smily77/CatFind/Situations_Dokumentationen/Katze hat gekotet/20261016_211953_00.jpg

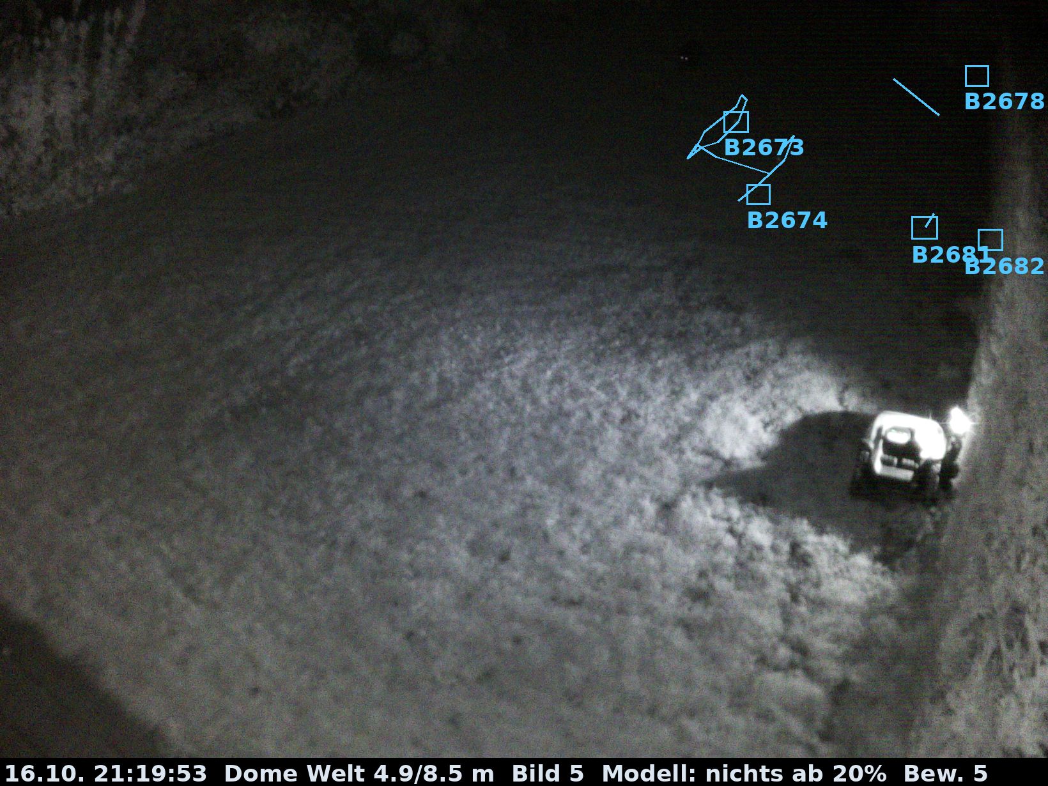
Situations_Dokumentationen/Katze hat gekotet/20261016_211953_00.jpg
