smily77/CatFind/GesamtKonzeptCatFinder.md

# GesamtKonzept CatFinder

CatFinder ist ein System aus mehreren einzelnen Geräten. Der primäre Zweck besteht darin, eine Katze auf dem Rasen zu detektieren und zu lokalisieren. Um zu verhindern, dass sie auf den Rasen kotet, kann ein Aktor einen Wasserstrahl in ihre Richtung senden.

Das System besteht aus mehreren Komponenten und wird stetig erweitert. Bisher handelt es sich dabei um Funktionseinheiten, die eine oder mehrere Funktionen übernehmen und lokal von einem ESP32 gesteuert werden. Die ESP32 werden per OTA mit Arduino programmiert.

## Arduino-Programmarchitektur

### Global

Globale Variablen, Typdefinitionen sowie Prozeduren, die von allen Programmen verwendet werden, befinden sich in `xComDef.h` und `xComProc.h`. Diese Dateien sind Teil des Controller/Managers und werden in allen Programmen eingebunden. Sie sind per Symlink in der Arduino-Library-Sektion verfügbar. So können sie im Manager bearbeitet werden und stehen gleichzeitig allen Programmen zur Verfügung.

### Support

Alle Programme definieren die Hardware und Konstanten in `hwDef.h`. Initialisierungsprozeduren, Hardwareprozeduren und Support-Prozeduren befinden sich in `hwProc.ino`. Spezialprozeduren, zum Beispiel für Erkennung oder Mapping, werden ebenfalls als separate `.ino`-Dateien eingebunden.

### Betriebsprogramme

Die Haupt- bzw. Betriebsprogramme können dadurch möglichst schlank gehalten werden. Dort werden im Wesentlichen Aktionen ausgelöst und es wird auf Ereignisse oder empfangene Nachrichten reagiert.

### Kommunikation

Alle Programme sind OTA-fähig und binden `Credentials.h` für die WiFi-Informationen ein. Die Kommunikation erfolgt über UDP, hauptsächlich per Broadcast oder Unicast sowie per Text-Multicast für Debug-Ausgaben.

In `xComDef`, in `stationDefinitions device`, sind alle Geräte definiert, die im System vorkommen können. Die IP-Adresse bzw. deren letztes Byte wird dort entweder vordefiniert oder vom Gerät eingetragen, sobald es das erste Mal sendet. Wie gesendet wird und welche Bedeutung die gesendeten Inhalte haben, wird ebenfalls in `xComDef` festgelegt. Das gilt auch für die Variablen, die alle Geräte verwenden.

## Gerätearten

Bisher gibt es folgende Gerätearten:

### Aktoren

Aktoren können einen Wasserstrahl ausrichten sowie ein- und ausschalten. Häufig verfügen sie über LED-Pixel als Indikatoren, Knöpfe usw. An ihrem Drehturm können meist Sensoren, zum Beispiel Lidar, US-Meter oder IR-Detektoren, sowie Ziellaser oder andere Indikatoren befestigt werden. Damit können Aktoren auch selbst als Sensoren arbeiten oder die Zielinformation überprüfen.

### Sensoren

Die meisten Sensoren sind Distanz- und Bewegungssensoren, zum Beispiel Lidar oder Radar. Sie können etwa eine Katze detektieren oder etwas messen und bei einer Detektion eine Broadcast-Meldung senden. Weitere Sensoren, zum Beispiel für Regen, sind ebenfalls denkbar.

### Displays

Weiter gibt es Displays, teilweise mit Bedienelementen oder On/Off-Schaltern, um zum Beispiel das System scharf zu schalten.

### Spezialgeräte

Es gibt auch einfache Geräte, zum Beispiel einen Laser-Marker oder einen Simulator. Eine spezielle Rolle nimmt der Controller/Manager ein. Eigentlich ist er nicht zwingend notwendig, da das ganze Gerätenetzwerk ohne zentrale Steuerung auskommt. Der Manager hilft bei der Programmentwicklung, insbesondere bei globalen Elementen, und könnte in Zukunft als Informationsressourcenspeicher genutzt werden. Im Moment läuft der normale Betrieb ohne ihn.

## Ausrichtung und Orientierung

Gegenwärtig werden im System kartesische und Polarkoordinaten gleichzeitig und redundant verwendet. Der Kreis im Polarsystem hat 4096 Ticks, weil auch die seriellen Servos mit 4096 arbeiten. Diese Koordinatensysteme sind immer auf die jeweilige Quelle bezogen. Damit der Aktor mit diesen Koordinaten arbeiten kann, muss der Sensor fix mit ihm verbunden sein; die Tower-Achse wird damit quasi als Ursprung verwendet.

## Aufgabe: Globales Koordinatensystem ermöglichen

Das System soll die Möglichkeit erhalten, mit einem globalen Koordinatensystem zu arbeiten und den Einsatz mehrerer Aktoren zu erlauben. Wenn Aktoren nicht mit einem globalen Koordinatensystem arbeiten, verwenden sie ein relatives lokales Koordinatensystem. Das heisst, die Koordinaten stimmen für Sensoren, die normalerweise fest mit dem jeweiligen Aktor verbunden sind und damit eine eigene Koordinatensystemgruppe bilden.

Die Skizze des Gesamtzusammenhangs sieht wie folgt aus: Sensoren und Aktoren verfügen über Prozeduren, die es ihnen erlauben, ihre Position bezüglich eines globalen Koordinatensystems festzustellen. Das ist Gegenstand einer späteren Aufgabe und wird in dieser Aufgabe nicht realisiert.

Der normale Startablauf für Aktoren und Sensoren ist dann folgender:

1. Globale Positionskoordinaten und Ausrichtung aus dem nichtflüchtigen Speicher auslesen.
2. Quickcheck, ob die Pose stimmt. Wenn nicht, wird die Pose neu bestimmt.

Für Sensoren und Aktoren gilt dann: Bei Detektionsereignissen und Messungen werden die relativen Koordinaten, polar und kartesisch, übermittelt. Falls eine gültige Positionsbestimmung vorliegt, werden zusätzlich die globalen Koordinaten übermittelt. Globale Koordinaten sind immer kartesisch.

Wenn ein Aktor ein Detektionsereignis empfängt, prüft er, ob globale Koordinaten übermittelt wurden und ob er selbst eine gültige Lokalisationsbestimmung hat. Wenn beides erfüllt ist, verwendet er die globalen Koordinaten und prozessiert sie entsprechend. Falls nicht, prüft er, ob die relativen Koordinaten aus derselben relativen Koordinatengruppe stammen, zu der auch er gehört. Wenn dies der Fall ist, verwendet er diese Koordinaten und prozessiert sie. Falls weder das eine noch das andere zutrifft, ignoriert er die Meldung.

Ein Spezialfall sind Displays und Anzeigen. Diese sind entweder auf eine relative Koordinatengruppe eingestellt und prozessieren diese, oder sie sind auf globale Koordinaten eingestellt. Wenn sie in diesem Fall eine Meldung erhalten, die nur relative Koordinaten enthält, und sie darauf reagieren müssten, prüfen sie, ob ein Mitglied der relativen Koordinatengruppe eine valide Positionsbestimmung hat. Falls ja, fragen sie diese an und rechnen die Koordinaten um.

Das ist die grobe Skizze des Gesamtzusammenhangs. In dieser Aufgabe ist es nicht Gegenstand, die spezifischen funktionalen Prozeduren zu erzeugen; das erfolgt später in eigenen Aufgaben. In dieser Aufgabe sollen die Datenstruktur und die Common-Prozeduren des Systems in Version 6_3 erweitert werden, um dies zu ermöglichen.

### Konkret

1. Jedes Gerät des Systems soll über Variablen für die globalen Koordinaten und seine Ausrichtung sowie über ein Flag `validWorldPose` verfügen. Nach dem Booten ist `validWorldPose = false`. Auch wenn vermutlich nur Sensoren und Aktoren diese Information verwenden, sollen alle Geräte sie haben, damit mit globalen Prozeduren gearbeitet werden kann.

2. Die Datenstruktur `stationDefinitions device` in `xComDef`, die im Wesentlichen das Geräteverzeichnis darstellt, soll um einen Eintrag für die relative Koordinatengruppe erweitert werden. Zurzeit gibt es eine Gruppe für den Aktor PA2, zu dem der Aktor, der CompactDome und LD06 gehören, und eine Gruppe für `Actor1_1` mit dem MiniDome. Alle übrigen Geräte gehören zurzeit keiner relativen Koordinatengruppe an.

3. Die Struktur bzw. Payload soll so erweitert werden, dass neben den relativen Koordinaten auch die World-Koordinaten übermittelt werden. Wenn der Sensor keine valide Pose hat, werden sie als 0,0 übermittelt.

4. Die Kommunikationsstruktur soll zur Abfrage erweitert werden, ob `validWorldPose` vorliegt, sowie zur Abfrage der lokalen Koordinaten, falls `validWorldPose` vorliegt.

5. Die globalen Prozeduren in `xComProc` sollen um die Umrechnung von lokalen Koordinaten in Weltkoordinaten und umgekehrt erweitert werden.

6. Die globalen Prozeduren in `xComProc` sollen um Prozeduren zum Speichern und Lesen der Ist-Pose im nichtflüchtigen Speicher erweitert werden.

### Umsetzung, konkretisiert — Stand 6_3

Diese Aufgabe wurde in den gemeinsamen Dateien `xComDef6_3.h` und `xComProc6_3.h` umgesetzt. Die folgenden Festlegungen gelten als Teil der Aufgabe bzw. Dokumentation:

- **Einheiten:** Weltkoordinaten sind immer kartesisch in **mm** (`int32`, konsistent mit `posPayload.x/y`). Die Ausrichtung (`heading`) wird in **PA-Einheiten 0..4096** angegeben, konsistent mit `angle`. `0` bedeutet: Die lokalen Achsen sind welt-ausgerichtet.
- **Zu 1) Pose-Variablen pro Gerät:** `struct worldPose { int32 worldX; int32 worldY; float heading; bool validWorldPose; }` mit globaler Instanz `worldPose myPose` in `xComDef6_3.h`. Damit besitzt jedes Programm die Variablen. `validWorldPose` ist nach dem Booten immer `false`.
- **Zu 2) Relative Koordinatengruppe:** `stationDefinitions` erhält das Feld `byte group`. Defines: `groupNone(0)`, `groupPA2(1)` = {PA2i, CompactDome, LD06}, `groupPA1_1(2)` = {PA1_1, MiniDome}. Alle übrigen Geräte = `groupNone`.
- **Zu 3) Payload-Erweiterung:** `posPayload` erhält `int32 worldX`, `int32 worldY` und ein explizites Flag `uint8 worldValid` (1 = Weltkoordinaten gültig; 0,0 wäre sonst nicht vom Ursprung unterscheidbar). Die Grösse steigt von 25 auf 34 Bytes. Dadurch müssen alle 6_3-Geräte gemeinsam neu geflasht werden.
- **Zu 4) Kommunikationsstruktur:** neue msgCodes `poseRequest(6)` (ohne Payload — „melde deine Welt-Pose“) und `poseReport(7)` mit `worldPosePayload { uint8 validWorldPose; int32 worldX; int32 worldY; float heading; }`. Damit lässt sich abfragen, ob ein Gerät eine `validWorldPose` hat. Der Anfrager kann mit `worldToLocal()` selbst in lokale Koordinaten umrechnen.
- **Zu 5) Transformation:** `localToWorld()` / `worldToLocal()` in `xComProc6_3.h` (2D-Translation + Rotation um `heading`).
- **Zu 6) Persistenz:** `savePose()` / `loadPose()` über NVS (Preferences-Namespace `"pose"`). `loadPose()` lädt nur Koordinaten und Ausrichtung; `validWorldPose` bleibt nach dem Booten `false` (Quickcheck bestätigt später).

Bewusst **nicht** Teil dieser Aufgabe, sondern eigene Folgeaufgaben: tatsächliche Positionsbestimmung bzw. Quickcheck, das Füllen von `worldX/worldY` durch weltfähige Sensoren, die Empfangs-/Feuerlogik der Aktoren und die Display-Sonderfall-Logik.

## Aufgabe: No-Shot-Karte über den Manager verteilen

Das System braucht eine **Schusszonen-Karte**, im Sprachgebrauch weiter **No-Shot-Karte** genannt. Die Karte beschreibt als geschlossene Weltfläche den **erlaubten Bereich**, also den Rasen. Dieser ist bewusst etwas **enger** gefasst als der reale Rasen, weil teilweise Bewuchs über den Rand ragt. Es gilt: **Innerhalb** der Karte ist Feuern erlaubt, **ausserhalb** ist No-Shot.

Die Karte wird zentral auf dem **Controller/Manager** gehalten und von dort an die Sensoren bzw. weltfähigen Geräte verteilt, damit diese die In/Out-Entscheidung autonom und feuerschnell treffen können. Bereits getroffene Architekturentscheidungen:

- **Format:** Polygon als **CSV in Welt-mm** (ganzzahlig, konsistent mit `worldX/worldY`), Kommentar-Header mit Versions-/CRC-Kennung; mehrere Teilflächen oder Löcher werden durch Leerzeilen getrennt. Begründung sowie Laufzeit-/Point-in-Polygon-Überlegungen siehe Projektnotiz `no-shot-map-format`.
- **Ablage:** auf Manager und Sensor jeweils im **LittleFS** (nicht SPIFFS). Auf den Manager kommt die Karte per OTA-Filesystem-Upload; der Sensor lädt sie vom Manager.
- **Abgrenzung:** Die VPS-Lokalisierungskarte (`Map/*.csv`) ist eine andere Karte und kein Teil dieser Aufgabe. Der VPS zieht sie direkt aus dem Repo.

### Konkret

1. **Manager:** No-Shot-CSV im LittleFS ablegen und pflegen (Upload per OTA-Filesystem-Image). Versions-/CRC-Kennung aus dem Header bereitstellen.

2. **xComDef erweitern:** neue msgCodes und Payload-Structs für die Kartenabfrage und -übertragung, zum Beispiel `mapRequest` mit Kartentyp, `mapInfo` mit Typ/Version/CRC/Gesamtlänge/Chunk-Anzahl sowie `mapChunk` mit Chunk-Index und Daten. Ein Kartentyp-Enum ist vorzusehen, zunächst `mapNoShot`, damit später weitere Kartentypen möglich sind.

3. **xComProc erweitern:** gemeinsame Prozeduren für die Senderseite, also Karte aus LittleFS lesen und gechunkt versenden, sowie für die Empfängerseite, also Karte anfordern, Chunks sammeln, CRC/Version prüfen und in das eigene LittleFS schreiben. So kann jedes weltfähige Gerät die Karte generisch vom Manager beziehen.

4. **Sensor-Seite (Abfrage):** Beim Booten oder bei abweichender Version fordert der Sensor die No-Shot-Karte vom Manager an und cached sie lokal im LittleFS. Die Version wird per Quickcheck gegen den Manager geprüft.

5. **Transport (entschieden):** über das bestehende **UDP-xCom-Protokoll**, gechunkt und stilkonsistent über die neuen msgCodes in Punkt 2/3. Es wird kein separater HTTP-Server verwendet.

6. **Nicht Teil dieser Aufgabe** (Folgeaufgaben): der eigentliche Point-in-Polygon-Test (In/Out) und die daraus folgende Feuer-/Melde-Konsequenz im Sensor/Aktor (siehe Projektnotiz `no-shot-map-format`).

## Aufgabe: Sensor mit absoluten Koordinaten hinzufügen

Ein Lidar-Sensor soll als neuer Sensor mit Weltkoordinaten zum Projekt CatFinder hinzugefügt werden. Sensor und Teile des Konzepts sind aus `C:\Users\stefan\Documents\Arduino\Lidar_C1_Prog` und `C:\Users\stefan\Documents\Arduino\Lidar_C1_Prog\Position_estimate` bekannt. Der Ablauf, also wer den Prozess startet und wo er läuft, ist jedoch unterschiedlich.

### Grobkonzept

Der Sensor soll seine eigene Position mithilfe geeigneter Programme ermitteln, die in Python auf einem VPS-Server laufen. Das Verfahren entspricht demjenigen bei `PositionEstimate`. Die IP des VPS wird durch Einbindung von `Credentials.h` in der Form `IPAddress ipVPS(xxx.xxx.xxx.xxx);` bereitgestellt.

Alles, was auf dem VPS-Server läuft, soll in Docker laufen, damit der Container im Repository gespeichert und auf andere Maschinen portiert werden kann. Die Datei `RasenKarte.csv` im Verzeichnis `Map` muss bzw. kann vom VPS aus dem CatFinder-Repository (`https://github.com/smily77/CatFind`) geladen werden. Das soll sicherstellen, dass bei Änderungen nichts am VPS gemacht werden muss.

Der Ablauf ist folgender:

1. Beim Booten des Sensors Positions- und Ausrichtungsdaten aus dem NVS lesen.
2. Mit dem VPS prüfen, ob die Daten plausibel sind.
3. Wenn nicht, mit dem VPS die wahrscheinlichste Position und Ausrichtung auf dem Rasen bestimmen.
4. `validWorldPose` setzen.
5. Wenn `validWorldPose` gesetzt ist, die No-Shot-Karte aus dem Speicher lesen und validieren.
6. Wenn keine aktuelle No-Shot-Karte vorhanden ist, eine neue Karte vom Manager lesen.
7. Wenn der Manager nicht verfügbar ist, die alte No-Shot-Karte verwenden.
8. Wenn die Position klar ist, mit der Überwachung beginnen.
9. Bei jedem Treffer mit der No-Shot-Karte prüfen, ob der Treffer im schiessbaren Bereich liegt. Wenn ja, `catObserved` broadcasten.

Weiteres:

- Die Status-Pixel, 2 Stück bei `Lidar_C1`, sollen Auskunft über den Initialisierungsstatus geben und leuchten, wenn eine Detektion im schiessbaren Bereich erfolgt ist, ähnlich wie bisher.
- OTA und alle anderen CatFinder-Konzepte gelten natürlich ebenfalls.
- Nach Abschluss der Initialisierung wird ein sehr knapper Text-Multicast über den Status gesendet.

### Festlegungen, Umsetzung

- **Gerät:** neuer Sketch `C1Lidar6_3_0` (Ordner `CF_LidarC1/`), RPLidar C1 (Serial1, 460800), 2× WS2812. Device-DB-Eintrag `LidarC1` (ID 17), Typ `Lidar`, **DHCP** (keine feste IP nötig; IP wird per HB gelernt), `group = groupNone` (weltfähig, keine relative Gruppe). Flash per **OTA**.
- **Sensor↔VPS:** **HTTP-POST** vom Sensor an den VPS (`ipVPS` aus `Credentials.h` als `IPAddress ipVPS(xxx,xxx,xxx,xxx);`), Body = 360-Bin-Scan (mm), Antwort = Pose-JSON (`x_mm,y_mm,heading_deg,mirror,confidence,inlier_ratio`). Ausgehend → kein NAT-Port. **Offener Endpoint, kein Token.**
- **VPS:** Docker-Container `VPS/localizer/` im Repo (HTTP-Dienst, portiert aus `lidar_localize.py`), lädt `Map/RasenKarte.csv` aus dem GitHub-Repo (raw) beim Start bzw. periodisch. Kartenänderungen erfordern keinen VPS-Eingriff.
- **Scan-Quelle für die Lokalisierung:** der nach 20 s gelernte 360-Bin-Hintergrund (ortsunabhängig; **keine Wand/Nische mehr nötig**). Wand- und Landmark-Modell der alten Firmware entfallen; der Perimeter-/Hintergrund-Detektor bleibt und arbeitet rundum.
- **Plausibilitätsprüfung:** Die NVS-Pose wird gegen die globale VPS-Pose verglichen. Wenn sie übereinstimmen (Toleranz) und die Konfidenz hoch ist, wird `validWorldPose=true` gesetzt und die NVS-Pose behalten. Andernfalls wird die VPS-Pose übernommen und im NVS gespeichert.
- **No-Shot/Point-in-Polygon:** generischer Loader + In/Out-Test (innerhalb = schiessbar) als gemeinsame Prozedur in `xComProc6_3.h`; Karte aus LittleFS, sonst per `requestMap` vom Manager (Bausteine bereits vorhanden), sonst alte Karte.
- **catObserved:** bei Treffer im schiessbaren Bereich Broadcast mit relativen Koordinaten (x/y, radius/angle) **und** Weltkoordinaten (`worldX/worldY`, `worldValid=1`).
- **Status:** Pixel zeigen Init-Phasen (WiFi/Kalibrierung/Lokalisierung/Karte) und leuchten bei Detektion im schiessbaren Bereich; nach Init ein knapper Text-Multicast (`sendUdpTextln`, Port 8300).

## Aufgabe: Treffervisualisierung

### Grobkonzept

Der VPS stellt einen Webserver bereit, auf dem die `catObserved`-Events angezeigt werden können. Die Informationen dafür sendet der Master an den VPS. Zu beachten ist: Lokal läuft das CatFinder-Netzwerk auch dann weiter, wenn der Master nicht zur Verfügung steht. Ausnahme ist das Laden der No-Shot-Karte.

Anzeige des VPS-Webservers:

1. Ein Fenster zeigt die letzten Systemereignisse scrollend an. Es geht dabei nicht um Funktionen wie `catObserved`, sondern um Statusinformationen, zum Beispiel aus der Initialisierung, die als Debug-Text gebroadcastet werden. Dieses kleine Fenster ist immer auf dem Bildschirm sichtbar.
2. Eine kleine Anzeige zeigt, welche Geräte in den letzten 1–3 Minuten einen HB gesendet haben. Diese Anzeige bleibt ebenfalls immer auf dem Bildschirm sichtbar.
3. Die folgenden Anzeigen können umgeschaltet werden:
   - **3a. Ereignisliste:** Eine scrollbare Liste mit allen `catObserved`-Events, zusammengefasst auf maximal einen Eintrag pro Minute. Der Eintrag enthält die Zeit und die Sensoren, die das Ereignis gemeldet haben. Die ID-Nummer des Sensors genügt.
   - **3b. Weltkarte:** Karte mit World-Koordinaten (`RasenKarte`), auf der alle `catObserved` eingetragen werden. Jeder Sensor erhält eine andere Farbe. Radarsensoren können bis zu 3 Ziele verfolgen; diese sollten ebenfalls eigene Farben erhalten. Die Karte hat einen Reset-Button. Alle `catObserved` werden kumuliert, bis der Reset-Button gedrückt wird.
   - **3c. Relative Karte Gruppe 1:** Karte wie 3b, aber in relativen Koordinaten der Koordinatengruppe 1.
   - **3d. Relative Karte Gruppe 2:** Karte wie 3b, aber in relativen Koordinaten der Koordinatengruppe 2.
   - **3e. Relative Karte Gruppe 3:** Karte wie 3b, aber in relativen Koordinaten der Koordinatengruppe 3. Diese Gruppe gibt es noch nicht, wird es aber noch geben.

Der Bildschirm zeigt die Debug-Meldungen und die HB-Liste immer an. Die Ereignisliste bzw. die Karten aus 3a–3e können durchgeschaltet werden.

### Festlegungen, Umsetzung

- **Master als Gateway:** Der Manager lauscht ohnehin auf Multicast (catObserved, HB) und Text-Multicast (Debug, Port 8300). Er puffert diese Daten und schickt sie **gebündelt per HTTP-POST** an den VPS (`ipVPS:80/ingest`, ca. alle 1,5 s; Burst-Schutz mit Begrenzung pro Push). Fällt der Master aus, läuft das lokale Netz weiter; nur die Visualisierung pausiert. Pro Event überträgt der Master `sender, sensor, worldX/Y/valid, x/y` **und** `group` (= `device[sender].group`). Damit kann der VPS Weltkarten (3b) und relative Karten (3c–3e) zeichnen. Den Zeitstempel setzt der VPS beim Empfang; der Master braucht keine NTP-Zeit.
- **VPS-Webserver:** zweiter Docker-Container `VPS/dashboard/` auf **Port 80** (extern erreichbar als `http://<VPS-IP>/`). Single-Page-UI mit Debug-Fenster und HB-Liste immer sichtbar; umschaltbar zwischen Liste 3a, Weltkarte 3b und Gruppenkarten 3c–3e; Reset-Button. Der State liegt im RAM. Events kumulieren bis zum Reset und gehen bei Container-Neustart verloren. Die Weltkarte nutzt `Map/RasenKarte.csv` aus dem GitHub-Repo.
- **Farben:** je `(sender, sensor)`-Kombination eine eigene Farbe. Radar bis zu 3 Ziele → 3 Farben.
- **Liste 3a:** `catObserved` werden pro Minute zu einem Eintrag zusammengefasst (Zeit + beteiligte Sensor-IDs).
- **Master-Flash:** über COM6 (USB).

## Aufgabe: Welt-Pose eines Sensors per Co-Observation kalibrieren (Radar)

### Grobkonzept

Sensoren mit 360°- oder beweglichem Lidar können ihre Welt-Pose selbst bestimmen (VPS-Lokalisierung), Radar-Sensoren nicht. Ein Radar oder allgemein ein nicht selbst lokalisierender Sensor soll seine Welt-Pose dadurch erhalten, dass er **gleichzeitig mit einem welt-posierten Lidar dieselbe laufende Person beobachtet**. Aus den beiden Beobachtungsbahnen wird die starre Transformation vom Radar-Frame in die Welt geschätzt: Translation + Heading + Drehsinn = eine `worldPose`. Das ist klassische Extrinsik-Kalibrierung über ein gemeinsames bewegtes Ziel (Trajektorien-Registrierung).

### Prinzip

Ein Lidar mit gültiger Welt-Pose liefert die Bahn in Weltkoordinaten `p_welt`, das Radar dieselbe Bahn im Eigenframe `p_radar`. Gesucht ist:

```text
p_welt = R(heading)·(mirror·p_radar) + (tx,ty)
```

Mit genügend korrespondierenden Punktepaaren ist dies per Least-Squares-Registrierung (Umeyama/Kabsch) + RANSAC lösbar.

### Ablauf, knopfgesteuert im Radar-Sketch

1. Voraussetzung: Ein Lidar mit gültiger Welt-Pose broadcastet `catObserved` mit `worldValid=1`; das Radar läuft.
2. Knopfdruck am Radar → Kalibriermodus für ca. 30–60 s; der Status-Pixel zeigt dies an.
3. Das Radar sammelt parallel:
   - eigene Detektionen (Relativ-`x/y`, in Reihenfolge),
   - die `catObserved` des Lidars vom Bus (Welt-`x/y`).
4. Eine Person läuft eine **kurvige** Bahn im gemeinsamen Sichtfeld.
5. Das Radar sendet beide Punktzüge an den VPS (neuer Endpunkt, z.B. `/calibrate`).
6. Der VPS führt Trajektorien-Registrierung (ICP-artig) + RANSAC + Umeyama durch und liefert `tx, ty, heading, mirror, confidence`.
7. Das Radar übernimmt die Pose mit Quality-Gate, wie beim Lidar: `savePose`, `validWorldPose=true`, kurzer Status-Multicast. Danach füllt das Radar bei eigenen Detektionen auch `worldX/worldY` (`worldValid=1`).

### Festlegungen / wichtige Punkte

- **Korrespondenz über die Bahnform, nicht über die Zeit:** Der Header-`timeStamp` ist `time_t` in **Sekunden** und damit bei Gehtempo zu grob für eine zeitliche Zuordnung. Daher wird Trajektorien-Matching verwendet, also das Ausrichten geordneter Punktzüge als Kurven. Eine mögliche spätere Verbesserung wäre ein Millisekunden-Feld. Das ist vermeidbar, wenn Trajektorien-Matching genügt; es braucht dann keinen Eingriff ins Wire-Format.
- **Eindeutigkeit kommt vom Laufweg:** Eine gerade Linie ist mehrdeutig, insbesondere bezüglich Translation entlang der Linie. Eine 2-D-strukturierte Bahn, zum Beispiel Kurve/L/Acht, ist nötig. Beinbreite und Messrauschen helfen dabei **nicht**; sie mitteln sich nur weg.
- **Wiederverwendung:** `posPayload` trägt bereits beides: Radar = Relativ-`x/y`, Lidar = Welt-`x/y` mit `worldValid`. Es braucht keine neue Datenstruktur. `worldPose`/`savePose`/`loadPose` (mirror-fähig), Quality-Gate, VPS-Muster, OTA, Status-Text und Knopf/`commandMsg` sind vorhanden.
- **Voraussetzungen/Grenzen:** überlappendes Sichtfeld, **eine** Person, gute Lidar-Pose (Garbage-in → Garbage-out) und genügend Punkte. Der VPS liefert eine Konfidenz; das Gate verhindert eine schlechte Pose.
- **Generalisierung:** nicht radar-spezifisch. Jeder nicht selbst lokalisierende Sensor kann über jeden welt-posierten Sensor kalibriert werden. Die Sammel-/Sende-/Übernahme-Logik gehört daher als gemeinsame Prozedur in `xComProc`, zum Beispiel `coObserveCalibrate(...)`. Der VPS-Endpunkt wird einmal umgesetzt und kann von Radar sowie von künftigen Aktoren mit Turm-Sensor usw. genutzt werden.
- **Offene Detailfragen vor Umsetzung:** VPS-Endpunkt-/Datenformat; Mindest-Bahnlänge/Konfidenzschwelle; Ziel-Assoziation, wenn das Radar bis zu 3 Targets liefert (RANSAC wählt die zur Lidar-Bahn passende Spur); ob die Lösung rein 2-D bleibt (`mirror` als ±1 wie beim Lidar).

### Umsetzung, konkretisiert — Stand 6_3

Umgesetzt in den gemeinsamen Dateien (`xComDef6_3.h`/`xComProc6_3.h`), im VPS-Localizer
(`VPS/localizer/`) und im Radar-Sketch (`Radar_HKL/Radar6_3_0`). Die Sammel-/Sende-/
Übernahme-Logik ist **generisch** (nicht radar-spezifisch) und steht jedem nicht selbst-
lokalisierenden Sensor zur Verfügung.

- **Auslösung — Knopf UND Auto UND Health-Check (entschieden):**
  - *Knopf/`commandMsg`:* neuer `cmdCalibrate(18)` (`info` = Fensterdauer in ms, 0 = Default
    45 s). Damit kann ein Button-/Display-Gerät das Fenster starten.
  - *Auto:* Hat das Gerät **keine** valide Pose und liegt anhaltend (≥ `AUTO_ARM_MS`)
    Co-Observation an — eigenes Target **und** welt-valide `catObserved` gleichzeitig —,
    startet das Fenster selbsttätig. Das Quality-Gate verhindert eine schlechte Pose.
  - *Health-Check/Re-Validierung:* Bei vorhandener Pose wird jede co-beobachtete Lidar-
    Welt-Detektion gegen die eigene (per `localToWorld` transformierte) Detektion geprüft
    (`coObserveCheck`). Anhaltendes Welt-Residuum > Gate ⇒ `validWorldPose=false` (danach
    greift der Auto-Trigger erneut).
- **Gegen alle Welt-Quellen — je Sender getrennt (entschieden):** Das Radar taggt die
  gesammelten Welt-Punkte mit der **Sender-ID** und sammelt pro Quelle einen eigenen
  Punktzug (`coCalState`, bis zu `CO_MAX_WORLD_SRC` Quellen, je `CO_MAX_WORLD_PTS`). Der VPS
  probiert **jede (Eigen-Spur × Welt-Quelle)-Kombination** durch und liefert die beste; so
  wird „gegen alle welt-validen Sensoren" erfüllt, ohne die „eine kohärente Bahn"-Bedingung
  je Kandidat zu verletzen. Die gewinnende Quelle steht als `source` in der Antwort.
- **Kein neues Wire-Format:** `posPayload` trägt Relativ- **und** Welt-Koordinaten samt
  `worldValid` bereits; die Trajektorien gehen per HTTP an den VPS, nicht über xCom.
- **VPS-Endpunkt `/calibrate` (einmal, von allen nutzbar):** Body
  `{radar_tracks:[[[x,y]…]…], world_tracks:[{id,pts:[[x,y]…]}…]}` (Eigen mm relativ,
  Welt mm). Registrierung = **ICP mit reihenfolge-erhaltender DTW-Korrespondenz** +
  Umeyama/Kabsch über `mirror=±1`; Antwort `tx_mm,ty_mm,heading_deg,mirror,confidence,
  inlier_ratio,source`. Die Reihenfolge-Korrespondenz (statt Nearest-Neighbour) löst die
  Drehsinn-Mehrdeutigkeit; eine **gerade Linie** bleibt mehrdeutig und wird per
  Linearitäts-Check nie `HOCH`.
- **Übernahme mit Quality-Gate:** `coCalibFinish` übernimmt die Pose nur bei `confidence==HOCH`
  **und** `inlier_ratio ≥ CALIB_MIN_INLIER`, dann `savePose` + `validWorldPose=true` + kurzer
  Status-Multicast. Danach füllt das Gerät bei eigenen Detektionen `worldX/worldY`
  (`worldValid=1`) via `fillWorld`/`localToWorld`.
- **Boot vertraut der NVS-Pose (Radar-Ausnahme zur „false nach Boot"-Regel):** Da das Radar
  sich nicht selbst lokalisieren kann, aber im Normalfall nicht bewegt wird, setzt es beim Boot
  bei vorhandener gespeicherter Pose direkt `validWorldPose=true` (statt jedes Mal neu zu
  kalibrieren). Der Health-Check ist sein „Quickcheck": ein mitbeobachtender welt-posierter
  Sensor verwirft eine inzwischen falsche Pose; danach greift der Auto-Trigger. Erkannt wird
  Drift im Bereich zwischen Gate (~0,6 m) und Assoziationsgrenze (~1,5 m) — größere Abweichungen
  gelten als „anderes Ziel" und brauchen eine manuelle Neukalibrierung per Knopf.
- **Gemeinsame Prozeduren in `xComProc6_3.h`:** `coCalState`, `coCalibBegin/FeedLocal/
  FeedWorld/Elapsed/Finish`, `vpsCalibrate` (unter `USE_VPS_CALIBRATE`), `fillWorld`,
  `coHealth`/`coObserveCheck`.
- **Radar-Sketch:** verarbeitet jetzt empfangene Nachrichten (vorher nur Senden) — `catObserved`
  vom Bus (Sammeln/Health-Check) und `commandMsg`. Build/Flash: **`esp32:esp32:pico32`** (M5Stack
  Pico), per OTA.
- **Knopf als eigenes Gerät:** Da das Radar selbst keinen Knopf hat, übernimmt ein kleines
  Touch-Remote die Bedienung per `commandMsg` (Unicast): `Displays/radarCalibrationButton/` auf
  CYD35 (basiert auf `Udisp6_3_0`), mit **zwei Touch-Buttons** — „KALIBRIEREN" (`cmdCalibrate`)
  und „POSE LÖSCHEN" (`cmdClearPose`, verwirft die gespeicherte Pose → erzwingt Neukalibrierung,
  nötig wenn das Radar bewegt wurde). Es zeigt die Status-Multicasts des Radars an. Siehe
  Dokumentation_6_3.md Kap. 5.11.

Bewusst **nicht** umgesetzt / als Grenzen dokumentiert: Die DTW-Registrierung erzwingt Matching
der Bahn-Endpunkte — stark versetzte Start-/Endzeitpunkte der beiden Sensoren verschlechtern den
Fit an den Rändern; eine gemeinsam und vollständig beobachtete, kurvige Bahn bleibt nötig. Die
Health-Check-Assoziation ist best-effort (Distanz-Gate gegen „anderes Ziel").

## Aufgabe: Einstellung und Steuerung der CatFinder Elemente

### Grobkonzept
Alle Sensoren, Aktoren und zum Teil weitere Elemente führen aut. Aufgaben aus, senden einen HB oder führen Funktionen aus. Viele davon haben LED Pixel oder Anzeigen um ein visuelles Feedback zu geben. Diese Anzeigen sollen eigestellt werden können, so wie ebenso gewisse automatische Aufgaben (z.B. automatische Kalibration eines Radarsensors) und Funktion sollen ausgelöst werden können wie z.B. die Kalibration eines Radarsensors. Die Einstellungen sollen entweder im nicht flüchtigen Speicher (NVS) abgelegt werden oder einen Default-Wert für den start haben. Die Variablen für die Einstellungen werden in der entsprechenden hwDef.h des Elements (Sensor, Aktor,...) festgelegt. 
Die Bedienung der Einstellungen und Auslösung von Aktionen soll über den Touchscreen eines Displays oder den Webserver des VPS erfolgen. 

### Details - Geräteanzeige

#### Standardanzeige
Im Standardfall haben Elemente 4 Anzeige Ereignisse, die sie mit den LED-Pixel anzeigen (kann variieren je nach Elementtyp):
Anzeige-Ereignisse (Tabelle bezieht sich nur auf die Anzeige)
1. Initialisierung, stand des Boot und Initialisierung Vorganges: Immer eingeschalten
2. HB: Ein/-Ausschaltbar - Zustand im NVS gespeichert
3. CatObserved Ereignis: Ein/-Ausschaltbar - Zustand im NVS gespeichert  
4. Kalibrierung, OTA, usw. :  Immer eingeschalten

Spezialfall Manger:
1. HB Empfangen: Ein/-Ausschaltbar - Zustand im NVS gespeichert
2. CatObserved Empfangen: Ein/-Ausschaltbar - Zustand im NVS gespeichert

#### automatische Aufgaben
1. Automatische Übernahme/Kopieren der WorldPose, wenn ein anders Gerät im selben relativen Koordinatensystem eine gültige WorldPose hat:  Ein/-Ausschaltbar - Zustand im NVS gespeichert

Spezialfall Radar:
1. Automatische Kalibrierung: Ein/-Ausschaltbar - Zustand im NVS gespeichert

SpezialFall Lidar
1. Motor des Lidars ein und ausschalten: ein/ausschaltbar - default (also immer beim Booten) eingeschaltet

#### Auslösbare Funktionalitäten
1. WorldPose von einem anderen Gerät mit gültiger WorldPose im selben relativen Koordinatensystem kopieren

Spezialfall Radar:
1. Kalibrierung durchführen: Kann ausgelöst werden

### Details Steuerung und Anzeige

#### Displays 
Die Funktionen sollen über den Touchscreen der Displays bedient werden können. Auf einer Seite soll das Gerät (Aktive geräte) ausgewählt werden können und dann sollen die anwählbare Dinge dargestellt und bedient werden können. Das ganze muss autoskaliert werden, da nicht alle Displays die selbe Auflösung haben. Kopiere den Display Prototypen vollständig in ein Verzeichnis Bedienung_Einstellungen in dieser Kopie kannst du die nicht benötigten Funktionen des Hauptprogrammes löschen und durch die hierfür notwendigen ersetzen. Wichtig basierend auf dem vollständigen Prototyp - keine abgespeckte version und dass man wie gewohnt vor dem kompilieren das Display über #define auswählen kann

#### VPS - Webpage 
Der Webserver des VPS soll eine zusätzliche Seite (auswählbar wie die unterschiedlichen Karten) erhalten, auf der man alle einstellbaren Funktionen und Aktionen der aktiven Geräte einstellen resp. auslösen kann

### Umsetzung, konkretisiert — Stand 6_3

Umgesetzt in den gemeinsamen Dateien (`xComDef6_3.h`/`xComProc6_3.h`), in den Geräten
Radar/Lidar/Manager, im neuen Touch-Bediendisplay `Displays/Bedienung_Einstellungen/`
und im VPS-Dashboard (`VPS/dashboard/`).

- **Generisches Einstellungs-/Aktions-Modell (entschieden):** Jedes Gerät führt eine
  Bitmaske `mySettings` (`deviceSettings` in `xComDef`): `supported` (welche Settings es
  hat), `values` (aktueller on/off-Zustand) und `actions` (auslösbare Aktionen). WELCHE Bits
  ein Gerät führt, legt seine `hwDef.h` über die Masken `STG_SUPPORTED`/`STG_DEFAULT`/
  `STG_PERSIST`/`STG_ACTIONS` fest — so bleiben die Variablen der Einstellungen wie gefordert
  in der `hwDef.h` des jeweiligen Elements. Setting-Indizes: `stgHbLed`, `stgCatLed`,
  `stgAutoCopyPose`, `stgAutoCalib`, `stgLidarMotor`; Aktionen: `actCopyPose`, `actCalibrate`, `actClearPose`.
- **Persistenz vs. Default:** `initSettings()` (in `xComProc`) lädt die persistierten Bits
  aus dem NVS-Namespace `"devcfg"` und überlagert damit `STG_DEFAULT`; nicht persistierte
  Bits (Lidar-Motor) starten immer auf ihrem Default (an). `saveSettings()` schreibt nur die
  `STG_PERSIST`-Bits.
- **Protokoll:** neue msgCodes `settingsRequest(11)` (ohne Payload — „melde deine
  Einstellungen") und `settingsReport(12)` mit `settingsPayload{supported,values,actions}`.
  Neue cmd-Codes `cmdSetSetting(20)` (`info=(idx<<1)|value`) und `cmdCopyPose(21)`. Die
  Kalibrier-Auslösung nutzt das vorhandene `cmdCalibrate(18)`. Gemeinsame Prozeduren in
  `xComProc`: `handleCommonMsg()` (beantwortet `settingsRequest`/`poseRequest`, führt
  `cmdSetSetting` aus + sendet `settingsReport`), `sendSettingsReport()`, `sendPoseReport()`,
  `copyPoseFromGroup()`.
- **Anzeige-Settings betreffen nur die LED/Anzeige, nicht die Funktion:** HB-/catObserved-
  Anzeige werden per `settingOn(...)` vor dem Setzen der Pixel geprüft (Radar/Lidar/Manager);
  Broadcasts/Detektion laufen unverändert weiter. Beim Manager sind es die EMPFANGS-Anzeigen.
- **Automatik/Aktionen:** Radar prüft `stgAutoCalib` vor dem Auto-Trigger und `stgAutoCopyPose`
  für periodische Gruppen-Pose-Übernahme; Aktion „Kalibrieren" = `cmdCalibrate`, „Pose
  kopieren" = `cmdCopyPose` → `copyPoseFromGroup()`. Lidar: `stgLidarMotor` schaltet den Scan
  (`lidar.stop()`/`startScan()`). „Pose kopieren" (`actCopyPose`) nutzt, dass Geräte derselben
  relativen Koordinatengruppe dieselbe Welt-Pose teilen (poseRequest/poseReport).
- **Display (Touch):** `Displays/Bedienung_Einstellungen/` ist eine **vollständige Kopie des
  Display-Prototyps** (`Udisp6_3_0`) — gleiche Display-Auswahl per `#define`
  (CYD28/CYD35/Sunton7/Sunton5/M5Core2/M5Tab5/Wave7), gleiche LovyanGFX-Profile
  (`dispDevLoGFX.h`) und Bildschirm-Definitionen (`dispDef.h`). Das Karten-/Menü-Betriebs-
  programm wurde entfernt und durch eine **autoskalierte Touch-Bedienung** ersetzt: Seite 1
  Geräteauswahl (Geräte, die `settingsReport` gemeldet haben), Seite 2 die Einstellungen als
  AN/AUS-Schalter und die Aktionen als Buttons. Bedienung per `gfx.getTouch()`, Ziel-IPs aus
  den HBs gelernt. Default-Build **CYD35** (per USB), OTA aktiv.
- **VPS-Webinterface + Rückkanal (entschieden):** Das Dashboard erhält einen Tab
  **„Steuerung"** (umschaltbar wie die Karten), der je aktivem Gerät die Settings-Schalter und
  Aktions-Buttons zeigt. Da der VPS die 192.168.0.x-Geräte **nicht direkt** erreicht, wirkt der
  **Manager als Gateway in beide Richtungen**: er reicht die `settingsReport` per `/ingest`
  an den VPS weiter und **pollt** `GET /commands` (CSV „target,cmd,info"), um vom Webinterface
  angeforderte Kommandos auf den lokalen Bus zu geben (`POST /command`). `target 255` =
  Broadcast `settingsRequest` (alle Geräte melden sich).

## Aufgabe: Katze oder Störung — Ereignis-Validierung

### Grobkonzept
Radar und Lidar-C1 laufen und liefern `catObserved` — aber auch Störungen:
einzelne Zufallsereignisse, Sonneneinstrahlung ins Lidar (haufenweise
Fehlmeldungen auf einmal), Insekten nahe am Sensor, Vegetation im Wind. Bevor
die Feuerlogik (PA) auf Beobachtungen schiesst, braucht es eine Validierung:
**Ist das eine Katze oder eine Störung?**

Randbedingungen:
- Lange warten und viele Treffer zählen geht nicht — eine Katze kann schnell
  sein und ist sonst über den Rasen, bevor das System reagiert.
- Beide Sensoren zwingend verlangen (UND) geht nicht — das Lidar sieht die
  Katze je nach Fellfarbe/Reflektivität nicht.
- Ground Truth ist unsicher — die Wildkamera zeichnet nicht jede Katze auf.

### Prinzip: Spuren bewerten statt Treffer zählen
Eine echte Katze liefert bei ~10 Hz Sensorrate schon in 0,3–0,5 s mehrere
Beobachtungen, die **physikalisch zusammenhängen**: plausible Geschwindigkeit,
plausible Beschleunigung, Netto-Verschiebung über den Rasen. Störungen können
einzelne Ereignisse vortäuschen, aber fast nie eine kohärente Bahn:

| Störung | Signatur | scheitert an |
|---|---|---|
| Einzel-Zufallsereignis | 1 Beobachtung, dann nichts | keine Fortsetzung im Gate |
| Sonne ins Lidar | Burst: viele Bins gleichzeitig, Positionen springen | keine kohärente Bahn |
| Insekten | nur nah am Sensor, 1–2 Bins, erratisch | Nahbereichs-Gate, Winkelausdehnung |
| Vegetation im Wind (Radar) | oszilliert am festen Ort | Netto-Verschiebung ≈ 0 |
| Regen | beide Sensoren rauschen überall gleichzeitig | Sturm-Modus |

### Drei Ebenen

**Ebene 1 — Selbstdiagnose im Sensor („Sturm-Modus"):** Der Sensor erkennt
selbst, wenn er gerade unglaubwürdig ist. Lidar: zu viele markierte Punkte pro
Umdrehung (Gegenstück zu `MIN_DETECT_POINTS`) oder zu weite Winkelstreuung →
ganze Umdrehung verwerfen; mehrere Sturm-Umdrehungen in Folge → Sensor meldet
sich ab (sendet nichts mehr, bis es einige Sekunden ruhig war; optional
Text-Multicast „Lidar degraded"). Radar analog über die Ereignisrate
(Dauerfeuer am selben Fleck = Clutter). Die Fehlmeldungs-**Haufen** der Sonne
sind so gerade das Erkennungsmerkmal.

**Ebene 2 — Track-Bestätigung beim Konsumenten (Feuerlogik im PA):**
Beobachtungen in Welt-Koordinaten werden per Nearest-Neighbor mit Gate
(max. Katzengeschwindigkeit × Δt) zu Tracks assoziiert. Ein Track ist
bestätigt, wenn: ≥ 4 Beobachtungen innerhalb ≤ 1 s, Netto-Verschiebung
≥ 0,4 m, Geschwindigkeit durchgehend 0,1–4 m/s, liefernder Sensor nicht im
Sturm-Modus. Bestätigung nach ~0,5 s; der PA verfolgt danach die aktuelle
Track-Position (nicht die erste Beobachtung) — 0,75 m Katzenweg bei 1,5 m/s
sind verkraftbar.

**Ebene 3 — Fusion als Beschleuniger, nicht als Pflicht:** Kein UND, sondern
gestuft: (a) beide Sensoren sehen dasselbe Objekt (< 0,5 m, < 0,5 s) →
**sofort bestätigt** (~0,2 s); (b) ein Sensor allein → Track-Bestätigung nach
Ebene 2 (~0,5 s); (c) beide Sensoren rauschen gleichzeitig überall → Umwelt
(Regen/Sturm) → systemweiter Feuer-Stopp.

### Ground Truth ohne verlässliche Wildkamera
1. **Langzeitaufnahmen mit dem Simulator** (2. Ausbau, Kap. 5.7 der Doku):
   Nächte ohne Katze = reine Störungs-Bibliothek, Sonnenstunden = Sonnen-
   Signatur. Damit die Schwellwerte (Gate, Burst-Limit, Verschiebung) offline
   tunen und per Replay gegen die Feuerlogik testen.
2. **Kontrollierte Positiv-Daten:** die Kalibrier-Läufe (Person läuft kurvige
   Bahn) sind aufgezeichnete echte Tier-Bahnen; Testläufe mit bekannter
   Katze/Hund liefern weitere.
3. Optional später: **ESP32-CAM als Eigen-Trigger** — schiesst bei bestätigtem
   Track ein Foto der Track-Position; das System verifiziert seine eigenen
   Entscheidungen, statt auf den Zufalls-Trigger der Wildkamera zu hoffen.

### Festlegungen / Reihenfolge der Umsetzung
1. **Sturm-Modus im Lidar** (kleinster Eingriff, grösster Effekt gegen die
   Sonne — Erweiterung der Umdrehungs-Auswertung im C1-Sketch).
2. **Langzeit-Datensammlung** mit dem Simulator (Szenen 1–9, läuft nachts mit).
3. **Track-Bestätigung** als generischer Baustein in `xComProc` (nutzen beide
   PAs); Schwellwerte aus den gesammelten Daten.
4. Optional: Fusion-Schnellpfad (Ebene 3a) + ESP32-CAM.

(Stand 2026-07-02: Strategie festgelegt. Die Umsetzung beginnt — anders als
oben zunächst geplant — mit der **VPS-Modellierung der Katzenerkennung**
(nächste Aufgabe unten): erst das Erkennungsmodell auf dem VPS an echten
Langzeitdaten entwickeln, dann die abgeleiteten Regeln lokal umsetzen.
Sturm-Modus im C1 und Track-Bestätigung in `xComProc` bleiben gültige
Bausteine und folgen danach.)

## Aufgabe: VPS-Modellierung der Katzenerkennung (CatDetected)

### Grobkonzept

Ziel ist die **qualifizierte Aussage `CatDetected`**: das System hat aus den
rohen `catObserved`-Beobachtungen geschlossen, dass es sich tatsächlich um eine
Katze handelt. Die Aktoren sollen künftig auf `CatDetected` reagieren statt auf
rohe `catObserved` (sie prüfen weiterhin selbst No-Shot, Limits, Sicherheit).
Die Live-Entscheidung muss am Ende **lokal im CatFind-Netz** laufen — geplant
auf einem **spezialisierten ESP32** (ein Raspberry Pi nur, wenn es wirklich,
wirklich nicht anders geht — also fast sicher nicht). Der VPS ist **nicht** Teil
der Live-Kette; er ist das **Modellierungs- und Analysewerkzeug**, mit dem das
Erkennungsmodell an echten Daten entwickelt wird, bevor es auf den ESP32 kommt.
(Das Dokument `CatDetectionModelingStrategy.md` war hierfür die Inspiration;
verbindlich sind die Festlegungen in dieser Aufgabe.)

**Erkenntnisse aus den Outdoor-Tests (2026-07, Kalibrierung erfolgreich):**

- Das **Radar** ist der **primäre Katzendetektor**: eine Katze wird mit recht
  hoher Wahrscheinlichkeit erkannt; Störungen kommen vor, sind aber beherrschbar.
- Der **LidarC1** produziert je nach Wetter/Tageszeit extrem viele
  Fehlereignisse und sieht die Katze meist gar nicht — **super zum
  Lokalisieren, wenig nützlich zum Detektieren**. Er darf die Erkennung
  unterstützen, seine Bestätigung darf aber nie Pflicht sein.
- Die **Detektionsgrenzen** helfen bei der Wahrscheinlichkeits-Bewertung:
  beim Radar ist der **Öffnungswinkel eher hart** (Achtung: Bewuchs kann Teile
  verdecken), die **Maximalreichweite dagegen weich** (objektgrössenabhängig).

**Arbeitsweise:** Der VPS zeichnet die `catObserved` über sehr lange Zeit
persistent auf. Auf einer neuen, zoombaren Analyse-Karte geht man in der Zeit
vorwärts/rückwärts, streckt und staucht das Zeitfenster, blendet einzelne
Sensoren ein/aus, beurteilt die Signale und markiert (labelt) sie. Der VPS
markiert die `CatDetected`-Ereignisse nach seinem Modell; wo das Modell
danebenliegt, werden Parameter angepasst oder das Modell ergänzt — so lange,
bis die Trefferwahrscheinlichkeit im Gesamten gut ist. Erst dann wird das
Modell auf dem ESP32 implementiert.

### Konkret / Festlegungen

1. **Erweiterung, kein Umbau:** Alles, was auf dem VPS läuft (Live-Dashboard,
   Karten, Steuerung, Localizer), läuft unverändert weiter. Die Analyse kommt
   als **zusätzlicher Tab** ins bestehende Dashboard (`VPS/dashboard/`).
2. **Persistenz:** Alle eingehenden `catObserved` werden — bei eingeschalteter
   Aufnahme — in eine **SQLite-Datenbank in einem Docker-Volume**
   (`/opt/catfinder/data/`) geschrieben. Die Daten überleben damit
   Container-Neubauten (Modelländerungen!) und liegen **nicht** in GitHub.
   Die Aufnahme hat **Pause/Append**: ein REC-Schalter im UI pausiert die
   Aufzeichnung bzw. setzt sie fort (an dieselbe Datenbank anhängend); der
   Zustand ist persistent. Labels und Modell-Parameter liegen im selben Volume.
3. **Millisekunden-Zeitstempel (Manager-Erweiterung):** Der Manager bündelt
   Events ~1,5 s — ohne Gegenmassnahme bekämen alle Events eines Pushes
   dieselbe Zeit, und Geschwindigkeits-/Bahn-Features wären unmöglich. Der
   Manager schickt deshalb pro Event zusätzlich seine **Empfangszeit
   (`millis()`)**, den **targetSpeed** des Radars sowie pro Push `now_ms` und
   einen **Drop-Zähler** (wie viele Events der Burst-Schutz verworfen hat —
   bei Lidar-Sonnen-Bursts ist gerade die Menge das Erkennungsmerkmal). Der
   VPS rechnet daraus ms-genaue Serverzeiten. Abwärtskompatibel: Events ohne
   `ms` bekommen die Push-Zeit.
4. **Analyse-Tab:** Die Zeitleiste zeigt **genau das gewählte Zeitfenster**
   (Ereignisdichte je Sender, Zeit-Gitter, Aufnahme-Band, Labels, rote
   CatDetected-Punkte): Ziehen = verschieben, Mausrad = strecken/stauchen,
   „Alles" passt die ganze Aufnahme ein. (Der frühere Übersichts-Balken über
   die gesamte Aufnahme mit blauem Fenster-Rahmen wurde nach mehreren Tagen
   Aufnahme unübersichtlich und ist ersetzt.) Darunter eine **Welt-Karte mit
   Pan/Zoom** (RasenKarte als Hintergrund), auf der die Events des Fensters
   erscheinen (Farbe je Sensor/Ziel). Einzelne Sensoren sind
   ein-/ausblendbar; die Erfassungssektoren sind einblendbar („Erfassung");
   „Geräte ⟳" liest die xComDef sofort neu und fragt frische Posen an. **Labeln:** ein
   Zeitbereich (optional auf einen Sensor beschränkt) bekommt ein Label
   (Katze, Einzelereignis, Insekt, Vegetation, Sonne/Lidar, Regen/Sturm,
   Vogel, unbekannt); Labels sind persistent und in der Zeitleiste sichtbar.
5. **Modell auf dem VPS (v2 — Score statt starrer Regeln):** bildet aus den
   Events **Tracks** (Nearest-Neighbor mit Geschwindigkeits-Gate, in
   Welt-Koordinaten; **Track-Stitching** überbrückt kurze Aussetzer, z.B.
   wenn eine sitzende Katze aus dem Radar fällt) und bewertet jeden Track
   mit einem **Score 0–100** („Katzen-Wahrscheinlichkeit", mit
   Aufschlüsselung im UI):
   - **Pflicht** ist eine **kohärente Bewegungsphase** irgendwo im Track
     (sonst wäre oszillierende Vegetation eine „sitzende Katze"); dabei
     zählen **Sensor-Gewichte je Gerätetyp** — die Typen (HLK, Lidar, …)
     liest der VPS **dynamisch aus `xComDef6_3.h`** (GitHub raw, wie die
     RasenKarte): neue Sensoren brauchen keinen VPS-Eingriff, und die
     Gerätedatenbank bleibt die Quelle der Wahrheit. HLK-Radar wiegt hoch,
     Lidar niedrig — Lidar allein bestätigt nie.
   - **Erfassungsgrenzen aus der Gerätedatenbank (geometrisch):** jedes
     Sensor-Gerät trägt in `xComDef6_3.h` seinen **nominellen
     Erfassungsbereich** (`covLeftDeg`/`covRightDeg`/`covRangeMm`; HLK-Radar
     −60°…+60°, 7 m; 360°-Lidar −180°…+180°, 12 m). Der VPS legt diese
     Sektoren über die **Welt-Posen der Sensoren** (die Geräte melden
     `poseReport`, der Manager reicht sie per Gateway-Push an den VPS
     weiter) in die Karte — nach dem **Versetzen eines Sensors stimmt der
     Bereich sofort wieder**, nichts muss empirisch neu „eingelaufen"
     werden. Der Bereich ist bewusst nominell (Winkel eher hart, Reichweite
     weich/objektgrössenabhängig) und pro Gerät in der xComDef anpassbar,
     z.B. wenn ein Radarsektor über die Rasenkarte hinausragt. Eine Katze
     läuft in den Erfassungsbereich **hinein und hinaus**: Track-Geburt/-Tod
     nahe dem Rand der **Gesamt-Abdeckung** (Vereinigung aller Sektoren —
     Übergaben zwischen überlappenden Sensoren zählen so nicht als
     Austritt) gibt **Bonus**; Auftauchen/Verschwinden mitten im Feld nur
     einen **weichen Malus** („kann sein, muss nicht"). Das trennt
     insbesondere **Vogel** (erscheint/verschwindet mitten im Feld) von
     **Katze**. Fallback, solange keine Posen bekannt sind: empirische
     Abdeckung aus den Langzeitdaten (Belegungsraster).
   - **Eine Katze darf stehenbleiben (koten!):** „sitzt am Ende stabil"
     gibt Bonus + Flag **STATIONAER**; ein am Fensterende noch offener
     Track bekommt keinen Austritts-Malus (Flag OFFEN).
   - **Sturm-Erkennung** je Sensor über Rate **und räumliche Streuung**
     (hohe Rate allein ist auch eine normal getrackte Katze; ein Burst ist
     gleichzeitig überall). **Fusion** (mehrere Sender sehen dasselbe)
     gibt Bonus; weitere Boni/Maluse: Feld-Durchquerung, langer Track,
     sehr kurzer Track, unphysikalische Sprünge.
   Tracks ab `confirm_score` (mit Bewegungsphase) werden auf Karte und
   Zeitleiste als **`CatDetected`** markiert, mit Score und Begründung.
   Alle Schwellwerte stehen in einer **Parameter-JSON im Volume** und sind
   ohne Container-Neubau im UI änderbar; Modell-**Code**-Änderungen sind ein
   Container-Rebuild — die Daten bleiben davon unberührt.
6. **Mehr-Sensor-fähig:** alles arbeitet je `(sender, sensor)` — es kommen
   sicher 1–2 weitere Radarsensoren dazu, evtl. mehr. Das Modell trackt in
   Welt-Koordinaten (`worldValid=1`); Events ohne Welt-Koordinaten werden auf
   der Analyse-Karte nicht dargestellt (die Sensoren sind inzwischen
   welt-posiert).
7. **Manuelle Track-Bewertung + Übereinstimmung:** Im Tracks-Panel lässt sich
   jeder Track von Hand kategorisieren: **„Katze", „Person", „Vogel",
   „Mäher"** oder **„Störung"** (persistent, stabiler Track-Schlüssel =
   Geburtszeit+Geburtsort; nochmal klicken = entfernen). Die Modellbewertung
   bleibt unberührt; **keine Markierung = einverstanden**; für die
   **Übereinstimmung Modell↔Mensch** oben zählt alles außer „Katze" als
   „keine Katze" (x/y, „Modell-Katze abgelehnt" bzw. „Katze übersehen") —
   die Messlatte fürs Iterieren; die Kategorien sind zugleich gelabelte
   Ground-Truth. Die Modell-Flags (sitzt/offen/Eintritt/Austritt/2+
   Sensoren) stehen als **Chips direkt in jeder Track-Zeile**.
   **RoboMäher:** Zeitbereiche mit dem Label **„Mäher"** werden von der
   Analyse ausgeschlossen (Events bleiben aufgezeichnet und sichtbar — die
   Mäher-Läufe leuchten die Erfassungsbereiche schön aus, sollen aber keine
   CatDetected erzeugen). Zusätzlich verwirft das Modell Tracks mit
   **Weglänge > `max_path_mm`** (Default 40 m) automatisch als
   „Mäher/Person?" — ein Mäher/eine Person läuft in einem Track hunderte
   Meter zusammenhängend, eine Katze nicht; damit sind auch unmarkierte
   Mäher-Läufe entschärft.
8. **CatDetected-Auslösezeitpunkt:** Vom Modell bestätigte Tracks tragen auf
   Karte und Zeitleiste einen **roten Punkt** an dem Ort/Zeitpunkt, an dem
   das (künftig auf dem ESP32 laufende) Modell `catDetected` auslösen würde —
   also **bevor** die Katze den Erfassungsbereich verlässt. Die
   Wire-Datenstruktur ist in `xComDef6_3.h` definiert (`catDetected` = msgCode
   13, `catDetectedPayload`: Welt-Position, Score, Flags, Track-Dauer,
   Netto-Verschiebung).
9. **Inzwischen umgesetzt (2026-07-04):** am Radar das **RasenKarten-Gating**
   (neuer Kartentyp `mapRasen` = Rasen-Umriss in Welt-mm aus `Map/RasenKarte.csv`;
   der Manager verteilt ihn wie die No-Shot-Karte gechunkt per UDP, generisches
   `acquireMap` in xComProc; das Radar meldet mit gültiger Welt-Pose nur noch
   Ziele innerhalb des Rasens, fail-open ohne Karte/Pose — die No-Shot-Karte
   lädt es bewusst NICHT, es schießt nicht) und die **Kopplung des
   Pose-Drift-Health-Checks an das Auto-Kalibrierungs-Setting** (Pose wird nur
   noch automatisch verworfen, wenn `stgAutoCalib` an ist und das Radar sich
   selbst neu kalibrieren kann); der **radarCalibrationButton** hat eine
   **Zielauswahl** über alle HLK-Radare der Gerätetabelle.
10. **Nicht Teil dieser Aufgabe** (Folgeaufgaben, notiert): der
   ESP32-DetectionActor, der `catDetected` tatsächlich sendet (erst wenn das
   Modell steht); Sensor-/Aktorprofile in `xComDef6_3.h` (2. Priorität —
   Aktor-Reichweiten); am Radar: Mute je Sensor (VPS + Display, wegen
   mehrerer Radars).

## Aufgabe: KI-Vision-Katzenlokalisierung auf Raspberry Pi (KIVisionCatLocator)

### Grobkonzept
Ein kamerabasiertes Gerät auf einem **Raspberry Pi 4** überwacht den Rasen
dauerhaft, erkennt eindringende Katzen per KI (**Coral Edge TPU**, lokal, ohne
Cloud), bestimmt ihre **Position im Rasen-Weltkoordinatensystem** und meldet sie
dem bestehenden CatFinder-ESP32-Netzwerk. Das Gerät (`KIVisionCatLocator`) ist
**vollwertiges Mitglied des Busses** und verhält sich wie die anderen Sensoren,
obwohl es auf einem Pi statt einem ESP32 läuft. Es wird vollständig von Claude
Code per SSH programmiert und ist wie die übrigen Geräte im Heim-WLAN
(192.168.0.x) angebunden.

Motivation: Eine gute KI-Kamera ist voraussichtlich der **stärkste
Katzendetektor** im System (Erfahrung bisher: Radar gut, Lidar schwach) und
liefert zusätzlich welt-lokalisierte Treffer als Ground-Truth, mit denen sich
das kausale CatIdent-Modell verbessern lässt.

### Hardware
- **Raspberry Pi 4, 1 GB** — Kamera, Bildverarbeitung, KI-Ansteuerung, Webserver, Bus-Kommunikation.
- **OV5647-Kamera (5 MP)** am CSI-Anschluss, einstellbarer Fokus/Objektiv.
- **Schaltbarer IR-CUT-Filter** — Farbbild am Tag, IR-empfindlich in der Nacht.
- **850-nm-IR-Scheinwerfer** — nächtliche Ausleuchtung für kurze Belichtung/scharfe Bilder.
- **Coral USB Accelerator** — Edge-TPU-Inferenz über USB 3.0.
- **WLAN** — Heimnetz, Weboberfläche, Bus-Teilnahme.

### Prinzip / Bild-Pipeline
Ein einziges Programm öffnet die Kamera und stellt jedes Bild gleichzeitig der
KI, dem Webserver und der Ereignisspeicherung zur Verfügung.
- Kamera läuft dauerhaft (z.B. 1280×960, 10–15 fps).
- Der relevante Rasenbereich wird in **mehrere überlappende Ausschnitte** geteilt;
  jeder wird auf die Modell-Eingabegröße (z.B. 320×320) skaliert und vom Coral
  geprüft. Treffer-Koordinaten werden auf das volle Kamerabild zurückgerechnet.
  Grund: eine entfernte Katze bleibt im Ausschnitt größer/erkennbarer, als wenn
  das ganze breite Bild auf 320×320 verkleinert wird. (Optional später:
  Bewegungs-Gating — Inferenz nur auf Ausschnitten mit Bewegung, spart CPU/Wärme.)
- **Treffer-Bestätigung** (gegen Fehlalarme durch Schatten/Pflanzen/Insekten/
  Rauschen): eine Katze gilt z.B. erst als bestätigt, wenn ≥3 passende
  Erkennungen innerhalb ~1 s auftreten, die Sicherheit über einem Mindestwert
  liegt und die Treffer räumlich zusammenpassen.

### Weltlokalisierung (Boden-Homographie)
Eine einzelne Kamera misst nur eine **Richtung**, keine Distanz. Die Weltposition
entsteht über eine **planare Boden-Homographie** `H` (3×3), die Bildpixel auf
Rasen-Weltkoordinaten (mm) abbildet:
- Für eine erkannte Katze wird der **Fußpunkt** der Bounding-Box (Kontakt
  Katze↔Boden, i.d.R. Unterkante-Mitte) über `H` in `worldX/worldY` gerechnet.
- Voraussetzungen: Rasen ~eben (planar), Kamera fix montiert, **Linsen­verzeichnung
  vorher korrigiert** (Weitwinkel-OV5647 verzeichnet spürbar), Füße sichtbar.
- **Grenze:** Genauigkeit nah gut, fern schlecht (Perspektive staucht Distanz).
  Bei langem, längs betrachtetem Rasen hat das ferne Ende wenig Auflösung →
  Kamera möglichst hoch und steil nach unten montieren. Fernbereich-Lokalisierung
  ggf. bewusst grob.
- Die Homographie **ist** die „Pose" der Kamera (entspricht `poseReport`/Welt-Pose
  der anderen Geräte). Kalibrierung **assistiert** über die Weboberfläche: der
  Nutzer klickt bekannte Rasenpunkte (z.B. die Ecken der `RasenKarte`) im
  Kamerabild an, daraus wird `H` berechnet. Das nutzt vorhandene RasenKarten-Daten
  wieder; eine vollautomatische Ableitung ist nicht Teil dieser Aufgabe.

### Integration ins ESP32-Netz
- **Vollwertiges Busgerät:** Python-Portierung des xCom-Protokolls (`struct`-
  gepackte Payloads, little-endian, Header-Version `0x63`, Multicast
  239.0.0.57:8266, Unicast :23456, Text-Multicast :8300). Der Pi sendet **HB**,
  **`poseReport`**, **`settingsReport`** und antwortet auf `settingsRequest`,
  `cmdSetSetting`, `cmdReboot`; er erscheint damit automatisch im VPS-Steuertab
  (inkl. Aktiv/Ruhemodus `stgActive`, Reset).
- **Neues Gerät:** ID **20**, neuer Typ (z.B. `VisionLocator`), feste IP (z.B.
  `.186`), Eintrag in `device[]`, `deviceCount` 20 → **21**. Die Gerätetabelle
  parst der VPS bereits aus `xComDef6_3.h` (`parse_xcomdef`).
- **Festlegung (Variante A): der Pi sendet `catObserved` mit `worldValid=1`,
  NICHT `catDetected`.** CatIdent bleibt der einzige Bestätiger (`catDetected`),
  damit nicht mehrere Quellen Aktoren auslösen; der Pi ist ein hochwertiger,
  welt-lokalisierender Sensor, dessen Beobachtungen das kausale Modell fusioniert.
- **Bilder** werden per HTTP an den VPS geladen (wie die CatCam) und erscheinen im
  Bilder-Tab. **Rollen-Abgrenzung zur CatCam:** CatCam = Nahaufnahme/Identifikation,
  Pi = Weitwinkel-Erkennung + Lokalisierung.

### Software-Stack (Festlegungen)
- **OS: Raspberry Pi OS Bookworm 64-bit Lite (Debian 12, Python 3.11), ohne Desktop**
  (umgesetzt am 2026-08-18; ersetzt die frühere Bullseye-Festlegung). Grund der
  Änderung: seit der Trixie-Umstellung bietet der Raspberry Pi Imager Bullseye
  nicht mehr an („Legacy" = Bookworm), und die befürchtete Coral-Falle lässt sich
  auf Bookworm sauber umgehen — siehe Inferenz-Punkt. Bullseye bliebe nur über ein
  Archiv-Image ohne regulären Support erreichbar.
- **Kamera:** `picamera2`/libcamera (OV5647).
- **Inferenz:** `libedgetpu` + `tflite-runtime` (+ optional `pycoral`), **alle drei
  gegen dieselbe TF-Version gebaut** — verifizierte Kombination auf Python 3.11:
  `libedgetpu1-std 16.0tf2.17.1` + `tflite_runtime 2.17.1` + `pycoral 2.0.3`
  (Community-Builds von `github.com/feranick`, weil Googles Wheels bei Python 3.9
  enden) und **`numpy<2`** im venv (tflite_runtime ist gegen numpy 1.x gebaut).
  Googles eigenes `libedgetpu1-std 16.0` (gegen TF 2.5) **segfaultet** mit
  `tflite-runtime 2.14` — das ist die eigentliche Falle, nicht die Python-Version.
  Gemessen auf dem Pi 4: 13,5 ms/Inferenz (SSD MobileNet v2 COCO, 300x300).
  Startmodell
  **COCO-vortrainiert (Klasse „cat"), Edge-TPU-kompiliert (int8)**. Nachtbetrieb
  (IR-Graubild) erkennt COCO anfangs schlecht → **IR-Nachttraining später**
  (anspruchsvoll, iterativ; siehe Phase 7).
- **Web:** kleiner Flask/FastAPI-Server + MJPEG-Stream, Kontrollstream nur aktiv,
  solange die Seite offen ist (spart CPU/RAM/WLAN im Normalbetrieb).
- **Autostart:** `systemd`-Dienst.
- **Protokoll-Sync:** die Python-xCom-Structs werden aus `xComDef6_3.h`
  abgeleitet/generiert, damit C-Header und Python nicht auseinanderdriften
  (zwei Quellen der Wahrheit vermeiden).

### Tag- und Nachtbetrieb
| Modus | IR-Filter | IR-Scheinwerfer |
|---|---|---|
| Tag | ein | aus |
| Nacht | aus | ein |

Umschaltung über Sonnenauf-/-untergang oder gemessene Bildhelligkeit; für gute
Nachtbilder ist gleichmäßige IR-Ausleuchtung wichtiger als maximale Mittenhelligkeit.

### Grenzen / Risiken (bewusst benannt)
- **Coral/Python-Version** — mit Bullseye entschärft.
- **Nacht-IR-Erkennung** — COCO auf Tag-RGB trainiert; Nachtraining nötig.
- **Monokulare Fernbereich-Genauigkeit** — Boden-Ebenen-Annahme; kauernde/erhöhte
  Katze bricht die Fußpunkt-Annahme.
- **Outdoor (Hardware, macht der Nutzer):** stabile 5V/3A+-Versorgung, Kühlung
  (Dauer-Inferenz erwärmt den Pi), wetterfestes Gehäuse, WLAN-Reichweite am
  Montageort. IR-CUT/IR-Scheinwerfer-Verkabelung (GPIO; der IR-CUT-Filter braucht
  meist einen kurzen Umschalt-Impuls, kein Dauersignal) klärt der Nutzer im Detail.

### Phasen (Reihenfolge der Umsetzung)
1. **Pi-Setup (assistiert).** Der Nutzer beschreibt eine leere SD-Karte mit dem
   Raspberry Pi Imager (Windows); Claude gibt die exakten „Advanced options"
   (Hostname, WLAN, SSH-Key, User). Danach übernimmt Claude per SSH: OS, Kamera
   und Coral einrichten, Grundcheck der Steuerbarkeit. (SD-Beschreiben und
   Kamera-/IR-Verkabelung sind die manuellen Teile.)
   **ERLEDIGT 2026-08-18:** Pi 4 (2 GB) mit Bookworm 64-bit Lite, Hostname
   `kivision`, User `pi` (SSH-Key, sudo ohne Passwort), feste IP
   **192.168.0.186/24** (NetworkManager-Profil `preconfigured`, WLAN-Powersave
   aus), Zeitzone Europe/Zurich. Kamera OV5647 erkannt (bis 2592x1944),
   `python3-picamera2` aus apt. Python-Umgebung: `~/kivision/venv`
   (`--system-site-packages`, damit picamera2 sichtbar ist), Coral-Stack wie oben,
   Testskripte `~/kivision/test/{coral_test.py,cam_test.py}`, Testmodell in
   `~/kivision/models/`. Verifiziert: Katze auf Coral-Testbild mit 0.96 erkannt,
   13,5 ms/Inferenz; Kamera liefert 1280x960-Bilder.
2. **Kamera-Test + Webserver.** Livebild + Kamerasteuerung im Browser. Der Nutzer
   sucht den optimalen Montageort (ganzer Rasen im Blick — vermutlich Kamera 90°
   gedreht, da der Rasen länger als breit ist) und testet Objektive sowie
   Tag-/Nachtfähigkeit.
   **ERLEDIGT 2026-08-27:** Weboberfläche unter **http://192.168.0.186:8080/**
   (Quellcode `KIVisionCatLocator/`, auf dem Pi `~/kivision/web/`, systemd-Dienst
   `kivision-web` mit Autostart). MJPEG-Livebild, Anzeige-Drehung 0/90/180/270°,
   Spiegeln, Raster, Auflösung 640×480…2592×1944, Bildrate, JPEG-Qualität,
   Belichtung/Gain/Weißabgleich/Bildregler, Schnappschuss (Stream oder volle
   5 MP) mit Galerie, und ein **zuschaltbarer Coral-Test** mit den Kachel-
   Ausschnitten des Konzepts (1…3×2, 15 % Überlappung) — damit lässt sich am
   Montageort direkt prüfen, ob die KI von dort erkennt. Kopfzeile zeigt Lux,
   Belichtungszeit, Gain, **FocusFoM** (Scharfstellhilfe) und CPU-Temperatur.
   Gemessen: 10 fps bei 1280×960, Erkennung 110 ms (ganzes Bild) bzw. 143 ms
   (2 Kacheln), CPU 40 °C ohne Throttling. Erste Beobachtungen: deutlicher
   **Magenta-Stich** (IR-Sperrfilter steht nicht im Strahlengang) und starke
   **Tonnenverzeichnung** — beide sind Sache der endgültigen Kamera und werden
   mit ihr in Phase 4 behandelt (die Testkamera hat keinen IR-Filter, die
   vorgesehenen haben einen).
   **Engpass ist das WLAN, nicht der Pi:** 2,4 GHz, −60 dBm, real nur 2–3 Mbit/s
   nutzbar, während 1280×960/85/10 fps 14,9 Mbit/s erzeugt. Das Livebild lief
   dadurch rund 2 s nach (TCP-Sendepuffer voll). Behoben durch begrenzten
   Sendepuffer (96 kB), Bildnummern-basiertes Überspringen und Encoder nur bei
   Zuschauern: 0,8 → 4,4 Bilder/s, Rückstand 2 s wachsend → 0,5 s stabil, im
   Sparmodus (640×480) 0,0 s. Details in `KIVisionCatLocator/README.md`.
   **Fürs Netz-Konzept ab Phase 5 wichtig:** eine dauerhafte Bildübertragung
   zum VPS muss zu diesen 2–3 Mbit/s passen — Einzelbilder bei Ereignis, kein
   Dauerstream.
3. **Netz-Integration.** Claude macht den Pi zum Busgerät `KIVisionCatLocator`
   (Python-xCom, HB, `settingsReport`, Steuerbarkeit im VPS).
   **ERLEDIGT 2026-09-29:** Gerät **#20 `KIVision`**, Typ **`VisionLocator` (11)**, feste
   IP .186, `deviceCount` 20 → **21** (Manager + CatIdent per OTA neu geflasht; das
   Touch-Display `Bedienung_Einstellungen` war offline und kennt #20 erst nach dem
   nächsten Flashen). Das Busmodul läuft **im selben Prozess** wie der Kamera-Webserver
   (`kivision_bus.py`), das Protokoll (`xcom.py`) wird **zur Laufzeit direkt aus
   `xComDef6_3.h` geparst** — `#define`s und alle `packed`-Structs, keine zweite Kopie;
   die Datei wird mit ausgerollt. Der Pi sendet HB (10 s), `settingsReport`
   (`stgCamAi` = KI-Erkennung, persistiert als `detect.enabled`; `stgActive` =
   Ruhemodus, nicht persistiert), `poseReport` (bis Phase 4 `validWorldPose=0`) und
   Debug-Text; er befolgt `cmdSetSetting` und `cmdReboot` (= Programm-Neustart über
   systemd, nicht Pi-Reboot, ~10 s). Erfassungsbereich in der Tabelle vorläufig
   nominell (−50/+50°, 15 m), bis die Homographie steht. Verifiziert über den VPS:
   HB-Liste, Steuerungs-Tab, Ruhemodus hin/zurück (KI stoppt/startet), Neustart.
4. **Pose / Homographie (assistiert).** Die Kamera lernt Standort und Ausrichtung
   als Boden-Homographie über RasenKarten-Referenzpunkte (Web-UI-Klicks; VPS falls
   nötig).
   **ERLEDIGT 2026-10-17 (einfacher als geplant, ohne Klicks):** Homographie
   automatisch per RANSAC aus den gesammelten Radar↔Kamera-Paaren
   (`pairs.jsonl`), Median-Fehler ~200 mm; Rasenrand/Schussverbot/1-m-Gitter
   werden zur Sichtprüfung ins Livebild eingeblendet, bewegte Spuren zeigen ihre
   Rasenposition. Offen: Linsenverzeichnung, gültiger `poseReport`. Details
   `KIVisionCatLocator/README.md` („Phase 4").
5. **Kamera als Beweismittel und Zusatzsensor** (neu ausgerichtet 2026-10-18).
   **Zwischenstand:** Die KIVision reagiert auf Radar-Meldungen vom Bus und auf
   eigene Bewegungserkennung. Echte KI-Katzenerkennungen sind selten: Die Katze
   ist fern und klein, die Coral-Modelle sind nicht auf diese Sicht trainiert,
   und das IR-Licht reicht nachts nur bis etwa Dome-C1 (ein zusätzlicher
   Scheinwerfer für den Bereich dahinter ist bestellt). Nachts sieht man aber oft
   die Augen leuchten. Als **Katzendetektor** hilft die Kamera deshalb wenig, als
   **Beweismittel** dagegen enorm: Auf den Bildern lässt sich jeder Track sicher
   klassifizieren. Damit kann sie das CatIdent-Modell deutlich verbessern
   (Phase 7). Ziel ist, mehr davon zu profitieren:
   - **A. Kamerabilder am Track (zuerst).** Zu jedem VPS-Track legt der Pi 1–4
     kleine Einzelbilder (Ausschnitt + Übersicht) dauerhaft auf dem VPS ab,
     zugeordnet über Zeit und Weltposition. Sie erscheinen beim Track rechts im
     Analyse-Tab. Klassifiziert wird wie bisher mit den **Track-Kästchen**
     (Katze, Person, Vogel, Mäher, Insekt, Sturm, Störung, sicher keine Katze;
     Tabelle `track_marks`), keine freien Labels. Bilder nur für Tracks, nicht
     für jedes Ereignis (WLAN 2–3 Mbit/s). Heute fallen die Pi-Galerien nach
     ~150 Bildern (etwa ein Tag) heraus und tragen keine Track-Nummer; das
     Nachschauen per Uhrzeit entfällt damit. Stand 2026-10-18: 261 bewertete
     Tracks (77 Katze, 72 sicher keine, 69 Mäher, 22 Störung, 18 Person,
     3 Vogel) — mit Bildern wächst diese Ground-Truth schneller und sicherer.
   - **B. Kamera-Bewegung als Ortung.** Bewegungsspuren haben über das
     Kamera-Modell Rasenkoordinaten (~10–30 cm). Der Pi sendet sie als
     `catObserved` mit `worldValid=1` wie ein weiteres Radar; CatIdent bekommt
     eine unabhängige, genaue Position und verwirft Radar-Geister leichter. Keine
     Klassifikation nötig. Dazu gültiger `poseReport`. (Deckt Phase 6 weitgehend
     ab.)
     **Umgesetzt 2026-10-18:** als eigener Nachrichtentyp **`visionObserved` (16)**,
     nicht `catObserved` — die PowerActors feuern auf jedes `catObserved` ohne
     Absender-Prüfung. Manager reicht es an den VPS weiter; CatIdent und
     VPS-Modell nehmen es nur mit Modell-Parameter **`cam_feed=1`** (Standard 0:
     erst aufzeichnen, an bewerteten Tracks prüfen, dann zuschalten). Je Spur
     max. 1/s, stehend alle 3 s, Teilspuren < 0,7 m zusammengefasst, nur auf dem
     Rasen. `poseReport` bleibt bis zum Zuschalten ungültig (sonst ändert der
     Kamera-Sektor die Randlogik).
   - **C. Leuchtende Augen nachts.** Zwei kleine helle Punkte im Augenabstand,
     die sich gemeinsam bewegen: billiger, sehr spezifischer Tier-Detektor, auch
     ausserhalb des IR-Lichts; Abstand und Höhe trennen grob Katze und Fuchs.
     **Erste Fassung 2026-10-18** (`kivision_eyes.py`): nur nachts (Lux < 50 oder
     Gain am Anschlag), auf dem vollen 2592er-Bild im Rasen samt 40-px-Rand,
     2×/s. Top-Hat (Rechteckkern 15 px) + Kontrastverhältnis ≥ 2,5 (auf hellem
     Grund nur fast gesättigte Punkte), Mäher-Scheinwerfer samt 60 px Umgebung
     ausgeblendet, ortsfeste Lichter über eine vergessende Wärmekarte
     (5 min). Ein Auge zählt ab 3 Treffern in Folge; Partnerpunkt = „Paar“.
     Ausgabe: Galerie „Leuchtende Augen“ (+ Rohbilder `eyes/raw` zum
     Nachjustieren), `visionObserved` mit `sensor=1` (Augenhöhe 25 cm für die
     Rasenposition), Bild an den VPS (`kiveye`).
     **Ergebnis erste Nacht:** 0 von 5 Katzen erkannt, 1 Fehltreffer (Mäher-LED).
     Ursache: das Nachtbild (Regen, IR-Licht am Dome-C1) hatte fast immer über
     40 Einzelpunkte → 98 % der Bilder als „verrauscht“ verworfen, 2,2 s je Bild.
     **Paarsuche 2026-10-19:** In den Radar-Ausschnitten der Tracks
     81603/81605/81607/81624/81628 sind die Augen am hinteren Rasenende je
     ~5–7 px groß, Mitte zu Mitte ~8–10 px, fast waagrecht. Neu: Gauß 5 px gegen
     Pixelrauschen, Top-Hat 21 px, Flecken = örtliche Helligkeitsspitzen (zwei
     nahe Augen verschmelzen an einer Schwelle zu einer Fläche), Größe auf halber
     Höhe gemessen. **Auge = zwei Flecken waagrecht nebeneinander** (Abstand
     6–60 px, |dy| ≤ 0,3·dx+2, Abstand 1–7 Fleckbreiten, ähnlich groß und hell,
     dunklere Lücke dazwischen). Spur entsteht nur aus einem Paar, ein einzelnes
     Auge (Kopf gedreht) hält eine bestehende Spur am Leben; bestätigt ab
     2 Paar-Treffern. Offline-Test: alle Nacht-Ausschnitte mit Augen gefunden
     (10 Bilder, alle 5 Tracks), 0 Fehlpaare in Nachtbildern ohne Katze; ~0,3 s
     je Vollbild auf dem Pi.
   - **D. Eigener Klassifikator (später).** Aus den über A bewerteten Tracks
     Ausschnitte sammeln und einen Garten-eigenen Coral-Klassifikator
     nachtrainieren (Katze/Fuchs/Mäher/Igel/nichts). Lohnt erst ab einigen
     hundert Beispielen.
   **GESTRICHEN 2026-10-18: Tag/Nacht-Automatik** — IR-Sperrfilter und IR-Licht
   schaltet die Kamera selbst, der Pi muss nichts steuern.
6. **Lokalisierung.** Erkannte Katze → Rasen-Weltkoordinaten (Homographie aus
   Phase 4) → in `catObserved` (`worldX/worldY`, `worldValid=1`) mitübertragen.
7. **CatIdent-Modelloptimierung.** Die welt-lokalisierten Kamera-Treffer dienen
   zusammen mit den Daten der anderen Sensoren als Labels/Ground-Truth, um das
   kausale CatIdent-Modell zu tunen — und als Grundlage fürs IR-Nachttraining.

**Stand 2026-10-26:** Phase 5 ist erreicht. Teile von Phase 6 und 7 sind dabei
bereits entstanden: Die Kamera-Ortung läuft als `visionObserved` (5B, wartet auf
`cam_feed=1`), und die Bilder am Track (5A) liefern die Ground-Truth für die
Track-Bewertung und den Abgleich mit CatIdent. Die Arbeit an der Kamera geht
weiter, parallel dazu wird der PowerActor2-Aufbau ins Gesamtsystem integriert
(siehe nächste Aufgabe).

### Nicht Teil dieser Aufgabe / Abgrenzung
- Wetterfestes Gehäuse, Strom, Montage (Nutzer).
- IR-CUT-/IR-Scheinwerfer: schaltet die Kamera selbst (2026-10-18).
- Vollautomatische Pose-Ableitung ohne Nutzerklicks; IR-Nachttraining (eigene
  spätere Iteration); Nutzung als eigenständiger `catDetected`-Bestätiger
  (bleibt bei CatIdent).

## Aufgabe: Integration von PowerActor2, LD06 und Compact Dome (mobiler Aufbau)

### Grobkonzept
PowerActor2, LD06 und Compact Dome waren ursprünglich ein **eigenständiges
System**: LD06 und Compact Dome erkannten das Ziel, der LP40B-Lidar am Turm des
PowerActor2 sollte es vor dem Schuss verifizieren. Dieser Aufbau wird jetzt
vollständig in das **kartengestützte Gesamtsystem** (Rasenkarte, Welt-
Koordinatensystem, Sensorfusion über CatIdent) eingebunden. Die Komponenten
erhalten dabei teilweise neue Aufgaben.

### Mechanischer Aufbau
PowerActor2, LD06 und Compact Dome sind fest auf einem **gemeinsamen Träger**
montiert. Alle drei liegen auf einer Linie, die der **0°-Ausrichtung des Servos
und des Radars** entspricht. Der LD06 ist um 90° gedreht montiert, liegt aber
ebenfalls auf dieser Linie.

Abstände zur Drehachse des PowerActor2 — alle liegen **in 0°-Richtung vor der
Drehachse** (Versatz `+d` entlang der 0°-Linie):

| Komponente | Abstand zur Drehachse |
|---|---|
| LP40B | 1,5 cm |
| LD06 | 13,5 cm |
| Compact Dome | 18,5 cm |

Da alle Komponenten fest miteinander verbunden sind, bleiben ihre relativen
Positionen und Ausrichtungen konstant. Mechanische Toleranzen können jedoch zu
geringfügigen **Winkelabweichungen zwischen den Sensorachsen** führen.

### Erkenntnisse aus den bisherigen Tests (Standalone-Konzept)
1. **Mechanische Abweichungen:** Die Achsen von LD06 und Compact Dome weichen
   wegen mechanischer Toleranzen geringfügig voneinander ab.
2. **Störungen durch Bewuchs:** Pflanzen und Bewuchs an den Rasenrändern
   verursachen zahlreiche Fehldetektionen.
3. **Empfindlichkeit gegenüber Sonnenlicht:** Der LD06 reagiert empfindlich auf
   direkt einfallendes Sonnenlicht, abhängig von Tageszeit und Sonnenstand.
4. **Zielverifikation nicht nachgewiesen:** Die Verifikation mit dem LP40B
   konnte bisher nicht nachgewiesen werden, weil keine geeignete Testsituation
   zustande kam.

### Was das Gesamtkonzept verbessert
- **Weniger Fehldetektionen:** Störungen durch Bewuchs am Rasenrand werden über
  die Rasenkarte erkannt und ausgefiltert (vgl. RasenKarten-Gating der Radare).
- **Sensorfusion:** Mehrere Sensoren tragen unabhängig zur Zielerkennung bei,
  ihre Informationen werden kombiniert.
- **Bessere Zielqualifikation:** Ziele werden anhand zusätzlicher Informationen
  (Spurbewertung, Kamera) besser von Störungen unterschieden.
- **Gemeinsames Koordinatensystem:** Positionen und Ausrichtungen aller Sensoren
  beziehen sich auf das Welt-Koordinatensystem der Rasenkarte.

### Neue Rollen der Komponenten
**Compact Dome — zusätzliches Radar zur Zielerkennung.** Der Compact Dome wird
als weiteres Radar eingebunden und liefert Zielinformationen wie die übrigen
Radare. Seine Detektionen werden ins Welt-Koordinatensystem übertragen und mit
den anderen Sensoren kombiniert.

**LD06 — Positions- und Orientierungsbestimmung.** Die Tests mit dem LiDAR C1
haben gezeigt, dass Lidare Katzen nicht oder nur eingeschränkt zuverlässig
erkennen. Der LD06 wird deshalb, analog zum LiDAR C1, **primär zur Bestimmung
seiner eigenen Position und Ausrichtung** relativ zur Rasenkarte eingesetzt:
Bekannte Strukturen und Konturen werden mit der gespeicherten Karte
abgeglichen. Die bekannte Methode, auf dem Rasen umherzulaufen
(Co-Observation-Kalibrierung), bleibt verfügbar, soll im Normalfall aber nicht
nötig sein.

**PowerActor2 — mobiler Aktor.** Im Gegensatz zu den fest installierten
Komponenten ist der PowerActor2 **mobil**: Er kann zeitweise entfernt und
später an einer anderen Stelle wieder aufgestellt werden. Deshalb muss das
System seine Position und Orientierung nach dem Aufstellen **selbstständig**
bestimmen können.

### Gemeinsame Pose des Trägers
Weil die drei Komponenten fest auf demselben Träger sitzen, genügt **eine
gemeinsame Referenzpose**:
- **X-Position** relativ zur Rasenkarte,
- **Y-Position** relativ zur Rasenkarte,
- **Orientierung** des Trägers relativ zum Koordinatensystem der Karte.

Referenzpunkt ist die **Drehachse des PowerActor2**, Referenzrichtung die
0°-Linie von Servo und Radar. Die Posen von LD06 und Compact Dome werden aus
dieser Trägerpose über ihre bekannten **mechanischen Versätze** (Tabelle oben)
und ihre **Winkelabweichungen** berechnet. Damit reicht es, die Pose des
Trägers zu bestimmen, um alle drei Komponenten korrekt im Gesamtsystem zu
lokalisieren.

### Unterstützung durch den LP40B
Die Pose wird **primär mit dem LD06 und der Rasenkarte** bestimmt. Der
LP40B-Lidar des PowerActor2 kann zusätzlich beitragen, z.B. um die vom LD06
ermittelte Pose zu überprüfen oder zu verfeinern. Ziel ist eine zuverlässige
und reproduzierbare Pose des ganzen mobilen Aufbaus, auch nach dem Umstellen.

### Bezug zum bestehenden System (Stand 2026-10-26)
- **Gerätetabelle `xComDef6_3.h`:** Die drei Geräte bilden bereits die Gruppe
  `groupPA2` — Compact Dome #3 (HLK-Radar), PowerActor2 #4 (.181, Eintrag heißt
  noch „PowerActor1“; Umbenennung erst beim Bus-Deploy), LD06 #7 (Lidar).
- **Compact Dome** läuft mit der gemeinsamen Radar-Firmware `Radar6_3_0`
  (Build-Variante CompactDome, GPIO19, sender 3); RasenKarten-Gating und
  Welt-Pose gibt es dort bereits.
- **PowerActor2-Neuaufbau** läuft schrittweise in
  `PowerActor2/Development/AfterSerialRebuild/` (Step1–5: Servo, Relais,
  LP40B, Laser, IR-Positionskamera SEN0158); danach Einbau in `PA2i6_3_0`.
  Die Relais schalten u.a. die **Speisung von LD06 (GPIO26) und Compact Dome
  (GPIO23)**. Der LP40B misst im Betrieb einzeln (Laser nicht dauernd an).
  Die IR-Positionskamera SEN0158 soll ggf. ebenfalls bei der Pose-Findung
  helfen.
- **Auslösen:** Die PowerActors reagieren heute auf jedes `catObserved` ohne
  Absender-Prüfung. Im Gesamtsystem bestätigt **CatIdent** die Katze
  (`catDetected`); die Feuersperre `fireInhibit` (17) ist im PowerActor2 noch
  einzubauen.

### Winkel-Kalibrierung des Trägers (Stand 2026-10-26)
Gemessen mit dem Kalibrier-Tool (`PowerActor2/Development/AfterSerialRebuild/Step6_CalibTool`):
Eine Person stellt sich an verschiedene Stellen, der Servo schwenkt den LP40B über sie
(Referenzrichtung), LD06 und Compact Dome messen gleichzeitig. Gültige Werte stehen in
`Step6_CalibTool/calibration.json`.

| Sensor | Drehung Sensor → PA | gespiegelt | Versatz | Herkunft |
|---|---|---|---|---|
| LD06 | 177,5° | nein | 135 mm  | Indoor-Messung, 4 Punkte, Streuung 0,2° (vorläufig) |
| Compact Dome | 0° (Annahme) | nein | 185 mm  | Indoor-Messung −4° ± 5° zu unsicher → Platzhalter |

Die Messung wird **outdoor wiederholt**. Danach ist sie nochmals fällig, wenn der Laser
auf der Drehachse neu justiert ist.

### Nicht Teil dieses Abschnitts
Die konkrete Integration der einzelnen Komponenten (Reihenfolge, Protokoll,
Pose-Algorithmus des LD06, Kalibrierung der Winkelabweichungen) wird in
Folgeschritten festgelegt.

## Aufgabe: Next-Gen-Aktor mit Akkubetrieb (Entwurf)

**Status 2026-11-05: Entwurf, noch nicht zur Umsetzung freigegeben.** Dieser Abschnitt
hält den Stand der Überlegungen fest und wird weiter ausgearbeitet. Alle Stromwerte sind
Rechen- oder Schätzwerte aus Datenblättern und Forenmessungen. Am Aufbau ist noch nichts
gemessen. Die Einsatzzahlen stammen dagegen aus dem `actor_log`.

### Grobkonzept
Die heutigen Aktoren hängen per WLAN am Bus und halten mit Akku nur wenige Stunden.
Die nächste Generation soll mit einem Akku **Wochen** durchhalten. Dafür schläft der
Aktor, lauscht mit sehr wenig Strom auf Funk und ist nach dem Wecken sofort einsatzbereit.
Der Aktor besteht aus zwei Teilen: Die **Basis** hängt am Netzteil und am Bus, der
**Actor** läuft mit Akku. Beide haben einen ESP32 und sind über 868 MHz verbunden.

```text
Radare → CatIdent → WLAN-Multicast → Basis (Netzteil: ESP32 + RFM95)
                                         │ 868 MHz FSK, beidseitig
                                         ▼
                 Actor: RFM95 lauscht → weckt ESP32 → schaltet Servo/Laser/Sprüh-Kit
```

### Ziele
- Mindestens 4 Wochen Betrieb mit einem Akku von etwa 60 Wh (Annahme).
- Reaktion auf eine bestätigte Katze innerhalb von etwa 100 ms.
- Betrieb ohne VPS und ohne Manager, wie im übrigen System.
- Mindestens so sicher wie heute: Bei Funkverlust wird nicht geschossen.

### Auslöser
Geweckt wird bei `catDetected`, nicht bei jeder Radarmeldung. Darauf löst PA2 bereits aus,
und `catTracked` liefert danach rund 5 Positionen pro Sekunde. Die Bestätigung durch den
CatIdent dauert ohnehin länger als die Funkverzögerung, und rohe Radarmeldungen würden
Wachzeit kosten, ohne dass geschossen werden darf.

### Übertragung (Favorit)
**RFM95 (SX1276) auf 868 MHz im FSK-Betrieb mit Sequencer.** Die Module sind vorhanden
(868-MHz-Ausführung). Der Chip öffnet über eigene Timer selbständig im Takt von etwa
100 ms kurz den Empfang und weckt den ESP32 per DIO-Pin erst, wenn er etwas erkannt hat.
Die Basis sendet dazu eine Präambel von etwa 120 ms. Der Link funktioniert in beide
Richtungen, damit auch `catHit` und der Akkustand zurückkommen.

Der LoRa-Betrieb scheidet aus: Dort muss der ESP32 jede Kanalsuche selbst anstossen, wäre
also rund 10-mal pro Sekunde wach. Den Sequencer richtet die Firmware voraussichtlich
selbst über die Register ein.

| Lösung | Bereitschaftsstrom | Reaktion | Beurteilung |
|---|---|---|---|
| WLAN dauernd an | ca. 100 mA | sofort | scheidet aus |
| ESP-NOW mit Wachfenster | ca. 4 mA | ca. 100 ms | keine neue Hardware, aber am WLAN-Kanal gebunden |
| **RFM95 FSK mit Sequencer** | **ca. 0,4 mA** | **max. ca. 100 ms** | **Favorit, Module vorhanden** |
| CC1101 Wake-on-Radio | ca. 0,4 mA | max. ca. 100 ms | gleichwertig, aber nicht vorhanden und nur ca. +10 dBm |
| nRF52 mit kurzem Lauschen, 2,4 GHz | ca. 50 µA | ca. 100 ms | Alternative, mehr Eigenentwicklung |
| Weckempfänger (z. B. FH101RF) | wenige µA | 1–121 ms | bringt wenig, die Selbstentladung liegt höher |
| RFSENSE (EFR32) | sehr tief | schnell | zu unempfindlich |

Der RFM95-Wert ist gerechnet: 3 ms Empfang bei etwa 12 mA alle 100 ms, dazwischen rund
1,5 µA. Die 3 ms sind angenommen und bestimmen das Ergebnis. Der CC1101-Wert ist aus
Forenmessungen hochgerechnet (40 µA bei 1 s Takt).

### Basis
Die Basis ist ein Radar nach dem Vorbild des Dome-C1 mit zusätzlichem RFM95. Sie erfüllt
also zwei Aufgaben: Sie beobachtet wie jedes Radar und verbindet den Bus mit den Actors.

- **Board:** XIAO ESP32-S3 statt M5Stamp Pico (8 MB statt 4 MB Flash). Der CatIdent läuft
  bereits auf diesem Board. Die Firmware für den S3 ist noch nicht kompiliert.
- **Funk als eigene Task:** Der RFM95 sendet die Präambel selbst. Die Firmware wartet nicht
  darauf, damit das Radar nicht stockt.
- **WLAN-Antenne:** Der XIAO braucht die externe IPEX-Antenne. Die WLAN-Antenne und die
  868-MHz-Antenne erhalten etwas Abstand zueinander.
- **LED-Pixel:** Der XIAO hat keines an Bord, es kommt extern dazu. Es wird am besten mit
  3,3 V versorgt, damit der Datenpegel sicher passt.

Die 11 Anschlüsse des XIAO sind damit alle belegt, es bleibt keine Reserve:

| Funktion | Pins |
|---|---|
| RFM95 (SCK, MISO, MOSI, NSS, RESET, DIO0) | 6 |
| Radar (nur RX, die Firmware sendet nichts ans Radar) | 1 |
| LED-Pixel | 1 |
| BMP180 (I2C) | 2 |
| IR-Schalter | 1 |
| **Summe** | **11** |

**Zwei Actors:** Eine Basis genügt. Sie sendet ein Paket an alle mit Weltposition der Katze
und Scharf-Status, die Präambel weckt beide Actors. Jeder Actor zielt aus seiner eigenen
Pose. Für Rückmeldungen hat jeder ein festes Zeitfenster nach dem Basis-Paket, weil beide
nicht gleichzeitig senden dürfen. Bei angenommenen 40 Byte und 38,4 kbit/s dauert ein
Paket etwa 8 ms, bei 5 Paketen pro Sekunde bleibt also genug Platz. Eine zweite Basis
braucht es nur, wenn ein Actor ausser Funkreichweite steht.

### Aktor-Hardware
- **Bestückung:** ESP32-S3, RFM95, Servo ST3020 für den Turm, Ziel-Laser, Sprüh-Kit
  (Bambu Lab Electric Water Spray Kit 01, Modell B-ZC004), LP40B für die Pose und ADXL362
  als Bewegungssensor.
- **ESP32 im Light Sleep statt Tiefschlaf:** ca. 0,8 mA, Wecken in 1–3 ms, RAM mit Karte
  und Pose bleibt erhalten. Tiefschlaf spart in 4 Wochen nur rund 1,6 Wh und kostet
  200–500 ms Start.
- **Chip ESP32-S3:** Modul ESP32-S3-WROOM-1-N8 ohne PSRAM. Der USB-Anschluss ist im Chip,
  der Actor braucht also keinen USB-Chip, und die Basis nutzt dieselbe Chipfamilie. Laut
  Forenbeiträgen zum Datenblatt braucht der S3 im Light Sleep 240 µA, gemeldet werden real aber
  220–700 µA und mehr. Der Vorteil gegenüber dem ESP32 ist deshalb unsicher und wird
  am Aufbau gemessen. Die 0,8 mA im Energiebudget bleiben bis dahin stehen.
- **Antenne:** Die Modulantenne des WROOM-1 sitzt am Gehäuserand, weg vom Wassertank. Die
  Variante WROOM-1U nimmt eine externe Antenne.
- **Pins:** Der Actor braucht rund 18: RFM95 6, ADXL362 2, Servobus 2, LP40B 2, MOSFETs 4,
  Füllstand 1, Akkuspannung 1.
- **Keine Dev-Boards:** nacktes Modul auf einer kleinen eigenen Trägerplatine mit 3,3-V-Wandler
  mit sehr kleinem Eigenverbrauch, Abblockkondensatoren, EN und BOOT sowie USB-Pads.
  Ein passendes fertiges Trägerboard ist nicht bekannt. Für erste Funktionstests reicht ein
  S3-Board, für die Strommessung nicht. Es gibt keinen USB-Chip und keine Dauer-LEDs.
  Ein AMS1117 allein käme an 7,4 V auf rund 25 Wh in 4 Wochen.
- **MOSFETs statt Relais:** Servo, Laser, LP40B und Sprüh-Kit sind im Schlaf stromlos.
  Der Motor des Sprüh-Kits braucht eine Freilaufdiode.
  - **Plusleitung schalten:** Servo und LP40B hängen über Datenleitungen am ESP32. Würde ihre
    Masse getrennt, könnte der Strom über diese Leitungen fliessen.
  - **Prototyp:** Vorhandene 2SJ175 (P-Kanal, 60 V, 10 A). Je Kanal ein BC547 als Treiber,
    10 kΩ vom GPIO zur Basis, rund 100 kΩ von der Basis nach Masse und 100 kΩ vom Gate
    nach Akku-Plus. Ein 3,3-V-Pin allein kann den 2SJ175 nicht ausschalten.
  - **Schaltung:** Sie ist ein Prinzip und noch nicht aufgebaut oder geprüft.
  - **Spannungsabfall:** Bei angenommenen 2 A fallen am 2SJ175 grob 0,4 V ab. Ob das fürs
    Kit reicht, zeigt die Strommessung.
  - **Nicht geeignet:** IRF840 (braucht 10 V am Gate, 0,85 Ω) und IRF520-Module (ebenfalls
    rund 10 V am Gate). Fertige Module schalten meist die Masse und passen deshalb nicht für
    Servo und LP40B.
  - **Serie:** Für einen späteren Serienaufbau kommt ein kleinerer, modernerer Typ infrage.
- **Servo:** Nach dem Einschalten zuerst die Ist-Position lesen, erst dann das Drehmoment
  aktivieren.
- **Wasser:** Es kommt aus einem Tank auf dem Aktor und wird mit dem Bambu Lab Electric
  Water Spray Kit 01 (ZC004) gefördert. Der Aktor braucht also keinen Schlauch. Ein Ventil
  entfällt voraussichtlich, der Schuss wird über den Kit-Motor ausgelöst.
- **Akku 2S (7,4 V) als Systemspannung (Vorschlag):** Das Kit läuft mit 7,4 V und der
  Servo ST3020 mit 6–12 V. Damit entfällt voraussichtlich eine eigene 12-V-Schiene.
  60 Wh entsprechen etwa 2S3P mit 18650-Zellen.
- **LP40B auf dem Drehturm, kein LD06 und kein Radar:** LD06 und Radar würden das Budget
  sprengen. Der Aktor bleibt reine Wirkeinheit, der Turm-Lidar dient der Pose.

### Pose und Wartung
Die Pose kommt von einem Lidar auf dem Drehturm, zum Beispiel dem LP40B oder einem
ähnlichen Sensor. Der Rundumschwenk gegen die RasenKarte ist am PA2 erprobt und lieferte
dort auch ohne LD06-Daten eine eindeutige Pose. Beim Aktor entfällt aber die heutige
Gegenprüfung LD06 gegen LP40B, die Fehler des Turmwinkels erkennt. Dafür braucht es
einen Ersatz.

Ein Schwenk dauert rund 35 s und passt nicht zum Sofort-Einsatz. Die Pose bleibt deshalb
gespeichert, was die heutige Regel «keine NVS-Pose nach dem Boot» für diesen Aktor ablöst.
Ein Beschleunigungssensor erklärt sie für ungültig, sobald der Aktor bewegt wird. Danach
wird nicht geschossen, bis ein neuer Schwenk gelungen ist.

**Bewegungssensor: ADXL362.** Er überwacht selbständig mit rund 0,3 µA und weckt den ESP32
per Interrupt-Pin. Über SPI teilt er sich den Bus mit dem RFM95. Ein ADXL335 eignet sich
nicht, weil er rund 350 µA braucht und keine Schwelle und keinen Interrupt hat.
- **Eigene Bewegung:** Während eines Einsatzes blendet der ESP32 das Rütteln von Servo und
  Sprüh-Kit aus. Danach vergleicht er die Schwerkraftrichtung mit dem Wert von vorher.
- **Wind und Stösse:** Die Schwelle wird am Aufbau eingestellt.
- **Ohne Strom:** Der Sensor überwacht dann nicht. Nach jedem Einschalten gilt die
  gespeicherte Pose deshalb als ungültig.

**Mögliche Variante: Lidar C1 statt LP40B (noch nicht entschieden).** Der C1 ist ausser als
Pose-Referenz für die Radare kaum noch nötig und könnte auf dem Turm sitzen.
- **Vorteile:** Die Pose kommt ohne Schwenk, und der Sensor misst im selben Bezug wie die
  Düse. Zwei Scans bei 90° Servo-Unterschied könnten die Gegenprüfung des Turmwinkels ersetzen.
- **Nachteile:** Er ist deutlich grösser, braucht rundum freie Sicht und reicht nur bis
  12 m. Für zwei Actors bräuchte es zwei Stück.
- **Risiko:** Der LD06 war rundum scannend gegen die RasenKarte mehrdeutig. Ob die grössere
  Reichweite des C1 das behebt, ist nicht getestet.
- **Fester C1:** Fällt er weg, fehlt den Radaren die laufende Weltreferenz für Kalibrierung
  und Health-Check. Das wäre vorher zu lösen.

### Betriebsarten
Die Pose wird nur bei der Initialisierung gebraucht. Der ESP32 des Aktors schaltet deshalb
nur dafür das WLAN ein, ein zweiter Chip ist nicht nötig.

| Betriebsart | WLAN | Aufgabe |
|---|---|---|
| **Initialisierung und Wartung** | an | Schwenk und Pose, No-Shot-Karte laden, OTA |
| **Normalbetrieb** | aus | schlafen, per 868 MHz wecken, zielen, schiessen |

- **Auslöser (Vorschlag):** Einschalten, Funkbefehl von VPS oder Display, und nach einer
  Bewegung, sobald der Aktor wieder ruhig steht.
- **Ablauf:** Der ESP32 startet neu ins WLAN, erledigt die Aufgaben, speichert Pose und
  Karte im Flash und startet in den Normalbetrieb. So bleibt der Normalbetrieb frei vom
  WLAN-Stack. Nach dem Neustart gilt der Scharf-Status aus dem nächsten Funkpaket.
- **Zeitlimit:** Das WLAN schaltet nach einer festen Zeit ab, auch ohne Erfolg (z. B. 10 min),
  damit eine fehlgeschlagene Wartung den Akku nicht leert.
- **Sicherheit:** Während der Initialisierung schiesst der Aktor nicht.
- **OTA:** Es läuft mit Rückfall auf die alte Firmware, weil ein Fehlstart im Feld den
  einzigen Funkweg zum Aktor kosten würde.
- **Ohne WLAN oder VPS:** Die Lokalisierung rechnet heute auf dem VPS. Fällt er aus, behält
  ein unbewegter Aktor seine Pose. Ein bewegter Aktor bleibt ohne Pose und gesichert.

### Sprüh-Kit (Stand 2026-11-04)
Laut Bambu-Lab-Shop (Suchergebnisse, die Produktseite selbst liess sich nicht lesen):

| Eigenschaft | Wert |
|---|---|
| Spannung | 7,4 V (mitgelieferter 18650-Akku, 2200 mAh) |
| Reichweite | 10 m |
| Schussfolge | 2 Schuss/s |
| Stromaufnahme, Druck, Wasser pro Schuss | nicht angegeben |
| Trockenlauf | verboten, kann das Gerät beschädigen |

Der Wert «Schuss pro Sekunde» deutet auf einen Impulsbetrieb ohne langen Druckaufbau hin.
Das ist nicht belegt und muss getestet werden. Die 10 m liegen über den heutigen 6,5 m
des PA2, gelten aber als Herstellerangabe.

Wegen des Trockenlaufverbots ist eine Füllstandserkennung Pflicht. Bei leerem Tank wird
das Kit nicht mehr ausgelöst.

**Füllstand: Schwimmerschalter mit Reedkontakt plus Schusszähler.** Der Schalter schützt
vor dem Trockenlauf, der Zähler in der Firmware schätzt den Restinhalt.
- **Montage:** Der Schwimmer sitzt deutlich über der Ansaugöffnung, damit auch bei Schieflage
  noch Wasser ansteht.
- **Lesen:** Der ESP32 prüft ihn nur vor einem Schuss mit kurz eingeschaltetem Pull-up. Im
  Schlaf fliesst kein Strom. Die Leseroutine wartet ein ruhiges Signal ab, weil das Wasser
  schwappen kann.
- **Bei Reserve:** Das Kit wird gesperrt, auch wenn der Zähler noch Wasser anzeigt, und der
  Actor meldet das über die Basis.
- **Nach dem Auffüllen:** Der Zähler setzt sich zurück, sobald der Schwimmer wieder oben ist.
  Das stimmt nur, wenn der Tank voll gefüllt wird.
- **Zähler:** Er braucht die gemessene Wassermenge pro Schuss.
- **Alternative:** Ein kapazitiver Sensor aussen am Tank kommt ohne Teile im Wasser aus,
  braucht aber einen weiteren MOSFET-Kanal.

**Mögliche Option: doppelläufig mit zwei Sprüh-Kits (noch nicht entschieden).** Beide Kits
sässen auf dem Turm und würden Stromaufnahme, Wasserverbrauch und Turmlast erhöhen.

**Mögliche Option: Neigungsausgleich mit zweitem Servo (noch nicht entschieden).** Ein zweiter
Servo am Turm neigt das Sprüh-Kit samt Ziel-Laser und gleicht Bodenunebenheiten aus.
- **Ein Servo genügt:** Die Rollbewegung um die Strahlachse ändert die Schussrichtung nicht.
  Der kleine Fehler in der Seitenrichtung lässt sich bei wenigen Grad Schieflage vernachlässigen.
- **Sensor:** Der ADXL362 bleibt besser fest im Gehäuse statt auf dem Kit. Er misst die Schieflage
  nach dem Aufstellen, und die Firmware rechnet daraus für jede Turmstellung die Neigung
  aus. So bleibt er als Bewegungssensor brauchbar und spürt das Rütteln des Kits weniger.
- **Zusatznutzen:** Mit der Neigung lässt sich auch die Flugbahn an die Distanz anpassen.
- **Schlaf:** Ohne Strom hält der Servo nicht. Das Kit muss ausgewogen gelagert sein oder
  einen Anschlag haben.
- **Aufwand:** Der Servo hängt am selben Servobus, braucht also keinen weiteren Pin. Dazu
  kommen Mechanik, Gewicht und etwas Strom bei jedem Einsatz.

### Sicherheit
Ein schlafender Aktor hört weder `fireInhibit` noch die Scharf/Sicher-Befehle. Deshalb gilt:
- Jedes Funkpaket führt Scharf-Status und Sperre mit.
- Geschossen wird nur mit einem frischen Paket (z. B. höchstens 500 ms alt).
- Pakete tragen Zähler und Signatur, weil der Funk über den Garten hinausreicht.
- Nach einem Neustart ist der Aktor gesichert, wie heute.

### Energiebudget (4 Wochen, Schätzung)

| Posten | Annahme | Energie |
|---|---|---|
| ESP32 Light Sleep | 0,8 mA bei 3,3 V | 1,8 Wh |
| RFM95 | 0,4 mA | 0,9 Wh |
| Einsätze | 6 pro Tag, je 30 s bei 5 W | 7,0 Wh |
| **Summe** | ohne Wandlerverluste und Selbstentladung | **ca. 9,7 Wh** |

Den grössten Einfluss haben die Wachzeiten, nicht das Lauschen. Das Sprüh-Kit ist in den
5 W noch nicht enthalten und kann das Budget deutlich verändern. Vom angenommenen Akku mit
60 Wh bleiben rund 50 Wh für Kit, Wandlerverluste, Selbstentladung und Reserve.

### Einsätze laut `actor_log` (31.10.–5.11.2026)
Als Einsatz zählt hier eine Folge von `catDetected` und Schüssen mit weniger als 120 s
Abstand. So lange bliebe der Aktor nicht wach, die Grenze dient nur dem Zählen.

| Grösse | Wert |
|---|---|
| Einsätze pro Tag | 5–6 (4 volle Tage, 1.–4.11.) |
| `catDetected` pro Tag | 6–11 |
| Dauer vom ersten bis zum letzten Ereignis | Median 7 s, Mittel 20 s, Maximum 85 s (17 Einsätze) |
| Schüsse pro Einsatz | Mittel 2,7, Maximum 11 (17 Einsätze) |
| Schüsse pro Tag | 26 und 16 (volle Tage 1.–2.11.) |

- Die Werte zu Dauer und Schüssen stammen nur vom 31.10. bis 2.11., denn seit dem 3.11.
  gab es keine Schüsse mehr. Für die Wachzeit bleiben also 17 Einsätze als Grundlage.
- Die 30 s Wachzeit bleiben als Annahme tauglich: 20 s im Mittel plus rund 10 s Nachlauf.
- Die Daten umfassen nur wenige Tage im November. Andere Jahreszeiten können abweichen.
- In den Zahlen stecken auch Fehlauslösungen, denn wecken würden sie den Aktor ebenso.
- Für 28 Tage ergibt das grob 400–700 Schüsse. Das ist die Grundlage für die Tankgrösse,
  sobald das Wasser pro Schuss gemessen ist.

### Offene Punkte
- Heutigen Verbrauch von PA2 je Komponente messen.
- `actor_log` im Sommer erneut auswerten, die heutigen Einsatzzahlen stammen nur aus dem
  November.
- Prototyp mit zwei RFM95 und nacktem ESP32: Sequencer einrichten, kürzestes zuverlässiges
  Empfangsfenster, Ruhestrom, Weckzeit, Reichweite und Paketverlust im Garten.
- Zulässige Sendezeit und Leistung im 868-MHz-Band für die Schweiz prüfen.
- Akku: 2S bestätigen, Laden, Verhalten bei Kälte, Solarzelle ja oder nein.
- Sprüh-Kit messen: Stromaufnahme, Zeit bis zum ersten Strahl, Wasser pro Schuss,
  wirkliche Reichweite und Flugbahn im Freien, Ansteuerung per MOSFET.
- Tank: Inhalt, Ansaugen ohne Luft, Einbauort im festen Teil oder auf dem Turm. Der Tank
  kann die Betriebsdauer stärker begrenzen als der Akku.
- Frost: Tank, Pumpe und Leitungen im Winter.
- Antenne des XIAO ESP32-S3 prüfen: Sie überzeugt schon beim CatIdent nicht.
- Basis: Standort, Reichweite, Darstellung auf dem Bus (HB, Gerätenummer).
  Eine neue Nummer bedeutet heute `deviceCount` und Neuflashen aller Geräte.
- Paketformat und Signaturverfahren festlegen.
- Turm-Lidar: LP40B oder ein anderer Sensor, Ersatz für die Gegenprüfung durch den LD06,
  Stromverbrauch und Dauer des Schwenks. Die C1-Variante ist optional und wird erst später
  allenfalls getestet.

### Nicht Teil dieses Abschnitts
Die konkrete Umsetzung, die Bauteilwahl und die Firmware werden erst festgelegt, wenn die
offenen Punkte geklärt sind.

## Aufgabe: Zielmodell „Sitzende Katze" (Entwurf, Stand 2026-11-08)

Nicht zur Umsetzung freigegeben. Grundlage: Kot-Verdacht (Incident-Tracer Stufe 1,
`VPS/dashboard/incidents.py`) und die Auswertung der Kotfälle 16.10. und 07.11.

### Ausgangslage
- Viele Katzen laufen regelmässig über den Rasen und koten nicht. Sie sollen in Ruhe
  gelassen werden; nass werden soll nur, wer sich zum Koten hinsetzt.
- Es gibt einen deutlichen **Katzenkorridor**: Die 329 als Katze bewerteten Tracks laufen
  zum grossen Teil auf einer Spur bei x ≈ 7,5–8,0 m von hinten (y 10,5) bis vorne (y 1,5).
- Beide sicheren Kotplätze (6,2/9,8 und 7,0/9,4) liegen **1–1,5 m neben** dem Korridor.
  Ankunft und Sitzen waren ausserhalb; 83472 ist nach dem Koten im Korridor davongerannt.
- Der Korridor allein trennt nicht: 40–50 % der normalen Katzen-Tracks liegen ebenfalls
  überwiegend ausserhalb. **Das Sitzen trennt stark:** Seit 16.10. gab es genau zwei
  Sitzphasen nach dem Kot-Profil, beide waren Kotfälle.
- Reichweite ist kein Thema: Der PA wird für den Betrieb mit Wasser ohnehin neu platziert.

### Grundidee
Zwei Modelle laufen **parallel und unabhängig**:
- **Normalmodell:** der heutige CatIdent (`catTrack.ino`), bleibt unverändert.
- **Zielmodell:** meldet nur Tiere, die sich ausserhalb des Korridors hinsetzen.

Ein **Schalter im Aktor** legt fest, auf welches Modell er hört. Beide Modelle rechnen
immer; so lässt sich jederzeit vergleichen, und Umschalten ändert keine Erkennung.

### Sitzmodell
Arbeitet mit **Sitzplätzen** statt Tracks. Die Tracks des CatIdent reissen nach 1,5 s
Lücke ab, 83472 hatte aber 17,5 s Lücke mitten im Sitzen.
- Jede Radarmeldung fällt in einen Sitzplatz-Kandidaten (Kreis 0,6 m) oder eröffnet einen
  neuen. Der Kandidat sammelt Anwesenheitszeit, verzeiht Lücken bis ca. 25 s, danach verfällt er.
- **Auslösung**, wenn alles erfüllt ist:
  - vorher Ankunft gesehen (mind. 0,5 m Bewegung zum Platz hin),
  - sitzt mindestens T s mit Streuung ≤ 150 mm und mind. 1 Meldung/s,
  - keine Sperrstelle, keine Mäherzeit, keine Personen-Sperre (fireInhibit),
  - **Korridor-Regel:** ausserhalb T = 15–20 s (Startwert), innerhalb nie oder nur mit
    deutlich längerem T (offen).
- Danach fortlaufende Zielposition, bis sich das Tier mehr als 1 m entfernt.
- Live ist das Weggehen noch nicht bekannt; das Abgang-Kriterium der nachträglichen
  Prüfung entfällt.
- Zeitbudget: Die Katzen sassen 38–56 s; Auslösung nach ~20 s lässt 20–35 s zum Zielen.
- Offen: eingefrorene Radarziele (bitgenau gleiche Punkte > 30 s). Auch echtes Sitzen
  erzeugte 99 gleiche Punkte am Stück, deshalb in der Testphase nur mitschreiben.

### Katzenkorridore
- **Lernen** auf dem VPS aus den als Katze bewerteten Tracks: Zellen (0,5 m), durch die
  mind. x % der Tracks laufen, als Polygon.
- **Bearbeiten** von Hand wie Noshot- und Rasenkarte.
- **Verteilen** als neuer Kartentyp `korridor` über den bestehenden Kartenweg
  (VPS-Editor → Manager → Gerät). Das Gerät speichert ihn dauerhaft; der laufende Betrieb
  braucht weder Manager noch VPS.

### Wo läuft das Zielmodell?

| Option | Vorteil | Nachteil |
|---|---|---|
| A: eigenes Gerät „Target Identifier" (z. B. XIAO S3, neue Busnummer) | völlig unabhängig, eigener Funkempfang, eigener Ausfall | ein Gerät mehr, neue Busnummer = `deviceCount` + alle neu flashen |
| B: zweites Modul in der CatIdent-Firmware | keine neue Hardware | gemeinsamer Absturz/OTA, Code muss streng getrennt bleiben |
| C: KIVision-Pi | Python, gleicher Code wie VPS, Kamera als Zweitmeinung | WLAN schwach, Multicast heute nur per Manager-Weiterleitung |
| D: VPS | einfach | verstösst gegen „keine zentrale Abhängigkeit" |

Zusätzlich in jedem Fall ein **Python-Nachbau auf dem VPS** für die Auswertung, wie
heute `catTrack.ino` ↔ `catmodel.py`.

**Rechenkapazität für Variante B** (Messung 2026-11-08, Kompilat `CatId6_3_0` für XIAO ESP32-S3):
- Programmspeicher 1,13 MB von 3,34 MB (33 %).
- Globale Variablen 78,6 kB von 320 kB, **249 kB frei**; die 8 MB PSRAM des XIAO S3 sind
  ungenutzt.
- Normalmodell heute: 10 Tracks à ca. 0,9 kB (Ring 48 Punkte) ≈ 9 kB, Sturm-Slots ≈ 4 kB.
- Zielmodell zusätzlich (Schätzung): 16 Sitzplatz-Kandidaten ≈ 2 kB, Korridor-Polygone
  wie die Erfassungs-Polygone ≈ 2 kB, also **< 5 kB**.
- Rechenzeit: Pro Radarmeldung ein Vergleich mit wenigen Kandidaten plus ein
  Punkt-in-Polygon-Test. Bei einigen Dutzend Meldungen/s ist das auf 240 MHz weit unter 1 %
  Last.
- **Fazit:** Rechenleistung und Speicher reichen für beide Modelle locker. Das Risiko von B
  ist nicht die Leistung, sondern die Kopplung: ein Fehler, Absturz oder OTA trifft beide
  Modelle, und beide hängen am selben WLAN-Empfang.
- Wenn B: Zielmodell in eigener Datei (`sitModel.ino`) mit eigenem Zustand, eigenen
  Parametern und eigenen Meldungen; gemeinsam nur der Empfang der `catObserved` und das
  Senden. Ein späterer Umzug auf ein eigenes Gerät (A) ist dann nur noch Kopieren.

### Meldungen und Schalter
- Neue Meldungsarten `targetDetected` / `targetTracked`. Bewusst nicht `catDetected`, sonst
  feuern alte Aktoren ohne Absenderfilter darauf (gleiche Lehre wie bei `visionObserved`).
- **Schalter im Aktor** als dauerhafte Einstellung über den Settings-Weg (Steuerungs-Tab,
  Display, Button): `normal` / `ziel` / `beide`. Jeder Aktor kann anders eingestellt sein;
  funktioniert ohne VPS. Feuersperre und Button bleiben unverändert wirksam.

### Neuer Tab „Zielmodell" (VPS)
- Karte: Korridor (Dichte + Polygon), Sperrstellen, Sitzplätze mit Entscheidung
  („hätte geschossen ab …" / „nicht, weil …").
- Zeitleiste: Sitz-Kandidaten, Auslösungen Zielmodell und Normalmodell nebeneinander,
  echte Schüsse.
- Liste der Sitz-Ereignisse mit Merkmalen, verknüpft mit Kot-Verdacht und Rückmeldung.
- Tagesvergleich: Schüsse Normalmodell vs. Zielmodell, davon Kotfälle.
- Bedienung: Korridor lernen/bearbeiten, Parameter, Schalterstellung je Aktor.

### Einführung in Stufen
1. VPS-Nachbau und Tab: nur auswerten, auf die bisherigen Daten anwenden, Schwellen festlegen.
2. Korridor-Karte: lernen, bearbeiten, verteilen.
3. Zielmodell auf dem Gerät im **Schattenbetrieb**: sendet `targetDetected`, kein Aktor
   hört darauf; live mit dem Nachbau vergleichen.
4. Schalter im Aktor, zuerst ohne Wasser (zielen, nicht feuern).
5. Scharf mit Wasser am neuen Standort.

### Entscheidungen (2026-11-08)
- **Variante B:** Modul `CatIdentifier/CatId6_3_0/sitModel.ino` (+ `sitModelDef.h`) im CatIdent.
- Im Korridor wird nach langer Sitzzeit geschossen (`sit_corr_s`, Start 90 s).
- Fuchs: weiter mit dem Normalmodell.
- Korridor: aus den Erfahrungsdaten (alle als Katze bewerteten Tracks) gelernt, jederzeit neu
  lernbar und von Hand bearbeitbar.

### Umsetzungsstand (2026-11-08)
- Stufe 1–3 umgesetzt: VPS-Nachbau `VPS/dashboard/sitmodel.py`, Tab „Zielmodell", Korridor
  (Kartentyp hier als Rasterzellen über `/sit_corridor.csv`, im CatIdent im LittleFS gecacht,
  statt über den Manager-Kartenweg), CatIdent im **Schattenbetrieb** (`targetDetected` 22 /
  `targetTracked` 23, kein Aktor hört darauf), Manager reicht `targetDetected` als actor_log
  `tgt` an den VPS.
- Gegenüber dem Entwurf nach den Daten ergänzt: Schwerpunkt/Streuung gleitend (`sit_tau_s`,
  sonst verdirbt der Anlauf die Streuung), Ankunft gegen den aktuellen Schwerpunkt, Mindest-
  streuung je Achse (eingefrorene Radarziele) und **Höchstrate** 7/s (sitzende Katze meldet
  dünn), nur HLK-Radare.
- Rückblick 16.10.–08.11.: beide Kotfälle lösen aus (81320 nach 21 s, 83472 nach 30 s, je
  20–30 s bevor die Katze aufstand), dazu 7 weitere Auslösungen und ein Block von 13 am 16.10.
  14–15 Uhr (vermutlich Mäher/Gartenarbeit).
- Stufe 4 umgesetzt (2026-11-08): PA2-Schalter **Zielquelle Normal / Beide / Ziel** (Bits 6/7,
  persistiert, Default Normal; Steuerungs-Tab). Eine laufende Verfolgung wechselt die Quelle
  nicht; für das Zielmodell entfällt die Eingefroren-Prüfung des PA2. Der CatIdent führt einen
  ausgelösten Sitzplatz bis 6 s nach der letzten Radarmeldung weiter nach (`sitTick`), damit der
  PA2 die Katze bei Radarlücken nicht verliert.
- Offen: Stufe 5 (Wasser, neuer Standort).

### Nicht Teil dieses Abschnitts
Die konkrete Firmware, die Parameterwerte und die Tab-Gestaltung werden erst festgelegt,
wenn die offenen Punkte geklärt sind.
