smily77/CatFind/SpinOff/BurglerProtect/Dokumentation/Konzept.md

# Spin-off BurglerProtect – Besucherabhängiges Wohnzimmerlicht

Stand: 2026-10-29 – Schritt 1 (Dome-C1 meldet `visitorObserved`, VPS-Tab «Besucher») und Schritt 2 (Steuergerät **Besucherlicht**, Gerät Nr. 22) umgesetzt, siehe Abschnitt 11.
Ursprüngliche Anforderung: [Anforderung_Original.md](Anforderung_Original.md)

## 1. Idee in einem Satz

Ist das System scharf und nähert sich jemand im Dunkeln über die Veranda dem Haus, schaltet ein lokales Steuergerät über Philips Hue das **Wohnzimmerlicht** für einige Minuten ein. Von aussen sieht es dann so aus, als wäre jemand zu Hause. Für den Betrieb braucht es weder den VPS noch den Manager.

## 2. Einschätzung

Die Idee passt gut zu CatFinder. Die Sensoren, der Bus, die Welt-Koordinaten und die Polygon-Werkzeuge (No-Shot-Karte, Coverage) gibt es schon. Neu sind im Kern nur ein kleines Steuergerät mit Taster und die Hue-Anbindung. Wohnzimmerlicht statt Aussenlicht ist ein guter Ansatz, weil es Anwesenheit vortäuscht, statt nur den Eindringling anzuleuchten.

Die Aufteilung «VPS = Konfiguration und Anzeige, Gerät = Entscheidung» entspricht dem Grundsatz, dass der laufende Betrieb nicht von einer zentralen Stelle abhängen darf.

Bei der Prüfung gegen das bestehende System haben sich drei Punkte gezeigt, die die Anforderung so nicht abdeckt. Sie müssen vor der Umsetzung geklärt sein.

### 2.1 Auf der Veranda kommt heute kein einziges Ereignis an

Abfrage der VPS-Datenbank vom 27.10.2026, letzte 14 Tage, alle Sensoren: **0 Ereignisse mit X > 0 und Y < 0**. Der Dome-C1 meldet nur Y ≥ 0,99 m.

Grund: Jedes Radar mit gültiger Welt-Pose meldet nur Ziele **innerhalb der Filterkarte** (No-Shot- oder Rasenkarte, `processTargets()` in `Radar6_3_0.ino`). Das wurde absichtlich so gebaut, damit Nachbargrundstück und Strasse nicht dauernd Störungen erzeugen. Die Veranda liegt ausserhalb der Rasenkarte, ihre Ziele werden also im Radar verworfen.

Ausserdem ist offen, ob der Dome-C1 die Veranda überhaupt sieht. Er steht bei (8,21 / 2,91 m), Ausrichtung 130,4°. Die Veranda (Y < 0) ist mindestens 3 m entfernt, das liegt noch in der Reichweite des HLK-LD2450 (≈ 6 m), aber vielleicht nicht im Öffnungswinkel (±60°). Die KIVision-Kamera steht selbst auf der Veranda (6,87 / −0,18 m) und blickt auf den Rasen, für die Veranda fällt sie aus.

→ **Erster Schritt vor allem anderen:** messen, ob und wie gut der Dome-C1 eine Person auf der Veranda erfasst (siehe Abschnitt 8, Schritt 0).

### 2.2 Besucher dürfen NICHT als `catObserved` gemeldet werden

Die Anforderung sieht `catObserved` als Quelle vor. Das wäre gefährlich: **PowerActor1_1 feuert auf jedes `catObserved` ohne Absenderfilter.** Ein Besucher auf der Veranda würde damit zum Ziel des Wasserstrahls. Ausserdem würden CatIdentifier und VPS-Analysierer Veranda-Spuren als Katzenkandidaten bewerten.

Darum gibt es dafür einen **eigenen msgCode `visitorObserved`**. Das ist dieselbe Lehre wie bei `visionObserved` (Code 16) für die Kamera. Der Sensor meldet Ziele ausserhalb der Filterkarte, aber im Quadranten X > 0, Y < 0, zusätzlich als `visitorObserved` (gleicher `posPayload`). Damit ändert sich für alle bisherigen Geräte nichts.

**Beschluss 2026-10-27: Im Dome-C1 nur der Quadrant, das Polygon nur im Steuergerät.** Der Dome-C1 läuft wie bisher weiter und bekommt in `processTargets()` nur eine zusätzliche Bedingung (statt `continue` bei Zielen ausserhalb der Filterkarte: `if (worldX > 0 && worldY < 0) broadcastMsg(visitorObserved, obsData);`), also wenige Bytes Code. Das ist nötig, weil der Programmspeicher fast voll ist: Die Radar-Firmware (pico32) ist 1,26 MB gross, die App-Partition fasst 1,31 MB (≈ 96 % voll). Eine zweite Karte samt Kartentransfer hätte dort keinen Platz.

Das ist zwar anders als beim Katzenteil, wo jeder Sensor selbst nach Karte filtert, hat aber auch Vorteile: Das Auslösepolygon liegt nur an **einer** Stelle, und `mapVisitor` muss nur an das Steuergerät verteilt werden, nicht an jeden Sensor. Weil auf der Veranda selten jemand ist, bleibt der zusätzliche Busverkehr klein. Der Quadrant kann aber auch Hauswand-Reflexe oder Strasse enthalten. Das zeigt sich in Schritt 2. Falls es zu viel wird, kann man den Quadranten im Sensor mit festen Grenzen enger fassen, statt dort ein Polygon einzubauen.

Später möglich (eleganter, braucht aber Speicher): zwei Zonen im Sensor, eine Karte für `catObserved` und eine für `visitorObserved`. Das ginge erst, wenn im Radar Platz frei wird (z. B. durch eine grössere App-Partition ohne OTA-Reserve oder durch Aufräumen).

### 2.3 Neues Busgerät = neuer Eintrag in `device[]`

Das Steuergerät wird Busteilnehmer Nr. 22 (`deviceCount` 22 → 23). Wie bei Dome-C1 und KIVision verwerfen alle Geräte mit altem `deviceCount` die Meldungen des neuen Geräts, bis sie neu geflasht sind. Das betrifft vor allem den Manager (Konfiguration, Anzeige) und das Display. Für die eigentliche Funktion reicht es, Steuergerät, Dome-C1 und Manager zu flashen.

Alternative ohne neues Gerät: die Funktion in den bestehenden **Button** (Gerät `Schalter`) einbauen. Davon rate ich ab. Der Button ist der Hauptschalter der Aktoren, und eine Verwechslung «Licht scharf» ↔ «Wasser scharf» wäre ein schlechter Fehler. Auch der Standort ist ein anderer (Button beim Aktor, Besucherlicht beim Hauseingang bzw. Wohnzimmer).

## 3. Übersicht

```
 Dome-C1 (Radar)                      Steuergerät "Besucherlicht" (Nr. 22)
 ───────────────                      ────────────────────────────────────
 Ziel ausserhalb Filterkarte  ──MC──▶  visitorObserved empfangen
 und X>0, Y<0                         ├─ im Auslösepolygon?          (lokal gespeichert)
   → visitorObserved (neu)            ├─ Spur bilden, Plausibilität  (lokal gespeichert)
                                      ├─ scharf? (Taster / VPS)       (lokal gespeichert)
                                      ├─ Hue: Wohnzimmer aus?         ─HTTP─▶ Hue Bridge (LAN)
                                      └─ Licht EIN, Timer, Licht AUS  ─HTTP─▶ Hue Bridge (LAN)
                                         HB mit Zustand ──MC──▶ Manager ──▶ VPS (Anzeige)

 VPS Tab "Besucher": Karte + Liste + Polygon + Parameter + Scharf-Knopf
   Konfiguration ──▶ Manager ──▶ Steuergerät (dort im Flash gespeichert)
```

Ohne VPS und Manager läuft der Pfad Dome-C1 → Steuergerät → Hue weiter. Es fehlen dann nur Anzeige und Fernbedienung.

## 4. Erkennung und Plausibilisierung

### 4.1 Messgrundlage

Der Dome-C1 meldet bei einem Ziel im Sichtfeld etwa **10 Ereignisse pro Sekunde** (gemessen über 3 Tage: Median 10/s, 90 % ≤ 12/s, Abstand zwischen zwei Meldungen Median 0,10 s). Eine Person auf dem Weg zur Haustür ist erfahrungsgemäss 2–5 s im Bereich.

### 4.2 Regel (Vorschlag, alles im VPS einstellbar)

1. **Vorfilter im Dome-C1:** nur Ziele mit X > 0, Y < 0, ausserhalb der Filterkarte.
2. **Polygon im Steuergerät:** nur Ereignisse innerhalb des Auslösepolygons zählen (Punkt-im-Polygon, wie bei der No-Shot-Karte).
3. **Spur:** aufeinanderfolgende Ereignisse gehören zum selben Objekt, wenn sie höchstens `LINK_MM` = 1000 mm und `LINK_S` = 1,0 s auseinanderliegen. Einzelne Ausreisser beginnen eine eigene, kurzlebige Spur und verfälschen die echte nicht.
4. **Auslösung**, sobald eine Spur
   - mindestens `MIN_EVENTS` = **12** Ereignisse im Polygon hat,
   - innerhalb von `WINDOW_S` = **3 s**,
   - und dabei mindestens `MIN_SPAN_S` = **1,0 s** lang besteht (nicht nur ein Schub in einem Augenblick).

   Reaktionszeit typisch 1,2–2 s. Das ist kurz genug, weil das Licht spätestens dann brennt, wenn die Person an der Tür ist.
5. **Retriggerbar (Beschluss 2026-10-27):** Solange das Licht brennt, verlängert **jede** Meldung im Polygon die Einschaltdauer auf «Meldung + `ON_S`» (Start 600 s). Solange der Besucher da ist, bleibt das Licht also an, und eine Pause oder Sperre gibt es nicht. Erst wenn das Licht aus ist, braucht es für das nächste Einschalten wieder die volle Regel 4. Hat ein Bewohner das Licht von Hand ausgeschaltet, während der Besucher noch da ist, schaltet das Steuergerät es erst wieder ein, wenn das Polygon dazwischen mindestens 30 s leer war (sonst würde es gegen den Bewohner kämpfen).

Die Werte sind Startwerte. Sobald `visitorObserved` läuft, werden sie an echten Durchgängen im Tab «Besucher» abgestimmt (Abschnitt 8, Schritt 2).

### 4.3 Was die Regel nicht unterscheidet

Das Radar unterscheidet nicht zwischen Person, Katze oder Fuchs. Eine Katze, die über die Veranda läuft, kann das Licht einschalten. Das ist harmlos und eher selten, weil Tiere meist rasch durchlaufen. Bewohner, die nach Hause kommen, lösen es ebenfalls aus, und das ist sogar erwünscht. Eine Personenerkennung per Kamera ist auf der Veranda heute nicht möglich (siehe 2.1).

## 5. Lichtsteuerung über Philips Hue

### 5.1 Anbindung

- **Lokal über die Hue Bridge im LAN, ohne Cloud** (passt zur VPS-Unabhängigkeit). Die Bridge bietet eine einfache HTTP-REST-Schnittstelle (API v1): `GET /api/<key>/groups/<id>` liefert den Zustand, `PUT …/action` schaltet. Das ist auf einem ESP32 problemlos machbar. Die API v2 (HTTPS + Ereignisstrom) ist für den ESP32 schwerer und hier nicht nötig.
- Einmalig wird ein **App-Key** erzeugt: Knopf auf der Bridge drücken, dann `POST /api` vom Steuergerät aus. Der Key wird im Flash gespeichert und im VPS nur als «vorhanden» angezeigt.
- Gesteuert wird der **Raum (Gruppe) «Wohnzimmer»** statt einer einzelnen Lampe. `state.any_on` zeigt, ob dort irgendein Licht brennt.
- Bridge-IP fest (DHCP-Reservierung) oder per mDNS/Discovery, Raum-ID im VPS auswählbar.

### 5.2 Ablauf und manuelle Bedienung

| Lage | Verhalten |
|---|---|
| Wohnzimmer brennt schon (`any_on`) | nichts tun |
| Auslösung, Licht aus | einschalten mit fester Helligkeit `BRI` (z. B. 70 %) und Farbtemperatur `CT` (warm), merken «das Licht gehört mir» |
| Während der Einschaltdauer (alle 5 s abfragen) | Wird das Licht ausgeschaltet oder ändern sich Helligkeit/Farbe → «gehört nicht mehr mir» |
| Ende der Einschaltdauer (`ON_S` = 600 s nach der letzten Meldung im Polygon) | nur ausschalten, wenn es mir noch gehört, also noch an ist **und** noch genau `BRI`/`CT` hat |
| Lampe nicht erreichbar (Wandschalter aus, `reachable=false`) | nicht nachschalten, Fehler im HB melden |
| Bridge nicht erreichbar | Taster blinkt, Fehler im HB |

Das deckt den Fall «Bewohner kommt heim und lässt das Licht an» ab. Er schaltet es aus und wieder ein oder dimmt es, und schon schaltet das System es nicht mehr ab. Bleibt eine Lücke: Wer nur auf denselben Wert schaltet, ohne etwas zu ändern, bei dem schaltet das System das Licht nach Ablauf trotzdem aus. Für den Zweck ist das vertretbar.

Optional später: Einschaltdauer leicht zufällig (± 20 %), damit es weniger nach Automatik aussieht.

### 5.3 Nur bei Dunkelheit (Vorschlag, nicht in der Anforderung)

Bei Tageslicht bringt eingeschaltetes Wohnzimmerlicht nichts. Vorschlag: zusätzliche Bedingung **«zwischen Sonnenuntergang − 30 min und Sonnenaufgang + 30 min»**, lokal berechnet aus Datum, NTP-Zeit und fester Position. Dafür braucht es keinen Sensor und keinen VPS. Im VPS abschaltbar, falls der Taster ohnehin nur beim Weggehen am Abend gedrückt wird.

## 6. Taster und Scharfschaltung

- Gerät: ESP32 mit einem **beleuchteten Taster** (z. B. Metall-Drucktaster mit LED-Ring oder ganzflächig leuchtender Arcade-Taster, über einen Transistor geschaltet). Alternative ohne Bastelarbeit: M5 Atom Matrix wie beim Button (der ganze Knopf leuchtet).
- **Leuchtet = scharf, dunkel = aus.** Blinkt = Fehler (Hue nicht erreichbar, kein Key).
- **Das Steuergerät ist der Master des Zustands.** Der Zustand wird im Flash gespeichert, sodass das System nach einem Stromausfall im selben Zustand weiterläuft. Der Zustand steht in jedem HB des Geräts, VPS und Manager zeigen ihn nur an.
- Der VPS schaltet per Kommando mit **absolutem Wert** (`info` 1 = scharf, 2 = aus), **nicht als Umschalter**. Geht ein UDP-Paket verloren oder kommt es doppelt an, stimmt der Zustand trotzdem (dieselbe Lehre wie im Button/Feuersperre-Plan). Der Taster am Gerät schaltet um, weil er lokal ist und keine Paketverluste hat.

## 7. VPS-Tab «Besucher»

| Teil | Inhalt | Vorbild |
|---|---|---|
| Karte | alle `visitorObserved` im Quadranten X > 0, Y < 0, Spuren farbig, Auslösungen markiert | Tab Welt_Karte |
| Polygon | Auslösebereich zeichnen, Ecken verschieben/löschen, speichern | Coverage-Tab, No-Shot-Editor |
| Liste | Zeit, Position, Spur-Nr., «hat ausgelöst» / «gesperrt» / «Licht war an» | Tab Liste |
| Löschen | löscht **nur** die Besucherdaten (eigene Tabelle `visitor_events`), nichts sonst | Karte zurücksetzen |
| Zustand | Scharf/Aus (aus HB) + Knopf, Hue erreichbar ja/nein, letzte Auslösung | Steuerungs-Tab |
| Parameter | `MIN_EVENTS`, `WINDOW_S`, `MIN_SPAN_S`, `LINK_MM`, `LINK_S`, `ON_S`, `BRI`, `CT`, Dunkelheit ja/nein, Hue-Raum | Modell-Parameter |

**Wie die Konfiguration aufs Gerät kommt:** Das Polygon läuft über den bestehenden Kartenweg als neuer Kartentyp `mapVisitor` (VPS → Manager → Gerät, `mapInfo`/`mapChunk`, Versionsabgleich). Das Gerät legt es im LittleFS ab, genau wie die Radare die No-Shot-Karte. Die Parameter gehen als Einstellungen über den Manager und werden ebenfalls im Flash gespeichert. Das Gerät holt nie Betriebsdaten vom VPS, nur Konfiguration, und es läuft mit der zuletzt gespeicherten weiter.

Datenschutz: Die Tabelle enthält Bewegungen von Personen auf dem eigenen Grundstück. Vorschlag: automatisch nach 30 Tagen löschen, zusätzlich zum Löschknopf.

## 8. Vorgehen

0. **Sichtprüfung Dome-C1 (Voraussetzung):** Testfirmware mit `visitorObserved` (nur Quadrant, siehe 2.2) flashen, dann über die Veranda gehen. Ergebnis: Wird die Person erfasst, wie weit, wie stabil? Fällt das negativ aus, braucht es einen eigenen Sensor an der Veranda (z. B. ein zweites LD2450 Richtung Hauseingang, als weitere Radar-Variante).
1. **`visitorObserved`** in `xComDef6_3.h` und `Radar6_3_0.ino` (CatFinder-Erweiterung, nicht in diesem Ordner). Weil alle Radar-Varianten denselben Code haben, kann das jedes Radar mit gültiger Pose. Für die Veranda zählt aber nur der Dome-C1. VPS speichert die Meldungen in `visitor_events`, Tab «Besucher» zuerst nur mit Karte und Liste.
2. **Ein paar Tage beobachten:** echte Durchgänge, Störungen (Hauswand-Reflexe, Strasse), dann Polygon zeichnen und Parameter festlegen.
3. **Steuergerät** bauen (Taster, Hue-Anbindung, Plausibilisierung, Flash-Speicher), Gerät Nr. 22 in `device[]`.
4. **Konfigurationsweg:** `mapVisitor`, Parameter, Scharf-Kommando, HB-Anzeige im VPS.
5. **Probebetrieb** mit Protokoll im Tab, danach Werte nachschärfen.

## 9. Ablage

| Was | Wo |
|---|---|
| Konzept, Anleitungen, Schema | `SpinOff/BurglerProtect/Dokumentation/` |
| Firmware Steuergerät | `SpinOff/BurglerProtect/Firmware/` (geplant) |
| `visitorObserved`, `mapVisitor`, Gerät Nr. 22 | `Controller/Manager6_3_0/xComDef6_3.h` (gemeinsamer Header) |
| Dome-C1 meldet Veranda-Ziele (nur Quadrant) | `Radar_HKL/Radar6_3_0/` |
| Tab «Besucher», Tabelle `visitor_events` | `VPS/dashboard/` |

## 10. Entscheide und offene Punkte

Entscheide 2026-10-27:
- Quelle ist der **Dome-C1**. Er sendet zusätzlich `visitorObserved` bei X > 0, Y < 0, das Polygon prüft nur der Empfänger. Das ist die endgültige Firmware, keine Testversion: Ist etwas nicht in Ordnung, kommt die alte Variante zurück.
- Auslöseregel wie in 4.2, aber **retriggerbar** (Punkt 5).
- «Nur bei Dunkelheit» ja, aber erst im nächsten Schritt, nachdem die Veranda-Meldungen geprüft sind.
- Der Taster hat Strom. Die Hue Bridge hat eine feste IP, Raum und Zugangsdaten folgen mit dem Steuergerät.

Umgesetzt in Schritt 1:
- `visitorObserved` = msgCode 18 in `xComDef6_3.h`.
- `Radar6_3_0.ino`: Ziele ausserhalb der Filterkarte im Quadranten X > 0, Y < 0 werden als `visitorObserved` gemeldet. Flash 98 %, noch 19,7 kB frei.
- Manager reicht `visitorObserved` mit `"vis":1` an den VPS weiter.
- VPS: Tabelle `visitor_events`, getrennt von `events`, nach 30 Tagen automatisch gelöscht. Regel in `VPS/dashboard/visitor.py`, Tab «Besucher» (`static/visitor.js`): Karte, Spurenliste, Polygon-Editor, Parameter, Löschknopf, Auswertung «schaltet ein / hält an».

Offen:
1. Sichtprüfung: Werden Personen auf der Veranda erfasst, wie stabil, welche Störungen gibt es im Quadranten?
2. Polygon zeichnen und Parameter an echten Durchgängen abstimmen.
3. Schritt 2: Steuergerät (Taster, Hue, Dunkelheit, Scharf/Aus), Gerät Nr. 22.
4. ~~Stromausfall~~ entschieden 2026-10-28: Der scharfe Zustand überdauert einen Stromausfall (im Flash gespeichert).

## 11. Schritt 2: Steuergerät Besucherlicht (umgesetzt 2026-10-29)

Firmware: `SpinOff/BurglerProtect/Firmware/Besucherlicht6_3_0/`. Hardware: **M5Stack AtomS3** (ESP32-S3, 8 MB Flash, Display 128×128, Knopf unter dem Display), feste IP **.188**, Gerät Nr. 22 `Besucherlicht` (Typ `LightControl`), `deviceCount` 23.

Entscheide des Users 2026-10-29:
- **Zuhause-Gruppen:** Arbeitszimmer, Buro, stubbe, Wohnzimmer Decke, Veranda. Brennt eine davon, ist jemand zuhause, das Licht wird nicht eingeschaltet.
- **Abschreck-Licht:** jede dieser Gruppen und jede Kombination wählbar (Tab «Besucher», Standard «Wohnzimmer Decke»). Helligkeit und Farbe werden nicht verändert.
- **Aktive Zeit:** ab Sonnenuntergang (aus Datum berechnet, Herisau 47,386 N / 9,279 E, NOAA-Näherung) bis einstellbares Ende, Standard 24:00. Beginn mit Versatz in Minuten einstellbar.
- **Aufzeichnung bleibt unverändert:** Der VPS speichert alle Besucher-Meldungen, auch wenn die Anlage nicht scharf ist.
- Hue-Zugang (`hueIp`, `hueApiKey`) steht in `Credentials.h`, kein Pairing auf dem Gerät nötig.

Abweichungen vom Konzept (einfacher, gleiche Wirkung):
- **Konfiguration per HTTP statt `mapVisitor`:** Das Gerät holt Polygon, Regel und Gruppen wie der Cat Identifier direkt vom VPS (`GET /visitor_device.cfg`, Textformat mit Schlusszeile `end`), beim Start, alle 15 min und mit der Aktion «Parameter laden». Gecacht im LittleFS (`/visitor.cfg`); ohne VPS läuft es mit dem letzten Stand. Kein neuer Kartentyp im Manager nötig.
- **Scharf/Aus als Einstellung `stgArmed` (13)** statt eigenem Kommando: der VPS setzt sie mit `cmdSetSetting` absolut, der Zustand kommt per `settingsReport` zurück und ist im NVS gespeichert. Der Knopf am Gerät schaltet um.
- **Rückmeldungen** als Debug-Text («Besucherlicht: …») im VPS, im Tab «Besucher» gefiltert angezeigt.

Ablauf im Gerät (`visitorRule.ino`):
1. Jede `visitorObserved` geht in die Spurbildung, nur Meldungen im Polygon zählen (wie `visitor.py`).
2. Auslösung nur wenn scharf **und** aktive Zeit. Dann `GET /groups` der Bridge: brennt eine Zuhause-Gruppe → nichts tun (30 s nicht neu fragen). Sonst Licht-Gruppen ein, **nur ein/aus**: die Lampen kommen mit ihrer zuletzt eingestellten Helligkeit und Farbe (User 2026-10-29: ein Alarm darf nichts verstellen).
3. Solange das Licht «mir gehört», alle 5 s nachsehen: ist eine Licht-Gruppe nicht mehr ganz an oder wurden Helligkeit/Farbe geändert → freigeben, erst wieder einschalten, wenn das Polygon 30 s leer war. Brennt eine andere Zuhause-Gruppe → freigeben (jemand ist heimgekommen).
4. Jede Meldung im Polygon verlängert auf «jetzt + `on_s`». Danach aus, wenn es noch genau so brennt.
5. Ausschalten der Anlage gibt ein brennendes Licht frei (es bleibt an).

Anzeige: rot «SCHARF» (volle Helligkeit, fällt auf) / schwarz «AUS» (gedimmt), beim Start blau blinkend, solange das WLAN gesucht wird, darunter aktive Zeit, Licht mit Restzeit, Hue-Zustand, letzter Besuch, Herkunft der Konfiguration.
