smily77/CatFind/EPF1/Schema_EPF1.pdf

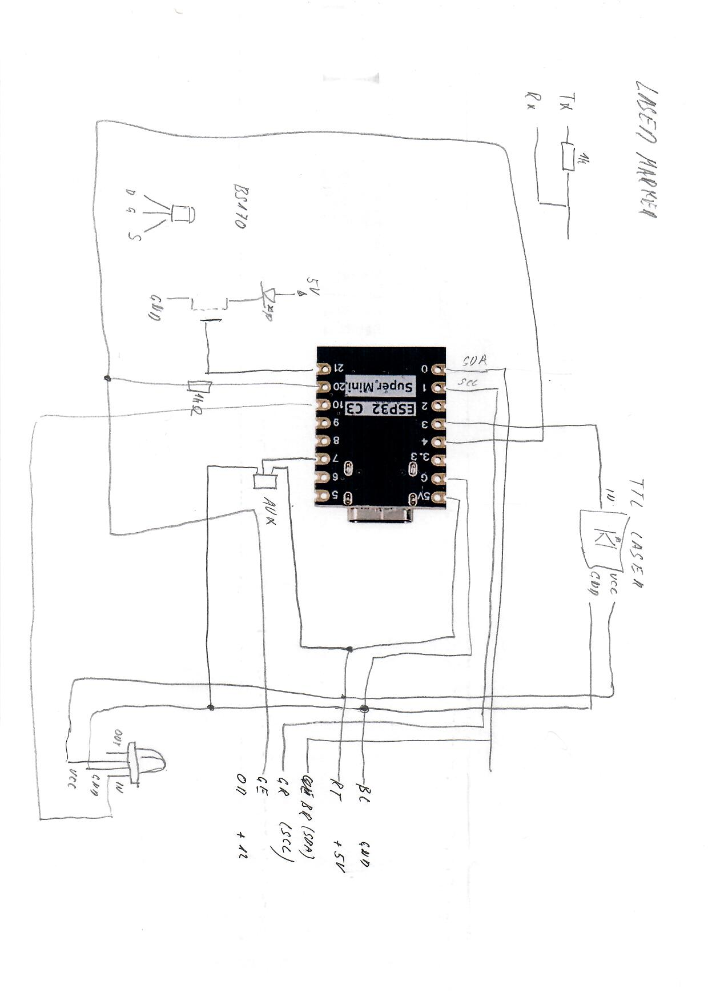
[picture p3: page 1]
