smily77/CatFind/Map/karte_022_90grad_ausgleichsgeraden_gewichtet.png

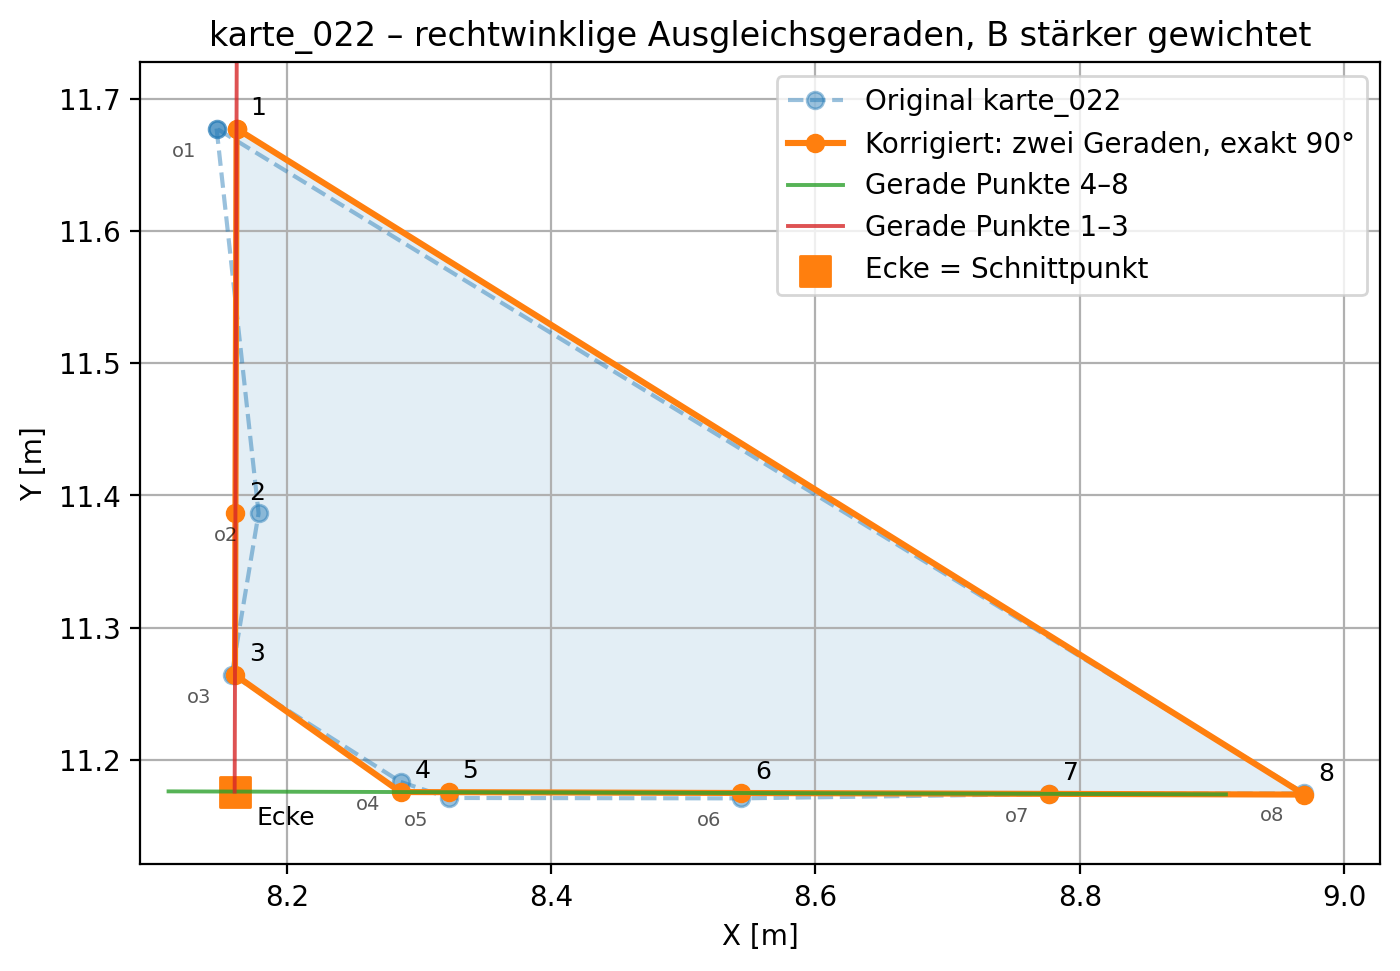
Map/karte_022_90grad_ausgleichsgeraden_gewichtet.png
