smily77/CatFind/Map/karten_015_013b_overlay.png

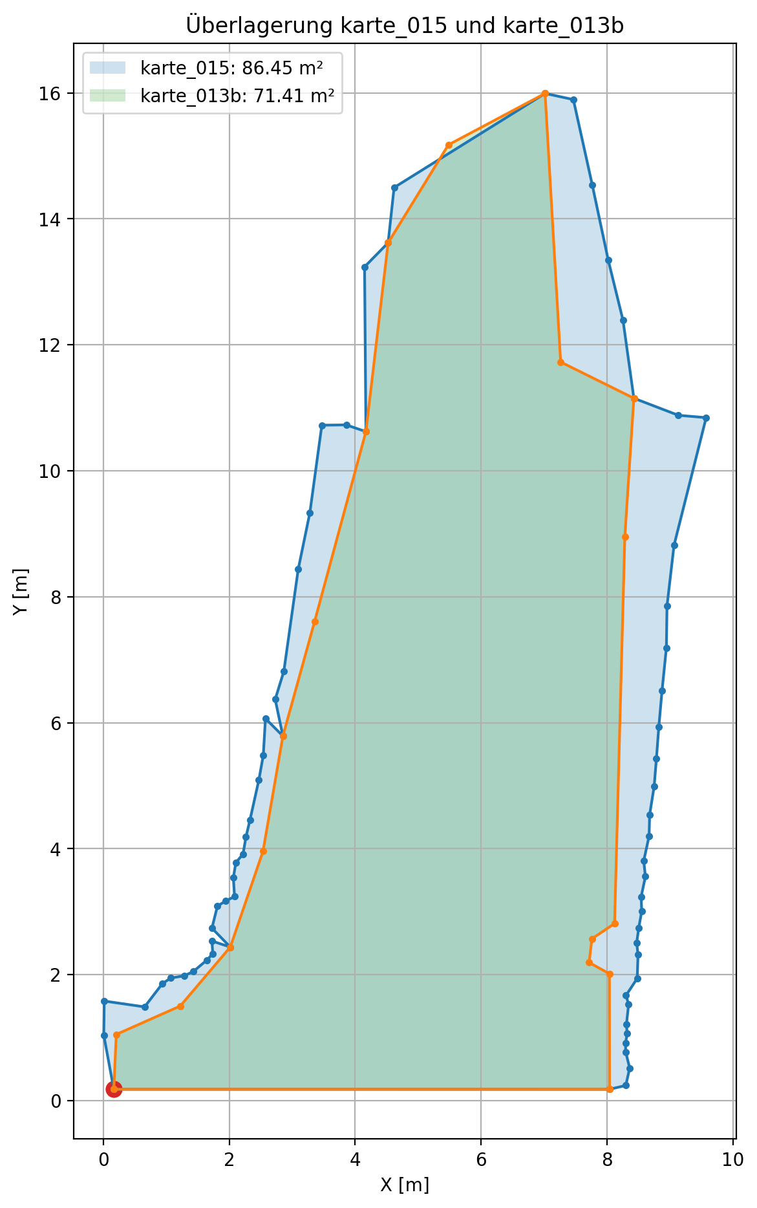
Map/karten_015_013b_overlay.png
