smily77/CatFind/Situations_Dokumentationen/Katze hat gekotet/image.jpg

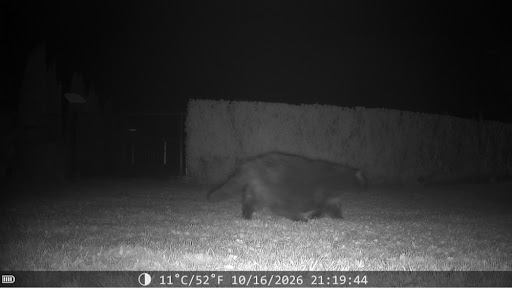
Situations_Dokumentationen/Katze hat gekotet/image.jpg
