smily77/CatFind/Situations_Dokumentationen/Normale_Katzenbewegungen/Screenshot 2026-10-17 102322.png

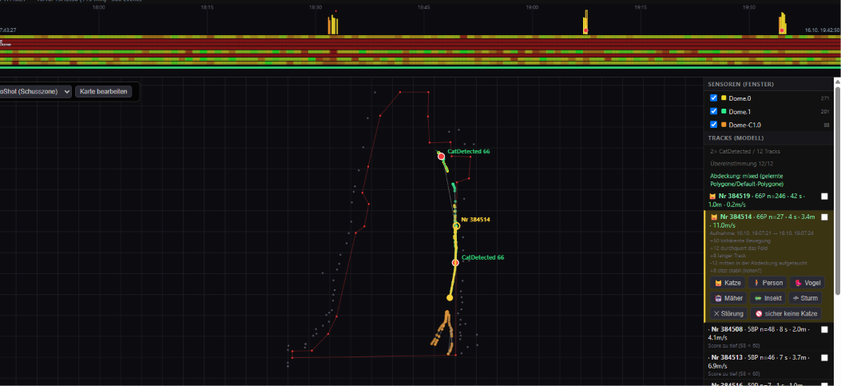
Situations_Dokumentationen/Normale_Katzenbewegungen/Screenshot 2026-10-17 102322.png
