smily77/CatFind/CF_LidarC1/C1Lidar6_3_0/hwDef.h

// hwDef.h -- C1Lidar6_3_0 (RPLidar C1, welt-faehiger CatFinder-Sensor)

// --- Hardware ---
#define LED_PIN        9          // 2x WS2812 Status-Pixel
#define pixelPin       LED_PIN
#define pixelNum       2
#define LED_TYPE       WS2812
#define COLOR_ORDER    RGB
#define BRIGHTNESS     80
#define minPix         0
#define maxPix         1

#define LIDAR_RX_PIN   7          // Lidar TX (gelb) -> GPIO7
#define LIDAR_TX_PIN   8          // Lidar RX (gruen) -> GPIO8
#define LIDAR_BAUD     RPLIDAR_BAUD_C1   // 460800

// --- Hintergrund-/Detektionsmodell ---
#define NUM_BINS       360        // 1 Grad Aufloesung
#define MAX_RANGE_MM   12000.0f   // C1 Reichweite; auch "open/out of range"
#define CAL_TIME_MS    20000UL    // 20 s Hintergrund lernen
#define MIN_CAL_SAMPLES 5         // Mindest-Treffer je Bin
#define PERIM_MARGIN_MM 300.0f    // Ziel muss >= 0.3 m naeher als der Hintergrund sein
#define PERIM_MAX_GAP_DEG 25      // Luecken bis hierher interpolieren, sonst "open"
#define NEAR_LIMIT_MM  120.0f     // naechstes Sensorrauschen verwerfen
#define MIN_DETECT_POINTS 3       // so viele markierte Punkte je Umdrehung noetig
#define DETECT_HOLD_MS 800UL      // "detektiert" so lange halten

// --- VPS-Lokalisierung ---
#define VPS_PORT       8080
#define VPS_PATH       "/localize"
#define VPS_TIMEOUT_MS 20000      // HTTP-Timeout fuer die Pose-Anfrage
#define LOC_MIN_INLIER  0.60f     // Quality-Gate: neue VPS-Pose nur uebernehmen, wenn
                                  // conf=HOCH UND inlier_ratio >= diesem Wert (sonst NVS behalten)

// --- No-Shot-Karte ---
#define NOSHOT_PATH    "/noshot.csv"
#define MAP_WAIT_MS       4000        // so lange auf mapInfo/Chunks vom Manager warten
#define MAP_RETRY_MS     60000        // Karte nicht bekommen -> so lange bis zum naechsten Versuch
#define MAP_RECHECK_MS 3600000UL      // Fangnetz: auch mit geladener Karte stuendlich neu pruefen
                                      // (ein mapInfo-Announce kann per UDP verlorengehen - kein Resend)
#define MAP_ANNOUNCE_SLOT_MS 300      // Versatz je Geraet nach einem Announce (ID % 10 * diesen Wert -
                                      // real vergebene IDs 0-3/17-19 ergeben so verschiedene Slots)

// --- Kommunikation ---
#define periodeForHB   10000       // HB-Periode (ms)

// --- Einstellungen & Steuerung (settingsPayload / xComProc initSettings) ---------------
// Anzeige: HB-Blitz (gruen) und Detektions-LED (catObserved) schaltbar [persistiert].
// Spezialfall Lidar: Motor an/aus, Default an, NICHT persistiert (bootet immer mit laufendem
// Motor). Keine Aktionen (der Lidar lokalisiert sich selbst; group = groupNone).
#define STG_SUPPORTED ((1u<<stgHbLed)|(1u<<stgCatLed)|(1u<<stgLidarMotor))
#define STG_DEFAULT   ((1u<<stgHbLed)|(1u<<stgCatLed)|(1u<<stgLidarMotor))
#define STG_PERSIST   ((1u<<stgHbLed)|(1u<<stgCatLed))   // Motor bewusst nicht persistiert
#define STG_ACTIONS   0u
#define HB_BLINK_MS   150      // Dauer des gruenen HB-Blitzes (nur im aktiven Zustand PH_ACTIVE)

#ifndef M_PI
#define M_PI 3.14159265358979323846
#endif
#define DEG2RAD (float)(M_PI/180.0)
#define RAD2DEG (float)(180.0/M_PI)
