smily77/CatFind/Radar_HKL/Radar6_3_0/Radar6_3_0.ino

// under development
//6_3 - umgestellt auf fixen Header + variablen Payload (xComDef6_3/xComProc6_3)
//      HB geht als radarHbPayload (inkl. Totzone) raus, Beobachtungen als posPayload
//#define  CompactDomeDevice
//#define  MiniDomeDevice
//#define  DomeDevice
//#define  DomeC1Device    // wie CompactDome + BMP180 (envReport) + IR-Scheinwerfer-Sperre GPIO18
#define MiniDomeDevice

#include <xComDef6_3.h>

#include "hwDef.h"
#include <FastLED.h>
#ifdef hasBMP180
  #include "bmp180.h"
#endif

#define DEBUG true

// Co-Observation-Kalibrierung: dieses Geraet bestimmt seine Welt-Pose nicht selbst,
// sondern per gemeinsamer Beobachtung einer Person mit einem welt-posierten Sensor.
#define USE_VPS_CALIBRATE

#ifdef containLed
  CRGB leds[pixelNum];
#endif

unsigned long timer;
boolean statusLightOn = false;

posPayload obsData;

// --- Kalibrier-/Health-Parameter ------------------------------------------------------
#define CALIB_WINDOW_MS   45000   // Sammelfenster (Knopf wie Auto)
#define CALIB_MIN_INLIER  0.6f    // Quality-Gate (zusaetzlich zu confidence==HOCH)
#define AUTO_ARM_MS        3000   // so lange muss Co-Observation anliegen, bis Auto startet
#define CONCURRENT_MS      1500   // Radar-Target UND Welt-Beobachtung gelten als "gleichzeitig"
#define HEALTH_GATE_MM      600   // Welt-Residuum, ab dem die Pose als schlecht gilt
#define HEALTH_ASSOC_MM    1500   // groessere Distanz = anderes Ziel -> nicht bewerten
#define HEALTH_MAX_BAD        8   // so viele schlechte Messungen in Folge -> Pose verwerfen

// Filterkarte: standardmaessig NoShot (kleinere, ruhigere Karte - wie CatIdentifier/Lidar),
// per stgRadarFullRasen umschaltbar auf die volle RasenKarte (mehr Randdaten, z.B. fuer eine
// NoShot-Editier-Session im VPS, aber mehr Bus-/VPS-Traffic). Mit gueltiger Welt-Pose werden
// nur Ziele INNERHALB der jeweils aktiven Karte gemeldet (Nachbargrundstueck/Strasse im
// 7-m-Radarkegel erzeugen sonst Dauer-Stoerungen). Ohne Karte/Pose: alles melden.
#define NOSHOT_PATH        "/noshot.csv"
#define RASEN_PATH         "/rasen.csv"
#define MAP_WAIT_MS        6000   // so lange auf mapInfo/Chunks vom Manager warten
#define MAP_RETRY_MS      60000   // Karte nicht bekommen -> so lange bis zum naechsten Versuch
#define MAP_RECHECK_MS  3600000UL // Fangnetz: auch mit geladener Karte stuendlich neu pruefen
                                  // (ein mapInfo-Announce kann per UDP verlorengehen - kein Resend)
#define MAP_ANNOUNCE_SLOT_MS 300  // Versatz je Geraet nach einem Announce (MAP_SLOT aus hwDef.h *
                                  // diesen Wert: jede Radar-Variante hat ihren eigenen Slot,
                                  // serveMap braucht je Karte ~0,1 s)

// IR-Scheinwerfer (Dome-C1): Schalter AUS/EIN/AUTO ueber stgIrLight/stgIrAuto (xComDef6_3.h).
// AUTO: nach jeder catObserved (eigene oder von irgendeinem Sensor) so lange freigeben.
#define IR_HOLD_MS         60000
// Front-Licht (Dome): Schalter AUS/EIN/AUTO ueber stgLight/stgLightAuto (xComDef6_3.h).
// AUTO: nach jeder EIGENEN catObserved so lange an.
#define LIGHT_HOLD_MS      60000
#define LIGHT_YIELD_MS      6000  // so lange weicht das Licht einer Kalibrier-/Pose-Farbe
                                  // (die naechste HB-Runde loescht sie wieder)
// Umweltsensor (Dome-C1/BMP180): so oft selbsttaetig envReport broadcasten
#define ENV_PERIOD_MS      60000

int32_t  lastTargetX = 0, lastTargetY = 0;   // juengste eigene Detektion (fuer Health-Check)
unsigned long lastTargetMs = 0;              // wann zuletzt ein Radar-Target aktiv war
unsigned long lastWorldObsMs = 0;            // wann zuletzt eine welt-valide catObserved kam
unsigned long autoArmMs = 0;                 // seit wann Co-Observation anliegt (0 = nicht)

// Front-Licht (siehe serviceLight) - hier oben, weil processTargets/heardBeat sie lesen
bool          bootDone        = false;
bool          lightIsOn       = false;
unsigned long lightLastCatMs  = 0;
bool          lightHadCat     = false;
unsigned long lightYieldUntil = 0;

// Zwei unabhaengig gepflegte Karten-Slots (NoShot/Rasen, struct MapSlot in hwDef.h -
// Auto-Prototypen!); insideNoShot() wirkt aber immer nur auf EINEN im RAM geladenen
// Puffer (acquireMap endet intern mit loadNoShot). Deshalb nach jedem Slot-Refresh in
// serviceFilterMaps() immer neu durchsetzen, welche Karte laut aktuellem
// stgRadarFullRasen gerade aktiv sein soll - unabhaengig davon, welcher Slot zuletzt lud.
MapSlot noshotSlot, rasenSlot;
bool filterMapActive = false;   // insgesamt EINE Karte aktiv nutzbar (insideNoShot sinnvoll)?
bool activeIsRasen   = false;   // welche der beiden zuletzt in den RAM-Puffer geladen wurde

#include <xComProc6_3.h>

// coCalState/coHealth sind in xComProc6_3.h definiert -> Instanzen erst nach dem Include.
coCalState calib;                 // Sammelpuffer (Eigen-Spuren + Welt-Quellen je Sender)
coHealth   health;                // laufende Re-Validierung der Pose

void setup() {
  Serial.begin(115200);
  initPixel();
  setUpWifi(device[ID].IP);
  initMcUdp();
  initUnicast();
  initText2Udp();
  setUpOTA();
  setUpTime();
  initSettings();                    // Anzeige-/Automatik-Settings aus NVS (STG_* aus hwDef)
  // NVS-Pose laden. Das Radar wird im Normalfall NICHT bewegt (Aus/Ein), darum wird
  // einer vorhandenen gespeicherten Pose direkt vertraut (validWorldPose=true) statt jedes
  // Mal neu zu kalibrieren. Der Health-Check (coObserveCheck) verwirft sie automatisch,
  // sobald ein welt-posierter Sensor mitbeobachtet und zeigt, dass sie nicht mehr stimmt;
  // danach greift der Auto-Trigger und kalibriert neu. Ohne gespeicherte Pose bleibt es false.
  if (loadPose(myPose)) {
    myPose.validWorldPose = true;
    sendUdpTextln("Pose aus NVS uebernommen (x=" + String(myPose.worldX) +
                  " y=" + String(myPose.worldY) + ") - Health-Check prueft");
  }
  if (!LittleFS.begin(true)) sendUdpTextln("LittleFS mount FAILED - kein Karten-Cache");
  Serial2.begin(S2_baud,SERIAL_8N1,S2_RX,S2_TX);
#ifdef hasIrLight
  pinMode(IR_PIN, OUTPUT_OPEN_DRAIN);
  digitalWrite(IR_PIN, LOW);         // Start: leitet -> Scheinwerfer gesperrt, serviceIr() entscheidet
#endif
#ifdef hasBMP180
  sendUdpTextln(bmpBegin(BMP_SDA, BMP_SCL) ? "BMP180 bereit"
                                           : "BMP180 nicht gefunden - envReport ohne Werte");
#endif
  sendSettingsReport();              // Einstellungen annoncieren (Display/VPS lernen sie)
  timer = millis();  //heardBeat
  bootDone = true;                   // ab jetzt darf das Front-Licht (Statusanzeigen zuerst)
}

void loop() {
  ArduinoOTA.handle();
  heardBeat();
  if (ucDataReceived) { ucDataReceived = false; handleCommand(lastUcMsg); }
  if (mcDataReceived) { mcDataReceived = false; handleObservation(lastMcMsg); }
  if (Serial2.available()) readRadar();
  if (newDataReady) { processTargets(); newDataReady = false; }
  serviceCalibration();
  serviceFilterMaps();
  serviceIr();
  serviceLight();
  serviceEnv();
}

// Kommando per Unicast: Kalibrierfenster per Knopf/commandMsg starten.
void handleCommand(const xMsg& m) {
  if (handleCommonMsg(m)) return;    // settingsRequest/poseRequest/cmdSetSetting generisch
  if (m.header.msgCode == envRequest) { requestEnvReport(); return; }
  cmdPayload cmd;
  if (!getPayload(m, cmd)) return;
  if (cmd.cmd == cmdCopyPose) {      // Aktion: Welt-Pose aus der Gruppe uebernehmen
    lightYield();
    setPixel(minPix, 0xFFFF00);
    bool ok = copyPoseFromGroup(1500);
    setPixel(minPix, ok ? 0x00FF00 : 0xFF0000);
  }
  else if (cmd.cmd == cmdCalibrate) {
    unsigned long win = (cmd.info > 0) ? (unsigned long)cmd.info : CALIB_WINDOW_MS;
    coCalibBegin(calib, win, false);
    lightYield();
    setPixel(minPix, 0xFF00FF);   // Kalibriermodus sichtbar
    sendUdpTextln("calib Knopf: Fenster " + String(win / 1000) + "s");
  }
  else if (cmd.cmd == cmdClearPose) {
    calib.active = false;                          // evtl. laufendes Fenster abbrechen
    clearPose();                                   // NVS-Pose vergessen
    myPose.validWorldPose = false;
    myPose.worldX = 0; myPose.worldY = 0;
    health = coHealth();                           // Health-Check zuruecksetzen
    lightYield();
    setPixel(minPix, 0xFF0000);
    sendUdpTextln("Pose geloescht -> nicht lokalisiert (Neukalibrierung noetig)");
  }
}

// catObserved vom Bus: welt-posierte Beobachtungen als Referenz nutzen
// (im Fenster sammeln; sonst Health-Check der eigenen Pose).
void handleObservation(const xMsg& m) {
  if (handleCommonMsg(m)) return;    // settingsRequest/poseRequest (Broadcast) generisch
  if (m.header.msgCode == mapInfo) {  // Announce: Manager hat eine Karte angenommen (gwAcceptMap)
    // Versatz je Geraet (aus der eigenen ID): sonst fragen nach dem Announce alle
    // Sensoren im selben Moment an und der Manager kann nur einen bedienen.
    unsigned long due = millis() + MAP_ANNOUNCE_SLOT_MS * (unsigned long)MAP_SLOT;
    if (mapAnnounceOutdated(m, mapNoShot, NOSHOT_PATH)) {
      noshotSlot.loaded = false; noshotSlot.synced = false;
      noshotSlot.recheckNow = true; noshotSlot.recheckAt = due;
    }
    if (mapAnnounceOutdated(m, mapRasen,  RASEN_PATH)) {
      rasenSlot.loaded = false; rasenSlot.synced = false;
      rasenSlot.recheckNow = true; rasenSlot.recheckAt = due + MAP_ANNOUNCE_SLOT_MS * 10;
    }
    return;
  }
  if (m.header.msgCode == envRequest) { requestEnvReport(); return; }
  if (m.header.msgCode != catObserved) return;
  irNoteCat();                       // IR-AUTO: irgendein Sensor meldet ein Ziel
  if (m.header.sender == ID) return;
  posPayload obs;
  if (!getPayload(m, obs) || !obs.worldValid) return;   // nur welt-valide Quellen taugen
  lastWorldObsMs = millis();

  if (calib.active) {                                    // im Fenster: Welt-Bahn je Sender sammeln
    coCalibFeedWorld(calib, m.header.sender, obs.worldX, obs.worldY);
    return;
  }
  // Health-Check NUR bei eingeschalteter Auto-Kalibrierung: nur dann kann sich das
  // Radar nach einem Pose-Verwurf selbst wieder kalibrieren. Bei AutoCalib "aus" wuerde
  // ein (ggf. falsch assoziierter) Drift-Verdacht die Pose dauerhaft ungueltig machen.
  if (settingOn(stgAutoCalib) &&
      myPose.validWorldPose && (millis() - lastTargetMs < CONCURRENT_MS)) {
    bool drift = coObserveCheck(health, lastTargetX, lastTargetY, obs.worldX, obs.worldY,
                                HEALTH_GATE_MM, HEALTH_ASSOC_MM, HEALTH_MAX_BAD);
    if (drift) {
      myPose.validWorldPose = false; savePose(myPose);
      health = coHealth();
      sendUdpTextln("Pose-Drift erkannt -> validWorldPose=false");
    }
  }
}

// Winkelgrenze aus xComDef6_3.h (device[ID].covLeftDeg/covRightDeg, zentral fuer alle
// Geraete + VPS): HLK-2450 faltet Personen seitlich/knapp dahinter mit richtiger
// Entfernung auf ~55 Grad -> Geister (Compact Dome 2026-10-31, dort +/-45).
static bool insideAngleLimit(int16_t x, int16_t y) {
  if (y <= 0) return false;
  float deg = atan2f((float)x, (float)y) * 180.0f / PI;   // 0 = geradeaus, links negativ
  return deg >= device[ID].covLeftDeg && deg <= device[ID].covRightDeg;
}

// Eingefrorene Ziele: der HLK-2450 liefert manchmal bis ~36 s lang bitgenau denselben Punkt
// weiter, nachdem das Ziel weg ist (2026-11-01/02 bei Dome, Dome-C1 und Compact Dome; der
// PA2 hat 16x darauf geschossen). Ein echtes Ziel wackelt immer um ein paar mm (in 3 Tagen
// 7850 Laeufe mit 1 Frame, nur 30 mit 3..9). Gleicher Punkt im selben Slot laenger als
// RADAR_FREEZE_MS -> nicht mehr melden, bis er sich wieder bewegt.
#define RADAR_FREEZE_MS 500
static int16_t frzX[3], frzY[3];
static unsigned long frzSince[3];
static bool frozenTarget(int i, int16_t x, int16_t y) {
  unsigned long now = millis();
  if (x != frzX[i] || y != frzY[i]) { frzX[i] = x; frzY[i] = y; frzSince[i] = now; return false; }
  return now - frzSince[i] > RADAR_FREEZE_MS;
}

// Radar-Frame auswerten: catObserved (mit Welt-Koordinaten, falls Pose gueltig) senden,
// im Kalibrierfenster die eigenen Bahnen sammeln, juengstes Target fuer Health-Check merken.
// Mit gueltiger Welt-Pose UND geladener Filterkarte (NoShot oder RasenKarte, siehe
// serviceFilterMaps) werden Ziele AUSSERHALB davon nicht gemeldet (Nachbargrundstueck/
// Strasse); Kalibrier-Sammlung und Health-Check arbeiten weiter mit ALLEN Zielen (die
// Referenzperson koennte am Rand stehen).
void processTargets() {
  // Ruhemodus (stgActive AUS): keine Zielauswertung/-meldung, nur HB laeuft weiter.
  if (!deviceActive()) { if (!lightIsOn) setPixel(maxPix, 0x000000); return; }
  boolean validTarget = false;
  for (int i = 0; i < 3; i++) {
    if (target[i].active && (target[i].l > deadZone) &&
        insideAngleLimit(target[i].x, target[i].y) &&
        !frozenTarget(i, target[i].x, target[i].y)) {
      validTarget = true;
      obsData.x = target[i].x;
      obsData.y = target[i].y;
      obsData.radius = target[i].l;
      obsData.angle = target[i].phi;
      obsData.sensor = i;
      obsData.targetSpeed = target[i].geschw;
      obsData.res = target[i].res;
      fillWorld(obsData);                              // worldX/worldY/worldValid aus myPose
      if (calib.active) coCalibFeedLocal(calib, i, target[i].x, target[i].y);
      lastTargetX = target[i].x; lastTargetY = target[i].y; lastTargetMs = millis();
      if (obsData.worldValid && filterMapActive &&
          !insideNoShot(obsData.worldX, obsData.worldY)) {           // ausserhalb der Filterkarte
        if (obsData.worldX > 0 && obsData.worldY < 0)                // Veranda: Spin-off BurglerProtect
          broadcastMsg(visitorObserved, obsData);                    // (Polygon prueft der Empfaenger)
        continue;
      }
      broadcastMsg(catObserved, obsData);
      irNoteCat();                                     // IR-AUTO: eigenes Ziel zaehlt auch
      lightNoteCat();                                  // Licht-AUTO: nur eigene Ziele
    }
  }
  if (!lightIsOn)                                      // Licht an -> Cat-Anzeige ist ohnehin aus
    setPixel(maxPix, (validTarget && settingOn(stgCatLed)) ? 0x0000FF : 0x000000);  // Anzeige schaltbar
}

// Einen Karten-Slot beschaffen (lokaler LittleFS-Cache + Versionsabgleich beim Manager,
// sonst Download - acquireMap blockiert dabei bis MAP_WAIT_MS). Ohne Karte alle MAP_RETRY_MS
// neuer Versuch; MIT geladener Karte zusaetzlich alle MAP_RECHECK_MS ein Fangnetz-Re-Check UND
// sofort bei passendem mapInfo-Announce (recheckNow, siehe handleObservation). Liefert true,
// wenn tatsaechlich ein Beschaffungsversuch stattfand (der RAM-Puffer also frisch ueberschrieben
// wurde und die aktive Karte ggf. neu durchgesetzt werden muss).
bool serviceMapSlot(MapSlot& slot, uint8_t mapType, const char* path) {
  if (slot.recheckNow) {
    if ((long)(millis() - slot.recheckAt) < 0) return false;   // Announce-Versatz laeuft noch
  } else {
    // Nur eine ABGEGLICHENE Karte darf bis zum stuendlichen Fangnetz warten. Ohne
    // Abgleich (kein mapInfo/Download abgebrochen) laeuft der Filter womoeglich mit
    // einer veralteten Karte -> in MAP_RETRY_MS erneut versuchen.
    unsigned long dueMs = (slot.loaded && slot.synced) ? MAP_RECHECK_MS : MAP_RETRY_MS;
    if (slot.lastTry != 0 && millis() - slot.lastTry < dueMs) return false;
  }
  slot.lastTry = millis();
  slot.recheckNow = false;
  slot.loaded = acquireMap(mapType, path, device[Manager].IP, MAP_WAIT_MS);
  slot.synced = mapLastSynced;
  return true;
}

// Beide Karten unabhaengig aktuell halten, danach IMMER die laut stgRadarFullRasen aktuell
// gewuenschte Karte in den (einzigen, geteilten) RAM-Puffer laden - acquireMap() ueberschreibt
// diesen Puffer bei jedem Refresh, ganz gleich welcher Slot gerade dran war, darum reicht ein
// Slot-Refresh allein nicht: die "andere" Karte koennte danach im Puffer stehen.
void serviceFilterMaps() {
  if (!myPose.validWorldPose || calib.active) return;
  bool noshotTouched = serviceMapSlot(noshotSlot, mapNoShot, NOSHOT_PATH);
  bool rasenTouched  = serviceMapSlot(rasenSlot,  mapRasen,  RASEN_PATH);
  bool wantRasen = settingOn(stgRadarFullRasen);
  MapSlot& wantSlot = wantRasen ? rasenSlot : noshotSlot;
  if (wantRasen != activeIsRasen || noshotTouched || rasenTouched) {
    activeIsRasen = wantRasen;
    filterMapActive = wantSlot.loaded && loadNoShot(wantRasen ? RASEN_PATH : NOSHOT_PATH);
    sendUdpTextln(filterMapActive
      ? (String(wantRasen ? "RasenKarte" : "NoShot-Karte") + " aktiv - melde nur Ziele darin")
      : (String(wantRasen ? "RasenKarte" : "NoShot-Karte") + " nicht verfuegbar - melde ungefiltert"));
  }
}

// Kalibrierfenster abschliessen bzw. Auto-Trigger bedienen.
void serviceCalibration() {
  if (coCalibElapsed(calib)) {                          // Fenster zu Ende -> VPS + Quality-Gate
    lightYield();
    setPixel(minPix, 0xFFFF00);                         // "rechnet"
    bool ok = coCalibFinish(calib, CALIB_MIN_INLIER);
    setPixel(minPix, ok ? 0x00FF00 : 0xFF0000);
    autoArmMs = 0;
    return;
  }
  if (calib.active) return;                             // laeuft noch
  if (myPose.validWorldPose) return;                    // Pose schon vorhanden

  // Automatik 1: Welt-Pose aus einem Gruppenmitglied uebernehmen (falls aktiviert). Periodisch
  // versuchen, solange keine gueltige Pose vorliegt (blockiert kurz -> nicht zu haeufig).
  static unsigned long lastCopyTry = 0;
  if (settingOn(stgAutoCopyPose) && (millis() - lastCopyTry > 15000)) {
    lastCopyTry = millis();
    if (copyPoseFromGroup(800)) return;                 // uebernommen -> fertig
  }

  // Automatik 2 (Radar-Spezialfall): keine valide Pose + anhaltende Co-Observation (eigenes
  // Target UND welt-valide Beobachtung gleichzeitig) -> Kalibrierung selbsttaetig starten.
  if (settingOn(stgAutoCalib)) {
    bool concurrent = (millis() - lastWorldObsMs < CONCURRENT_MS) &&
                      (millis() - lastTargetMs   < CONCURRENT_MS);
    if (concurrent) {
      if (autoArmMs == 0) autoArmMs = millis();
      else if (millis() - autoArmMs > AUTO_ARM_MS) {
        coCalibBegin(calib, CALIB_WINDOW_MS, true);
        lightYield();
        setPixel(minPix, 0xFF00FF);
        sendUdpTextln("auto-calib gestartet (Co-Observation)");
        autoArmMs = 0;
      }
    } else {
      autoArmMs = 0;
    }
  } else {
    autoArmMs = 0;
  }
}

// --- IR-Scheinwerfer (Dome-C1) -------------------------------------------------------
// GPIO18 ist Open-Drain parallel zum LDR des Scheinwerfers: LOW (leitet) = gesperrt,
// HIGH (hochohmig) = der LDR entscheidet wie ohne Steuerung (an, wenn es dunkel ist).
// Die Nacht-Bedingung von AUTO liefert damit der Scheinwerfer selbst - die Firmware
// muss Tag/Nacht nicht kennen.
//   AUS  (stgIrLight aus)               -> immer gesperrt
//   EIN  (stgIrLight an, stgIrAuto aus) -> immer frei (Nachtlicht wie ohne Steuerung)
//   AUTO (stgIrLight an, stgIrAuto an)  -> frei fuer IR_HOLD_MS nach jeder catObserved
unsigned long irLastCatMs = 0;
bool          irHadCat    = false;

void irNoteCat() { irLastCatMs = millis(); irHadCat = true; }

void serviceIr() {
#ifdef hasIrLight
  static int8_t irFree = -1;         // -1 = noch nie gesetzt
  bool want;
  if (!settingOn(stgIrLight))     want = false;
  else if (!settingOn(stgIrAuto)) want = true;
  else want = irHadCat && (millis() - irLastCatMs < IR_HOLD_MS);
  if ((int8_t)want != irFree) {
    digitalWrite(IR_PIN, want ? HIGH : LOW);
    const char* mode = !settingOn(stgIrLight) ? "AUS" : (settingOn(stgIrAuto) ? "AUTO" : "EIN");
    if (irFree >= 0)
      sendUdpTextln(String("IR-Scheinwerfer ") + mode + ": " +
                    (want ? "frei (LDR entscheidet)" : "gesperrt"));
    irFree = want;
  }
#endif
}

// --- Front-Licht (Dome) --------------------------------------------------------------
// Die beiden Pixel strahlen beim Dome nach vorne und leuchten dann weiss mit VOLLER
// Helligkeit (255) - die Statusanzeigen bleiben bei BRIGHTNESS. Weil FastLED nur eine
// globale Helligkeit kennt, wird sie beim Ein-/Ausschalten umgestellt.
//   AUS  (stgLight aus)                  -> aus
//   EIN  (stgLight an, stgLightAuto aus) -> dauernd an
//   AUTO (stgLight an, stgLightAuto an)  -> LIGHT_HOLD_MS nach jeder EIGENEN catObserved
// Vorrang der Statusanzeigen: erst nach dem Boot (WLAN/NTP-Farben), nur wenn HB- UND
// Cat-Anzeige aus sind, nicht waehrend eines Kalibrierfensters und LIGHT_YIELD_MS nach
// einer Kalibrier-/Pose-Farbe (lightYield vor jedem solchen setPixel).
void lightNoteCat() { lightLastCatMs = millis(); lightHadCat = true; }

void lightOff() {
#ifdef containLed
  allPixel(0x000000);
  FastLED.setBrightness(BRIGHTNESS);
#endif
  lightIsOn = false;
}

// Vor einer Status-Farbe aufrufen: Licht sofort aus, Helligkeit zurueck auf BRIGHTNESS.
void lightYield() {
  lightYieldUntil = millis() + LIGHT_YIELD_MS;
  if (lightIsOn) lightOff();
}

void serviceLight() {
#ifdef hasFrontLight
  bool want = bootDone && settingOn(stgLight) && !settingOn(stgHbLed) && !settingOn(stgCatLed)
              && !calib.active && (long)(millis() - lightYieldUntil) >= 0;
  if (want && settingOn(stgLightAuto))
    want = lightHadCat && (millis() - lightLastCatMs < LIGHT_HOLD_MS);
  if (want == lightIsOn) return;
  if (want) {
    FastLED.setBrightness(255);
    allPixel(0xFFFFFF);
    lightIsOn = true;
  } else {
    lightOff();
  }
  const char* mode = !settingOn(stgLight) ? "AUS" : (settingOn(stgLightAuto) ? "AUTO" : "EIN");
  sendUdpTextln(String("Front-Licht ") + mode + ": " + (want ? "an" : "aus") +
                ((settingOn(stgLight) && (settingOn(stgHbLed) || settingOn(stgCatLed)))
                   ? " (HB-/Cat-Anzeige hat Vorrang)" : ""));
#endif
}

// --- Umweltsensor (Dome-C1/BMP180) ---------------------------------------------------
// envRequest (Unicast oder Broadcast) stoesst eine Messung an; das Ergebnis geht - wie
// die periodische Annonce alle ENV_PERIOD_MS - immer per Broadcast als envReport raus
// (der Manager reicht es an den VPS weiter). Ohne Sensor: envReport mit valid=0.
// Varianten ohne BMP180 ignorieren envRequest.
bool envPending = false;

void sendEnvReport(bool valid) {
  envPayload ep;
  ep.valid = valid ? 1 : 0;
  ep.tempDeci = 0; ep.pressPa = 0;
#ifdef hasBMP180
  if (valid) { ep.tempDeci = bmpTempDeci; ep.pressPa = (uint32_t)bmpPressPa; }
#endif
  broadcastMsg(envReport, ep);
}

void requestEnvReport() {
#ifdef hasBMP180
  if (!bmpOk && !bmpBegin(BMP_SDA, BMP_SCL)) { sendEnvReport(false); return; }
  bmpStart();                        // laeuft schon eine Messung, wird deren Ergebnis gesendet
  envPending = true;
#endif
}

void serviceEnv() {
#ifdef hasBMP180
  static unsigned long lastEnv = 0;
  if (lastEnv == 0 || millis() - lastEnv >= ENV_PERIOD_MS) {
    lastEnv = millis();
    requestEnvReport();
  }
  if (bmpService() && envPending) {
    envPending = false;
    sendEnvReport(true);
  }
#endif
}
