smily77/CatFind/Controller/Manager6_3_0/Manager6_3_0.ino

//6_3 - umgestellt auf fixen Header + variablen Payload (xComDef6_3/xComProc6_3)
#include <xComDef6_3.h>
#include "hwDef.h"
#include <FastLED.h>

#define DEBUG true
byte ID = Manager;

#define containLed
#ifdef containLed
  CRGB leds[pixelNum];
#endif

unsigned long timer;
unsigned long hbTimer = 0;
bool blinkOn = false;
bool targetAlarm = false;

#define NOSHOT_PATH "/noshot.csv"
#define RASEN_PATH  "/rasen.csv"

// Multicast-Empfangsqueue statt Single-Buffer: der AsyncUDP-Task sammelt Pakete
// auch waehrend der blockierenden Gateway-HTTP-Posts (gwFlush/gwPollCommands) -
// vorher gingen dabei ~50% der Events bei 10-Hz-Radar-Bursts verloren.
#define MC_QUEUE_LEN 24

// Dasselbe fuer Karten-Anfragen: nach jedem mapInfo-Announce fragen alle Sensoren
// gleichzeitig an. Im Single-Buffer (lastUcMsg) ueberlebte davon nur eine Anfrage,
// die uebrigen Geraete liefen still auf der ALTEN Karte weiter (bis zu 1 h, siehe
// serviceMapSlot im Radar). 8 Plaetze = mehr als es Sensoren gibt.
#define MAP_REQ_QUEUE_LEN 8

#include <xComProc6_3.h>

// Bus-Verkehr seriell mitdrucken? Bei 10 Hz kostet jede Zeile ~9 ms auf der
// 115200er-Konsole und bremst die Loop - nur fuer USB-Diagnose einschalten.
#define PRINT_BUS_TRAFFIC false

// Karten liegen NICHT mehr im Firmware-Quellcode (MapConcept.md Leitplanke 2):
// die einzige Quelle ist der VPS-Editor (Annahme-Code in gatewayProc.ino,
// gwAcceptMap()/gwFetchMap()). Ohne Karte im LittleFS antwortet der Manager auf
// mapRequest schlicht nicht (kein Seed-Sonderfall mehr, siehe serveMap()).
// Notweg ohne VPS: Controller/Manager6_3_0/data/<typ>.csv im Repo anpassen
// (Single Source of Truth), LittleFS-Image daraus neu bauen und per USB oder
// OTA flashen - Schritt-fuer-Schritt-Anleitung in KartenUpload.md.

// LittleFS mounten und den aktuellen Kartenstand (falls vorhanden) einlesen/loggen
// + annoncieren (gwAnnounceMaps - wichtig nach einem Notweg-Reflash, siehe oben).
// (Nur Funktionsaufrufe hier - gwMapVer/gwMapCrc sind Variablen aus gatewayProc.ino,
// das textuell NACH diesem Tab in den Sketch einfliesst; Arduino generiert automatische
// Prototypen nur fuer Funktionen, nicht fuer Variablen, siehe gwRefreshMapStatus().)
void ensureMaps() {
  if (!LittleFS.begin(true)) {          // true = bei Bedarf formatieren
    Serial << "LittleFS mount FAILED" << endl;
    return;
  }
  gwRefreshMapStatus();
  gwAnnounceMaps();
}

void setup() {
  Serial.begin(115200);
  initPixel();
  setUpWifi(device[ID].IP);
  initMcUdp();
  initUnicast();
  initText2Udp();
  setUpOTA();
//  setUpTime();
  ensureMaps();
  initSettings();                    // Anzeige-Settings (HB-/catObserved-Empfang) aus NVS
  sendSettingsReport();              // eigene Einstellungen annoncieren
  Serial << "ready" << endl;
}

void loop() {
  ArduinoOTA.handle();
  // Eigener HB: der Manager annonciert sich wie jedes andere Geraet (Lebenszeichen). Damit
  // erscheint er in der HB-/Aktiv-Liste und auf der VPS-Steuerseite (nur aktive Geraete).
  // gwAddHb direkt, damit der VPS ihn auch ohne Multicast-Loopback als aktiv sieht.
  if (millis() - hbTimer >= periodeForHB) {
    hbPayload hb; hb.ip = getLastIpByte(); hb.HBperiode = periodeForHB;
    broadcastMsg(HB, hb);
    gwAddHb(ID, hb.ip, 0);
    hbTimer = millis();
  }
  if (udpTextReceived) {
    udpTextReceived = false;
    Serial.print("received:" );
    Serial.println(udpTextMsg);
    gwAddDebug(udpTextMsg);            // Gateway: Debug-Zeile an den VPS
  }
  if (ucDataReceived) {
    xMsg uc = lastUcMsg;
    ucDataReceived = false;
    handleCommonMsg(uc);               // settingsRequest/cmdSetSetting (eigene Anzeige-Settings)
    if (uc.header.msgCode == vpsRequest) answerVpsRequest(lastUcSenderOctet);
  }
  // Karten-Anfragen (Unicast) bedienen: Sensor fordert No-Shot- oder RasenKarte an.
  // Sie kommen aus der eigenen Queue (siehe MAP_REQ_QUEUE_LEN) und werden hier der
  // Reihe nach beantwortet - serveMap() blockiert je Karte ~0,1 s, in dieser Zeit
  // sammelt der AsyncUDP-Task die uebrigen Anfragen weiter ein.
  {
    uint8_t reqType, reqOctet;
    while (mapReqQueuePop(reqType, reqOctet)) {
      Serial << "mapRequest type=" << reqType << " from ." << reqOctet << endl;
      if (reqType == mapNoShot)      serveMap(mapNoShot, NOSHOT_PATH, reqOctet);
      else if (reqType == mapRasen)  serveMap(mapRasen,  RASEN_PATH,  reqOctet);
    }
    uint16_t rd = mapReqQueueDropped();
    if (rd) gwAddDebug("Karten-Anfragen verworfen: " + String(rd));
  }
  {
    uint16_t qd = mcQueueDropped();    // Queue lief ueber (extremer Burst) -> sichtbar machen
    if (qd) gwAddDebug("MC-Queue voll: " + String(qd) + " Pakete verworfen");
  }
  xMsg mcMsg;
  while (mcQueuePop(mcMsg)) {
    if (PRINT_BUS_TRAFFIC) printSensorData(mcMsg);
    handleCommonMsg(mcMsg);            // settingsRequest/poseRequest generisch beantworten
    if (mcMsg.header.msgCode == vpsRequest && mcMsg.header.sender < deviceCount)
      answerVpsRequest(device[mcMsg.header.sender].IP);
    if (mcMsg.header.msgCode == catObserved || mcMsg.header.msgCode == catDetected)
      forwardToKIVision(mcMsg);        // Notbehelf: Pi empfaengt kaum Multicast (s. unten)

    if (mcMsg.header.msgCode == HB) {
      hbPayload hb;
      if (getHbPayload(mcMsg, hb)) {                                     // Gateway
        // HLK-Radare (Geraetetyp aus der device-DB, WER steht im Header) senden
        // radarHbPayload mit der eingestellten Totzone - fuers Abdeckungs-Overlay
        // an den VPS weiterreichen. getPayload prueft dabei nur noch die Groesse.
        radarHbPayload rhb; uint16_t dz = 0;
        if (device[mcMsg.header.sender].type == HLK &&
            getPayload(mcMsg, rhb) && rhb.deadZoneDist > 0) dz = (uint16_t)rhb.deadZoneDist;
        gwAddHb(mcMsg.header.sender, hb.ip, dz);
      }
      if (settingOn(stgHbLed)) {                                         // HB-Empfang-Anzeige schaltbar
        allPixel(0x00FF00);
        blinkOn = true;
        timer = millis()+ HB_blinkPeriode;
      }
    }
    else if (mcMsg.header.msgCode == catObserved) {
      posPayload pos;
      if (getPayload(mcMsg, pos)) gwAddEvent(mcMsg.header.sender, pos, false);   // Gateway
      if (settingOn(stgCatLed)) {                                        // catObserved-Empfang-Anzeige schaltbar
        allPixel(0x0000FF);
        targetAlarm = true;
        blinkOn = false;
        timer = millis()+ Alarm_blinkPeriode;
      }
    }
    else if (mcMsg.header.msgCode == visionObserved) {
      posPayload pos;                                                    // Kamera: nur zum VPS, kein Blinken
      if (getPayload(mcMsg, pos)) gwAddEvent(mcMsg.header.sender, pos, false);
    }
    else if (mcMsg.header.msgCode == visitorObserved) {
      posPayload pos;                                                    // Veranda: nur zum VPS (Tab Besucher),
      if (getPayload(mcMsg, pos)) gwAddEvent(mcMsg.header.sender, pos, true);   // getrennt von den Events
    }
    else if (mcMsg.header.msgCode == catDetected) {
      // Cat Identifier hat eine Katze bestaetigt: ROT blinken (schaltbar) + VPS-Debug.
      // Der Identifier sendet jede Detektion DOPPELT (UDP-Verlustschutz) -> identische
      // Payload innerhalb kurzer Zeit ist ein Duplikat und wird ignoriert.
      catDetectedPayload cd;
      if (getPayload(mcMsg, cd)) {
        static catDetectedPayload lastCd; static unsigned long lastCdMs = 0;
        bool dup = (millis() - lastCdMs < 1500) &&
                   memcmp(&lastCd, &cd, sizeof(cd)) == 0;
        lastCd = cd; lastCdMs = millis();
        if (!dup) {
          gwAddAct('d', mcMsg.header.sender, 1, cd.worldX, cd.worldY,
                   cd.score, cd.flags, (int32_t)cd.trackMs, cd.netMm);   // Gateway: Aktor-Kette
          gwAddDebug("CatDetected #" + String(mcMsg.header.sender) +
                     " score=" + String(cd.score) + " x=" + String(cd.worldX) +
                     " y=" + String(cd.worldY) + " net=" + String(cd.netMm) + "mm" +
                     ((cd.flags & catDetFlagStationary) ? " sitzt!" : "") +
                     ((cd.flags & catDetFlagFusion) ? " fusion" : ""));
          if (settingOn(stgCatDetLed)) {                 // catDetected-Anzeige schaltbar
            allPixel(0xFF0000);
            targetAlarm = true;
            blinkOn = false;
            timer = millis() + Alarm_blinkPeriode;
          }
        }
      }
    }
    else if (mcMsg.header.msgCode == targetDetected) {
      // Zielmodell "Sitzende Katze" (CatIdent sitModel.ino): nur an den VPS (actor_log
      // kind 'tgt', Tab Zielmodell), kein Blinken. Doppelt gesendet -> Duplikat-Filter.
      catDetectedPayload td;
      if (getPayload(mcMsg, td)) {
        static catDetectedPayload lastTd; static unsigned long lastTdMs = 0;
        bool dup = (millis() - lastTdMs < 1500) && memcmp(&lastTd, &td, sizeof(td)) == 0;
        lastTd = td; lastTdMs = millis();
        if (!dup) {
          gwAddAct('t', mcMsg.header.sender, 1, td.worldX, td.worldY,
                   td.score, td.flags, (int32_t)td.trackMs, td.netMm);
          gwAddDebug("TargetDetected #" + String(mcMsg.header.sender) + " sitzt " +
                     String(td.score) + "s x=" + String(td.worldX) + " y=" + String(td.worldY) +
                     ((td.flags & catDetFlagCorridor) ? " Korridor" : ""));
        }
      }
    }
    else if (mcMsg.header.msgCode == fireInhibit) {
      fireInhibitPayload fi;                                             // Gateway: Feuersperre (Aktor-Kette)
      if (getPayload(mcMsg, fi))
        gwAddAct('i', mcMsg.header.sender, fi.worldValid, fi.worldX, fi.worldY,
                 fi.reason, (int32_t)fi.holdMs, fi.score, 0);
    }
    else if (mcMsg.header.msgCode == catHit) {
      posPayload hit;                                                    // Gateway: Schuss eines Aktors
      if (getPayload(mcMsg, hit))
        gwAddAct('h', mcMsg.header.sender, hit.worldValid, hit.worldX, hit.worldY,
                 (int32_t)hit.angle, (int32_t)hit.radius, hit.res, 0);
    }
    else if (mcMsg.header.msgCode == settingsReport) {
      settingsPayload sp;
      if (getPayload(mcMsg, sp)) gwAddSettings(mcMsg.header.sender, sp); // Gateway: an VPS weiterreichen
    }
    else if (mcMsg.header.msgCode == envReport) {
      envPayload ep;                                                     // Gateway: Temperatur/Luftdruck
      if (getPayload(mcMsg, ep)) gwAddEnv(mcMsg.header.sender, ep);      // (Dome-C1) an den VPS
    }
    else if (mcMsg.header.msgCode == poseReport) {
      worldPosePayload wp;                                               // Gateway: Welt-Posen an den VPS
      if (getPayload(mcMsg, wp) && mcMsg.header.sender != ID)            // (fuer die Erfassungssektoren)
        gwAddPose(mcMsg.header.sender, wp);
    }
  }
  gwTick();                            // Gateway: gepufferte Ereignisse periodisch an den VPS posten
  if (blinkOn && (millis()> timer)) {
    allPixel(0x000000);
    blinkOn = false;
  }
  if (targetAlarm && (millis()> timer)) {
    allPixel(0x000000);
    targetAlarm = false;
  }

}

// Notbehelf (2026-10-23): Der KIVision-Pi empfaengt im WLAN kaum Multicast - sein
// Onboard-WLAN erreicht den AP nur knapp, Gruppen-Pakete werden nie wiederholt,
// Unicast schon. Ziel-Meldungen deshalb zusaetzlich UNVERAENDERT (Original-Absender
// und -Zeitstempel) per Unicast an den Pi. Der Pi verwirft doppelte Kopien selbst.
// Rein additiv: ohne Manager bekommt der Pi sie weiter nur per Multicast.
// vpsRequest: VPS-Adresse (ipVPS aus Credentials.h) an den Fragenden; ohne bekannte IP
// (DHCP-Geraet ohne Eintrag) als Broadcast.
void answerVpsRequest(uint8_t octet) {
  vpsPayload v;
  v.ip0 = ipVPS[0]; v.ip1 = ipVPS[1]; v.ip2 = ipVPS[2]; v.ip3 = ipVPS[3];
  v.port = 80;
  if (octet) unicastMsg(vpsReport, v, octet);
  else       broadcastMsg(vpsReport, v);
}

void forwardToKIVision(const xMsg &m) {
  uint8_t octet = device[KIVision].IP;
  if (octet == 0 || m.header.sender == KIVision) return;
  if (m.header.payloadLen > maxPayloadLen) return;
  udpUc.writeTo((const uint8_t*)&m, sizeof(msgHeader) + m.header.payloadLen,
                IPAddress(192, 168, 0, octet), UC_PORT);
}
