smily77/CatFind/KIVisionCatLocator/kivision_web.py

#!/usr/bin/env python3
"""KIVisionCatLocator - Kamera-Webserver (Phase 2) und Busgeraet (Phase 3).

Liefert ein MJPEG-Livebild der OV5647 im Browser, erlaubt das Verstellen der
wichtigsten Kamera-Parameter, macht Schnappschuesse (Stream-Aufloesung oder
volle 5 MP) und kann optional den Coral zuschalten, um direkt am Montageort zu
pruefen, ob eine Katze von dort ueberhaupt erkannt wird.

Seit Phase 3 ist dasselbe Programm auch Geraet 20 ("KIVision") auf dem
CatFinder-Bus (kivision_bus.py / xcom.py): HB, settingsReport, Steuerung aus
dem VPS-Tab "Steuerung" (KI an/aus, Ruhemodus, Neustart).
"""

import base64
import io
import json
import math
import os
import socket
import subprocess
import threading
import time
import traceback
from datetime import datetime
from pathlib import Path

import numpy as np
from flask import Flask, Response, jsonify, render_template, request, send_from_directory

from kivision_cammodel import CameraModel
from kivision_homography import Homography, pairs as load_pairs, _read_poly, write_atomic
from kivision_eyes import Eyes
from kivision_mower import DockWatch
from kivision_motion import Motion, cv2
from picamera2 import Picamera2
from picamera2.encoders import JpegEncoder
from picamera2.outputs import FileOutput

BASE = Path(__file__).resolve().parent
HOME = Path(os.environ.get("KIVISION_HOME", Path.home() / "kivision"))
SNAP_DIR = HOME / "snapshots"
HIT_DIR = HOME / "hits"
RADAR_DIR = HOME / "radar"
MODEL_DIR = HOME / "models"
CONFIG_FILE = HOME / "web_config.json"
MAX_SNAPSHOTS = 200
# Treffer-Bilder entstehen von selbst. Der Deckel ist deshalb knapp: 60 Bilder
# sind bei einer Minute Mindestabstand rund eine Stunde Rueckschau, mehr will
# beim Justieren niemand durchblaettern - das aelteste faellt danach raus.
MAX_HITS = 60
# Radar-Bilder: ausgeloest vom Bus (catObserved/catDetected), NICHT vom Modell.
# Sie zeigen, ob die Katze, die das Radar gerade verfolgt, ueberhaupt im Bild
# war und was das Modell dort sah - auch wenn es weit unter der Schwelle lag.
# Hoechstens WIT_SHOTS Bilder je Radar-Episode, im Abstand WIT_EVERY.
MAX_RADAR = 150
SAVE_WIDTH = 1640          # Treffer-/Radar-/Bewegungs-Bilder (KI-Bild ist groesser)
# Bewegungs-Bilder: eins je bewegter Spur (mit eingezeichnetem Weg), zum
# Nachjustieren der Bewegungserkennung. Hoechstens alle MOTION_GAP Sekunden,
# sonst fuellt ein Vogelschwarm die Karte.
MOTION_DIR = HOME / "motion"
MAX_MOTION = 150
# Vorschaubilder fuer die Galerien: je Ordner ein Unterordner .thumbs mit
# gleichem Dateinamen. Die vollen Bilder (250-480 kB) machen bei 150 Stueck
# 50 MB pro Galerie - die Vorschau ist rund 20x kleiner. Das volle Bild gibt
# es weiterhin per Klick.
THUMB_WIDTH = 360
# Radar-Bilder gehen zusaetzlich klein auf den VPS (POST /photo, wie die Cat Cam)
# und erscheinen dort beim Track im Analyse-Tab - als Beleg fuers Klassifizieren.
# Je Bild eine Uebersicht und, wenn die Rasenposition bekannt ist, ein Ausschnitt
# um das Ziel aus dem vollen KI-Bild. Klein halten: das Pi-WLAN schafft ~60 kB/s.
# VPS-Adresse: steht bewusst NICHT im Repo. Der Pi lernt sie vom Manager (vpsRequest/
# vpsReport, ipVPS aus dessen Credentials.h) und merkt sie sich in VPS_FILE. Uebersteuern
# per Umgebung KIVISION_VPS (z.B. "http://1.2.3.4"). Ohne Adresse keine VPS-Uploads -
# Bus, Personensperre und Bilder auf dem Pi laufen trotzdem.
VPS_FILE = HOME / "vps.json"
_vps_base = [os.environ.get("KIVISION_VPS", "").rstrip("/")]


def _vps_load():
    if _vps_base[0]:
        print("[web] VPS aus Umgebung: %s" % _vps_base[0], flush=True)
        return
    try:
        _vps_base[0] = json.loads(VPS_FILE.read_text())["base"]
        print("[web] VPS gespeichert: %s" % _vps_base[0], flush=True)
    except (OSError, ValueError, KeyError):
        print("[web] VPS-Adresse noch unbekannt - frage den Manager", flush=True)


def _vps_learned(ip, port):
    """vpsReport vom Manager: Adresse uebernehmen und dauerhaft speichern."""
    if os.environ.get("KIVISION_VPS"):
        return                      # Umgebung hat Vorrang
    base = "http://%s" % ip + ("" if port in (0, 80) else ":%d" % port)
    if base == _vps_base[0]:
        return
    _vps_base[0] = base
    try:
        tmp = VPS_FILE.with_suffix(".tmp")
        tmp.write_text(json.dumps({"base": base, "t": round(time.time())}))
        tmp.replace(VPS_FILE)
    except OSError as exc:
        print("[web] VPS-Adresse nicht gespeichert: %s" % exc, flush=True)
    print("[web] VPS-Adresse vom Manager gelernt: %s" % base, flush=True)


def vps_url(path):
    """Volle URL auf dem VPS oder None, solange keine Adresse bekannt ist."""
    return _vps_base[0] + path if _vps_base[0] else None
VPS_WIDTH = 1024
VPS_CROP = 0.22            # Ausschnittbreite als Anteil der Bildbreite (4:3)
VPS_QUEUE = 16             # mehr wartende Bilder -> neue verwerfen (WLAN haengt)
# Bewegte Spuren als visionObserved auf den Bus (Phase 5B): Fusspunkt ueber das
# Kamera-Modell in Rasen-mm. Bewusst NICHT catObserved - die PowerActors feuern
# auf jedes catObserved. CatIdent nimmt sie nur mit Modell-Parameter cam_feed=1.
# Je Spur hoechstens alle VISION_EVERY s; nur Spuren auf dem Rasen und schmaler
# als VISION_MAX_W (breiter = Lichtwechsel/Schatten, kein Tier und kein Mensch).
# Steht eine Spur (seit dem letzten Senden < VISION_STILL_MM), nur alle
# VISION_STILL_EVERY s - eine sitzende Katze soll sichtbar bleiben, aber nicht
# jede Sekunde dieselbe Position. Teilspuren eines Ziels (Beine, Schatten)
# naeher als VISION_MERGE_MM gehen als EIN Ziel raus (die groesste).
VISION_EVERY = 1.0
VISION_STILL_MM = 200
VISION_STILL_EVERY = 3.0
VISION_MERGE_MM = 700
VISION_MAX_W = 2500
# Leuchtende Augen nachts (kivision_eyes.py, Phase 5C): eigene Galerie, ein
# Bild je bestaetigtem Auge (hoechstens alle EYE_GAP s); auf den Bus als
# visionObserved mit sensor=EYE_SENSOR, Hoehe der Augen ueber dem Rasen fuer
# die Rasenposition. Nacht = Kamera am Anschlag (Gain) oder kaum Licht UND
# das IR-Licht der Kamera brennt: dann ist der ferne Rasen oben im Bild viel
# dunkler als die Bildmitte (gemessen 2026-10-20: Tag 1,5, Daemmerung 0,6-1,0,
# Nacht 0,23-0,27). Lux/Gain allein meldeten auch bei Tag/Daemmerung "Nacht".
EYE_DIR = HOME / "eyes"
MAX_EYES = 150
EYE_EVERY = 0.5           # s zwischen zwei ausgewerteten Bildern
EYE_GAP = 5.0
EYE_RAW_KEEP = 40         # Rohbilder (je ~1,5 MB) unter eyes/raw
EYE_VPS_EVERY = 20.0      # je Auge hoechstens so oft ein Bild zum VPS
EYE_Z = 250               # mm, Augenhoehe einer Katze
EYE_SENSOR = 1            # posPayload.sensor: 0 = Bewegung, 1 = Auge
NIGHT_LUX = 50
NIGHT_GAIN = 6.0
NIGHT_DARK_RATIO = 0.45   # Helligkeit oben / Mitte, darunter = IR-Nacht
# Sicher erkannte Person -> Feuersperre fuer alle Aktoren (fireInhibit, ablaufend)
# und Meldung an den VPS, der die Tracks dazu als "person" markiert. Echte
# Personen bei Tag lagen 2026-10-22..25 bei 80-100 %, nah im IR bei 98 %; der
# feste Fehlalarm in den Blumen oben links bei 23-28 %, Nacht-Fehlalarme bis 67 %.
# Sicher = Schwelle in need der letzten window KI-Runden (und in der aktuellen).
PERSON_EVERY = 2.0        # s zwischen zwei fireInhibit (Sperre wird so verlaengert)
PERSON_VPS_EVERY = 5.0    # s, gesammelte Sichtungen gehen gebuendelt zum VPS
PERSON_KEEP = 60          # hoechstens so viele Sichtungen warten auf den VPS
PERSON_LOG_MIN = 0.4      # ab hier jede KI-Runde mit Person ins Journal (ueber dem Blumen-Fehlalarm)
MOTION_SNAP_AGE = 1.5
MOTION_GAP = 10.0
# Radar-Ziel <-> Kamera-Fusspunkt, gleichzeitig beobachtet: Rohstoff fuer die
# Homographie (Phase 4). Eine Zeile JSON je Radar-Meldung mit Bewegung.
PAIRS_FILE = HOME / "pairs.jsonl"
PAIRS_MAX_BYTES = 20 * 1024 * 1024
# Daraus gerechnet (Knopf in der Oberflaeche, kivision_homography.py) und als
# Rasenrand/Gitter ins Livebild eingeblendet. Die Karten-CSVs werden beim
# Ausrollen aus Controller/Manager6_3_0/data/ nach web/maps/ kopiert.
HOMOGRAPHY_FILE = HOME / "homography.json"
# Kamera-Modell aus Klick-Referenzen (kivision_cammodel.py) - hat Vorrang vor
# der Homographie, weil es die vermessene Rasenkarte trifft statt das
# Koordinatensystem der Radare.
CAMMODEL_FILE = HOME / "camera_model.json"
MAP_DIR = BASE / "maps"
WIT_THRESHOLD = 0.2       # alles ab hier einzeichnen, egal welches Label
WIT_EP_GAP = 8.0          # so lange Funkstille -> naechste Meldung ist neue Episode
WIT_EP_MAX = 120.0        # Dauermeldung (Maeher, Geist) zaehlt danach als neue Episode
WIT_SHOTS = 4
WIT_EVERY = 2.0
WIT_HOLD = 3.0            # nur fotografieren, solange das Radar noch meldet
DET_STALE_S = 10.0        # so lange ohne gelungenen KI-Durchlauf -> Bild ohne KI
# Zwei getrennte Stroeme (seit 2026-10-04):
#   main  = KI-Bild in "ai_size" (Standard volle 2592x1944), geht nie ins WLAN
#   lores = Livebild in "size" (YUV420, der JPEG-Encoder kodiert es direkt) und
#           zugleich Quelle der Bewegungserkennung
# Frueher war main beides, und wer das Livebild wegen des WLANs klein hielt,
# hielt damit auch die KI klein.
#
# Die Bewegungserkennung (kivision_motion.py) rechnet auf hoechstens 820x616
# (Graubild, notfalls aus dem Livebild verkleinert): die Katze hinten am Rasen
# bleibt dort ~12x22 Pixel - genug fuer einen Fleck, ~40 ms je Bild.
MOTION_SIZE = (820, 616)
# Die OV5647 liefert volle 2592x1944 nur bis ~15 fps; darueber braucht es den
# 2x2-zusammengefassten Modus (1640x1232 oder kleiner als KI-Bild).
FULL_FPS_MAX = 15
# Ausschnitt um eine bewegte Spur: so viel Mal ihre Groesse, mindestens
# CROP_MIN_REL der Bildbreite. Nachgemessen: bei 2,5x sieht das Modell
# die Katze am ehesten als Tier; bei 4x und mehr verliert sie sich wieder.
CROP_FACTOR = 2.5
CROP_MIN_REL = 0.1         # Anteil der Bildbreite (160 px bei 1640, 259 bei 2592)
CROP_MAX_TRACKS = 3
# Was das COCO-Modell im Ausschnitt sagt, in Gruppen. "tier": auf kleinen oder
# grauen Katzen nennt es gern bear/sheep/dog/cow - zaehlt als Hinweis.
# Zweitmeinung fuer Katze vs. Fuchs (2026-10-04). Das COCO-Modell kennt gar
# keinen Fuchs - es nennt ihn dog/cat/sheep. Ein ImageNet-Klassifizierer kennt
# vier Fuchs- und fuenf Katzenklassen. Auf kleinen Zielen taugt er nicht
# (nachgemessen: Hunderassen, Dugong ...), auf der grossen Katze 13:35 sagte
# Inception-v4 immerhin lynx/tiger cat. Er kostet ~180 ms je Aufruf (inkl.
# Modellwechsel auf der Coral) - darum nur fuer bewegte Spuren ab CLS_MIN_PX
# (laengste Seite im KI-Bild) und je Spur hoechstens alle CLS_EVERY Sekunden,
# hoechstens einer je Runde. Ohne grosses Ziel kostet er also nichts.
CLS_DIR = MODEL_DIR / "classifier"
CLS_MODEL = "inception_v4_299_quant_edgetpu.tflite"
CLS_MIN_PX = 100
CLS_EVERY = 1.5
CLS_FACTOR = 1.6
CLS_MIN_SCORE = 0.15
CLS_GROUPS = {
    "fox": ("red fox", "kit fox", "arctic fox", "grey fox"),
    "cat": ("tabby", "tiger cat", "persian cat", "siamese cat", "egyptian cat", "lynx"),
}
CATEGORY = {"cat": "katze", "fox": "fuchs", "dog": "tier", "bear": "tier", "teddy bear": "tier",
            "sheep": "tier", "horse": "tier", "cow": "tier",
            "person": "person", "car": "fahrzeug", "truck": "fahrzeug",
            "bus": "fahrzeug", "motorcycle": "fahrzeug"}
SENDER_NAMES = {0: "Manager", 1: "Dome", 2: "MiniDome", 3: "CompactDome",
                17: "LidarC1", 18: "CatIdent", 19: "CatCam", 21: "DomeC1"}

# Aufloesungen: OV5647 ist 4:3 (2592x1944 voll).
SIZES = [(640, 480), (1280, 960), (1640, 1232), (2048, 1536), (2592, 1944)]

# Kamera-Controls, die die Weboberflaeche anbietet. type: bool|int|float|enum
CONTROL_SPEC = [
    {"name": "AeEnable", "label": "Belichtungsautomatik", "type": "bool", "group": "Belichtung"},
    {"name": "ExposureTime", "label": "Belichtungszeit (us)", "type": "int", "group": "Belichtung",
     "needs": {"AeEnable": False}},
    {"name": "AnalogueGain", "label": "Verstaerkung (Gain)", "type": "float", "group": "Belichtung",
     "needs": {"AeEnable": False}},
    {"name": "ExposureValue", "label": "Belichtungskorrektur (EV)", "type": "float", "group": "Belichtung",
     "needs": {"AeEnable": True}},
    {"name": "AwbEnable", "label": "Weissabgleich automatisch", "type": "bool", "group": "Farbe"},
    {"name": "AwbMode", "label": "Weissabgleich-Modus", "type": "enum", "group": "Farbe",
     "options": ["Auto", "Gluehlampe", "Leuchtstoff", "Neonlicht", "Tageslicht", "Bewoelkt", "Custom"],
     "needs": {"AwbEnable": True}},
    # ColourGains ist ein Paar; libcamera meldet dafuer Tupel-Grenzen, mit denen
    # die Oberflaeche nichts anfangen kann. Darum zwei eigene Regler mit fest
    # angegebenem Bereich, die _build_controls wieder zum Paar zusammensetzt.
    {"name": "ColourGainRed", "label": "Rot-Verstaerkung (manuell)", "type": "float", "group": "Farbe",
     "needs": {"AwbEnable": False}, "range": [0.5, 4.0], "default": 1.8},
    {"name": "ColourGainBlue", "label": "Blau-Verstaerkung (manuell)", "type": "float", "group": "Farbe",
     "needs": {"AwbEnable": False}, "range": [0.5, 4.0], "default": 1.6},
    {"name": "Brightness", "label": "Helligkeit", "type": "float", "group": "Bild"},
    {"name": "Contrast", "label": "Kontrast", "type": "float", "group": "Bild"},
    {"name": "Saturation", "label": "Farbsaettigung", "type": "float", "group": "Bild"},
    {"name": "Sharpness", "label": "Schaerfe", "type": "float", "group": "Bild"},
    {"name": "NoiseReductionMode", "label": "Rauschunterdrueckung", "type": "enum", "group": "Bild",
     "options": ["Aus", "Schnell", "Hohe Qualitaet", "Minimal", "ZSL"]},
]

DEFAULTS = {
    # Nachgemessen (20-MB-Download vom Pi): das WLAN traegt rund 29 Mbit/s -
    # die frueher angenommenen 2-3 Mbit/s waren in Wirklichkeit der Stream
    # selbst, nicht die Leitung. Die Bildrate darf deshalb hoch: jede Stufe der
    # Kette (Sensor, Encoder, Browser) kostet ein *Bild*, bei 8 fps also je
    # 125 ms. Mehr fps ist hier das wirksamste Mittel gegen die Verzoegerung.
    "size": [640, 480],        # Livebild (lores)
    "ai_size": [2592, 1944],   # KI-Bild (main)
    "fps": 20,
    "quality": 60,
    "hflip": False,
    "vflip": False,
    "rotate": 0,          # nur Browser-Anzeige (der ISP kann kein 90-Grad)
    "grid": True,
    "map": True,          # Rasenkarte per Homographie ins Livebild (Phase 4)
    "eyes": True,         # Augensuche nachts (Phase 5C)
    "eyes_force": False,  # Augensuche auch bei Tag (nur zum Testen)
    # Bewegte Spuren als visionObserved auf den Bus. Seit 2026-10-24 aus: auf dem
    # VPS fast nur Wind-Punkte, und sie fluten den Bus (~2/s). Die Bewegung
    # selbst laeuft weiter (Bewegungs-Bilder, Ausschnitte fuer die KI); Augen
    # gehen unabhaengig davon raus.
    "vision_motion": False,
    # Bewegung/Augen nur innerhalb dieser Karte (rasen | noshot): ausserhalb
    # entstehen weder Spuren noch Bilder noch visionObserved.
    "zone": "rasen",
    # Personen-Sperre (siehe PERSON_EVERY): inhibit = fireInhibit auf den Bus,
    # die VPS-Meldung (Track-Markierung) laeuft auch ohne.
    "person": {"inhibit": True, "threshold": 0.7, "need": 2, "window": 3, "hold": 60,
               "fast": 0.9},
    "tuning": "auto",    # auto | normal | noir (NoIR-Modul: Magenta bei Tag)
    "controls": {},
    "detect": {
        "enabled": False,
        "model": "",
        "threshold": 0.4,
        # Das ganze 1640er-Bild auf 300x300 geschrumpft macht eine Katze auf
        # dem Rasen 10-15 Pixel gross - weit unter dem, was SSD-MobileNet noch
        # findet (2026-09-30: keine einzige echte Katze erkannt). 4x3 Kacheln
        # holen sie auf ~40 Pixel; die Coral braucht dafuer ~0,4 s je Runde.
        "tiles": "4x3",
        # Rahmen, die mehr als diesen Anteil ihrer Kachel bedecken, verwerfen:
        # auf dem dunklen IR-Bild haelt das Modell gern die ganze Szene fuer
        # "cat"/"horse" (beide Fehlalarme vom 2026-09-29 waren bildfuellend).
        # Eine echte Katze fuellt selbst ganz vorn keine halbe Kachel.
        "max_area": 0.4,
        "interval": 0.3,
        "cat_only": True,
        # Beim Justieren laeuft niemand mit einer Katze durchs Bild: die Kamera
        # muss selbst festhalten, was sie gesehen hat. Ein Bild pro Minute
        # reicht dafuer und haelt Speicherkarte wie Galerie ueberschaubar.
        #
        # Eigener Filter, nicht der der Anzeige: nachts meldet das COCO-Modell
        # auf dem kontrastarmen Infrarotbild gern ein bildfuellendes "horse".
        # Wer sich das im Livebild ansehen will, soll sich davon nicht die
        # Galerie zumuellen lassen. off | cat | animal | all
        #
        # "animal": auf dem Graubild verwechselt COCO eine Katze leicht mit
        # dog/bear/sheep - zum Sammeln echter Katzenbilder zaehlt jedes Tier.
        "snap_mode": "animal",
        "snap_gap": 60,
    },
}


# COCO-Tierklassen, die eine Katze auf dem Rasen sein koennten (Vogel/Giraffe
# & Co. bewusst nicht). Dient nur dem Festhalten, nicht der Anzeige.
ANIMALS = ("cat", "katze", "fox", "fuchs", "dog", "bear", "teddy bear", "sheep", "horse", "cow")


def load_config():
    cfg = json.loads(json.dumps(DEFAULTS))
    try:
        stored = json.loads(CONFIG_FILE.read_text())
        for key, value in stored.items():
            if key in cfg and isinstance(cfg[key], dict) and isinstance(value, dict):
                cfg[key].update(value)
            elif key in cfg:
                cfg[key] = value
    except (OSError, ValueError):
        pass
    return cfg


def save_config(cfg):
    try:
        CONFIG_FILE.parent.mkdir(parents=True, exist_ok=True)
        write_atomic(CONFIG_FILE, json.dumps(cfg, indent=2))
    except OSError as exc:
        print("[web] Konfiguration nicht speicherbar: %s" % exc)


class StreamingOutput(io.BufferedIOBase):
    """Nimmt die JPEGs des Encoders entgegen und weckt die wartenden Clients.

    Gepuffert wird immer nur das *neueste* Bild. Ein Client, der nicht
    hinterherkommt (schwaches WLAN), ueberspringt damit Bilder, statt einen
    Rueckstau aufzubauen - Ruckeln ist besser als Verzoegerung.
    """

    def __init__(self):
        self.frame = None
        self.condition = threading.Condition()
        self.count = 0
        self.last_times = []
        self.last_bytes = []

    def write(self, buf):
        now = time.monotonic()
        with self.condition:
            self.frame = buf
            self.count += 1
            self.last_times.append(now)
            self.last_bytes.append(len(buf))
            if len(self.last_times) > 30:
                self.last_times.pop(0)
                self.last_bytes.pop(0)
            self.condition.notify_all()

    def _span(self):
        if len(self.last_times) < 2:
            return 0.0
        return self.last_times[-1] - self.last_times[0]

    def fps(self):
        with self.condition:
            span, n = self._span(), len(self.last_times)
        return round((n - 1) / span, 1) if span > 0 else 0.0

    def mbit(self):
        """Wieviel der Stream gerade erzeugen wuerde, in Mbit/s."""
        with self.condition:
            span, total = self._span(), sum(self.last_bytes[1:])
        return round(total * 8 / span / 1e6, 1) if span > 0 else 0.0

    def wait(self, last_seq, timeout=5.0):
        """Liefert (Bild, Nummer). Ist schon ein neueres da, sofort."""
        with self.condition:
            if self.count == last_seq:
                self.condition.wait(timeout)
            return self.frame, self.count


class Camera:
    """Haelt die Picamera2 und kapselt Start/Stop/Umkonfigurieren."""

    IDLE_STOP = 5.0          # Sekunden ohne Zuschauer, dann Encoder aus

    # Ein Modul ohne IR-Sperrfilter (NoIR) sieht bei Tageslicht magenta: das
    # Infrarot faellt vor allem auf die roten Pixel. Die normale Tuning-Datei
    # zwingt den Weissabgleich auf die Farbtemperatur-Kurve und kann das nicht
    # ausgleichen; die NoIR-Datei laesst ihm die noetige Freiheit.
    TUNINGS = {"auto": None, "normal": "ov5647.json", "noir": "ov5647_noir.json"}

    def __init__(self, cfg):
        self.cfg = cfg
        self.lock = threading.RLock()
        self.output = StreamingOutput()
        self.picam = self._open()
        self.limits = self._read_limits()
        self.running = False
        self.encoder = None
        self.viewers = 0
        self.idle_timer = None
        self.start()

    # -- intern ----------------------------------------------------------
    def _open(self):
        name = self.TUNINGS.get(self.cfg.get("tuning", "auto"))
        if not name:
            return Picamera2()
        try:
            cam = Picamera2(tuning=Picamera2.load_tuning_file(name))
            print("[web] Tuning-Datei: %s" % name)
            return cam
        except Exception as exc:
            print("[web] Tuning %s nicht ladbar (%s) - Standard" % (name, exc))
            return Picamera2()

    def set_tuning(self, name):
        """Tuning wird beim Oeffnen gelesen - also Kamera neu aufmachen."""
        with self.lock:
            if name not in self.TUNINGS or name == self.cfg.get("tuning"):
                return
            self.cfg["tuning"] = name
            self.stop()
            try:
                self.picam.close()
            except Exception:
                pass
            self.picam = self._open()
            self.limits = self._read_limits()
            self.start()

    def _read_limits(self):
        limits = {}
        for name, values in self.picam.camera_controls.items():
            try:
                low, high, default = values
            except (TypeError, ValueError):
                continue
            if isinstance(low, (list, tuple)) or isinstance(high, (list, tuple)):
                continue
            limits[name] = {"min": low, "max": high, "default": default}
        for spec in CONTROL_SPEC:
            if "range" in spec:                      # eigene Regler (s. o.)
                limits[spec["name"]] = {"min": spec["range"][0],
                                        "max": spec["range"][1],
                                        "default": spec["default"]}
        return limits

    def fps_max(self):
        ai = self.cfg.get("ai_size") or SIZES[-1]
        return FULL_FPS_MAX if ai[0] > 1640 else 30

    def fps(self):
        return max(1, min(int(self.cfg["fps"]), self.fps_max()))

    def _build_controls(self):
        ctrl = {}
        fps = self.fps()
        frame_us = int(1000000 / fps)
        ctrl["FrameDurationLimits"] = (frame_us, frame_us)
        for spec in CONTROL_SPEC:
            name = spec["name"]
            if name not in self.cfg["controls"] or name not in self.limits:
                continue
            value = self.cfg["controls"][name]
            if spec["type"] == "bool":
                ctrl[name] = bool(value)
            elif spec["type"] in ("int", "enum"):
                ctrl[name] = int(value)
            else:
                ctrl[name] = float(value)
        # Bei aktiver Automatik wuerde eine feste Zeit nur ignoriert - und
        # libcamera meckert, wenn beides zusammen kommt.
        if ctrl.get("AeEnable", True):
            ctrl.pop("ExposureTime", None)
            ctrl.pop("AnalogueGain", None)
        else:
            ctrl.pop("ExposureValue", None)
        red = ctrl.pop("ColourGainRed", None)
        blue = ctrl.pop("ColourGainBlue", None)
        if ctrl.get("AwbEnable", True):
            pass                                     # Automatik macht die Gains
        else:
            ctrl.pop("AwbMode", None)
            if red is not None and blue is not None:
                ctrl["ColourGains"] = (float(red), float(blue))
        return ctrl

    # -- oeffentlich ------------------------------------------------------
    def start(self):
        with self.lock:
            if self.running:
                return
            size = tuple(self.cfg.get("ai_size") or SIZES[-1])
            # Livebild = lores; darf nicht groesser als das KI-Bild sein.
            want = tuple(self.cfg["size"])
            lo = (min(want[0], size[0]), min(want[1], size[1]))
            self.lores_size = lo
            config = self.picam.create_video_configuration(
                main={"size": size, "format": "RGB888"},
                lores={"size": lo, "format": "YUV420"},
                transform=self._transform(),
                controls=self._build_controls(),
                buffer_count=3,   # weniger Puffer = weniger Verzoegerung
            )
            self.picam.configure(config)
            self.picam.start()
            self.running = True
            if self.viewers > 0:
                self._encoder_start()
            print("[web] Kamera laeuft: KI %dx%d, Livebild %dx%d @ %s fps"
                  % (size[0], size[1], lo[0], lo[1], self.fps()))

    # -- Encoder laeuft nur, solange jemand zuschaut ----------------------
    def _encoder_start(self):
        with self.lock:
            if self.encoder is not None or not self.running:
                return
            self.encoder = JpegEncoder(q=int(self.cfg["quality"]))
            self.picam.start_encoder(self.encoder, FileOutput(self.output), name="lores")

    def _encoder_stop(self):
        with self.lock:
            if self.encoder is None:
                return
            try:
                self.picam.stop_encoder()
            except Exception:
                pass
            self.encoder = None

    def add_viewer(self):
        with self.lock:
            self.viewers += 1
            if self.idle_timer is not None:
                self.idle_timer.cancel()
                self.idle_timer = None
            self._encoder_start()

    def remove_viewer(self):
        with self.lock:
            self.viewers = max(0, self.viewers - 1)
            if self.viewers == 0 and self.idle_timer is None:
                self.idle_timer = threading.Timer(self.IDLE_STOP, self._idle_stop)
                self.idle_timer.daemon = True
                self.idle_timer.start()

    def _idle_stop(self):
        with self.lock:
            self.idle_timer = None
            if self.viewers == 0:
                self._encoder_stop()
                print("[web] kein Zuschauer - Encoder aus")

    def _transform(self):
        from libcamera import Transform
        return Transform(hflip=1 if self.cfg["hflip"] else 0,
                         vflip=1 if self.cfg["vflip"] else 0)

    def stop(self):
        with self.lock:
            if not self.running:
                return
            self._encoder_stop()
            self.picam.stop()
            self.running = False

    def restart(self):
        with self.lock:
            self.stop()
            self.start()

    def apply_controls(self):
        with self.lock:
            if not self.running:
                return
            try:
                self.picam.set_controls(self._build_controls())
            except Exception as exc:
                print("[web] Controls abgelehnt: %s" % exc)

    def metadata(self):
        try:
            meta = dict(self.picam.capture_metadata())
        except Exception:
            return {}
        stamp = meta.get("SensorTimestamp")
        if stamp:
            # Wie alt ist das eben fertig gewordene Bild, wenn es hier ankommt?
            # Das ist die Verzoegerung Sensor -> Anwendung, ganz ohne WLAN und
            # ohne Browser - und damit die Antwort auf "haengt es am WLAN?".
            meta["_lag_ms"] = round((time.monotonic_ns() - stamp) / 1e6, 1)
        return meta

    def capture_array(self):
        """Aktuelles Bild als RGB-Array (picamera2 liefert RGB888 als BGR)."""
        with self.lock:
            if not self.running:
                return None
            frame = self.picam.capture_array("main")
        return frame[:, :, ::-1]

    def capture_pair(self):
        """Hauptbild (RGB) und Graubild des Zweitstroms aus *derselben*
        Aufnahme - so passen die Bewegungsrahmen exakt aufs grosse Bild."""
        with self.lock:
            if not self.running:
                return None, None
            req = self.picam.capture_request()
            try:
                main = req.make_array("main")
                lores = req.make_array("lores")
            finally:
                req.release()
        w, h = self.lores_size
        gray = lores[:h, :w]
        if w > MOTION_SIZE[0] and cv2 is not None:
            gray = cv2.resize(gray, MOTION_SIZE, interpolation=cv2.INTER_AREA)
        return main[:, :, ::-1], gray

    def snapshot(self, frame, full_res=False):
        """Schnappschuss aus dem KI-Bild (kommt von der Bildpumpe): "voll" in
        KI-Aufloesung, sonst auf Livebild-Groesse verkleinert. Der Strom muss
        dafuer nicht mehr umgeschaltet werden."""
        from PIL import Image
        if frame is None:
            raise RuntimeError("noch kein Kamerabild")
        SNAP_DIR.mkdir(parents=True, exist_ok=True)
        stamp = datetime.now().strftime("%Y%m%d_%H%M%S")
        tag = "voll" if full_res else "stream"
        path = SNAP_DIR / ("%s_%s.jpg" % (stamp, tag))
        img = Image.fromarray(frame)
        if not full_res:
            img = img.resize(tuple(self.lores_size), Image.BILINEAR, reducing_gap=2.0)
        img.save(path, "JPEG", quality=90)
        prune_snapshots()
        return path


class FramePump:
    """Holt jedes Kamerabild genau einmal ab, fuettert die Bewegungserkennung
    mit dem Graubild und haelt das neueste grosse Bild samt Spuren bereit.

    Der Detector wartet hier auf das naechste Bild, statt selbst zu holen:
    so gehoeren Bewegungsrahmen und Bild sicher zur selben Aufnahme, und die
    Kamera wird nicht von zwei Threads gleichzeitig angezapft.
    """

    def __init__(self, camera, motion):
        self.camera = camera
        self.motion = motion
        self.cond = threading.Condition()
        self.frame = None
        self.tracks = []
        self.seq = 0
        self.error = ""
        threading.Thread(target=self._run, daemon=True).start()

    def _run(self):
        while True:
            try:
                frame, gray = self.camera.capture_pair()
                if frame is None:
                    time.sleep(0.2)
                    continue
                tracks = self.motion.update(gray) if self.motion.enabled else []
                self._maybe_snap(frame)
                with self.cond:
                    self.frame, self.tracks = frame, tracks
                    self.seq += 1
                    self.error = ""
                    self.cond.notify_all()
            except Exception as exc:                          # noqa: BLE001
                self.error = "%s: %s" % (type(exc).__name__, exc)
                print("[web] Bildpumpe: %s" % self.error)
                time.sleep(1.0)

    last_snap = 0.0

    def _maybe_snap(self, frame):
        new = self.motion.claim_snap(MOTION_SNAP_AGE)
        now = time.monotonic()
        if not new or now - self.last_snap < MOTION_GAP:
            return
        self.last_snap = now
        lux = (self.camera.metadata().get("Lux") or 0)
        note = "Bewegung %s  Lux %d" % (
            ", ".join("B%d %.1fs" % (t["id"], t["age"]) for t in new), round(lux))
        # Speichern dauert ~0,1 s - nicht in der Pumpe, sonst fehlt ein Bild.
        threading.Thread(target=self._snap, args=(frame, new, note), daemon=True).start()

    @staticmethod
    def _snap(frame, tracks, note):
        try:
            path = save_hit(frame, [], note, MOTION_DIR, MAX_MOTION, name_score=0.0,
                            tracks=tracks)
            print("[web] Bewegungs-Bild: %s" % path.name)
        except Exception as exc:                              # noqa: BLE001
            print("[web] Bewegungs-Bild fehlgeschlagen: %s" % exc)

    def wait(self, last_seq, timeout=2.0):
        """(Bild, Spuren, Nummer) - das naechste nach last_seq."""
        with self.cond:
            if self.seq == last_seq:
                self.cond.wait(timeout)
            return self.frame, self.tracks, self.seq

    def latest(self):
        with self.cond:
            return self.frame, self.tracks


class Detector:
    """Optionaler Coral-Check: laeuft nur, solange er eingeschaltet ist."""

    def __init__(self, camera, cfg):
        self.camera = camera
        self.cfg = cfg
        self.lock = threading.Lock()
        self.thread = None
        self.stop_event = threading.Event()
        # set_enabled wird aus Web- und beiden Bus-Empfangsthreads gerufen;
        # der Coral-Interpreter verkraftet keine zwei Durchlaeufe gleichzeitig.
        self.enable_lock = threading.Lock()
        self.infer_lock = threading.Lock()
        self.ok_at = 0.0            # monotonic des letzten gelungenen Durchlaufs
        self.result = {"boxes": [], "ms": 0.0, "ts": 0.0, "tiles": []}
        self.error = ""
        self.hit_at = None          # monotonic der letzten Aufnahme
        self.hit_error = ""         # bleibt stehen, bis es wieder klappt
        self.hit_count = 0          # zaehlt hoch: die Oberflaeche merkt daran,
        self.hit_last = ""          # dass sie die Treffer-Galerie neu laden muss
        # Radar-Episode (siehe MAX_RADAR), Zeiten in time.monotonic()
        self.ep_start = None
        self.ep_last = 0.0
        self.ep_shots = 0
        self.ep_next = 0.0
        self.ep_force = False
        self.ep_info = ""
        self.ep_world = None
        self.ep_busy = False
        self.radar_count = 0
        self.model_path = None
        self.interpreter = None
        self.labels = {}
        self.input_size = (300, 300)
        self.motion = None          # kivision_motion.Motion (vom FramePump)
        self.pump = None            # FramePump: liefert Bild + Bewegungsspuren
        self.loops = 0
        self.cls_it = None          # ImageNet-Zweitmeinung (lazy)
        self.cls_labels = {}
        self.cls_off = ""           # Grund, falls nicht verfuegbar
        self.cls_last = {}          # Spur-Nr -> monotonic der letzten Zweitmeinung

    # -- Modell ----------------------------------------------------------
    @staticmethod
    def available_models():
        if not MODEL_DIR.is_dir():
            return []
        return sorted(p.name for p in MODEL_DIR.glob("*.tflite"))

    def _load_labels(self):
        labels = {}
        candidates = sorted(MODEL_DIR.glob("*label*.txt")) + sorted(MODEL_DIR.glob("*.txt"))
        for cand in candidates:
            try:
                for line in cand.read_text().splitlines():
                    line = line.strip()
                    if not line:
                        continue
                    parts = line.split(None, 1)
                    if len(parts) == 2 and parts[0].isdigit():
                        labels[int(parts[0])] = parts[1]
                    else:
                        labels[len(labels)] = line
            except OSError:
                continue
            if labels:
                break
        return labels

    def _ensure_model(self):
        name = self.cfg["detect"].get("model") or ""
        models = self.available_models()
        if not models:
            raise RuntimeError("Keine .tflite-Modelle in %s" % MODEL_DIR)
        if name not in models:
            name = models[0]
            self.cfg["detect"]["model"] = name
        path = MODEL_DIR / name
        if self.model_path == path and self.interpreter is not None:
            return
        from pycoral.utils.edgetpu import make_interpreter
        self.interpreter = make_interpreter(str(path))
        self.interpreter.allocate_tensors()
        shape = self.interpreter.get_input_details()[0]["shape"]
        self.input_size = (int(shape[2]), int(shape[1]))
        self.labels = self._load_labels()
        self.model_path = path
        print("[web] Modell geladen: %s (%dx%d)" % (name, self.input_size[0], self.input_size[1]))

    # -- Kacheln ---------------------------------------------------------
    @staticmethod
    def _tile_boxes(spec, width, height):
        try:
            cols, rows = (int(v) for v in spec.lower().split("x"))
        except ValueError:
            cols, rows = 1, 1
        cols = max(1, min(4, cols))
        rows = max(1, min(4, rows))
        if cols == 1 and rows == 1:
            return [(0, 0, width, height)]
        overlap = 0.15
        tw = width / (cols - overlap * (cols - 1))
        th = height / (rows - overlap * (rows - 1))
        tiles = []
        for r in range(rows):
            for c in range(cols):
                x0 = int(c * tw * (1 - overlap))
                y0 = int(r * th * (1 - overlap))
                tiles.append((x0, y0, min(int(tw), width - x0), min(int(th), height - y0)))
        return tiles

    @staticmethod
    def _resize(tile, size):
        try:
            from PIL import Image
            # reducing_gap: erst ganzzahlig verkleinern, dann fein skalieren -
            # beim 1640er-Vollbild ein Vielfaches schneller, kaum schlechter.
            return Image.fromarray(tile).resize(size, Image.BILINEAR, reducing_gap=2.0)
        except ImportError:
            import numpy as np
            ys = (np.linspace(0, tile.shape[0] - 1, size[1])).astype(int)
            xs = (np.linspace(0, tile.shape[1] - 1, size[0])).astype(int)
            return tile[ys][:, xs]

    def _detect_region(self, frame, tx, ty, tw, th, floor):
        """Ein Rechteck des grossen Bildes durchs Modell; Rahmen normiert aufs
        ganze Bild. Kacheln und Bewegungs-Ausschnitte laufen beide hierueber."""
        from pycoral.adapters import common, detect
        height, width = frame.shape[:2]
        crop = frame[ty:ty + th, tx:tx + tw]
        if crop.size == 0:
            return []
        common.set_input(self.interpreter, self._resize(crop, self.input_size))
        self.interpreter.invoke()
        # get_objects rechnet intern sx = Eingangsbreite / image_scale_x.
        # Der frueher uebergebene Massstab (Kachel/Tensor) war damit gerade
        # verkehrt herum und quetschte alle Rahmen in eine Ecke. Da die
        # Kachel den Tensor vollstaendig ausfuellt, ist image_scale hier
        # (1,1): die Rahmen kommen in Tensor-Pixeln, und wir rechnen sie
        # selbst auf die Kachel hoch und schieben sie an ihren Platz.
        sx = tw / self.input_size[0]
        sy = th / self.input_size[1]
        max_area = float(self.cfg["detect"].get("max_area", 0.4))
        tensor_area = float(self.input_size[0] * self.input_size[1])
        out = []
        for obj in detect.get_objects(self.interpreter, floor):
            label = self.labels.get(obj.id, str(obj.id))
            # Die Koordinaten sind Tensor-Pixel, der Tensor ist die Kachel.
            if (obj.bbox.width * obj.bbox.height) / tensor_area > max_area:
                continue
            x0 = clamp01((tx + obj.bbox.xmin * sx) / width)
            y0 = clamp01((ty + obj.bbox.ymin * sy) / height)
            x1 = clamp01((tx + obj.bbox.xmax * sx) / width)
            y1 = clamp01((ty + obj.bbox.ymax * sy) / height)
            if x1 <= x0 or y1 <= y0:
                continue
            out.append({"x": round(x0, 4), "y": round(y0, 4),
                        "w": round(x1 - x0, 4), "h": round(y1 - y0, 4),
                        "score": round(float(obj.score), 3), "label": label})
        return out

    @staticmethod
    def _crop_rect(track, width, height):
        """Quadratischer Ausschnitt (Pixel) um eine Bewegungsspur."""
        side = max(CROP_MIN_REL * width, CROP_FACTOR * max(track["w"] * width, track["h"] * height))
        side = int(min(side, width, height))
        cx = (track["x"] + track["w"] / 2) * width
        cy = (track["y"] + track["h"] / 2) * height
        x0 = int(min(max(0, cx - side / 2), width - side))
        y0 = int(min(max(0, cy - side / 2), height - side))
        return x0, y0, side, side

    def _infer(self, frame, full=True, tracks=()):
        height, width = frame.shape[:2]
        tiles = (self._tile_boxes(self.cfg["detect"].get("tiles", "1x1"), width, height)
                 if full else [])
        threshold = float(self.cfg["detect"].get("threshold", 0.4))
        cat_only = bool(self.cfg["detect"].get("cat_only", True))
        boxes = []
        raw = []                    # alles ab WIT_THRESHOLD, fuer Radar-Bilder
        floor = min(threshold, WIT_THRESHOLD)
        started = time.monotonic()

        def keep(box):
            raw.append(box)
            if box["score"] >= threshold and not (cat_only and not self._is_target(box["label"])):
                boxes.append(box)

        for (tx, ty, tw, th) in tiles:
            for box in self._detect_region(frame, tx, ty, tw, th, floor):
                keep(box)
        crops = []
        for tr in list(tracks)[:CROP_MAX_TRACKS]:
            rect = self._crop_rect(tr, width, height)
            crops.append(rect)
            # Wozu gehoert ein Rahmen im Ausschnitt? Zur Spur, wenn er ihren
            # Mittelpunkt (grosszuegig) enthaelt - der Ausschnitt zeigt ja
            # auch Umgebung, z. B. den Maeher neben der Katze.
            cx, cy = tr["x"] + tr["w"] / 2, tr["y"] + tr["h"] / 2
            for box in self._detect_region(frame, *rect, floor):
                mx, my = box["w"] * 0.25 + tr["w"] / 2, box["h"] * 0.25 + tr["h"] / 2
                if not (box["x"] - mx <= cx <= box["x"] + box["w"] + mx
                        and box["y"] - my <= cy <= box["y"] + box["h"] + my):
                    continue
                box["track"] = tr["id"]
                keep(box)
                cat = CATEGORY.get(box["label"].lower())
                if cat and self.motion is not None:
                    self.motion.classify(tr["id"], cat, box["score"], box["label"])
        self._second_opinion(frame, tracks, keep)
        ms = round((time.monotonic() - started) * 1000, 1)
        norm_tiles = [{"x": t[0] / width, "y": t[1] / height,
                       "w": t[2] / width, "h": t[3] / height} for t in tiles + crops]
        raw.sort(key=lambda b: b["score"], reverse=True)
        return {"boxes": boxes, "raw": raw[:12], "ms": ms, "ts": time.time(),
                "tiles": norm_tiles}

    # -- Zweitmeinung Katze/Fuchs -----------------------------------------
    def _ensure_cls(self):
        if self.cls_it is not None:
            return True
        if self.cls_off:
            return False
        path = CLS_DIR / CLS_MODEL
        try:
            from pycoral.utils.edgetpu import make_interpreter
            labels = {}
            for i, line in enumerate((CLS_DIR / "imagenet_labels.txt").read_text().splitlines()):
                labels[i] = line.split(",")[0].strip().lower()
            it = make_interpreter(str(path))
            it.allocate_tensors()
        except Exception as exc:                              # noqa: BLE001
            self.cls_off = "%s: %s" % (type(exc).__name__, exc)
            print("[web] Zweitmeinung Katze/Fuchs aus: %s" % self.cls_off)
            return False
        self.cls_it, self.cls_labels = it, labels
        print("[web] Zweitmeinung Katze/Fuchs geladen: %s" % CLS_MODEL)
        return True

    def _second_opinion(self, frame, tracks, keep):
        """Grosse bewegte Spur -> ImageNet: Katze oder Fuchs? Hoechstens eine je
        Runde; der Befund geht als Rahmen (label cat/fox) wie jeder andere in
        Livebild, Treffer und Spur ein."""
        if not tracks or not self._ensure_cls():
            return
        from pycoral.adapters import classify, common
        height, width = frame.shape[:2]
        now = time.monotonic()
        for tr in tracks:
            px = max(tr["w"] * width, tr["h"] * height)
            if px < CLS_MIN_PX or now - self.cls_last.get(tr["id"], 0.0) < CLS_EVERY:
                continue
            self.cls_last[tr["id"]] = now
            side = int(min(CLS_FACTOR * px, width, height))
            cx = (tr["x"] + tr["w"] / 2) * width
            cy = (tr["y"] + tr["h"] / 2) * height
            x0 = int(min(max(0, cx - side / 2), width - side))
            y0 = int(min(max(0, cy - side / 2), height - side))
            crop = frame[y0:y0 + side, x0:x0 + side]
            common.set_input(self.cls_it, self._resize(crop, common.input_size(self.cls_it)))
            self.cls_it.invoke()
            top = classify.get_classes(self.cls_it, 5, 0.0)
            sums = {g: sum(c.score for c in top if self.cls_labels.get(c.id) in names)
                    for g, names in CLS_GROUPS.items()}
            group = max(sums, key=sums.get)
            score = float(sums[group])
            print("[web] Zweitmeinung B%d (%d px): %s -> %s" % (
                tr["id"], px, ", ".join("%s %d%%" % (self.cls_labels.get(c.id, c.id),
                                                     round(c.score * 100)) for c in top[:3]),
                ("%s %d%%" % (group, round(score * 100))) if score >= CLS_MIN_SCORE else "-"))
            if score >= CLS_MIN_SCORE:
                keep({"x": tr["x"], "y": tr["y"], "w": tr["w"], "h": tr["h"],
                      "score": round(score, 3), "label": group, "track": tr["id"],
                      "src": "imagenet"})
                if self.motion is not None:
                    self.motion.classify(tr["id"], CATEGORY[group], score, group)
            break
        if len(self.cls_last) > 200:
            for tid in sorted(self.cls_last, key=self.cls_last.get)[:100]:
                del self.cls_last[tid]

    # -- Treffer festhalten ------------------------------------------------
    @staticmethod
    def _is_cat(label):
        low = str(label).lower()
        return "cat" in low or "katze" in low

    @staticmethod
    def _is_target(label):
        """Wogegen sich die Anlage richtet: Katze oder Fuchs."""
        low = str(label).lower()
        return Detector._is_cat(low) or "fox" in low or "fuchs" in low

    @staticmethod
    def _is_animal(label):
        return str(label).lower() in ANIMALS

    def _maybe_hit(self, frame, result):
        """Speichert hoechstens alle snap_gap Sekunden ein Bild eines Treffers.

        Der Mindestabstand zaehlt ab der letzten Aufnahme, nicht ab dem letzten
        Treffer: eine Katze, die zehn Minuten im Bild sitzt, liefert zehn
        Bilder, keine tausend. Gezeichnet wird nur, was ausgeloest hat.
        """
        det = self.cfg["detect"]
        mode = det.get("snap_mode", "cat")
        if mode == "off" or not result["boxes"]:
            return
        keep = {"all": lambda label: True, "animal": self._is_animal}.get(mode, self._is_target)
        boxes = [b for b in result["boxes"] if keep(b["label"])]
        if not boxes:
            return
        gap = max(5.0, float(det.get("snap_gap", 60)))
        now = time.monotonic()
        if self.hit_at is not None and now - self.hit_at < gap:
            return
        meta = self.camera.metadata()
        note = "Lux %s  Bel. %s ms  Gain %s" % (
            round(meta.get("Lux") or 0, 1),
            round((meta.get("ExposureTime") or 0) / 1000.0, 1),
            round(meta.get("AnalogueGain") or 0, 1))
        try:
            path = save_hit(frame, boxes, note)
        except Exception as exc:
            # Ein missgluecktes Treffer-Bild darf die Erkennung nicht anhalten.
            # Die Meldung bleibt aber stehen - sonst uebermalt sie der naechste
            # geglueckte Durchlauf, und niemand erfaehrt vom fehlenden Bild.
            with self.lock:
                self.hit_error = "Treffer-Bild: %s" % exc
                self.hit_at = now
            print("[web] Treffer-Bild fehlgeschlagen: %s" % exc)
            return
        with self.lock:
            self.hit_at = now
            self.hit_count += 1
            self.hit_last = path.name
            self.hit_error = ""
        print("[web] Treffer festgehalten: %s (%d Rahmen)" % (path.name, len(boxes)))

    # -- Radar-Bilder ------------------------------------------------------
    def radar_event(self, info, force=False, world=None):
        """Vom Bus: ein Sensor meldet ein Ziel (catObserved) bzw. das Modell
        hat eine Katze bestaetigt (catDetected, force=True -> sofort ein Bild).

        Laeuft die KI, macht der Erkennungs-Thread das Bild beim naechsten
        Durchlauf (mit allen Rahmen ab WIT_THRESHOLD). Ist sie aus, wird das
        nackte Bild direkt abgelegt - es zeigt dann wenigstens, ob die Katze
        im Bild war.
        """
        now = time.monotonic()
        with self.lock:
            if (self.ep_start is None or now - self.ep_last > WIT_EP_GAP
                    or now - self.ep_start > WIT_EP_MAX):
                self.ep_start = now
                self.ep_shots = 0
                self.ep_next = now
            self.ep_last = now
            self.ep_info = info
            self.ep_world = world
            if force:
                self.ep_force = True
            # Nur ein Erkennungs-Thread, der auch Ergebnisse liefert, macht das
            # Bild selbst - scheitert etwa das Modell, gibt es das nackte Bild.
            running = (self.thread is not None and self.thread.is_alive()
                       and now - self.ok_at < DET_STALE_S)
            due = not running and not self.ep_busy and self._witness_due(now)
            if due:
                self.ep_busy = True
        if due:
            threading.Thread(target=self._witness_plain, daemon=True).start()

    def _witness_due(self, now):
        """Unter self.lock: soll jetzt ein Radar-Bild entstehen?"""
        if self.ep_start is None or now - self.ep_last > WIT_HOLD:
            return False
        if self.ep_force:
            return True
        return self.ep_shots < WIT_SHOTS and now >= self.ep_next

    def _witness_take(self, now):
        """Unter self.lock: Episode weiterzaehlen, Text der Fusszeile liefern."""
        self.ep_force = False
        self.ep_shots += 1
        self.ep_next = now + WIT_EVERY
        return (self.ep_info, self.ep_world), self.ep_shots

    def _witness_plain(self):
        try:
            # Naechstes Bild der Pumpe abwarten - das neueste kann schon eine
            # Weile alt sein, wenn die Meldung genau dazwischen kam.
            frame, tracks, _seq = self.pump.wait(self.pump.seq)
            if frame is not None:
                with self.lock:
                    info, shot = self._witness_take(time.monotonic())
                self._save_witness(frame, None, info, shot, tracks)
        finally:
            with self.lock:
                self.ep_busy = False

    def _maybe_witness(self, frame, raw, tracks=()):
        now = time.monotonic()
        with self.lock:
            if self.ep_busy or not self._witness_due(now):
                return
            info, shot = self._witness_take(now)
        self._save_witness(frame, raw, info, shot, tracks)

    def _save_witness(self, frame, raw, info, shot, tracks=()):
        cats = [b["score"] for b in (raw or []) if self._is_target(b["label"])]
        best = max(cats) if cats else 0.0
        if raw is None:
            model = "KI aus"
        elif raw:
            model = "bestes: %s %d%%" % (raw[0]["label"], round(raw[0]["score"] * 100))
        else:
            model = "Modell: nichts ab %d%%" % round(WIT_THRESHOLD * 100)
        info, world = info
        note = "%s  Bild %d  %s" % (info, shot, model)
        if tracks:
            note += "  Bew. %d" % len(tracks)
        try:
            # Der Name traegt die beste KATZEN-Sicherheit (0 = keine Katze),
            # nicht die des staerksten Rahmens - danach sortiert man hinterher.
            path = save_hit(frame, raw or [], note, RADAR_DIR, MAX_RADAR, name_score=best,
                            tracks=tracks)
        except Exception as exc:                              # noqa: BLE001
            print("[web] Radar-Bild fehlgeschlagen: %s" % exc)
            return
        with self.lock:
            self.radar_count += 1
        print("[web] Radar-Bild: %s (%s)" % (path.name, note))
        vps_upload(path, frame, world, best)

    # -- Thread ----------------------------------------------------------
    def _run(self, stop):
        seq = -1
        while not stop.is_set():
            pause = max(0.05, float(self.cfg["detect"].get("interval", 0.3)))
            try:
                frame, tracks, seq = self.pump.wait(seq)
                if frame is None:
                    stop.wait(0.2)
                    continue
                with self.infer_lock:
                    if stop.is_set():
                        break
                    self._ensure_model()
                    result, raw = self._pass(frame, tracks)
                self.ok_at = time.monotonic()
                with self.lock:
                    self.result = result
                    self.error = ""
                persons.feed(raw)
                mower.feed(raw)
                self._maybe_hit(frame, result)
                self._maybe_witness(frame, raw, result["motion"])
                if tracks:
                    pause = 0.0             # gleich aufs naechste Bild warten
            except Exception as exc:
                with self.lock:
                    self.error = "%s: %s" % (type(exc).__name__, exc)
                print("[web] Erkennung fehlgeschlagen: %s" % exc)
                stop.wait(2.0)
            if pause:
                stop.wait(pause)

    def _pass(self, frame, tracks):
        """Ein Erkennungsdurchlauf (unter self.infer_lock)."""
        # Bewegt sich etwas, zaehlt Tempo: nur die Ausschnitte um die
        # Spuren (je ~25 ms), das ganze Kachelraster (~0,4 s) nur noch
        # jede vierte Runde. Sonst wie bisher das ganze Bild.
        self.loops += 1
        full = not tracks or self.loops % 4 == 0
        result = self._infer(frame, full, tracks)
        raw = result.pop("raw", [])
        result["motion"] = self.motion.moving() if self.motion else []
        return result, raw

    def set_enabled(self, enabled):
        # Jeder Lauf hat sein eigenes Stopp-Ereignis: ein gerade gestoppter
        # Durchlauf darf durch schnelles Wiedereinschalten nicht weiterlaufen.
        with self.enable_lock:
            if enabled and (self.thread is None or not self.thread.is_alive()):
                self.stop_event = threading.Event()
                self.thread = threading.Thread(target=self._run, args=(self.stop_event,),
                                               daemon=True)
                self.thread.start()
            elif not enabled and self.thread is not None:
                self.stop_event.set()
                self.thread = None
                with self.lock:
                    self.result = {"boxes": [], "ms": 0.0, "ts": 0.0, "tiles": []}

    def snapshot_state(self):
        gap = max(5.0, float(self.cfg["detect"].get("snap_gap", 60)))
        with self.lock:
            data = dict(self.result)
            data["error"] = self.error or self.hit_error
            data["hits"] = self.hit_count
            data["hit_last"] = self.hit_last
            data["radar"] = self.radar_count
            data["motion_status"] = self.motion.status() if self.motion else None
            # Wieviel Sperrzeit noch laeuft - damit die Oberflaeche erklaeren
            # kann, warum ein sichtbarer Rahmen gerade kein Bild ergibt.
            data["hit_wait"] = (0 if self.hit_at is None
                                else max(0, round(gap - (time.monotonic() - self.hit_at))))
        data["running"] = self.thread is not None and self.thread.is_alive()
        return data


def clamp01(value):
    return max(0.0, min(1.0, value))


def thumb_of(path):
    return path.parent / ".thumbs" / path.name


def unlink_with_thumb(path):
    for target in (path, thumb_of(path)):
        try:
            target.unlink()
        except OSError:
            pass


def write_thumb(img, path):
    """Legt die Vorschau zu *path* ab; *img* ist ein PIL-Bild (wird kopiert)."""
    dst = thumb_of(path)
    dst.parent.mkdir(exist_ok=True)
    small = img.copy()
    small.thumbnail((THUMB_WIDTH, THUMB_WIDTH * 2))
    tmp = dst.with_name("%s.%d.tmp" % (dst.stem, threading.get_ident()))
    small.save(tmp, "JPEG", quality=72)
    tmp.replace(dst)            # atomar: nie eine halbe Vorschau ausliefern
    return dst


def ensure_thumb(path):
    """Vorschau fuer ein vorhandenes Bild - beim ersten Abruf nachgeliefert."""
    dst = thumb_of(path)
    if dst.exists() and dst.stat().st_mtime >= path.stat().st_mtime:
        return dst
    from PIL import Image
    with Image.open(path) as img:
        # draft(): der JPEG-Decoder skaliert schon beim Entpacken (1/2..1/8),
        # das spart auf dem Pi den Grossteil der Arbeit.
        img.draft("RGB", (THUMB_WIDTH, THUMB_WIDTH))
        return write_thumb(img.convert("RGB"), path)


def prune_dir(directory, keep):
    files = sorted(directory.glob("*.jpg"), key=lambda p: p.stat().st_mtime, reverse=True)
    for old in files[keep:]:
        unlink_with_thumb(old)


def prune_snapshots():
    prune_dir(SNAP_DIR, MAX_SNAPSHOTS)


def _font(px):
    from PIL import ImageFont
    try:
        return ImageFont.truetype("/usr/share/fonts/truetype/dejavu/DejaVuSans-Bold.ttf", px)
    except OSError:
        pass
    try:
        return ImageFont.load_default(size=px)
    except TypeError:                       # aeltere Pillow: nur Bitmap-Font
        return ImageFont.load_default()


def save_hit(frame, boxes, note, directory=None, keep=MAX_HITS, name_score=None,
             tracks=()):
    """Legt das Bild ab, in dem gerade etwas erkannt wurde - mit Rahmen drin.

    Der Rahmen wird fest eingezeichnet, nicht als Overlay nachgereicht: beim
    Justieren zaehlt, *wo* im Bild die Katze stand und wie gross sie dort war.
    Die Fusszeile haelt Uhrzeit und Lichtverhaeltnisse fest - daran sieht man
    hinterher, ob der Treffer aus der Tag- oder der Infrarot-Lage stammt.
    """
    from PIL import Image, ImageDraw

    img = Image.fromarray(frame)
    if img.size[0] > SAVE_WIDTH:
        # Rahmen sind normiert - verkleinern vor dem Zeichnen ist verlustfrei
        # fuer die Beschriftung und haelt die Galerien im WLAN flink.
        img = img.resize((SAVE_WIDTH, round(img.size[1] * SAVE_WIDTH / img.size[0])),
                         Image.BILINEAR, reducing_gap=2.0)
    width, height = img.size
    draw = ImageDraw.Draw(img)
    line = max(2, round(width / 400))
    font = _font(max(12, round(width / 45)))
    green, orange, dark = (90, 235, 130), (255, 170, 60), (8, 24, 14)
    best = 0.0
    # Bewegungsspuren hellblau, mit etwas Abstand um den Fleck, damit die
    # Katze selbst sichtbar bleibt; darunter Nummer und was die KI dort sah.
    cyan = (80, 200, 255)
    for tr in tracks:
        pad = 0.006
        x0, y0 = (tr["x"] - pad) * width, (tr["y"] - pad) * height
        x1 = (tr["x"] + tr["w"] + pad) * width
        y1 = (tr["y"] + tr["h"] + pad) * height
        draw.rectangle([x0, y0, x1, y1], outline=cyan, width=max(1, line - 1))
        pts = [(p[0] * width, p[1] * height) for p in tr.get("path") or []]
        if len(pts) > 1:
            draw.line(pts, fill=cyan, width=max(1, line - 1))
        tag = ("B%d %s" % (tr["id"], tr.get("best") or "")).strip()
        draw.text((min(x0, width - draw.textlength(tag, font=font) - 4), y1 + 2),
                  tag, font=font, fill=cyan)
    # Schwaechste zuerst zeichnen, damit die staerksten obenauf liegen.
    for box in sorted(boxes, key=lambda b: b["score"]):
        x0, y0 = box["x"] * width, box["y"] * height
        x1, y1 = (box["x"] + box["w"]) * width, (box["y"] + box["h"]) * height
        # Katze gruen, alles andere orange (nur in Radar-/Tier-Bildern sichtbar)
        col = green if Detector._is_target(box["label"]) else orange
        draw.rectangle([x0, y0, x1, y1], outline=col, width=line)
        best = max(best, box["score"])
        tag = "%s %d%%" % (box["label"], round(box["score"] * 100))
        tw = draw.textlength(tag, font=font)
        th = font.size + 6 if hasattr(font, "size") else 18
        ty = y0 - th - line if y0 - th - line >= 0 else y0 + line
        tx = min(max(0.0, x0), max(0.0, width - tw - 8))
        draw.rectangle([tx, ty, tx + tw + 8, ty + th], fill=dark, outline=col, width=1)
        draw.text((tx + 4, ty + 2), tag, font=font, fill=col)
    stamp = datetime.now()
    foot = stamp.strftime("%d.%m. %H:%M:%S") + "  " + note
    fh = (font.size if hasattr(font, "size") else 14) + 8
    draw.rectangle([0, height - fh, width, height], fill=(0, 0, 0))
    draw.text((6, height - fh + 3), foot, font=font, fill=(220, 230, 240))

    directory = directory or HIT_DIR
    directory.mkdir(parents=True, exist_ok=True)
    if name_score is not None:
        best = name_score
    path = directory / ("%s_%02d.jpg" % (stamp.strftime("%Y%m%d_%H%M%S"), round(best * 100)))
    img.save(path, "JPEG", quality=80)
    try:
        write_thumb(img, path)
    except OSError as exc:
        print("[web] Vorschau fehlgeschlagen: %s" % exc)
    prune_dir(directory, keep)
    return path


def system_info():
    info = {}
    try:
        raw = Path("/sys/class/thermal/thermal_zone0/temp").read_text().strip()
        info["temp"] = round(int(raw) / 1000.0, 1)
    except (OSError, ValueError):
        info["temp"] = None
    try:
        out = subprocess.run(["vcgencmd", "get_throttled"], capture_output=True,
                             text=True, timeout=2).stdout.strip()
        info["throttled"] = out.split("=")[-1]
    except Exception:
        info["throttled"] = ""
    try:
        info["load"] = round(os.getloadavg()[0], 2)
    except OSError:
        info["load"] = None
    return info


cfg = load_config()
SNAP_DIR.mkdir(parents=True, exist_ok=True)
HIT_DIR.mkdir(parents=True, exist_ok=True)
RADAR_DIR.mkdir(parents=True, exist_ok=True)
camera = Camera(cfg)
detector = Detector(camera, cfg)
motion = Motion()
eyes = Eyes()
# Rasenmaeher im Dock? (kivision_mower.py) - Coral-Rahmen "car" im Dock-Kasten
mower = DockWatch(lambda: cfg.get("mower"))
detector.motion = motion
detector.pump = FramePump(camera, motion)
homography = Homography(HOMOGRAPHY_FILE, MAP_DIR)
cammodel = CameraModel(CAMMODEL_FILE)


class PersonGuard:
    """Sicher erkannte Person -> fireInhibit an alle Aktoren + Sichtung zum VPS.

    feed() bekommt nach jeder KI-Runde alle Rahmen (raw). Eine Person gilt als
    sicher, wenn sie in der aktuellen Runde und in mindestens need der letzten
    window Runden ueber der Schwelle lag. Solange das so bleibt, geht alle
    PERSON_EVERY s ein fireInhibit raus - die Aktoren sperren bis hold s nach
    dem letzten. Verschwindet die Person, laeuft die Sperre von selbst ab."""

    def __init__(self):
        self.lock = threading.Lock()
        self.recent = []
        self.sent_at = 0.0
        self.sent = 0
        self.seen_at = 0.0          # time.time() der letzten sicheren Sichtung
        self.score = 0
        self.samples = []           # warten auf den VPS

    def feed(self, raw):
        pc = cfg.get("person") or {}
        threshold = float(pc.get("threshold", 0.7))
        window = max(1, int(pc.get("window", 3)))
        need = max(1, min(window, int(pc.get("need", 2))))
        # Ab "fast" genuegt EINE Runde: 2 von 3 kam 2026-11-02 09:18 eine Sekunde nach
        # dem Schuss. Nacht-Fehlalarme lagen bis 67 %, der Blumen-Fehlalarm bei 23-28 %.
        fast = float(pc.get("fast", 0.9))
        persons = [b for b in raw or [] if b["label"] == "person" and b["score"] >= threshold]
        sure = any(b["score"] >= fast for b in persons)
        now = time.monotonic()
        # Zum Nachjustieren (nachts kam je Gang nur eine Sperre): jede Runde
        # mit einer halbwegs sicheren Person ins Journal.
        best = max((b["score"] for b in raw or [] if b["label"] == "person"), default=0.0)
        if best >= PERSON_LOG_MIN:
            print("[person] %d%% %s" % (round(best * 100), "Nacht" if eyes.night else "Tag"),
                  flush=True)
        with self.lock:
            self.recent = (self.recent + [bool(persons)])[-window:]
            if (not persons or (sum(self.recent) < need and not sure)
                    or now - self.sent_at < PERSON_EVERY):
                return
            self.sent_at = now
        top = max(persons, key=lambda b: b["score"])
        score = round(top["score"] * 100)
        world = None
        geo = _geo()
        if geo:
            world = geo.to_world(top["x"] + top["w"] / 2, top["y"] + top["h"])
        hold = max(1.0, float(pc.get("hold", 60)))
        if pc.get("inhibit", True) and node:
            node.send_inhibit(node.x.inhibitPerson, int(hold * 1000), score, world)
        print("[person] Feuersperre gesendet (%d%%, %s)" % (score, world or "ohne Ort"), flush=True)
        with self.lock:
            self.sent += 1
            self.seen_at = time.time()
            self.score = score
            sample = {"t": round(self.seen_at, 2), "score": score}
            if world:
                sample["x"], sample["y"] = world
            self.samples = (self.samples + [sample])[-PERSON_KEEP:]

    def take(self):
        with self.lock:
            out, self.samples = self.samples, []
        return out

    def status(self):
        hold = float((cfg.get("person") or {}).get("hold", 60))
        with self.lock:
            age = time.time() - self.seen_at if self.seen_at else None
            return {"active": age is not None and age < hold, "score": self.score,
                    "age": round(age, 1) if age is not None else None, "sent": self.sent}


persons = PersonGuard()
node = None                 # Busgeraet, gesetzt von _start_bus() weiter unten


def _person_vps_run():
    """Sichtungen gebuendelt zum VPS (markiert die Tracks als Person)."""
    import urllib.request
    while True:
        time.sleep(PERSON_VPS_EVERY)
        samples = persons.take()
        if not samples:
            continue
        body = json.dumps({"sender": node.id if node else 20, "samples": samples}).encode()
        try:
            url = vps_url("/person")
            if not url:
                continue
            req = urllib.request.Request(url, data=body,
                                         headers={"Content-Type": "application/json"})
            urllib.request.urlopen(req, timeout=15).read()
        except Exception as exc:                              # noqa: BLE001
            print("[web] VPS-Person: %s" % exc, flush=True)

MOWER_EVERY = 2.0         # s, Dock-Zustand neu bestimmen
MOWER_BUS_EVERY = 5.0     # s, mowerState auf den Bus (zusaetzlich sofort bei Wechsel)
MOWER_VPS_EVERY = 60.0    # s, Zustand zum VPS (Wechsel sofort)


def _mower_run():
    """Dock-Zustand bestimmen, als mowerState auf den Bus (der Cat Identifier
    entscheidet daraus + aus seinen langen Spuren, ob der Maeher maeht) und
    zum VPS (Anzeige, Mähfahrten fuer die Coverage)."""
    import urllib.request
    bus_at = vps_at = meta_at = 0.0
    lux = None
    while True:
        time.sleep(MOWER_EVERY)
        now = time.monotonic()
        if now - meta_at > 10:
            lux = camera.metadata().get("Lux")
            meta_at = now
        # Nacht = IR-Nacht der Augensuche (bis 30 s alt) oder sehr dunkel; der
        # Maeher maeht nachts nie (Igel). Ruhemodus: keine Aussage.
        night = eyes.night or (lux is not None and lux < NIGHT_LUX)
        changed = mower.update(night or not _bus_active[0], lux)
        st = mower.status()
        if changed:
            print("[mower] Dock: %s (KI %d%%, Lux %s%s)" % (
                st["state"], st["conf"], round(lux) if lux is not None else "-",
                ", Nacht" if st["night"] else ""), flush=True)
        if node and (changed or now - bus_at >= MOWER_BUS_EVERY):
            bus_at = now
            node.send_mower(st["state"], st["night"], st["lawn"], st["conf"],
                            time.time() - st["since"])
        if changed or now - vps_at >= MOWER_VPS_EVERY:
            vps_at = now
            body = json.dumps({"sender": node.id if node else 20, "status": st,
                               "changes": mower.take_changes()}).encode()
            try:
                url = vps_url("/mower")
                if url:
                    req = urllib.request.Request(url, data=body,
                                                 headers={"Content-Type": "application/json"})
                    urllib.request.urlopen(req, timeout=15).read()
            except Exception as exc:                          # noqa: BLE001
                print("[web] VPS-Maeher: %s" % exc, flush=True)


# -- Busgeraet (Phase 3) ------------------------------------------------------
# Die KI laeuft nur, wenn sie eingeschaltet ist (detect.enabled, auch vom VPS
# als stgCamAi schaltbar) UND das Geraet nicht im Ruhemodus steht (stgActive).
_bus_active = [True]


def apply_detect():
    detector.set_enabled(bool(cfg["detect"].get("enabled")) and _bus_active[0])


def _bus_set_ai(on):
    cfg["detect"]["enabled"] = bool(on)
    save_config(cfg)
    apply_detect()


def _bus_on_active(on):
    _bus_active[0] = bool(on)
    apply_detect()


SHOT_FRAMES = 2            # Schussfotos je catHit (Laser leuchtet 500 ms ab Feuerbeginn)
SHOT_GAP = 0.2             # s Mindestabstand zwischen den beiden


def _shot_photos(info, world):
    """Schussfoto(s): die naechsten Kamerabilder nach dem catHit, an den VPS als kivshot."""
    pump = detector.pump
    seq, last_t = pump.seq, 0.0
    for n in range(1, SHOT_FRAMES + 1):
        while True:
            frame, tracks, seq = pump.wait(seq)
            if frame is None or time.monotonic() - last_t >= SHOT_GAP:
                break
        if frame is None:
            return
        last_t = time.monotonic()
        note = "%s  Schussbild %d" % (info, n)
        try:
            path = save_hit(frame, [], note, RADAR_DIR, MAX_RADAR, name_score=0.0, tracks=tracks)
        except Exception as exc:                              # noqa: BLE001
            print("[web] Schussbild fehlgeschlagen: %s" % exc)
            return
        print("[web] Schussbild: %s (%s)" % (path.name, note), flush=True)
        vps_upload(path, frame, world, 0.0, trig="kivshot")


def _bus_on_shot(m, p):
    """catHit vom Bus (Aktor feuert gerade) -> Schussfotos."""
    if not _bus_active[0]:
        return
    name = SENDER_NAMES.get(m.sender, "#%d" % m.sender)
    world = (p["worldX"], p["worldY"]) if p.get("worldValid") else None
    info = "SCHUSS %s" % name
    if world:
        info += " Welt %.1f/%.1f m" % (world[0] / 1000.0, world[1] / 1000.0)
    info += " %.1f m" % (p["radius"] / 1000.0)
    if p.get("res"):
        info += " LP40B %.1f m" % (p["res"] / 1000.0)
    threading.Thread(target=_shot_photos, args=(info, world), daemon=True).start()


def _bus_on_target(m, kind, p):
    """catObserved / catDetected vom Bus -> Radar-Bild (siehe MAX_RADAR)."""
    if not _bus_active[0]:
        return                      # Ruhemodus: keine Fotos
    name = SENDER_NAMES.get(m.sender, "#%d" % m.sender)
    if kind == "detected":
        info = "KATZE bestaetigt (%s, %d%%) Welt %.1f/%.1f m" % (
            name, p["score"], p["worldX"] / 1000.0, p["worldY"] / 1000.0)
    elif p.get("worldValid"):
        info = "%s Welt %.1f/%.1f m" % (name, p["worldX"] / 1000.0, p["worldY"] / 1000.0)
    else:
        info = "%s rel. %.1f/%.1f m" % (name, p["x"] / 1000.0, p["y"] / 1000.0)
    world = (p["worldX"], p["worldY"]) if p.get("worldValid", kind == "detected") else None
    detector.radar_event(info, force=(kind == "detected"), world=world)
    _log_pair(m, kind, p)


ZONES = ("rasen", "noshot")


def _zone_name():
    z = cfg.get("zone")
    return z if z in ZONES else "rasen"


def _zone_area():
    """Gewaehlte Karte als Flaeche (Welt-mm). Beim Rasen wird die unvermessene
    Schlusslinie vorne durch die Nulllinie (Veranda-Kante, y = 0) ersetzt;
    die Noshot-Zone ist schon ein geschlossenes Polygon."""
    name = _zone_name()
    poly = _read_poly(MAP_DIR / (name + ".csv"))
    if len(poly) < 3 or cv2 is None:
        return None
    if name == "rasen":
        a, b = poly[-1], poly[0]
        poly = poly + [(a[0], 0), (b[0], 0)]
    return np.float32(poly).reshape(-1, 1, 2)


def _zone_run():
    """Zone ins Bild projizieren und dem Bewegungsmelder geben - alle 5 min
    (Karte/Kamera-Modell koennen sich aendern) und sofort bei Umschalten."""
    key, at = None, 0.0
    while True:
        time.sleep(1.0)
        now = time.monotonic()
        k = (_zone_name(), id(_geo()))
        if k == key and now - at < 300:
            continue
        key, at = k, now
        geo = _geo()
        motion.set_zone(_zone_uv(geo) if geo else None)


def _vision_run():
    sent = {}                 # Spur-Id -> (letzte Sendezeit, Weltpunkt)
    lawn, lawn_at, lawn_zone = None, 0.0, None
    while True:
        time.sleep(0.25)
        if not (node and _bus_active[0] and cfg.get("vision_observed", True)
                and cfg.get("vision_motion", False)):
            continue
        geo = _geo()
        if not geo:
            continue
        now = time.monotonic()
        if now - lawn_at > 300 or lawn_zone != _zone_name():   # Karte neu kopiert / umgeschaltet
            lawn, lawn_at, lawn_zone = _zone_area(), now, _zone_name()
        tracks = sorted(motion.moving(), key=lambda t: -t["w"] * t["h"])
        alive = set()
        out = []                                      # diese Runde gesendet (Welt-mm)
        for tr in tracks:
            alive.add(tr["id"])
            last_t, last_w = sent.get(tr["id"], (0.0, None))
            if now - last_t < VISION_EVERY:
                continue
            u, v = tr["foot"]
            w = geo.to_world(u, v)
            if not w:
                continue
            if lawn is not None and cv2.pointPolygonTest(lawn, (float(w[0]), float(w[1])), False) < 0:
                continue
            left = geo.to_world(tr["x"], v)
            right = geo.to_world(tr["x"] + tr["w"], v)
            width = int(math.hypot(right[0] - left[0], right[1] - left[1])) if left and right else 0
            if width > VISION_MAX_W:
                continue
            still = last_w and math.hypot(w[0] - last_w[0], w[1] - last_w[1]) < VISION_STILL_MM
            if still and now - last_t < VISION_STILL_EVERY:
                continue
            if any(math.hypot(w[0] - o[0], w[1] - o[1]) < VISION_MERGE_MM for o in out):
                sent[tr["id"]] = (now, w)             # Teil eines groesseren Ziels
                continue
            sent[tr["id"]] = (now, w)
            out.append(w)
            node.send_vision(w[0], w[1], width)
        for k in [k for k in sent if k not in alive]:
            del sent[k]


_vps_queue = []
_vps_cond = threading.Condition()
_vps_stats = {"ok": 0, "fail": 0, "err": ""}


def vps_upload(path, frame, world, best, trig="kivision"):
    """Radar-Bild in die Warteschlange zum VPS (eigener Thread, WLAN ist langsam)."""
    if not cfg.get("vps_photos", True):
        return
    with _vps_cond:
        if len(_vps_queue) >= VPS_QUEUE:
            print("[web] VPS-Bild verworfen (Warteschlange voll)")
            return
        _vps_queue.append((time.time(), path, frame, world, best, trig))
        _vps_cond.notify()


def _vps_jpeg(img, quality=72):
    buf = io.BytesIO()
    img.save(buf, "JPEG", quality=quality)
    return base64.b64encode(buf.getvalue())


def _vps_images(path, frame, world, trig="kivision"):
    """Uebersicht (beschriftetes Radar-Bild, verkleinert) und Ausschnitt um die
    Rasenposition aus dem vollen Bild. Liefert [(trigger, x, y, base64)]."""
    from PIL import Image
    over = Image.open(path)
    over = over.resize((VPS_WIDTH, round(over.size[1] * VPS_WIDTH / over.size[0])), Image.BILINEAR)
    out = [(trig, _vps_jpeg(over))]
    geo = _geo()
    uv = geo.to_image(*world) if geo and world else None
    if uv and 0 <= uv[0] <= 1 and 0 <= uv[1] <= 1:
        h, w = frame.shape[:2]
        cw = round(w * VPS_CROP)
        ch = round(cw * 3 / 4)
        x0 = min(max(0, round(uv[0] * w - cw / 2)), w - cw)
        y0 = min(max(0, round(uv[1] * h - ch * 0.6)), h - ch)   # Ziel etwas unter der Mitte
        crop = Image.fromarray(frame[y0:y0 + ch, x0:x0 + cw])
        out.insert(0, ({"kivision": "kivcrop"}.get(trig, trig + "crop"), _vps_jpeg(crop, 80)))
    return out


def _zone_uv(geo):
    """Gewaehlte Zone ins Bild projizieren - dicht abgetastet, weil die
    Verzeichnung gerade Kanten biegt."""
    lawn = _zone_area()
    if lawn is None:
        return []
    pts = [tuple(p) for p in lawn.reshape(-1, 2)]
    uv = []
    for (ax, ay), (bx, by) in zip(pts, pts[1:] + pts[:1]):
        n = max(1, int(math.hypot(bx - ax, by - ay) / 300))
        for i in range(n):
            q = geo.to_image(ax + (bx - ax) * i / n, ay + (by - ay) * i / n)
            if q:
                uv.append((min(1.2, max(-0.2, q[0])), min(1.2, max(-0.2, q[1]))))
    return uv


def save_eye(frame, tr, note):
    """Uebersicht mit Kreis ums Auge, oben links der Ausschnitt 4x vergroessert."""
    from PIL import Image, ImageDraw
    H, W = frame.shape[:2]
    cx, cy = tr.px
    cw, ch = 160, 120
    x0 = int(min(max(0, cx - cw / 2), W - cw))
    y0 = int(min(max(0, cy - ch / 2), H - ch))
    crop = Image.fromarray(np.ascontiguousarray(frame[y0:y0 + ch, x0:x0 + cw])).resize(
        (cw * 4, ch * 4), Image.NEAREST)
    img = Image.fromarray(frame).resize((SAVE_WIDTH, round(H * SAVE_WIDTH / W)), Image.BILINEAR)
    k = SAVE_WIDTH / W
    draw = ImageDraw.Draw(img)
    r = 22
    draw.ellipse([cx * k - r, cy * k - r, cx * k + r, cy * k + r], outline=(255, 80, 220), width=3)
    img.paste(crop, (0, 0))
    draw.rectangle([0, 0, cw * 4, ch * 4], outline=(255, 80, 220), width=3)
    font = _font(max(12, round(SAVE_WIDTH / 45)))
    fh = (font.size if hasattr(font, "size") else 14) + 8
    stamp = datetime.now()
    draw.rectangle([0, img.size[1] - fh, img.size[0], img.size[1]], fill=(0, 0, 0))
    draw.text((6, img.size[1] - fh + 3), stamp.strftime("%d.%m. %H:%M:%S") + "  " + note,
              font=font, fill=(220, 230, 240))
    EYE_DIR.mkdir(parents=True, exist_ok=True)
    path = EYE_DIR / ("%s_%02d.jpg" % (stamp.strftime("%Y%m%d_%H%M%S"),
                                       min(99, round(tr.peak * 100 / 255))))
    img.save(path, "JPEG", quality=80)
    write_thumb(img, path)
    prune_dir(EYE_DIR, MAX_EYES)
    # Rohbild ohne Einzeichnungen zum Nachjustieren (gross, darum nur wenige)
    raw = EYE_DIR / "raw"
    raw.mkdir(exist_ok=True)
    Image.fromarray(frame).save(raw / path.name, "JPEG", quality=92)
    prune_dir(raw, EYE_RAW_KEEP)
    return path


def _dark_ratio(frame):
    """Helligkeit des fernen Rasens (oberes Sechstel) / Bildmitte, mittlere
    Bildhaelfte quer. Klein = nur das IR-Licht der Kamera beleuchtet."""
    a = frame[::8, ::8]
    h, w = a.shape[:2]
    top = float(a[:h // 6, w // 4:3 * w // 4].mean())
    mid = float(a[h // 2:3 * h // 4, w // 4:3 * w // 4].mean())
    return top / max(mid, 1.0)


def _eyes_run():
    last_meta = last_saved = 0.0
    last_mask = None
    mask_zone = None
    seq = -1
    sent = {}
    while True:
        time.sleep(EYE_EVERY)
        if not (cfg.get("eyes", True) and _bus_active[0]):
            continue
        now = time.monotonic()
        if now - last_meta > 30:
            meta = camera.metadata()
            latest = detector.pump.latest()[0]
            eyes.dark = round(_dark_ratio(latest), 2) if latest is not None else None
            eyes.night = (bool(cfg.get("eyes_force"))      # zum Testen bei Tag
                          or (((meta.get("Lux") or 999) < NIGHT_LUX
                               or (meta.get("AnalogueGain") or 0) >= NIGHT_GAIN)
                              and eyes.dark is not None
                              and eyes.dark < NIGHT_DARK_RATIO))
            last_meta = now
        if not eyes.night:
            continue
        frame, _tracks, seq = detector.pump.wait(seq)
        if frame is None:
            continue
        geo = _geo()
        if last_mask is None or now - last_mask > 300 or mask_zone != _zone_name():
            eyes.set_mask(_zone_uv(geo) if geo else [], frame.shape)
            last_mask, mask_zone = now, _zone_name()
        try:
            fresh = eyes.update(frame, now)
        except Exception as exc:                              # noqa: BLE001
            print("[web] Augen: %s" % exc)
            continue
        for tr in eyes.active():
            w = geo.to_world(tr.uv[0], tr.uv[1], EYE_Z) if geo else None
            if w and node and cfg.get("vision_observed", True) and now - sent.get(tr.id, 0) >= VISION_EVERY:
                sent[tr.id] = now
                node.send_vision(w[0], w[1], 0, sensor=EYE_SENSOR)
            new = tr in fresh
            if not new and now - tr.t_sent < EYE_VPS_EVERY:
                continue
            if not new and now - last_saved < EYE_GAP:
                continue
            tr.t_sent = last_saved = now
            note = "Auge A%d%s  hell %d  %s" % (
                tr.id, " (Paar)" if tr.pair else "", tr.peak,
                "Welt %.1f/%.1f m" % (w[0] / 1000.0, w[1] / 1000.0) if w else "")
            print("[web] %s" % note)
            try:
                path = save_eye(frame, tr, note)
            except Exception as exc:                          # noqa: BLE001
                print("[web] Augen-Bild: %s" % exc)
                continue
            vps_upload(path, frame, w, tr.peak / 255.0, trig="kiveye")
        alive = {t.id for t in eyes.tracks}
        for k in [k for k in sent if k not in alive]:
            del sent[k]


def _vps_run():
    import urllib.request
    while True:
        with _vps_cond:
            while not _vps_queue:
                _vps_cond.wait()
            t, path, frame, world, best, trig = _vps_queue.pop(0)
        try:
            imgs = _vps_images(path, frame, world, trig)
        except Exception as exc:                              # noqa: BLE001
            print("[web] VPS-Bild: %s" % exc)
            continue
        x, y = world or (0, 0)
        base = vps_url("/photo")
        if not base:
            _vps_stats["fail"] += 1
            _vps_stats["err"] = "%s VPS-Adresse unbekannt" % time.strftime("%H:%M")
            continue
        for trig, data in imgs:
            url = "%s?sender=%d&trigger=%s&score=%d&x=%d&y=%d&t=%.2f" % (
                base, node.id if node else 20, trig, round(best * 100), x, y, t)
            try:
                req = urllib.request.Request(url, data=data, headers={"Content-Type": "text/plain"})
                urllib.request.urlopen(req, timeout=30).read()
                _vps_stats["ok"] += 1
            except Exception as exc:                          # noqa: BLE001
                print("[web] VPS-Bild %s: %s" % (trig, exc))
                _vps_stats["fail"] += 1
                _vps_stats["err"] = "%s %s" % (time.strftime("%H:%M"), exc)
                break


def _log_pair(m, kind, p):
    """Radar-Weltposition neben die gerade bewegten Kamera-Spuren schreiben."""
    if not p.get("worldValid", kind == "detected"):
        return
    tracks = motion.moving()
    if not tracks:
        return
    row = {"t": round(time.time(), 2), "sender": m.sender, "kind": kind,
           "wx": p["worldX"], "wy": p["worldY"], "flips": _flips(),
           "tracks": [{"id": t["id"], "foot": t["foot"], "w": t["w"], "h": t["h"],
                       "age": t["age"], "best": t["best"]} for t in tracks]}
    try:
        if PAIRS_FILE.exists() and PAIRS_FILE.stat().st_size > PAIRS_MAX_BYTES:
            PAIRS_FILE.replace(PAIRS_FILE.with_suffix(".old"))
        with PAIRS_FILE.open("a") as fh:
            fh.write(json.dumps(row) + "\n")
    except OSError as exc:
        print("[web] pairs.jsonl: %s" % exc)


def _start_bus():
    # xComDef6_3.h liegt beim Ausrollen neben diesem Skript; im Repo eine Ebene
    # hoeher beim Manager. Ohne Header laeuft die Kamera trotzdem, nur ohne Bus.
    for cand in (BASE / "xComDef6_3.h",
                 BASE.parent / "Controller" / "Manager6_3_0" / "xComDef6_3.h"):
        if cand.is_file():
            break
    else:
        print("[bus] xComDef6_3.h nicht gefunden - ohne Busanbindung")
        return None
    try:
        from xcom import XComDef
        from kivision_bus import BusNode
        node = BusNode(XComDef(cand), lambda: bool(cfg["detect"].get("enabled")),
                       _bus_set_ai, _bus_on_active, on_target=_bus_on_target,
                       on_shot=_bus_on_shot, on_vps=_vps_learned,
                       vps_known=lambda: bool(_vps_base[0]))
        node.start()
        print("[bus] Geraet %d auf dem Bus, IP %s" % (node.id, node.bus.ip))
        return node
    except Exception as exc:                                  # noqa: BLE001
        print("[bus] Start fehlgeschlagen: %s" % exc)
        return None


apply_detect()
_vps_load()
node = _start_bus()

app = Flask(__name__, template_folder=str(BASE / "templates"))

HEALTH_EVERY = 600       # s, Lebenszeichen-Zeile im Journal
SOCKET_TIMEOUT = 20      # s, dann gilt ein haengender Client als weg
STREAM_PAUSE_MAX = 1.0   # s, laengste Pause zwischen zwei Livebildern


@app.after_request
def no_cache(resp):
    # Galerie-Bilder (send_from_directory mit max_age) duerfen im Browser
    # bleiben, alles andere - Zustand, Seite, Strom - immer frisch.
    if "max-age" not in resp.headers.get("Cache-Control", ""):
        resp.headers["Cache-Control"] = "no-store"
    return resp


@app.route("/")
def index():
    return render_template("index.html")


@app.route("/stream.mjpg")
def stream():
    def generate():
        camera.add_viewer()
        seq = -1
        try:
            while True:
                frame, seq = camera.output.wait(seq)
                if frame is None:
                    continue
                # X-Seq erlaubt es, den Rueckstand zu messen: der Vergleich mit
                # "frames" aus /api/state sagt, wieviele Bilder der Client
                # hinterherhinkt - ohne auf synchrone Uhren angewiesen zu sein.
                sent = time.monotonic()
                yield (b"--frame\r\nContent-Type: image/jpeg\r\nX-Seq: "
                       + str(seq).encode() + b"\r\nContent-Length: "
                       + str(len(frame)).encode() + b"\r\n\r\n" + frame + b"\r\n")
                # Hier ist das Bild geschrieben. So lange wie das gedauert hat,
                # bleibt die Funkstrecke danach frei: auf schnellem WLAN kaum
                # spuerbar (Millisekunden), auf der schwachen Pi-Strecke halbiert
                # es die Bildrate, laesst aber Seite, Galerie und andere Geraete
                # durch, statt dass ein Livebild alles zustopft.
                time.sleep(min(time.monotonic() - sent, STREAM_PAUSE_MAX))
        finally:
            camera.remove_viewer()
    return Response(generate(),
                    mimetype="multipart/x-mixed-replace; boundary=frame")


@app.route("/api/state")
def api_state():
    meta = camera.metadata()
    return jsonify({
        "config": cfg,
        "sizes": [list(s) for s in SIZES],
        "fps_max": camera.fps_max(),
        "stream_size": list(camera.lores_size),
        "controls": CONTROL_SPEC,
        "limits": camera.limits,
        "models": Detector.available_models(),
        "fps": camera.output.fps(),
        "mbit": camera.output.mbit(),
        "frames": camera.output.count,
        "viewers": camera.viewers,
        "system": system_info(),
        "bus": node.status() if node else None,
        "person": persons.status(),
        "mower": mower.status(),
        "meta": {
            "ExposureTime": meta.get("ExposureTime"),
            "AnalogueGain": round(meta.get("AnalogueGain") or 0, 2),
            "DigitalGain": round(meta.get("DigitalGain") or 0, 2),
            "Lux": round(meta.get("Lux") or 0, 1),
            "ColourTemperature": meta.get("ColourTemperature"),
            "ColourGains": [round(v, 2) for v in (meta.get("ColourGains") or [])],
            "FocusFoM": meta.get("FocusFoM"),
            "lag_ms": meta.get("_lag_ms"),
        },
    })


@app.route("/api/config", methods=["POST"])
def api_config():
    data = request.get_json(force=True, silent=True) or {}
    restart = False
    for key in ("size", "ai_size"):
        if key in data:
            size = [int(v) for v in data[key]]
            if list(cfg.get(key) or []) != size:
                cfg[key] = size
                restart = True
    for key in ("fps", "quality"):
        if key in data:
            value = int(data[key])
            if cfg[key] != value:
                cfg[key] = value
                if key == "quality":
                    restart = True
    for key in ("hflip", "vflip"):
        if key in data:
            value = bool(data[key])
            if cfg[key] != value:
                cfg[key] = value
                restart = True
    for key in ("rotate", "grid", "map", "eyes", "eyes_force"):
        if key in data:
            cfg[key] = data[key]
    if data.get("zone") in ZONES:
        cfg["zone"] = data["zone"]
    if "tuning" in data and data["tuning"] != cfg.get("tuning"):
        camera.set_tuning(str(data["tuning"]))
        restart = False          # set_tuning startet schon neu
    if restart:
        camera.restart()
    else:
        camera.apply_controls()
    save_config(cfg)
    return jsonify({"ok": True, "config": cfg})


@app.route("/api/control", methods=["POST"])
def api_control():
    data = request.get_json(force=True, silent=True) or {}
    known = dict((spec["name"], spec) for spec in CONTROL_SPEC)
    for name, value in data.items():
        if name not in known:
            continue
        spec = known[name]
        if spec["type"] == "bool":
            cfg["controls"][name] = bool(value)
        elif spec["type"] in ("int", "enum"):
            cfg["controls"][name] = int(value)
        else:
            cfg["controls"][name] = float(value)
    camera.apply_controls()
    save_config(cfg)
    return jsonify({"ok": True, "controls": cfg["controls"]})


@app.route("/api/reset_controls", methods=["POST"])
def api_reset_controls():
    cfg["controls"] = {}
    camera.restart()
    save_config(cfg)
    return jsonify({"ok": True})


@app.route("/api/detect", methods=["POST"])
def api_detect():
    data = request.get_json(force=True, silent=True) or {}
    det = cfg["detect"]
    for key in ("model", "tiles"):
        if key in data:
            det[key] = str(data[key])
    if "threshold" in data:
        det["threshold"] = max(0.05, min(0.95, float(data["threshold"])))
    if "interval" in data:
        det["interval"] = max(0.05, min(5.0, float(data["interval"])))
    if "cat_only" in data:
        det["cat_only"] = bool(data["cat_only"])
    if "max_area" in data:
        det["max_area"] = max(0.05, min(1.0, float(data["max_area"])))
    if "snap_mode" in data and str(data["snap_mode"]) in ("off", "cat", "animal", "all"):
        det["snap_mode"] = str(data["snap_mode"])
    if "snap_gap" in data:
        det["snap_gap"] = max(5, min(3600, int(data["snap_gap"])))
    was = bool(det.get("enabled"))
    if "enabled" in data:
        det["enabled"] = bool(data["enabled"])
    apply_detect()
    save_config(cfg)
    if node and was != bool(det["enabled"]):
        node.settings_changed()          # VPS-Steuertab sofort nachziehen
    return jsonify({"ok": True, "detect": det})


@app.route("/api/detections")
def api_detections():
    data = detector.snapshot_state()
    # Fusspunkt jeder bewegten Spur auf den Rasen (Phase 4)
    geo = _geo()
    if geo and data.get("motion"):
        data["motion"] = [dict(m, world=geo.to_world(m["foot"][0], m["foot"][1]))
                          if m.get("foot") else m for m in data["motion"]]
    data["eyes"] = [{"id": t.id, "uv": [round(t.uv[0], 4), round(t.uv[1], 4)], "pair": t.pair}
                    for t in eyes.active()]
    data["eyes_status"] = eyes.status()
    return jsonify(data)


def _geo():
    """Bild -> Rasen: Kamera-Modell, sonst Radar-Homographie, sonst nichts."""
    if cammodel.valid(_flips()):
        return cammodel
    if homography.valid(_flips()):
        return homography
    return None


def _maps():
    return {name: _read_poly(MAP_DIR / (name + ".csv")) for name in ("rasen", "noshot")}


@app.route("/api/cammodel")
def api_cammodel():
    valid = cammodel.valid(_flips())
    return jsonify({"data": cammodel.data, "fit": cammodel.fit, "valid": valid,
                    "overlay": cammodel.overlay(_maps()) if valid else None})


@app.route("/api/cammodel", methods=["POST"])
def api_cammodel_set():
    """Kamera-Standort, Objektiv, Referenzpunkte und Nulllinie speichern."""
    data = request.get_json(force=True, silent=True) or {}
    d = cammodel.data
    try:
        if "cam" in data:
            d["cam"] = [float(v) for v in data["cam"]][:3]
        if "lens_mm" in data:
            d["lens_mm"] = max(0.5, min(20.0, float(data["lens_mm"])))
        if "refs" in data:
            d["refs"] = [{"name": str(r.get("name", ""))[:20], "x": float(r["x"]), "y": float(r["y"]),
                          "uv": ([float(r["uv"][0]), float(r["uv"][1])] if r.get("uv") else None)}
                         for r in data["refs"]][:20]
        if "zero" in data:
            d["zero"] = [[float(u), float(v)] for u, v in data["zero"]][:30]
        if "edge" in data:
            d["edge"] = [[float(u), float(v)] for u, v in data["edge"]][:60]
        if any(k in data for k in ("refs", "zero", "edge")):
            d["flips"] = _flips()       # Klicks gelten nur in dieser Spiegelung
    except (TypeError, ValueError, KeyError, IndexError) as exc:
        return jsonify({"ok": False, "error": "ungueltige Eingabe: %s" % exc})
    cammodel.save()
    return jsonify({"ok": True})


@app.route("/api/cammodel/calibrate", methods=["POST"])
def api_cammodel_calibrate():
    try:
        cammodel.set_lawn(_maps()["rasen"])
        fit = cammodel.calibrate(_flips())
    except Exception as exc:                                  # noqa: BLE001
        return jsonify({"ok": False, "error": str(exc)})
    # Nebenbei: wie weit liegt jedes Sensor-Weltsystem neben der Kamera?
    try:
        src, dst, _, snd = load_pairs([PAIRS_FILE.with_suffix(".old"), PAIRS_FILE], senders=None,
                                   flips=_flips())
        fit["radar"] = cammodel.radar_offsets(src / (1640.0, 1232.0), dst, snd)
        cammodel.save()
    except Exception as exc:                                  # noqa: BLE001
        print("[web] Radar-Vergleich: %s" % exc)
    print("[web] Kamera-Modell: rms %d mm, %s" % (fit["rms_mm"], fit["refs"]))
    if node:
        node.text("Kamera-Modell neu: rms %d mm" % fit["rms_mm"])
    return jsonify({"ok": True, "fit": fit})


def _flips():
    return {"hflip": bool(cfg.get("hflip")), "vflip": bool(cfg.get("vflip"))}


def _pair_count():
    n = 0
    for path in (PAIRS_FILE.with_suffix(".old"), PAIRS_FILE):
        try:
            with path.open("rb") as fh:
                n += sum(chunk.count(b"\n") for chunk in iter(lambda: fh.read(1 << 20), b""))
        except OSError:
            pass
    return n


@app.route("/api/homography")
def api_homography():
    """Stand der Kalibrierung; mit ?overlay=1 auch die Linien fuers Livebild."""
    out = {"data": homography.data, "valid": homography.valid(_flips()),
           "rows": _pair_count()}
    if request.args.get("overlay") == "1" and out["valid"]:
        out["overlay"] = homography.overlay()
    return jsonify(out)


@app.route("/api/homography/calibrate", methods=["POST"])
def api_homography_calibrate():
    try:
        data = homography.calibrate([PAIRS_FILE.with_suffix(".old"), PAIRS_FILE], _flips())
    except Exception as exc:                                  # noqa: BLE001
        return jsonify({"ok": False, "error": str(exc)})
    print("[web] Homographie: %d von %d Paaren, Median %d mm"
          % (data["inliers"], data["pairs"], data["median_mm"]))
    if node:
        node.text("Homographie neu: %d/%d Paare, Median %d mm"
                  % (data["inliers"], data["pairs"], data["median_mm"]))
    return jsonify({"ok": True, "data": data})


@app.route("/api/snapshot", methods=["POST"])
def api_snapshot():
    full = bool((request.get_json(force=True, silent=True) or {}).get("full"))
    try:
        path = camera.snapshot(detector.pump.latest()[0], full_res=full)
    except Exception as exc:
        return jsonify({"ok": False, "error": str(exc)}), 500
    return jsonify({"ok": True, "name": path.name})


@app.route("/api/snapshots")
def api_snapshots():
    files = sorted(SNAP_DIR.glob("*.jpg"), key=lambda p: p.stat().st_mtime, reverse=True)
    return jsonify([{"name": p.name,
                     "size": p.stat().st_size,
                     "ts": int(p.stat().st_mtime)} for p in files[:60]])


# Treffer (vom Modell ausgeloest) und Radar-Bilder (vom Bus ausgeloest) teilen
# sich dieselben Endpunkte: /api/<art>, /<art>/<name>, DELETE, /api/<art>/clear.
GALLERIES = {"hits": (HIT_DIR, MAX_HITS), "radar": (RADAR_DIR, MAX_RADAR),
             "motion": (MOTION_DIR, MAX_MOTION), "eyes": (EYE_DIR, MAX_EYES)}


@app.route("/api/<any(hits, radar, motion, eyes):kind>")
def api_hits(kind):
    """Die von selbst entstandenen Bilder, neueste zuerst."""
    directory, keep = GALLERIES[kind]
    files = sorted(directory.glob("*.jpg"), key=lambda p: p.stat().st_mtime, reverse=True)
    out = []
    for path in files[:keep]:
        # Name ist <datum>_<zeit>_<prozent>.jpg - die Sicherheit steht mit drin,
        # damit die Galerie sie ohne zweite Datei je Bild anzeigen kann.
        part = path.stem.rsplit("_", 1)[-1]
        out.append({"name": path.name,
                    "size": path.stat().st_size,
                    "ts": int(path.stat().st_mtime),
                    "score": int(part) if part.isdigit() else None})
    return jsonify({"max": keep, "files": out})


# Dateinamen tragen Datum+Uhrzeit und werden nie neu beschrieben - der Browser
# darf sie behalten, statt bei jedem Neuaufbau der Galerie nachzufragen.
IMG_MAX_AGE = 7 * 24 * 3600


@app.route("/<any(hits, radar, motion, eyes):kind>/<path:name>")
def hit_file(kind, name):
    return send_from_directory(GALLERIES[kind][0], name, max_age=IMG_MAX_AGE)


@app.route("/thumb/<any(hits, radar, motion, eyes, snapshots):kind>/<name>")
def thumb_file(kind, name):
    directory = SNAP_DIR if kind == "snapshots" else GALLERIES[kind][0]
    src = (directory / name).resolve()
    if src.parent != directory.resolve() or not src.is_file():
        return Response(status=404)
    try:
        dst = ensure_thumb(src)
    except Exception as exc:              # kaputtes JPEG: dann eben das Original
        print("[web] Vorschau %s: %s" % (name, exc))
        return send_from_directory(directory, name, max_age=IMG_MAX_AGE)
    return send_from_directory(dst.parent, dst.name, max_age=IMG_MAX_AGE)


@app.route("/api/<any(hits, radar, motion, eyes):kind>/<path:name>", methods=["DELETE"])
def hit_delete(kind, name):
    directory = GALLERIES[kind][0]
    target = (directory / name).resolve()
    if target.parent != directory.resolve() or not target.exists():
        return jsonify({"ok": False}), 404
    unlink_with_thumb(target)
    if kind == "eyes":                  # Rohbild gleichen Namens mit weg
        try:
            (EYE_DIR / "raw" / target.name).unlink()
        except OSError:
            pass
    return jsonify({"ok": True})


@app.route("/api/<any(hits, radar, motion, eyes):kind>/clear", methods=["POST"])
def hits_clear(kind):
    count = 0
    for path in GALLERIES[kind][0].glob("*.jpg"):
        try:
            path.unlink()
            count += 1
        except OSError:
            pass
    extra = list((EYE_DIR / "raw").glob("*.jpg")) if kind == "eyes" else []
    for path in list((GALLERIES[kind][0] / ".thumbs").glob("*")) + extra:
        try:
            path.unlink()
        except OSError:
            pass
    return jsonify({"ok": True, "deleted": count})


@app.route("/snapshots/<path:name>")
def snapshot_file(name):
    return send_from_directory(SNAP_DIR, name, max_age=IMG_MAX_AGE)


@app.route("/api/snapshots/<path:name>", methods=["DELETE"])
def snapshot_delete(name):
    target = (SNAP_DIR / name).resolve()
    if target.parent != SNAP_DIR.resolve() or not target.exists():
        return jsonify({"ok": False}), 404
    unlink_with_thumb(target)
    return jsonify({"ok": True})


# Hintergrund-Threads erst hier am Ende starten, wenn alle Funktionen (z.B.
# _geo) definiert sind - frueher weiter oben gestartet, starb je nach Timing
# ein Thread beim Start mit NameError (2026-10-19: _vision_run).
def _forever(fn):
    """Hintergrund-Schleife am Leben halten: eine Ausnahme beendete den Thread
    frueher still und fuer immer (Web und HB sahen weiter gesund aus)."""
    def run():
        while True:
            try:
                fn()
            except Exception:                                 # noqa: BLE001
                print("[web] %s abgestuerzt, Neustart in 5 s:\n%s"
                      % (fn.__name__, traceback.format_exc()), flush=True)
                _thread_crashes[fn.__name__] = _thread_crashes.get(fn.__name__, 0) + 1
                time.sleep(5.0)
    threading.Thread(target=run, name=fn.__name__, daemon=True).start()


_thread_crashes = {}


def _health_run():
    """Lebenszeichen ins Journal: zeigt nach einem Ausfall, ab wann welcher
    Teil stillstand (journalctl -u kivision-web -b -1 | grep Lebenszeichen)."""
    while True:
        time.sleep(HEALTH_EVERY)
        st = node.status() if node else {}
        det = detector.snapshot_state()
        print("[web] Lebenszeichen: bus tx %s rx %s (letztes vor %s s) hb %s vision %s | "
              "radar %d, ki %s%s | augen %s | maeher %s | person-sperren %d | vps ok %d fehl %d%s | abstuerze %s"
              % (st.get("tx"), st.get("rx"), st.get("rx_age"), st.get("hb_tx"),
                 st.get("vision_tx"), det.get("radar", 0),
                 "an" if det.get("running") else "aus",
                 (" (" + det["error"] + ")") if det.get("error") else "",
                 "Nacht" if eyes.night else "Tag", mower.status()["state"], persons.sent, _vps_stats["ok"], _vps_stats["fail"],
                 (" (" + _vps_stats["err"] + ")") if _vps_stats["err"] else "",
                 _thread_crashes or "keine"), flush=True)


_forever(_vps_run)
_forever(_vision_run)
_forever(_person_vps_run)
_forever(_mower_run)
_forever(_eyes_run)
_forever(_zone_run)
_forever(_health_run)

if __name__ == "__main__":
    from werkzeug.serving import WSGIRequestHandler, make_server

    # Nagle aus. Sonst haelt der Kernel das letzte Teilstueck eines Bildes
    # zurueck, bis die vorige Sendung bestaetigt ist - zusammen mit der
    # verzoegerten Bestaetigung des Empfaengers kostet das bis zu 40 ms pro
    # Bild. Bei einem Strom aus fertigen Bildern bringt das Buendeln nichts.
    WSGIRequestHandler.disable_nagle_algorithm = True
    # Ohne Zeitlimit blockiert das Schreiben an einen verschwundenen Client
    # (Handy gesperrt, aus dem WLAN) bis TCP nach ~15 min aufgibt - so lange
    # bliebe das Livebild "angeschaut" und der Thread haengen.
    WSGIRequestHandler.timeout = SOCKET_TIMEOUT

    port = int(os.environ.get("KIVISION_PORT", 8080))
    server = make_server("0.0.0.0", port, app, threaded=True)
    # Kleiner Sendepuffer: was hier drinsteht, ist beim Ankommen schon alt.
    # Auf einer schwachen Funkstrecke ist der Puffer die Verzoegerung - er
    # braucht nur den Weg zu fuellen (Bandbreite x Laufzeit, hier rund 15 kB
    # bei 30 Mbit/s und 4 ms), nicht ganze Bilder zu stapeln. Bleibt er unter
    # einer Bildgroesse, blockiert das Schreiben frueh, der Stream ueberspringt
    # Bilder und der Client bekommt immer das neueste statt eines alten aus der
    # Schlange. Linux verdoppelt den Wunschwert intern.
    server.socket.setsockopt(socket.SOL_SOCKET, socket.SO_SNDBUF, 24 * 1024)
    actual = server.socket.getsockopt(socket.SOL_SOCKET, socket.SO_SNDBUF)
    print("[web] Server auf Port %d, Sendepuffer %d kB (Kernel), Nagle %s"
          % (port, actual // 1024,
             "aus" if WSGIRequestHandler.disable_nagle_algorithm else "an"))
    server.serve_forever()
