smily77/CatFind/CatIdentifier/CatId6_3_0/catTrack.ino

// catTrack.ino - Echtzeit-Katzenerkennung auf dem ESP32 (Streaming-Port des
// VPS-Referenzmodells VPS/dashboard/catmodel.py).
//
// Unterschied zur VPS-Version: dort wird ein fertiger Track als Ganzes bewertet,
// hier muss KAUSAL entschieden werden, waehrend die Katze noch im Feld ist.
// Darum fliessen nur die zum Zeitpunkt verfuegbaren Merkmale ein (kein
// Austritts-Bonus/-Malus, kein Sprung-Malus); die Bestaetigung feuert, sobald
// der Score die Schwelle erreicht - wie t_confirm im VPS-Modell.
//
// Parameter: identische Namen wie DEFAULT_PARAMS in catmodel.py; sie kommen als
// key=value-Zeilen vom VPS (/aparams.csv) und werden im LittleFS gecacht.

void announceCat(const catDetectedPayload& cd);   // im Hauptsketch
void announceTrack(const catDetectedPayload& cd); // im Hauptsketch (catTracked)

// Modellzeit in Sekunden, 64-bit-Basis (esp_timer): millis()/1000.0 wuerde nach
// 49,7 Tagen wrappen - dann waeren alle Track-/Sturm-Zeiten kaputt.
static inline double ctNow() { return (double)(esp_timer_get_time() / 1000ULL) / 1000.0; }

// ------------------------------------------------------------------ Parameter
// (Struct-Definitionen in catTrackDef.h - Arduino-Autoprototypen brauchen sie frueher)
CatParams CTP;

// Defaults = DEFAULT_PARAMS in catmodel.py (Stand der letzten Modell-Iteration).
void ctSetDefaults() {
  CTP.gate_speed_mm_s = 4000; CTP.gate_base_mm = 400;
  CTP.track_gap_s = 1.5f; CTP.stitch_gap_s = 6.0f; CTP.stitch_dist_mm = 700;
  CTP.move_min_points = 4; CTP.move_window_s = 1.2f; CTP.move_min_net_mm = 400;
  CTP.speed_min_mm_s = 60; CTP.speed_max_mm_s = 4000; CTP.speed_ok_ratio = 0.7f;
  CTP.min_confirm_weight = 0.9f;
  CTP.w_hlk = 1.0f; CTP.w_lidar = 0.3f; CTP.w_default = 0.6f;
  CTP.confirm_score = 60; CTP.score_move = 50; CTP.score_entry = 18;
  CTP.score_fusion = 25; CTP.score_crossing = 12; CTP.score_long = 8;
  CTP.score_stationary = 8; CTP.penalty_mid_birth = 12; CTP.penalty_short = 10;
  CTP.crossing_net_mm = 800; CTP.long_track_points = 10; CTP.short_track_s = 0.8f;
  CTP.max_path_mm = 40000; CTP.edge_dist_mm = 900; CTP.near_sensor_mm = 1000;
  CTP.stationary_end_s = 3.0f; CTP.stationary_radius_mm = 350;
  CTP.storm_window_s = 3.0f; CTP.storm_rate_evts_s = 8.0f;
  CTP.storm_min_events = 12; CTP.storm_scatter_mm = 2500;
  CTP.fusion_distance_mm = 500; CTP.fusion_time_s = 0.7f;
  CTP.cam_feed = 0;
  CTP.eye_confirm = 1; CTP.eye_dist_mm = 1500; CTP.eye_time_s = 5.0f; CTP.score_eyes = 100;
  CTP.cont_confirm = 1; CTP.cont_gap_s = 15.0f; CTP.cont_dist_mm = 5000;
  CTP.cont_v_min_mm_s = 150; CTP.cont_v_max_mm_s = 3000; CTP.cont_near_mm = 800;
  CTP.cont_angle_deg = 60;
  CTP.quiet_t0_min = 900; CTP.quiet_t1_min = 990;   // NoShot-Zeit 15:00-16:30 lokal
  CTP.mow_pause = 1; CTP.mow_p0_mm = 5000; CTP.mow_path_mm = 25000;
  CTP.mow_window_s = 120; CTP.mow_depart_s = 180; CTP.mow_hold_s = 600;
  CTP.mow_day_t0_min = 420; CTP.mow_day_t1_min = 1260;   // 07:00-21:00 lokal
}

// einen key=value-Eintrag anwenden (ms-Parameter werden hier in Sekunden gefuehrt)
static bool ctApplyParam(const String& k, float v) {
  if      (k == "gate_speed_mm_s")     CTP.gate_speed_mm_s = v;
  else if (k == "gate_base_mm")        CTP.gate_base_mm = v;
  else if (k == "track_gap_ms")        CTP.track_gap_s = v / 1000.0f;
  else if (k == "stitch_gap_ms")       CTP.stitch_gap_s = v / 1000.0f;
  else if (k == "stitch_dist_mm")      CTP.stitch_dist_mm = v;
  else if (k == "move_min_points")     CTP.move_min_points = (int)v;
  else if (k == "move_window_ms")      CTP.move_window_s = v / 1000.0f;
  else if (k == "move_min_net_mm")     CTP.move_min_net_mm = v;
  else if (k == "speed_min_mm_s")      CTP.speed_min_mm_s = v;
  else if (k == "speed_max_mm_s")      CTP.speed_max_mm_s = v;
  else if (k == "speed_ok_ratio")      CTP.speed_ok_ratio = v;
  else if (k == "min_confirm_weight")  CTP.min_confirm_weight = v;
  else if (k == "type_weight.HLK")     CTP.w_hlk = v;
  else if (k == "type_weight.Lidar")   CTP.w_lidar = v;
  else if (k == "type_weight.default") CTP.w_default = v;
  else if (k == "confirm_score")       CTP.confirm_score = (int)v;
  else if (k == "score_move")          CTP.score_move = (int)v;
  else if (k == "score_entry")         CTP.score_entry = (int)v;
  else if (k == "score_fusion")        CTP.score_fusion = (int)v;
  else if (k == "score_crossing")      CTP.score_crossing = (int)v;
  else if (k == "score_long")          CTP.score_long = (int)v;
  else if (k == "score_stationary")    CTP.score_stationary = (int)v;
  else if (k == "penalty_mid_birth")   CTP.penalty_mid_birth = (int)v;
  else if (k == "penalty_short")       CTP.penalty_short = (int)v;
  else if (k == "crossing_net_mm")     CTP.crossing_net_mm = v;
  else if (k == "long_track_points")   CTP.long_track_points = (int)v;
  else if (k == "short_track_ms")      CTP.short_track_s = v / 1000.0f;
  else if (k == "max_path_mm")         CTP.max_path_mm = v;
  else if (k == "edge_dist_mm")        CTP.edge_dist_mm = v;
  else if (k == "near_sensor_mm")      CTP.near_sensor_mm = v;
  else if (k == "stationary_end_s")    CTP.stationary_end_s = v;
  else if (k == "stationary_radius_mm") CTP.stationary_radius_mm = v;
  else if (k == "storm_window_ms")     CTP.storm_window_s = v / 1000.0f;
  else if (k == "storm_rate_evts_s")   CTP.storm_rate_evts_s = v;
  else if (k == "storm_min_events")    CTP.storm_min_events = (int)v;
  else if (k == "storm_scatter_mm")    CTP.storm_scatter_mm = v;
  else if (k == "fusion_distance_mm")  CTP.fusion_distance_mm = v;
  else if (k == "fusion_time_ms")      CTP.fusion_time_s = v / 1000.0f;
  else if (k == "cam_feed")            CTP.cam_feed = (int)v;
  else if (k == "eye_confirm")         CTP.eye_confirm = (int)v;
  else if (k == "eye_dist_mm")         CTP.eye_dist_mm = v;
  else if (k == "eye_time_ms")         CTP.eye_time_s = v / 1000.0f;
  else if (k == "score_eyes")          CTP.score_eyes = (int)v;
  else if (k == "cont_confirm")        CTP.cont_confirm = (int)v;
  else if (k == "cont_gap_ms")         CTP.cont_gap_s = v / 1000.0f;
  else if (k == "cont_dist_mm")        CTP.cont_dist_mm = v;
  else if (k == "cont_v_min_mm_s")     CTP.cont_v_min_mm_s = v;
  else if (k == "cont_v_max_mm_s")     CTP.cont_v_max_mm_s = v;
  else if (k == "cont_near_mm")        CTP.cont_near_mm = v;
  else if (k == "cont_angle_deg")      CTP.cont_angle_deg = v;
  else if (k == "quiet_t0_min")        CTP.quiet_t0_min = (int)v;
  else if (k == "quiet_t1_min")        CTP.quiet_t1_min = (int)v;
  else if (k == "mow_pause")           CTP.mow_pause = (int)v;
  else if (k == "mow_p0_mm")           CTP.mow_p0_mm = v;
  else if (k == "mow_path_mm")         CTP.mow_path_mm = v;
  else if (k == "mow_window_ms")       CTP.mow_window_s = v / 1000.0f;
  else if (k == "mow_depart_ms")       CTP.mow_depart_s = v / 1000.0f;
  else if (k == "mow_hold_ms")         CTP.mow_hold_s = v / 1000.0f;
  else if (k == "mow_day_t0_min")      CTP.mow_day_t0_min = (int)v;
  else if (k == "mow_day_t1_min")      CTP.mow_day_t1_min = (int)v;
  else return false;                   // unbekannt (z.B. reine VPS-Parameter) - ok
  return true;
}

// key=value-Text (VPS /aparams.csv bzw. LittleFS-Cache) anwenden. Immer von den
// Defaults aus, damit entfernte Parameter auf ihren Default zurueckfallen.
static bool ctApplyParamsText(const String& body) {
  ctSetDefaults();
  int applied = 0, start = 0;
  while (start < (int)body.length()) {
    int nl = body.indexOf('\n', start);
    String line = (nl < 0) ? body.substring(start) : body.substring(start, nl);
    line.trim();
    int eq = line.indexOf('=');
    if (line.length() && line[0] != '#' && eq > 0) {
      if (ctApplyParam(line.substring(0, eq), line.substring(eq + 1).toFloat()))
        applied++;
    }
    if (nl < 0) break;
    start = nl + 1;
  }
  return applied >= 10;                // Plausibilitaet: echte Parameterliste
}

bool ctLoadParamsFile(const char* path) {
  File f = LittleFS.open(path, "r");
  if (!f) return false;
  String body = f.readString();
  f.close();
  return ctApplyParamsText(body);
}

bool ctFetchParams() {
  if (WiFi.status() != WL_CONNECTED) return false;
  HTTPClient http;
  String url = "http://" + ipVPS.toString() + "/aparams.csv";
  if (!http.begin(url)) return false;
  http.setTimeout(PARAMS_FETCH_TIMEOUT_MS);
  int code = http.GET();
  bool ok = false;
  if (code == 200) {
    String body = http.getString();
    if (ctApplyParamsText(body)) {
      File f = LittleFS.open(PARAMS_PATH, "w");   // Cache fuer VPS-Ausfall/Reboot
      if (f) { f.print(body); f.close(); }
      ok = true;
    }
  }
  http.end();
  return ok;
}

String ctQuietStr() {
  if (CTP.quiet_t0_min == CTP.quiet_t1_min) return "aus";
  char b[16];
  snprintf(b, sizeof b, "%02d:%02d-%02d:%02d", CTP.quiet_t0_min / 60, CTP.quiet_t0_min % 60,
           CTP.quiet_t1_min / 60, CTP.quiet_t1_min % 60);
  return String(b);
}

String ctParamSummary() {
  return "confirm=" + String(CTP.confirm_score) + " maxPath=" +
         String((int)(CTP.max_path_mm / 1000)) + "m edge=" + String((int)CTP.edge_dist_mm) +
         " ruhe=" + ctQuietStr() + " " + mowSummary();
}

// NoShot-Zeit (Maeher-Ruhefenster, quiet_t0_min..quiet_t1_min in lokalen Minuten seit
// Mitternacht, konfiguriert ueber dieselben VPS-Parameter wie der Rest des Modells):
// im Fenster wird das Modell nicht gefuettert und nie catDetected gesendet - Katze und
// Maeher sind sich im Track zu aehnlich, und ein Fehlschuss auf den Maeher waere teuer
// (sein Regensensor liesse ihn die Arbeit einstellen); eine im Fenster verpasste Katze
// ist es nicht (Katzen meiden den laufenden Maeher ohnehin). t0 == t1 = deaktiviert,
// t0 > t1 laeuft ueber Mitternacht. Uhr nie gestellt (NTP seit Boot nicht erreichbar)
// -> fail-open, sonst waere das Geraet bis zum ersten NTP-Erfolg komplett blind.
bool ctInQuietWindow() {
  if (CTP.quiet_t0_min == CTP.quiet_t1_min) return false;
  static time_t cachedSec = 0; static bool cachedIn = false;   // localtime_r max. 1x/s
  time_t now = time(nullptr);
  if (now == cachedSec) return cachedIn;
  cachedSec = now;
  struct tm lt;
  localtime_r(&now, &lt);
  if (lt.tm_year + 1900 < 2020) { cachedIn = false; return false; }  // Uhr laeuft noch nicht
  int m = lt.tm_hour * 60 + lt.tm_min;
  cachedIn = (CTP.quiet_t0_min < CTP.quiet_t1_min)
               ? (m >= CTP.quiet_t0_min && m < CTP.quiet_t1_min)
               : (m >= CTP.quiet_t0_min || m < CTP.quiet_t1_min);
  return cachedIn;
}



// -------------------------------------------------------- Coverage-Polygone vom VPS
static CtCoveragePoly ctCov[CT_MAX_COV_POLYS];
static bool ctCovLoaded = false;

static void ctClearCoverage() {
  for (int i = 0; i < CT_MAX_COV_POLYS; i++) ctCov[i].used = false;
  ctCovLoaded = false;
}

// Anzahl aktuell geladener Erfassungs-Polygone (fuer Status-/Debug-Meldungen).
int ctCoverageCount() {
  int n = 0;
  for (int i = 0; i < CT_MAX_COV_POLYS; i++) if (ctCov[i].used) n++;
  return n;
}

static int ctNextCsv(String& line, int& pos) {
  int comma = line.indexOf(',', pos);
  String tok = (comma < 0) ? line.substring(pos) : line.substring(pos, comma);
  tok.trim();
  pos = (comma < 0) ? line.length() : comma + 1;
  return tok.toInt();
}

static bool ctApplyCoverageCsv(const String& body) {
  ctClearCoverage();
  int used = 0, start = 0;
  while (start < (int)body.length()) {
    int nl = body.indexOf('\n', start);
    String line = (nl < 0) ? body.substring(start) : body.substring(start, nl);
    line.trim();
    if (line.length() && line[0] != '#' && used < CT_MAX_COV_POLYS) {
      int pos = 0;
      int sender = ctNextCsv(line, pos);
      int sourceEnd = line.indexOf(',', pos);       // source: learned | default
      if (sourceEnd < 0) { if (nl < 0) break; start = nl + 1; continue; }
      String source = line.substring(pos, sourceEnd);
      source.trim();
      pos = sourceEnd + 1;
      int n = ctNextCsv(line, pos);
      if (sender >= 0 && sender < deviceCount && n >= 3) {
        if (n > CT_MAX_COV_VERTS) n = CT_MAX_COV_VERTS;
        CtCoveragePoly& p = ctCov[used];
        p.used = true; p.sender = (uint8_t)sender; p.n = (uint8_t)n;
        p.trusted = (source == "learned");
        bool ok = true;
        for (int i = 0; i < n; i++) {
          if (pos >= (int)line.length()) { ok = false; break; }
          p.x[i] = ctNextCsv(line, pos);
          p.y[i] = ctNextCsv(line, pos);
        }
        if (ok) used++; else p.used = false;
      }
    }
    if (nl < 0) break;
    start = nl + 1;
  }
  ctCovLoaded = used > 0;
  return ctCovLoaded;
}

bool ctLoadCoverageFile(const char* path) {
  File f = LittleFS.open(path, "r");
  if (!f) return false;
  String body = f.readString();
  f.close();
  return ctApplyCoverageCsv(body);
}

bool ctFetchCoverage() {
  if (WiFi.status() != WL_CONNECTED) return false;
  HTTPClient http;
  String url = "http://" + ipVPS.toString() + "/coverage_export.csv";
  if (!http.begin(url)) return false;
  http.setTimeout(PARAMS_FETCH_TIMEOUT_MS);
  int code = http.GET();
  bool ok = false;
  if (code == 200) {
    String body = http.getString();
    if (ctApplyCoverageCsv(body)) {
      File f = LittleFS.open(COVERAGE_PATH, "w");
      if (f) { f.print(body); f.close(); }
      ok = true;
    }
  }
  http.end();
  return ok;
}

static bool ctPointInCoveragePoly(const CtCoveragePoly& p, int32_t wx, int32_t wy) {
  bool inside = false;
  int j = p.n - 1;
  for (int i = 0; i < p.n; i++) {
    int32_t yi = p.y[i], yj = p.y[j];
    if ((yi > wy) != (yj > wy)) {
      double xint = (double)(p.x[j] - p.x[i]) * (double)(wy - yi) /
                    (double)((yj - yi) ? (yj - yi) : 1) + (double)p.x[i];
      if ((double)wx < xint) inside = !inside;
    }
    j = i;
  }
  return inside;
}

static float ctDistToSeg(int32_t px, int32_t py, int32_t ax, int32_t ay, int32_t bx, int32_t by) {
  float vx = (float)(bx - ax), vy = (float)(by - ay);
  float wx = (float)(px - ax), wy = (float)(py - ay);
  float den = vx * vx + vy * vy;
  float t = den > 0 ? (wx * vx + wy * vy) / den : 0.0f;
  if (t < 0) t = 0; if (t > 1) t = 1;
  float dx = (float)ax + t * vx - px, dy = (float)ay + t * vy - py;
  return sqrtf(dx * dx + dy * dy);
}

// SIGNIERTE Grenzdistanz ueber alle Polygone: innen = maximale Tiefe (>0),
// aussen = -minimale Distanz zum naechsten Polygonrand. So bekommt ein Track,
// der KNAPP AUSSERHALB der Abdeckung geboren wird (Normalfall beim Hereinlaufen),
// denselben Eintritts-Bonus wie im VPS-Referenzmodell (_edge_dist).
static float ctTypeWeight(uint8_t sender);

// Randlogik nur aus Sensoren, die allein bestaetigen koennten (Typ-Gewicht >=
// min_confirm_weight, heute die HLK-Radare): ein Lidar-Kreis (12 m) reicht weit
// ueber den Garten hinaus und liess JEDE Katze "mitten drin" auftauchen
// (2026-10-30: Recall 42 % -> 80 % an den markierten Tracks). Wie cov_senders im VPS.
static inline bool ctCovSensor(uint8_t sender) {
  return ctTypeWeight(sender) >= CTP.min_confirm_weight;
}

// Online = irgendeine Busmeldung (HB, Events, Pose) in den letzten CT_ONLINE_MS.
// Ein Offline-Sensor ueberwacht seinen Bereich nicht - er darf den Rand nicht
// verschieben (Mini_Dome offline liess Geburten vor Dome-C1 "mitten drin" sein).
#define CT_ONLINE_MS 60000UL
static uint32_t ctSeenMs[deviceCount];
static bool     ctSeenAny[deviceCount];

void ctNoteSeen(uint8_t sender) {
  if (sender >= deviceCount) return;
  ctSeenMs[sender] = millis();
  ctSeenAny[sender] = true;
}

static bool ctOnline(uint8_t sender) {
  return sender < deviceCount && ctSeenAny[sender] && millis() - ctSeenMs[sender] < CT_ONLINE_MS;
}

// mode 0 = vertrauenswuerdige Polygone (eingemessen + online), 1 = online, aber
// nicht eingemessen (Default-Sektor -> neutrale Zone)
static bool ctPolySelected(const CtCoveragePoly& p, int mode) {
  if (!p.used || !ctCovSensor(p.sender) || !ctOnline(p.sender)) return false;
  return mode == 0 ? p.trusted : !p.trusted;
}

static float ctPolygonBorderDist(int32_t wx, int32_t wy, int mode) {
  float inBest = -1.0f, outBest = 1e9f;
  for (int k = 0; k < CT_MAX_COV_POLYS; k++) {
    CtCoveragePoly& p = ctCov[k];
    if (!ctPolySelected(p, mode)) continue;
    float d = 1e9f;
    for (int i = 0; i < p.n; i++) {
      int j = (i + 1) % p.n;
      d = min(d, ctDistToSeg(wx, wy, p.x[i], p.y[i], p.x[j], p.y[j]));
    }
    if (ctPointInCoveragePoly(p, wx, wy)) { if (d > inBest) inBest = d; }
    else                                  { if (d < outBest) outBest = d; }
  }
  return (inBest >= 0) ? inBest : -outBest;
}

static bool ctAnySelected(int mode) {
  for (int k = 0; k < CT_MAX_COV_POLYS; k++) if (ctPolySelected(ctCov[k], mode)) return true;
  return false;
}

// ------------------------------------------------- Sensor-Posen & Erfassungsrand
static worldPose ctPose[deviceCount];        // validWorldPose=false solange unbekannt

void ctSetPose(uint8_t sender, const worldPosePayload& wp) {
  if (!wp.validWorldPose) return;            // ungueltige Posen nicht uebernehmen
  ctPose[sender].worldX = wp.worldX; ctPose[sender].worldY = wp.worldY;
  ctPose[sender].heading = wp.heading; ctPose[sender].mirror = wp.mirror;
  ctPose[sender].validWorldPose = true;
}

// Randlogik bei der Track-Geburt - treuer Nachbau von catmodel.birth_edge (VPS).
// Nur VERTRAUENSWUERDIGE Sensoren (online + eingemessen) bilden den Rand.
// true + dist (signiert, >0 innen) oder false = neutral (weder Bonus noch Abzug):
//   - kein vertrauenswuerdiger Sensor online, oder keine Coverage geladen
//     (die Datenblatt-Sektoren sind nicht eingemessen -> kein Sektor-Fallback mehr)
//   - ausserhalb der vertrauenswuerdigen, aber im Bereich eines online, nicht
//     eingemessenen Sensors (z.B. mobiler Compact Dome)
// "Rand" naeher als near_sensor_mm vor einem online Sensor = Nahfeld -> "mitten drin".
static bool ctBirthDist(int32_t wx, int32_t wy, float& dist) {
  if (!ctCovLoaded || !ctAnySelected(0)) return false;
  float d = ctPolygonBorderDist(wx, wy, 0);
  float edge = CTP.edge_dist_mm;
  dist = d;
  if (d > edge) return true;
  if (d < 0 && ctAnySelected(1) && ctPolygonBorderDist(wx, wy, 1) >= 0) return false;
  if (fabsf(d) <= edge && CTP.near_sensor_mm > 0) {
    for (int i = 0; i < deviceCount; i++) {
      if (!ctPose[i].validWorldPose || !ctOnline(i) || !ctCovSensor(i)) continue;
      float dx = (float)(wx - ctPose[i].worldX), dy = (float)(wy - ctPose[i].worldY);
      if (sqrtf(dx * dx + dy * dy) <= CTP.near_sensor_mm) { dist = edge + 1.0f; return true; }
    }
  }
  return true;
}

// ------------------------------------------------------------- Sturm je Sensor
// Wie detect_storms: hohe Rate UND grosse raeumliche Streuung (0,5-s-Zeitscheiben).
// Ein stuermischer Sensor (Regen, Sonnen-Burst) fuettert das Tracking NICHT.
static CtStormSlot ctStorm[deviceCount][CT_STORM_SLOTS];

static bool ctStormFeedAndCheck(uint8_t sender, double t, int32_t wx, int32_t wy) {
  uint32_t key = (uint32_t)(t * 2.0);        // 0,5-s-Scheibe
  CtStormSlot& s = ctStorm[sender][key % CT_STORM_SLOTS];
  if (s.key != key) { s.key = key; s.cnt = 0; s.x0 = s.x1 = wx; s.y0 = s.y1 = wy; }
  s.cnt++;
  if (wx < s.x0) s.x0 = wx; if (wx > s.x1) s.x1 = wx;
  if (wy < s.y0) s.y0 = wy; if (wy > s.y1) s.y1 = wy;

  int slotsPerWin = (int)(CTP.storm_window_s * 2.0f + 0.5f);
  if (slotsPerWin < 1) slotsPerWin = 1;
  if (slotsPerWin > CT_STORM_SLOTS) slotsPerWin = CT_STORM_SLOTS;
  uint32_t total = 0; int nonEmpty = 0, wide = 0;
  for (int i = 0; i < CT_STORM_SLOTS; i++) {
    CtStormSlot& q = ctStorm[sender][i];
    if (q.cnt == 0 || key - q.key >= (uint32_t)slotsPerWin) continue;   // ausserhalb Fenster
    total += q.cnt; nonEmpty++;
    float dx = q.x1 - q.x0, dy = q.y1 - q.y0;
    if (sqrtf(dx * dx + dy * dy) >= CTP.storm_scatter_mm) wide++;
  }
  uint32_t need = (uint32_t)max((float)CTP.storm_min_events,
                                CTP.storm_rate_evts_s * CTP.storm_window_s);
  // Median-Ersatz: mindestens die Haelfte der belegten Scheiben ist weit gestreut
  return total >= need && nonEmpty > 0 && wide * 2 >= nonEmpty;
}

// -------------------------------------------------------------------- Tracks
static CtTrack ctTr[CT_MAX_TRACKS];

static float ctTypeWeight(uint8_t sender) {
  byte tp = device[sender].type;
  if (tp == HLK)   return CTP.w_hlk;
  if (tp == Lidar) return CTP.w_lidar;
  return CTP.w_default;
}

// chronologisch i-ter Ringpunkt (0 = aeltester)
static inline int ctRingIdx(const CtTrack& tr, int i) {
  return (tr.rh - tr.rn + i + 2 * CT_RING) % CT_RING;
}

// kohaerente Bewegungsphase im Fenster, das mit dem NEUSTEN Punkt endet
// (_find_move prueft alle Fenster - im Streaming kommt jedes Fensterende als
// eigener Punkt an, damit ist die Abdeckung dieselbe).
static bool ctCheckMove(const CtTrack& tr) {
  int first = -1;
  double tNew = tr.rt[ctRingIdx(tr, tr.rn - 1)];
  for (int i = 0; i < tr.rn; i++)
    if (tNew - tr.rt[ctRingIdx(tr, i)] <= CTP.move_window_s) { first = i; break; }
  if (first < 0) return false;
  int cnt = tr.rn - first;
  if (cnt < CTP.move_min_points) return false;
  int a = ctRingIdx(tr, first), b = ctRingIdx(tr, tr.rn - 1);
  float dx = tr.rx[b] - tr.rx[a], dy = tr.ry[b] - tr.ry[a];
  if (sqrtf(dx * dx + dy * dy) < CTP.move_min_net_mm) return false;
  int ok = 0, vs = 0;
  uint32_t senders = 0;
  for (int i = first; i < tr.rn; i++) {
    int ci = ctRingIdx(tr, i);
    senders |= (1u << tr.rs[ci]);
    if (i == first) continue;
    int pi = ctRingIdx(tr, i - 1);
    double dt = tr.rt[ci] - tr.rt[pi];
    if (dt <= 0) continue;
    float ddx = tr.rx[ci] - tr.rx[pi], ddy = tr.ry[ci] - tr.ry[pi];
    float v = sqrtf(ddx * ddx + ddy * ddy) / (float)dt;
    vs++;
    if (v >= CTP.speed_min_mm_s && v <= CTP.speed_max_mm_s) ok++;
  }
  if (vs == 0 || (float)ok / vs < CTP.speed_ok_ratio) return false;
  float wsum = 0;
  for (int s = 0; s < deviceCount; s++)
    if (senders & (1u << s)) wsum += ctTypeWeight(s);
  return wsum >= CTP.min_confirm_weight;
}

// sitzt der Track gerade stabil? (_stationary_end auf dem Ring)
static bool ctCheckStationary(const CtTrack& tr) {
  double tEnd = tr.tLast;
  int first = -1;
  for (int i = 0; i < tr.rn; i++)
    if (tEnd - tr.rt[ctRingIdx(tr, i)] <= CTP.stationary_end_s) { first = i; break; }
  if (first < 0) return false;
  int cnt = tr.rn - first;
  if (cnt < 3) return false;
  if (tEnd - tr.rt[ctRingIdx(tr, first)] < CTP.stationary_end_s * 0.6f) return false;
  float cx = 0, cy = 0;
  for (int i = first; i < tr.rn; i++) { int ci = ctRingIdx(tr, i); cx += tr.rx[ci]; cy += tr.ry[ci]; }
  cx /= cnt; cy /= cnt;
  for (int i = first; i < tr.rn; i++) {
    int ci = ctRingIdx(tr, i);
    float dx = tr.rx[ci] - cx, dy = tr.ry[ci] - cy;
    if (sqrtf(dx * dx + dy * dy) > CTP.stationary_radius_mm) return false;
  }
  return true;
}

// Score kausal bewerten und ggf. catDetected ausloesen
// Laufrichtung am Ende des Tracks (letzte 2 s im Ring), Vektor in mm
static void ctHeading(const CtTrack& tr, float& hx, float& hy) {
  hx = hy = 0;
  for (int i = tr.rn - 1; i >= 0; i--) {
    int ci = ctRingIdx(tr, i);
    if (tr.tLast - tr.rt[ci] > 2.0) break;
    hx = tr.xLast - tr.rx[ci]; hy = tr.yLast - tr.ry[ci];
  }
}

// Austritt einer bestaetigten Katze merken, bevor ihr Track-Platz frei wird
static CtExit ctEx[CT_EXITS];
static void ctNoteExit(const CtTrack& tr) {
  if (!tr.used || !tr.reported || tr.dead) return;
  int slot = 0;                        // freien Platz, sonst den aeltesten
  for (int i = 0; i < CT_EXITS; i++) {
    if (!ctEx[i].used) { slot = i; break; }
    if (ctEx[i].t < ctEx[slot].t) slot = i;
  }
  CtExit& e = ctEx[slot];
  e.used = true; e.t = tr.tLast; e.x = tr.xLast; e.y = tr.yLast;
  ctHeading(tr, e.hx, e.hy);
}

// Setzt eine Geburt bei (wx, wy) zur Zeit t eine bestaetigte Katze fort? Wie
// catmodel._cont_match: Luecke, Distanz, Tempo ueber die Luecke, Richtung.
static bool ctContOne(double te, int32_t xe, int32_t ye, float hx, float hy,
                      double t, int32_t wx, int32_t wy) {
  double gt = t - te;
  if (gt < 0 || gt > CTP.cont_gap_s) return false;
  float gx = wx - xe, gy = wy - ye, gd = sqrtf(gx * gx + gy * gy);
  if (gd > CTP.cont_dist_mm) return false;
  float v = gd / (float)max(gt, 0.2);
  if (v > CTP.cont_v_max_mm_s || (v < CTP.cont_v_min_mm_s && gd > CTP.cont_near_mm)) return false;
  float hd = sqrtf(hx * hx + hy * hy);
  if (hd > 300 && gd > 300) {
    float cs = (hx * gx + hy * gy) / (hd * gd);
    if (cs < cosf(CTP.cont_angle_deg * (float)M_PI / 180.0f)) return false;
  }
  return true;
}

static bool ctContMatch(double t, int32_t wx, int32_t wy) {
  if (!CTP.cont_confirm) return false;
  for (int i = 0; i < CT_MAX_TRACKS; i++) {
    const CtTrack& a = ctTr[i];
    if (!a.used || !a.reported || a.dead) continue;
    float hx, hy; ctHeading(a, hx, hy);
    if (ctContOne(a.tLast, a.xLast, a.yLast, hx, hy, t, wx, wy)) return true;
  }
  for (int i = 0; i < CT_EXITS; i++)
    if (ctEx[i].used && ctContOne(ctEx[i].t, ctEx[i].x, ctEx[i].y, ctEx[i].hx, ctEx[i].hy, t, wx, wy))
      return true;
  return false;
}

static void ctTrackPayload(const CtTrack& tr, bool stationary, catDetectedPayload& cd) {
  cd.worldX = tr.xLast; cd.worldY = tr.yLast;
  cd.score = (uint8_t)CTP.confirm_score;
  cd.flags = (stationary ? catDetFlagStationary : 0) | (tr.fusion ? catDetFlagFusion : 0);
  cd.trackMs = (uint32_t)((tr.tLast - tr.t0) * 1000.0);
  float ndx = tr.xLast - tr.x0, ndy = tr.yLast - tr.y0;
  cd.netMm = (int32_t)sqrtf(ndx * ndx + ndy * ndy);
}

static void ctEvaluate(CtTrack& tr, bool stationaryNow) {
  if (tr.dead || tr.reported) return;
  if (CTP.max_path_mm > 0 && tr.path > CTP.max_path_mm) {   // Maeher/Person: hartes K.o.
    tr.dead = true;
    return;
  }
  if (tr.cont && tr.n >= 2) {          // Fortsetzung: dieselbe Katze, kein neues catDetected -
    tr.reported = true;                // die Aktoren folgen per catTracked weiter
    tr.tTracked = tr.tLast;
    catDetectedPayload cd;
    ctTrackPayload(tr, stationaryNow, cd);
    announceTrack(cd);
    if (deviceActive() && !ctInQuietWindow())
      sendUdpTextln("CatIdent: Fortsetzung einer bestaetigten Katze bei x=" + String(tr.xLast) +
                    " y=" + String(tr.yLast));
    return;
  }
  if (!tr.moveFound && !tr.eyes) return;                   // Pflicht wie im VPS-Modell
  int score = tr.moveFound ? CTP.score_move : 0;
  if (tr.eyes) score += CTP.score_eyes;                     // Augen-Bestaetigung (Kamera)
  float ndx = tr.xLast - tr.x0, ndy = tr.yLast - tr.y0;
  float net = sqrtf(ndx * ndx + ndy * ndy);
  if (net >= CTP.crossing_net_mm) score += CTP.score_crossing;
  if ((int)tr.n >= CTP.long_track_points) score += CTP.score_long;
  if (tr.tLast - tr.t0 < CTP.short_track_s) score -= CTP.penalty_short;
  if (tr.fusion) score += CTP.score_fusion;
  if (tr.birthValid) {                                      // Randlogik war bei Geburt aktiv
    // wie VPS _edge_dist: nahe der Grenze (innen ODER knapp aussen) = Eintritt;
    // tief in der Abdeckung aufgetaucht = weicher Malus; weit aussen = neutral.
    if (fabsf(tr.birthDist) <= CTP.edge_dist_mm)  score += CTP.score_entry;
    else if (tr.birthDist > CTP.edge_dist_mm)     score -= CTP.penalty_mid_birth;
  }
  if (stationaryNow) score += CTP.score_stationary;
  if (score < 0) score = 0; if (score > 100) score = 100;

  if (score >= CTP.confirm_score) {
    tr.reported = true;
    catDetectedPayload cd;
    cd.worldX = tr.xLast; cd.worldY = tr.yLast;
    cd.score = (uint8_t)score;
    cd.flags = (stationaryNow ? catDetFlagStationary : 0) |
               (tr.fusion ? catDetFlagFusion : 0);
    cd.trackMs = (uint32_t)((tr.tLast - tr.t0) * 1000.0);
    cd.netMm = (int32_t)net;
    announceCat(cd);
  }
}

// neues catObserved (Welt-mm) ins Modell
void ctFeed(uint8_t sender, int32_t wx, int32_t wy) {
  double t = ctNow();
  if (ctStormFeedAndCheck(sender, t, wx, wy)) return;       // Sturm: keine Evidenz

  // beste Fortsetzung suchen (Gate; nach track_gap bis stitch_gap: Naht wie stitch_tracks)
  int best = -1; float bestd = 1e12f;
  for (int i = 0; i < CT_MAX_TRACKS; i++) {
    CtTrack& tr = ctTr[i];
    if (!tr.used) continue;
    double dt = t - tr.tLast;
    if (dt > CTP.stitch_gap_s) { ctNoteExit(tr); tr.used = false; continue; }   // abgelaufen
    float gate = (dt <= CTP.track_gap_s)
                   ? CTP.gate_base_mm + CTP.gate_speed_mm_s * (float)max(dt, 0.0)
                   : CTP.stitch_dist_mm;
    float dx = wx - tr.xLast, dy = wy - tr.yLast;
    float d = sqrtf(dx * dx + dy * dy);
    if (d <= gate && d < bestd) { best = i; bestd = d; }
  }
  if (best < 0) {                                           // neuer Track
    int slot = -1; double oldest = 1e18;
    for (int i = 0; i < CT_MAX_TRACKS; i++)
      if (!ctTr[i].used) { slot = i; break; }
    if (slot < 0)                                           // alle belegt: aeltesten opfern
      for (int i = 0; i < CT_MAX_TRACKS; i++)
        if (ctTr[i].tLast < oldest) { oldest = ctTr[i].tLast; slot = i; }
    bool cont = ctContMatch(t, wx, wy);
    CtTrack& tr = ctTr[slot];
    ctNoteExit(tr);                                         // geopferte bestaetigte Katze merken
    memset(&tr, 0, sizeof(tr));
    tr.cont = cont;
    tr.used = true;
    tr.t0 = tr.tLast = t;
    tr.x0 = tr.xLast = wx; tr.y0 = tr.yLast = wy;
    tr.birthDist = 0.0f;
    tr.birthValid = ctBirthDist(wx, wy, tr.birthDist);
    best = slot;
  }
  CtTrack& tr = ctTr[best];

  // Fusion: anderer Sender sieht dasselbe Objekt fast gleichzeitig am fast selben Ort
  if (!tr.fusion) {
    for (int i = tr.rn - 1; i >= 0; i--) {
      int ci = ctRingIdx(tr, i);
      if (t - tr.rt[ci] > CTP.fusion_time_s) break;
      if (tr.rs[ci] == sender) continue;
      float dx = wx - tr.rx[ci], dy = wy - tr.ry[ci];
      if (sqrtf(dx * dx + dy * dy) <= CTP.fusion_distance_mm) { tr.fusion = true; break; }
    }
  }

  // Punkt anhaengen
  float dx = wx - tr.xLast, dy = wy - tr.yLast;
  if (tr.n > 0) {
    float step = sqrtf(dx * dx + dy * dy);
    tr.path += step;
    mowNotePath(tr.path, step);                             // Maeher-Fahrspuren (mowGuard.ino)
  }
  tr.tLast = t; tr.xLast = wx; tr.yLast = wy;
  tr.n++;
  tr.senderMask |= (1u << sender);
  tr.rt[tr.rh] = t; tr.rx[tr.rh] = wx; tr.ry[tr.rh] = wy; tr.rs[tr.rh] = sender;
  tr.rh = (tr.rh + 1) % CT_RING;
  if (tr.rn < CT_RING) tr.rn++;

  if (!tr.moveFound && ctCheckMove(tr)) tr.moveFound = true;
  bool wasReported = tr.reported;
  bool stationary = ctCheckStationary(tr);
  ctEvaluate(tr, stationary);
  // Bestaetigter Track: Position fuer die Aktoren nachfuehren (catTracked), hoechstens
  // alle CT_TRACKED_S. Der Punkt der Bestaetigung selbst ging schon als catDetected raus.
  if (wasReported && t - tr.tTracked >= CT_TRACKED_S) {
    tr.tTracked = t;
    catDetectedPayload cd;
    ctTrackPayload(tr, stationary, cd);
    announceTrack(cd);
  }
}

// Augen-Meldung der Kamera (visionObserved sensor 1): jede Spur, deren letzter Punkt
// hoechstens eye_time_s alt und eye_dist_mm entfernt ist, gilt ab jetzt als Katze -
// wie catmodel._eye_time (VPS). Allein (ohne Spur) bewirken Augen nichts.
void ctEyes(int32_t wx, int32_t wy) {
  if (!CTP.eye_confirm) return;
  double t = ctNow();
  for (int i = 0; i < CT_MAX_TRACKS; i++) {
    CtTrack& tr = ctTr[i];
    if (!tr.used || tr.dead || tr.eyes) continue;
    double dt = t - tr.tLast;
    if (dt < 0 || dt > CTP.eye_time_s) continue;
    float dx = wx - tr.xLast, dy = wy - tr.yLast;
    if (sqrtf(dx * dx + dy * dy) > CTP.eye_dist_mm) continue;
    tr.eyes = true;
    ctEvaluate(tr, ctCheckStationary(tr));
  }
}

// periodisch: abgelaufene Tracks freigeben (Speicherhygiene; die Bestaetigung
// ist laengst gefallen oder faellt nicht mehr)
void ctTick() {
  static unsigned long lastSweep = 0;
  if (millis() - lastSweep < 2000) return;
  lastSweep = millis();
  double t = ctNow();
  for (int i = 0; i < CT_MAX_TRACKS; i++)
    if (ctTr[i].used && t - ctTr[i].tLast > CTP.stitch_gap_s) { ctNoteExit(ctTr[i]); ctTr[i].used = false; }
}
