smily77/CatFind/Controller/Manager6_3_0/xComProc6_3.h

//boolean setUpWifi(int lastOctet)
//void initMcUdp()
//void initUnicast()
//bool parseXMsg(AsyncUDPPacket &packet, xMsg &m)
//bool getPayload(const xMsg &m, T &out)                          - typsicher, prüft payloadLen
//bool getHbPayload(const xMsg &m, hbPayload &out)                - Basisteil aller HB-Varianten
//bool broadcastMsg(uint8_t msgCode, const void* payload, uint8_t len)
//bool broadcastMsg(uint8_t msgCode, const T &payload)
//bool broadcastMsg(uint8_t msgCode)                              - ohne Payload
//void broadcastRawMsg(const xMsg &m)                             - Header unverändert (Simulator-Playback)
//bool unicastMsg(uint8_t msgCode, const void* payload, uint8_t len, uint8_t lastOctet)
//bool unicastMsg(uint8_t msgCode, const T &payload, uint8_t lastOctet)
//void setUpTime()
//void setUpOTA()
//void initPixel()
//void setPixel(byte led, uint32_t farbe)
//void allPixel(uint32_t farbe)
//void printSensorData(const xMsg &m)
//void printTimePreamble(const xMsg &m)
//void printCmdData(const xMsg &m)
//void toPol(int x, int y, float &phi,float &radius)
//void toKart(int &x, int &y, float phi, float radius)
//void toPaPol(int x, int y, float &phi,float &radius)
//void toPaKart(int &x, int &y, float phi, float radius)
//void localToWorld(int xl, int yl, const worldPose &p, int &xw, int &yw)  - lokal -> Welt (kartesisch)
//void worldToLocal(int xw, int yw, const worldPose &p, int &xl, int &yl)  - Welt -> lokal (kartesisch)
//void savePose(const worldPose &p)                              - Ist-Pose ins NVS schreiben
//bool loadPose(worldPose &p)                                    - Ist-Pose aus NVS lesen (validWorldPose bleibt false)
//void clearPose()                                               - gespeicherte Pose im NVS loeschen (erzwingt Neukalibrierung)
//void initSettings() / saveSettings() / bool settingOn(idx)     - Geraete-Einstellungen (NVS "devcfg", STG_*-Masken aus hwDef)
//void sendSettingsReport() / sendPoseReport()                   - eigene Einstellungen / Welt-Pose broadcasten
//bool handleCommonMsg(const xMsg&)                              - settingsRequest/poseRequest/cmdSetSetting generisch behandeln
//bool copyPoseFromGroup(waitMs)                                 - Welt-Pose eines Gruppenmitglieds uebernehmen (Aktion actCopyPose)
//uint32_t crc32Bytes(const uint8_t* d, size_t n)                - CRC32 (zlib-kompatibel)
//bool mapFileInfo(const char* path, uint16_t& v, uint32_t& crc, uint32_t& len)  - LittleFS-Karte: Version/CRC/Laenge
//bool serveMap(uint8_t mapType, const char* path, uint8_t reqOctet)  - Karte gechunkt an Anforderer senden (Manager)
//bool requestMap(uint8_t mapType, uint8_t managerOctet)         - Karte beim Manager anfordern (Sensor)
//bool mapBeginRx(mapRxState&, const mapInfoPayload&, const char* path)  - Empfang starten
//int  mapFeedChunk(mapRxState&, const xMsg&)                    - Chunk verarbeiten (0=weiter,1=fertig,-1=Fehler)
//bool loadNoShot(const char* path)                             - Polygon-Karte (No-Shot/Rasen) aus LittleFS-CSV in RAM laden
//bool insideNoShot(int32_t xw, int32_t yw)                     - Welt-Punkt in der geladenen Polygon-Karte? (Point-in-Polygon)
//bool acquireMap(uint8_t mapType, const char* path, uint8_t mgrOctet, unsigned long waitMs)  - Karte vom Manager beziehen/cachen
//bool acquireNoShot(const char* path, uint8_t mgrOctet, unsigned long waitMs)  - Kurzform: acquireMap(mapNoShot, ...)
//bool vpsLocalize(scan,n, x,y,head,mir,conf,inlier)            - Scan an den VPS, Pose+inlier zurueck (nur mit USE_VPS_LOCALIZE)
//void resolvePose(vpsOk,vx,vy,vh,vmir,conf,inlier, hadNVS,minInlier)  - Quality-Gate: nur hochwertige Pose uebernehmen, sonst NVS behalten
//void fillWorld(posPayload&)                                    - relative x/y -> worldX/worldY/worldValid ueber myPose
//void coCalibBegin/FeedLocal/FeedWorld(coCalState&, ...)        - Co-Observation: Eigen-/Welt-Trajektorien sammeln (je Sender getrennt)
//bool coCalibElapsed(coCalState&)                               - Sammelfenster abgelaufen?
//bool coCalibFinish(coCalState&, minInlier)                     - Bahnen an VPS /calibrate, Pose mit Gate uebernehmen (nur USE_VPS_CALIBRATE)
//bool coObserveCheck(coHealth&, lxr,lyr, wxLidar,wyLidar, gateMm,assocMm,maxBad)  - Health-Check: Welt-Residuum, true = Pose driftet
//uint8_t getLastIpByte()
//void initText2Udp()
//size_t sendUdpText(const String& text)
//size_t sendUdpTextln(const String& text)

// Ausserhalb
void writelnComment(String comment);
void writeComment(String comment);

// UDP-Text
size_t sendUdpText(const String& text);
size_t sendUdpTextln(const String& text);

// Netz / Hilfsfunktionen
uint8_t getLastIpByte();

// Zeit & WiFi
void    setUpTime();
boolean setUpWifi(int lastOctet);

// UDP: Init & Text-MC
void    initMcUdp();
void    initText2Udp();
void    initUnicast();

// UDP: Senden (Broadcast und Unicast im selben Format)
bool    broadcastMsg(uint8_t msgCode, const void* payload, uint8_t len);
bool    unicastMsg(uint8_t msgCode, const void* payload, uint8_t len, uint8_t lastOctet);
void    broadcastRawMsg(const xMsg &m);

// OTA
void    setUpOTA();

// Ausgabe / Debug
void    printTimePreamble(const xMsg &m);
void    printSensorData(const xMsg &m);
void    printCmdData(const xMsg &m);

// LED-Helfer (nur wenn containLed definiert ist)
#ifdef containLed
void    initPixel();
void    setPixel(byte led, uint32_t farbe);
void    allPixel(uint32_t farbe);
#endif

// Koordinaten-Umrechnung
void    toPol(int x, int y, float &phi, float &radius);
void    toKart(int &x, int &y, float phi, float radius);
void    toPaPol(int x, int y, float &phi, float &radius);
void    toPaKart(int &x, int &y, float phi, float radius);

// Welt-/Lokal-Transformation und Pose-Persistenz
void    localToWorld(int xl, int yl, const worldPose &p, int &xw, int &yw);
void    worldToLocal(int xw, int yw, const worldPose &p, int &xl, int &yl);
void    savePose(const worldPose &p);
bool    loadPose(worldPose &p);


size_t sendUdpText(const String& text) {
  return udpText.writeTo(
    reinterpret_cast<const uint8_t*>(text.c_str()),
    text.length(),
    multiCastIP, MC_Text_PORT
  );
}

size_t sendUdpTextln(const String& text) {
  String line = text; line += "\r\n";
  return sendUdpText(line);
}

uint8_t getLastIpByte() {
  IPAddress ip = WiFi.localIP();
  return ip[3];
}

#ifndef NTP_WAIT_MS
#define NTP_WAIT_MS 15000   // max. Wartezeit auf NTP - vorher Endlosschleife ohne OTA-Ausweg:
#endif                      // Internet-Ausfall beim Boot liess das Geraet dauerhaft haengen
void setUpTime() {
  writelnComment("set up Time");
  #ifdef containLed
   if (maxPix > pixelNum) allPixel(0xFFFF00);
     else setPixel(minPix,0xFFFF00);
  #endif
  configTzTime(time_zone, ntpServer1, ntpServer2);
  unsigned long t0 = millis();
  while (!getLocalTime(&timeinfo, 200) && millis() - t0 < NTP_WAIT_MS) delay(50);
  if (!getLocalTime(&timeinfo, 200)) writelnComment("NTP nicht erreichbar - weiter ohne Uhrzeit");
  #ifdef containLed
    if (maxPix > pixelNum) allPixel(0x000000);
      else setPixel(minPix,0x000000);
  #endif
}
boolean setUpWifi(int lastOctet) {
  writelnComment("start WiFi");
  WiFi.mode(WIFI_STA);
  if (lastOctet >= 150 && lastOctet <= 195) {
    IPAddress localIP(192, 168, 0, lastOctet);
    IPAddress gateway(192, 168, 0, 1);
    IPAddress subnet(255, 255, 255, 0);
    if (!WiFi.config(localIP, gateway, subnet))
      if (DEBUG) Serial << "Fehler: Statische IP-Konfiguration fehlgeschlagen. Fallback auf DHCP." << endl;
  }
   WiFi.begin(ssid, password);
  do {
    #ifdef containLed
      if (maxPix > pixelNum) allPixel(0xFF0000);
        else setPixel(minPix,0xFF0000);
    #endif
    writeComment(".");
    delay(250);
     #ifdef containLed
       if (maxPix > pixelNum) allPixel(0x000000);
         else setPixel(minPix,0x000000);
    #endif
    writeComment("-");
    delay(250);
  } while (WiFi.status() != WL_CONNECTED);
  writelnComment(" ");
  writelnComment(WiFi.localIP().toString());
  #ifdef containLed
    setPixel(minPix,0x000000);
  #endif
  return true;
}

//---------------------------------------------------------------------------------------
// Protokoll 6.3: Empfangen
//---------------------------------------------------------------------------------------
// Paket prüfen (Version, Länge) und in xMsg kopieren
bool parseXMsg(AsyncUDPPacket &packet, xMsg &m) {
  if (packet.length() < sizeof(msgHeader)) return false;
  memcpy(&m.header, packet.data(), sizeof(msgHeader));
  if (m.header.version != XCOM_VERSION) return false;
  if (m.header.sender >= deviceCount) return false;  // sender indexiert device[] -> OOB-Schutz
  if (m.header.payloadLen > maxPayloadLen) return false;
  if (packet.length() != sizeof(msgHeader) + m.header.payloadLen) return false;
  if (m.header.payloadLen) memcpy(m.payload, packet.data() + sizeof(msgHeader), m.header.payloadLen);
  return true;
}

// Payload typsicher auslesen - false wenn die Länge nicht zum Struct passt
template <typename T>
bool getPayload(const xMsg &m, T &out) {
  if (m.header.payloadLen != sizeof(T)) return false;
  memcpy(&out, m.payload, sizeof(T));
  return true;
}

// HB-Basisteil auslesen - funktioniert für hbPayload, pa2HbPayload und radarHbPayload,
// weil der gemeinsame Teil bei allen HB-Varianten am Anfang steht
bool getHbPayload(const xMsg &m, hbPayload &out) {
  if (m.header.msgCode != HB) return false;
  if (m.header.payloadLen < sizeof(hbPayload)) return false;
  memcpy(&out, m.payload, sizeof(hbPayload));
  return true;
}

// Optionale Multicast-Empfangsqueue: definiert ein Geraet VOR dem Include
// MC_QUEUE_LEN (z.B. der Manager als Gateway), sammelt der AsyncUDP-Callback
// die Nachrichten in einem SPSC-Ringpuffer statt im Single-Buffer lastMcMsg.
// Der Callback laeuft in einem eigenen Task und fuellt die Queue auch WAEHREND
// der Sketch blockiert (z.B. HTTP-POST an den VPS) - vorher gingen dabei
// regelmaessig Events verloren (nur EIN Puffer + Flag).
#ifdef MC_QUEUE_LEN
static xMsg mcQueue[MC_QUEUE_LEN];
static volatile uint8_t  mcQHead = 0, mcQTail = 0;   // head: Callback schreibt, tail: loop liest
static volatile uint16_t mcQDropped = 0;             // Queue voll -> Paket verworfen (Zaehler)

bool mcQueuePop(xMsg& out) {
  if (mcQTail == mcQHead) return false;
  out = mcQueue[mcQTail];
  mcQTail = (uint8_t)((mcQTail + 1) % MC_QUEUE_LEN);
  return true;
}
uint16_t mcQueueDropped() { uint16_t d = mcQDropped; mcQDropped = 0; return d; }
#endif

// Karten-Anfragen (Unicast) ebenfalls queuen statt in den EINEN lastUcMsg-Puffer zu
// legen (nur der Manager definiert MAP_REQ_QUEUE_LEN - Sensoren brauchen den Puffer
// unveraendert fuer waitForUc/acquireMap). Nach jedem mapInfo-Announce fragen ALLE
// Sensoren praktisch gleichzeitig an; der Callback ueberschrieb lastUcMsg dann mehrmals,
// bevor loop() ihn einmal las -> alle bis auf einen bekamen kein mapInfo und liefen auf
// der alten Karte weiter ("Karte N: kein mapInfo von .X -> lokale Karte").
#ifdef MAP_REQ_QUEUE_LEN
struct mapReqQEntry { uint8_t mapType; uint8_t octet; };
static mapReqQEntry mapReqQueue[MAP_REQ_QUEUE_LEN];
static volatile uint8_t  mapReqQHead = 0, mapReqQTail = 0;
static volatile uint16_t mapReqQDropped = 0;

bool mapReqQueuePop(uint8_t& mapType, uint8_t& octet) {
  if (mapReqQTail == mapReqQHead) return false;
  mapType = mapReqQueue[mapReqQTail].mapType;
  octet   = mapReqQueue[mapReqQTail].octet;
  mapReqQTail = (uint8_t)((mapReqQTail + 1) % MAP_REQ_QUEUE_LEN);
  return true;
}
uint16_t mapReqQueueDropped() { uint16_t d = mapReqQDropped; mapReqQDropped = 0; return d; }
#endif

//Udp
void initMcUdp() {
  writelnComment("init UdP MC");
  if (udpMc.listenMulticast(multiCastIP, MC_PORT)) {
    // Callback registrieren: wird automatisch aufgerufen, sobald ein Paket eintrifft
    udpMc.onPacket([](AsyncUDPPacket packet) {
      xMsg m;
      if (!parseXMsg(packet, m)) return; // falsche Version/Länge/sender -> ignorieren
      if (m.header.msgCode == HB) {
        hbPayload hb;
        if (getHbPayload(m, hb)) device[m.header.sender].IP = hb.ip;
      }
      #ifdef MC_QUEUE_LEN
        uint8_t nh = (uint8_t)((mcQHead + 1) % MC_QUEUE_LEN);
        if (nh == mcQTail) { mcQDropped++; return; }     // Queue voll
        mcQueue[mcQHead] = m;
        mcQHead = nh;
      #else
        lastMcMsg = m;
        // Flag setzen, damit der Sketch das abrufen kann
        mcDataReceived = true;
      #endif
    });
  } else {
    // Falls listenMulticast fehlgeschlagen ist, kann man hier Debug machen
    if (DEBUG) Serial << "AsyncUDP: Konnte Multicast nicht anfangen zu lauschen" << endl;
  }
}
//-------------------------------------------------------------------------------------------
void initText2Udp() {
  writelnComment("init UdP Text");

  if (udpText.listenMulticast(multiCastIP, MC_Text_PORT)) {
    udpText.onPacket([](AsyncUDPPacket packet) {
      udpTextMsg = String((char*)packet.data(), packet.length());
      udpTextReceived = true;
    });
  } else {
    if (DEBUG) Serial << "Udp Text failed" << endl;
  }
}
//------------------------------------------------------------------------------------------------
void initUnicast() {
  writelnComment("init UdP UC");
  if (udpUc.listen(UC_PORT)) {
    // Callback: wird aufgerufen, wenn ein UDP-Paket (jeder Absender) auf Port UC_PORT eintrifft
    udpUc.onPacket([](AsyncUDPPacket packet) {
      xMsg m;
      if (!parseXMsg(packet, m)) return;
      #ifdef MAP_REQ_QUEUE_LEN
        // Karten-Anfragen kommen im Pulk (nach einem Announce) - in die eigene Queue,
        // damit sie sich nicht gegenseitig aus lastUcMsg draengen.
        if (m.header.msgCode == mapRequest) {
          mapReqPayload req;
          if (getPayload(m, req)) {
            uint8_t nh = (uint8_t)((mapReqQHead + 1) % MAP_REQ_QUEUE_LEN);
            if (nh == mapReqQTail) { mapReqQDropped++; return; }   // Queue voll
            mapReqQueue[mapReqQHead].mapType = req.mapType;
            mapReqQueue[mapReqQHead].octet   = packet.remoteIP()[3];
            mapReqQHead = nh;
          }
          return;
        }
      #endif
      lastUcMsg = m;
      lastUcSenderOctet = packet.remoteIP()[3];  // fuer gezielte Antwort
      ucDataReceived = true;  // Flag setzen
    });
  } else {
    if (DEBUG) Serial.println("AsyncUDP: Konnte Unicast-Socket nicht öffnen!");
  }
}

//---------------------------------------------------------------------------------------
// Protokoll 6.3: Senden - Header wird hier automatisch gefüllt
//---------------------------------------------------------------------------------------
bool sendXMsg(AsyncUDP &sock, uint8_t msgCode, const void* payload, uint8_t len, const IPAddress &ip, uint16_t port) {
  if (len > maxPayloadLen) return false;
  uint8_t buf[sizeof(msgHeader) + maxPayloadLen];
  msgHeader h;
  h.version    = XCOM_VERSION;
  h.sender     = ID;
  h.msgCode    = msgCode;
  h.payloadLen = len;
  time_t t;
  time(&t);
  h.timeStamp  = t;
  memcpy(buf, &h, sizeof(msgHeader));
  if (len) memcpy(buf + sizeof(msgHeader), payload, len);
  sock.writeTo(buf, sizeof(msgHeader) + len, ip, port);
  return true;
}

// Broadcast: Multicast an alle Geräte
bool broadcastMsg(uint8_t msgCode, const void* payload, uint8_t len) {
  return sendXMsg(udpMc, msgCode, payload, len, multiCastIP, MC_PORT);
}

// Unicast an ein einzelnes Gerät (letztes IP-Oktett, z.B. device[PA2i].IP)
bool unicastMsg(uint8_t msgCode, const void* payload, uint8_t len, uint8_t lastOctet) {
  if (lastOctet == 0) return false;
  IPAddress destIP(192, 168, 0, lastOctet);
  return sendXMsg(udpUc, msgCode, payload, len, destIP, UC_PORT);
}

// Komfort: Payload-Struct direkt übergeben
template <typename T>
bool broadcastMsg(uint8_t msgCode, const T &payload) {
  return broadcastMsg(msgCode, &payload, sizeof(T));
}

template <typename T>
bool unicastMsg(uint8_t msgCode, const T &payload, uint8_t lastOctet) {
  return unicastMsg(msgCode, &payload, sizeof(T), lastOctet);
}

// Nachricht ohne Payload
bool broadcastMsg(uint8_t msgCode) {
  return broadcastMsg(msgCode, nullptr, 0);
}

// Empfangene/gespeicherte Nachricht unverändert weitersenden, Header bleibt erhalten
// (z.B. Simulator-Playback mit originalem sender/timeStamp)
void broadcastRawMsg(const xMsg &m) {
  uint8_t buf[sizeof(msgHeader) + maxPayloadLen];
  memcpy(buf, &m.header, sizeof(msgHeader));
  if (m.header.payloadLen) memcpy(buf + sizeof(msgHeader), m.payload, m.header.payloadLen);
  udpMc.writeTo(buf, sizeof(msgHeader) + m.header.payloadLen, multiCastIP, MC_PORT);
}

void setUpOTA() {
  writelnComment("set up OTA");
  ArduinoOTA.setHostname(device[ID].Name.c_str());
  ArduinoOTA
    .onStart([]() {
      String type;
      if (ArduinoOTA.getCommand() == U_FLASH)
        type = "sketch";
      else
        type = "filesystem";
      Serial.println("Start updating " + type);
      #ifdef containLed
        setPixel(minPix,0x0000FF);
        setPixel(maxPix,0x0000FF);
      #endif
    })
    .onEnd([]() {
      Serial.println("\nEnd");
    })
    .onProgress([](unsigned int progress, unsigned int total) {
      Serial.printf("Progress: %u%%\r", (progress / (total / 100)));
    })
    .onError([](ota_error_t error) {
      Serial.printf("Error[%u]: ", error);
      if (error == OTA_AUTH_ERROR) Serial.println("Auth Failed");
      else if (error == OTA_BEGIN_ERROR) Serial.println("Begin Failed");
      else if (error == OTA_CONNECT_ERROR) Serial.println("Connect Failed");
      else if (error == OTA_RECEIVE_ERROR) Serial.println("Receive Failed");
      else if (error == OTA_END_ERROR) Serial.println("End Failed");
    });
  ArduinoOTA.begin();
}

void printTimePreamble(const xMsg &m) {
  time_t t= m.header.timeStamp;
  struct tm *tmstruct = localtime(&t);
  char buf[30];
  strftime(buf, sizeof(buf), "%Y-%m-%d %H:%M:%S", tmstruct);
  Serial << "Time: " << buf << ", ";
}

void printSensorData(const xMsg &m) {
  printTimePreamble(m);
  if (m.header.msgCode == HB) {
    Serial << " HB, Sender: " << m.header.sender;
    hbPayload hb;
    if (getHbPayload(m, hb)) Serial << " IP: " << hb.ip << " Periode: " << hb.HBperiode;
    pa2HbPayload pa2;
    if (getPayload(m, pa2)) {
      Serial << " readyToFire: " << pa2.readyToFire;
      Serial << " limitsActive: " << pa2.limitsActive;
      Serial << " leftLimit: " << pa2.leftLimit;
      Serial << " rightLimit: " << pa2.rightLimit;
      Serial << " farLimit: " << pa2.farLimit;
      Serial << " nearLimit: " << pa2.nearLimit;
    }
    radarHbPayload rhb;
    if (getPayload(m, rhb)) Serial << " deadZone: " << rhb.deadZoneDist;
    markerHbPayload mhb;
    if (getPayload(m, mhb)) {
      Serial << " mainLaser: " << mhb.mainLaser;
      Serial << " subLaser: " << mhb.subLaser;
      Serial << " aux: " << mhb.aux;
      Serial << " RGB: " << mhb.r << "," << mhb.g << "," << mhb.b;
    }
    Serial << endl;
  }
  else if ((m.header.msgCode == catObserved) || (m.header.msgCode == measurement) || (m.header.msgCode == catHit)) {
    posPayload pos;
    if (!getPayload(m, pos)) return;
    if (m.header.msgCode == catObserved) Serial << "Observation, ";
      else if (m.header.msgCode == measurement) Serial << "Measurement, ";
        else Serial << "Hit, ";
    Serial << "Sender: " << m.header.sender << ", Sensor: " << pos.sensor << ", ";
    Serial << "Radius: " << pos.radius << ", phi: " << pos.angle << ", x: " << pos.x << ", y: " << pos.y;
    Serial << ", speed: " << pos.targetSpeed << ", res: " << pos.res;
    Serial << ", worldValid: " << pos.worldValid << ", worldX: " << pos.worldX << ", worldY: " << pos.worldY;
    Serial << endl;
  }
  else if (m.header.msgCode == poseReport) {
    worldPosePayload wp;
    if (!getPayload(m, wp)) return;
    Serial << "PoseReport, Sender: " << m.header.sender;
    Serial << ", validWorldPose: " << wp.validWorldPose;
    Serial << ", worldX: " << wp.worldX << ", worldY: " << wp.worldY << ", heading: " << wp.heading;
    Serial << ", mirror: " << wp.mirror;
    Serial << endl;
  }
  else if (m.header.msgCode == poseRequest) {
    Serial << "PoseRequest, Sender: " << m.header.sender << endl;
  }
}

void printCmdData(const xMsg &m) {
  Serial << "Sender: " << m.header.sender;
  cmdPayload c;
  if (getPayload(m, c)) Serial << " CMD: " << c.cmd << " Info: " << c.info;
  Serial << endl;
}

#ifdef containLed
  void initPixel(){
    FastLED.addLeds<LED_TYPE, pixelPin, COLOR_ORDER>(leds, pixelNum);
    FastLED.setBrightness(BRIGHTNESS);
  }

  void setPixel(byte led, uint32_t farbe) {
    leds[led] = farbe;
    FastLED.show();
  }

  void allPixel(uint32_t farbe) {
    for(int i= 0; i < pixelNum; i++) {
      leds[i] = farbe;
      //setPixel(i,farbe);
    }
    FastLED.show();
  }
#endif

void toPol(int x, int y, float &phi,float &radius) {
  radius = sqrt(x*x+y*y);
  phi = atan2(x, y) *180 / M_PI;
}

void toKart(int &x, int &y, float phi, float radius) {
  phi = phi*M_PI /180;
  x = sin(phi)* radius;
  y = cos(phi)* radius;
}

void toPaPol(int x, int y, float &phi,float &radius){
  radius = sqrt(x*x+y*y);
  phi = (atan2(x, y) * 2048 / M_PI) + 2048;
}

void toPaKart(int &x, int &y, float phi, float radius) {
  phi = (phi-2048)*M_PI /2048;
  x = sin(phi)* radius;
  y = cos(phi)* radius;
}

//---------------------------------------------------------------------------------------
// Welt-/Lokal-Transformation (reine 2D-Starrkoerper-Transformation, mm)
// heading in PA-Einheiten (0..4096 = 360 Grad), 0 = lokale Achsen welt-ausgerichtet.
//   Welt = Rot(heading) * lokal + (worldX, worldY)
//---------------------------------------------------------------------------------------
// Welt = Translation + Rotation(heading) angewandt auf das (ggf. ueber mirror an der
// lokalen y-Achse gespiegelte) lokale System. mirror = +1 (normal) oder -1 (gespiegelt).
void localToWorld(int xl, int yl, const worldPose &p, int &xw, int &yw) {
  float a = p.heading * (2.0f * M_PI / 4096.0f);
  float c = cos(a), s = sin(a);
  float ym = (float)p.mirror * (float)yl;          // Drehsinn beruecksichtigen
  xw = p.worldX + lround(xl * c - ym * s);
  yw = p.worldY + lround(xl * s + ym * c);
}

void worldToLocal(int xw, int yw, const worldPose &p, int &xl, int &yl) {
  float a = p.heading * (2.0f * M_PI / 4096.0f);
  float c = cos(a), s = sin(a);
  float dx = xw - p.worldX;
  float dy = yw - p.worldY;
  xl = lround(  dx * c + dy * s);
  yl = lround(((float)p.mirror) * (-dx * s + dy * c));   // mirror ist sein eigenes Inverses
}

//---------------------------------------------------------------------------------------
// Pose-Persistenz im nichtfluechtigen Speicher (NVS, Namespace "pose").
// loadPose laedt nur die Koordinaten/Ausrichtung; validWorldPose bleibt nach dem
// Booten bewusst false und wird erst durch einen spaeteren Quickcheck bestaetigt.
//---------------------------------------------------------------------------------------
void savePose(const worldPose &p) {
  Preferences posePrefs;
  posePrefs.begin("pose", false);
  posePrefs.putInt("x", p.worldX);
  posePrefs.putInt("y", p.worldY);
  posePrefs.putFloat("h", p.heading);
  posePrefs.putInt("m", p.mirror);
  posePrefs.putBool("v", p.validWorldPose);
  posePrefs.end();
}

bool loadPose(worldPose &p) {
  Preferences posePrefs;
  posePrefs.begin("pose", true);
  bool exists = posePrefs.isKey("x");
  if (exists) {
    p.worldX  = posePrefs.getInt("x", 0);
    p.worldY  = posePrefs.getInt("y", 0);
    p.heading = posePrefs.getFloat("h", 0.0f);
    p.mirror  = (int8_t)posePrefs.getInt("m", 1);
  }
  posePrefs.end();
  p.validWorldPose = false;   // nach Boot immer ungueltig -> Quickcheck bestaetigt spaeter
  return exists;
}

// Gespeicherte Pose vollstaendig vergessen (NVS-Namespace "pose" leeren). Danach liefert
// loadPose() false -> beim naechsten Boot keine vertraute Pose; erzwingt Neukalibrierung.
void clearPose() {
  Preferences posePrefs;
  posePrefs.begin("pose", false);
  posePrefs.clear();
  posePrefs.end();
}

//---------------------------------------------------------------------------------------
// Geraete-Einstellungen & Steuerung (generisch). Ein Geraet meldet per settingsReport,
// welche Anzeige-Settings/Aktionen es hat und wie sie eingestellt sind; ein Display oder
// das VPS setzt sie per commandMsg/cmdSetSetting bzw. loest Aktionen per Kommando aus.
// Welche Bits ein Geraet unterstuetzt, legt die hwDef ueber die STG_*-Masken fest:
//   STG_SUPPORTED  vorhandene Settings (stg*-Bits)
//   STG_DEFAULT    Boot-Zustand (nicht persistierte Bits nehmen immer diesen Wert)
//   STG_PERSIST    welche Bits im NVS gespeichert/geladen werden
//   STG_ACTIONS    ausloesbare Aktionen (act*-Bits)
//---------------------------------------------------------------------------------------
#ifndef STG_SUPPORTED
#define STG_SUPPORTED 0u
#endif
#ifndef STG_DEFAULT
#define STG_DEFAULT 0u
#endif
#ifndef STG_PERSIST
#define STG_PERSIST 0u
#endif
#ifndef STG_ACTIONS
#define STG_ACTIONS 0u
#endif

inline bool settingOn(uint8_t idx) { return (mySettings.values >> idx) & 1u; }

// Ist das Geraet aktiv (nicht im Ruhemodus)? Geraete OHNE stgActive-Setting (Aktoren,
// Manager, Displays) gelten immer als aktiv - nur echte Sensoren koennen inaktiv sein.
// Ein Sensor-Sketch ruft dies vor jeder Detektion/Meldung: !deviceActive() -> nur HB.
inline bool deviceActive() {
  return !((mySettings.supported >> stgActive) & 1u) || settingOn(stgActive);
}

void saveSettings() {
  Preferences p; p.begin("devcfg", false);
  p.putUShort("v", (uint16_t)(mySettings.values & (uint16_t)STG_PERSIST));
  p.end();
}

// Beim Boot aufrufen: supported/actions aus der hwDef, values = Default mit den
// persistierten Bits aus dem NVS ueberlagert. Nicht persistierte Bits (z.B. Lidar-Motor)
// starten immer auf ihrem Default.
void initSettings() {
  mySettings.supported = (uint16_t)STG_SUPPORTED;
  mySettings.actions   = (uint16_t)STG_ACTIONS;
  Preferences p; p.begin("devcfg", true);
  uint16_t saved = p.getUShort("v", (uint16_t)STG_DEFAULT);
  p.end();
  uint16_t v = ((uint16_t)STG_DEFAULT & ~(uint16_t)STG_PERSIST) | (saved & (uint16_t)STG_PERSIST);
  mySettings.values = v & (uint16_t)STG_SUPPORTED;
}

// Aktuellen Einstellungszustand als settingsReport broadcasten -> Display + Manager-Gateway
// (und darueber der VPS) lernen ihn.
void sendSettingsReport() {
  settingsPayload sp;
  sp.supported = mySettings.supported;
  sp.values    = mySettings.values;
  sp.actions   = mySettings.actions;
  broadcastMsg(settingsReport, sp);
}

// Eigene Welt-Pose als poseReport broadcasten (Antwort auf poseRequest / Annonce).
void sendPoseReport() {
  worldPosePayload wp;
  wp.validWorldPose = myPose.validWorldPose ? 1 : 0;
  wp.worldX = myPose.worldX; wp.worldY = myPose.worldY;
  wp.heading = myPose.heading; wp.mirror = myPose.mirror;
  broadcastMsg(poseReport, wp);
}

// Gemeinsame Nachrichten generisch behandeln (aus loop() VOR der geraetespezifischen
// Auswertung aufrufen). true = war eine gemeinsame Nachricht (settingsRequest/poseRequest/
// cmdSetSetting) und wurde erledigt -> der Sketch muss sie nicht mehr behandeln.
bool handleCommonMsg(const xMsg& m) {
  switch (m.header.msgCode) {
    case settingsRequest:
      if (mySettings.supported || mySettings.actions) sendSettingsReport();
      return true;
    case poseRequest:
      sendPoseReport();
      return true;
    case commandMsg: {
      cmdPayload c;
      if (!getPayload(m, c)) return false;
      if (c.cmd == cmdReboot) {          // Fernwartung: sofortiger Neustart
        sendUdpTextln("Neustart per Kommando (cmdReboot) ...");
        delay(200);                       // dem UDP-Text/ACK kurz Zeit lassen
        ESP.restart();
        return true;                      // (wird nicht mehr erreicht)
      }
      if (c.cmd == cmdSetSetting) {
        uint8_t idx = (uint8_t)((uint32_t)c.info >> 1);
        bool    on  = (uint32_t)c.info & 1u;
        if (idx < 16 && ((mySettings.supported >> idx) & 1u)) {
          if (on) mySettings.values |= (uint16_t)(1u << idx);
          else    mySettings.values &= (uint16_t)~(1u << idx);
          saveSettings();
          sendSettingsReport();
        }
        return true;
      }
      // Manuelle VPS-Pose: generisch fuer alle Geraete mit myPose.
      // Der Sensor speichert am Ende exakt dieselbe worldPose-Struktur wie nach
      // automatischer /localize- oder /calibrate-Antwort: Pose ist Pose.
      // Uebernommen wird nur, wenn X, Y und Heading seit der letzten Uebernahme
      // wirklich angekommen sind: mit nur EINEM Unicast-Puffer gehen Kommandos verloren,
      // waehrend das Geraet blockiert (z.B. eigene VPS-Lokalisierung) - der LD06 hat so
      // 2026-10-30 eine Pose 0/0/0 als gueltig uebernommen.
      if (c.cmd == cmdManualPoseX) {
        manualPoseDraft = myPose;
        manualPoseDraft.worldX = c.info;
        manualPoseHave = 1;
        return true;
      }
      if (c.cmd == cmdManualPoseY) {
        manualPoseDraft.worldY = c.info;
        manualPoseHave |= 2;
        return true;
      }
      if (c.cmd == cmdManualPoseHeading) {
        manualPoseDraft.heading = (float)(((c.info % 4096) + 4096) % 4096);
        manualPoseHave |= 4;
        return true;
      }
      if (c.cmd == cmdManualPoseMirrorCommit) {
        if (manualPoseHave != 7) {
          sendUdpTextln("Manuelle Pose UNVOLLSTAENDIG (" + String(manualPoseHave) + "/7) - verworfen");
          manualPoseHave = 0;
          return true;
        }
        manualPoseHave = 0;
        manualPoseDraft.mirror = (c.info < 0) ? -1 : 1;
        manualPoseDraft.validWorldPose = true;
        myPose = manualPoseDraft;
        savePose(myPose);
        sendPoseReport();
        sendUdpTextln("Manuelle VPS-Pose uebernommen (x=" + String(myPose.worldX) +
                      ", y=" + String(myPose.worldY) + ", h=" + String(myPose.heading) +
                      ", m=" + String(myPose.mirror) + ")");
        return true;
      }
      return false;   // andere Kommandos sind geraetespezifisch
    }
    default:
      return false;
  }
}

//---------------------------------------------------------------------------------------
// Welt-Pose aus der eigenen relativen Koordinatengruppe uebernehmen. Geraete derselben
// Gruppe teilen dasselbe lokale Koordinatensystem -> dieselbe Welt-Pose gilt fuer alle.
// Fragt per poseRequest (Broadcast) und wartet kurz auf ein poseReport eines
// Gruppenmitglieds (gleiche group) mit validWorldPose. true = Pose uebernommen+gespeichert.
//---------------------------------------------------------------------------------------
// Naechste Multicast-Nachricht holen - funktioniert im Queue- UND im Flag-Modus.
static bool mcFetch(xMsg& m) {
#ifdef MC_QUEUE_LEN
  return mcQueuePop(m);
#else
  if (!mcDataReceived) return false;
  m = lastMcMsg; mcDataReceived = false;
  return true;
#endif
}

bool copyPoseFromGroup(unsigned long waitMs) {
  uint8_t myGroup = device[ID].group;
  if (myGroup == groupNone) { sendUdpTextln("Pose kopieren: keine Gruppe"); return false; }
  broadcastMsg(poseRequest);
  unsigned long t0 = millis();
  while (millis() - t0 < waitMs) {
    ArduinoOTA.handle();
    xMsg m;
    if (mcFetch(m)) {
      if (m.header.msgCode == poseReport && m.header.sender != ID &&
          device[m.header.sender].group == myGroup) {
        worldPosePayload wp;
        if (getPayload(m, wp) && wp.validWorldPose) {
          myPose.worldX = wp.worldX; myPose.worldY = wp.worldY;
          myPose.heading = wp.heading; myPose.mirror = wp.mirror;
          myPose.validWorldPose = true; savePose(myPose);
          sendUdpTextln("Pose aus Gruppe " + String(myGroup) + " kopiert (von #" +
                        String(m.header.sender) + ")");
          return true;
        }
      }
    }
    delay(2);
  }
  sendUdpTextln("Pose kopieren: kein Gruppenmitglied mit gueltiger Pose");
  return false;
}

//---------------------------------------------------------------------------------------
// Karten-Verteilung (No-Shot u.a.): Manager haelt die Karte im LittleFS, Geraete laden
// sie gechunkt ueber das UDP-xCom-Protokoll (mapRequest -> mapInfo -> mapChunk...).
//---------------------------------------------------------------------------------------

// CRC32 (zlib-kompatibel, reflektiertes Polynom 0xEDB88320) - Manager und
// Empfaenger nutzen dieselbe Funktion.
static inline uint32_t crc32Update(uint32_t crc, uint8_t b) {
  crc ^= b;
  for (int k = 0; k < 8; k++)
    crc = (crc >> 1) ^ (0xEDB88320u & (uint32_t)(-(int32_t)(crc & 1)));
  return crc;
}
uint32_t crc32Bytes(const uint8_t* d, size_t n) {
  uint32_t crc = 0xFFFFFFFFu;
  for (size_t i = 0; i < n; i++) crc = crc32Update(crc, d[i]);
  return crc ^ 0xFFFFFFFFu;
}

// Version aus dem CSV-Header lesen ("... vN ...") - Default 1, wenn nicht gefunden.
static uint16_t parseMapVersion(const String& firstLine) {
  int i = firstLine.indexOf(" v");
  if (i < 0) return 1;
  i += 2;
  uint16_t v = 0; bool any = false;
  while (i < (int)firstLine.length() && isDigit(firstLine[i])) {
    v = v * 10 + (firstLine[i] - '0'); any = true; i++;
  }
  return any ? v : 1;
}

// Karte im LittleFS analysieren: Version (Header), CRC32 (ganze Datei), Laenge.
bool mapFileInfo(const char* path, uint16_t& version, uint32_t& fileCrc, uint32_t& totalLen) {
  File f = LittleFS.open(path, "r");
  if (!f) return false;
  totalLen = f.size();
  uint32_t crc = 0xFFFFFFFFu;
  String first; bool inFirst = true;
  while (f.available()) {
    uint8_t b = (uint8_t)f.read();
    crc = crc32Update(crc, b);
    if (inFirst) {
      if (b == '\n') inFirst = false;
      else if (b != '\r') first += (char)b;
    }
  }
  f.close();
  fileCrc = crc ^ 0xFFFFFFFFu;
  version = parseMapVersion(first);
  return true;
}

// (Manager) Karte gechunkt an einen Anforderer senden: mapInfo + alle mapChunks (Unicast).
bool serveMap(uint8_t mapType, const char* path, uint8_t reqOctet) {
  if (reqOctet == 0) return false;
  uint16_t version; uint32_t fileCrc, totalLen;
  if (!mapFileInfo(path, version, fileCrc, totalLen)) return false;

  uint16_t chunkCount = (uint16_t)((totalLen + mapChunkBytes - 1) / mapChunkBytes);
  if (totalLen == 0) chunkCount = 0;

  mapInfoPayload info;
  info.mapType = mapType; info.version = version; info.fileCrc = fileCrc;
  info.totalLen = totalLen; info.chunkSize = mapChunkBytes; info.chunkCount = chunkCount;
  unicastMsg(mapInfo, info, reqOctet);
  delay(20);                                  // dem Empfaenger Zeit, mapInfo vor den Chunks zu verarbeiten

  File f = LittleFS.open(path, "r");
  if (!f) return false;
  uint8_t buf[sizeof(mapChunkMeta) + mapChunkBytes];
  uint16_t idx = 0;
  while (true) {
    int n = f.read(buf + sizeof(mapChunkMeta), mapChunkBytes);
    if (n <= 0) break;
    mapChunkMeta meta;
    meta.mapType = mapType; meta.version = version;
    meta.chunkIndex = idx; meta.dataLen = (uint16_t)n;
    memcpy(buf, &meta, sizeof(meta));
    unicastMsg(mapChunk, buf, (uint8_t)(sizeof(meta) + n), reqOctet);
    idx++;
    delay(10);  // dem Empfaenger Zeit lassen (UDP, kein Flow-Control/Resend:
                // der Empfaenger hat nur EINEN Paketpuffer - jeder Latenz-Spike
                // laenger als dieser Abstand kostet sonst den ganzen Transfer)
  }
  f.close();
  return true;
}

// (Sensor) Karte beim Manager anfordern.
bool requestMap(uint8_t mapType, uint8_t managerOctet) {
  mapReqPayload r; r.mapType = mapType;
  return unicastMsg(mapRequest, r, managerOctet);
}

// Empfangszustand fuer eine eingehende Karte (Sensor-Seite). Chunks werden in einem
// statischen RAM-Puffer gesammelt und die Datei erst am Ende EINMAL geschrieben:
// LittleFS-Schreiben mitten im Transfer blockiert sonst zig ms (Flash-Erase), waehrend
// der Manager weitersendet - mit nur einem Empfangs-Paketpuffer und ohne Resend ging
// dabei regelmaessig ein Chunk verloren und der ganze Transfer scheiterte (beim Radar
// reproduzierbar ab Chunk 3). Karten groesser als der Puffer: direkt in die Datei
// streamen wie frueher (Best-Effort).
#ifndef MAP_RX_BUF_BYTES
#define MAP_RX_BUF_BYTES 8192
#endif
static uint8_t mapRxBuf[MAP_RX_BUF_BYTES];   // eine Karte zurzeit (Geraete laden seriell)

struct mapRxState {
  bool     active = false;
  bool     done = false;
  bool     ok = false;
  bool     toRam = false;
  uint8_t  mapType = 0;
  uint16_t version = 0;
  uint32_t fileCrc = 0;
  uint32_t totalLen = 0;
  uint32_t rxLen = 0;
  uint16_t chunkCount = 0;
  uint16_t nextIndex = 0;
  File     f;
  String   path;
};

// Empfang nach erhaltenem mapInfo starten (RAM-Puffer; Fallback <path>.tmp).
bool mapBeginRx(mapRxState& s, const mapInfoPayload& info, const char* path) {
  s = mapRxState();
  s.mapType = info.mapType; s.version = info.version; s.fileCrc = info.fileCrc;
  s.totalLen = info.totalLen; s.chunkCount = info.chunkCount;
  s.path = path;
  s.toRam = (s.totalLen <= MAP_RX_BUF_BYTES);
  if (!s.toRam) {
    s.f = LittleFS.open((s.path + ".tmp").c_str(), "w");
    if (!s.f) return false;
  }
  s.active = true;
  if (s.chunkCount == 0) {                 // leere Karte: sofort fertig
    if (!s.toRam) s.f.close();
    LittleFS.remove(s.path.c_str());
    File f = LittleFS.open(s.path.c_str(), "w");
    if (f) f.close();
    s.active = false; s.done = true; s.ok = (s.totalLen == 0);
  }
  return true;
}

// Abschluss: CRC pruefen und (im RAM-Modus) die Datei einmal schreiben. true = OK.
static bool mapFinishRx(mapRxState& s) {
  if (s.toRam) {
    if (s.rxLen != s.totalLen || crc32Bytes(mapRxBuf, s.rxLen) != s.fileCrc) return false;
    File f = LittleFS.open(s.path.c_str(), "w");
    if (!f) return false;
    bool ok = (f.write(mapRxBuf, s.rxLen) == s.rxLen);
    f.close();
    return ok;
  }
  s.f.close();
  String tmp = s.path + ".tmp";
  uint16_t v; uint32_t crc, len;
  bool good = mapFileInfo(tmp.c_str(), v, crc, len) && crc == s.fileCrc && len == s.totalLen;
  if (good) {
    LittleFS.remove(s.path.c_str());
    LittleFS.rename(tmp.c_str(), s.path.c_str());
    return true;
  }
  LittleFS.remove(tmp.c_str());
  return false;
}

// Einen mapChunk verarbeiten. Rueckgabe: 0 = weiter, 1 = fertig+OK, -1 = Fehler.
int mapFeedChunk(mapRxState& s, const xMsg& m) {
  if (!s.active) return -1;
  if (m.header.payloadLen < sizeof(mapChunkMeta)) return -1;
  mapChunkMeta meta; memcpy(&meta, m.payload, sizeof(meta));
  if (meta.mapType != s.mapType || meta.version != s.version) return 0;  // fremder Chunk
  if (meta.chunkIndex != s.nextIndex) return 0;                          // nicht in Reihenfolge
  if ((size_t)sizeof(mapChunkMeta) + meta.dataLen > m.header.payloadLen) return -1;

  if (s.toRam) {
    if (s.rxLen + meta.dataLen > MAP_RX_BUF_BYTES) return -1;
    memcpy(mapRxBuf + s.rxLen, m.payload + sizeof(mapChunkMeta), meta.dataLen);
  } else {
    s.f.write(m.payload + sizeof(mapChunkMeta), meta.dataLen);
  }
  s.rxLen += meta.dataLen;
  s.nextIndex++;
  if (s.nextIndex >= s.chunkCount) {
    s.ok = mapFinishRx(s);
    s.active = false; s.done = true;
    return s.ok ? 1 : -1;
  }
  return 0;
}

//---------------------------------------------------------------------------------------
// No-Shot-/Schusszonen-Karte: Polygon(e) in Welt-mm (CSV im LittleFS) in RAM laden und
// einen Welt-Punkt testen. Innerhalb = schiessbar. Mehrere Ringe (durch Leerzeile
// getrennt) -> even-odd-Test ueber alle Ringe (Loecher = No-Shot-Inseln).
//---------------------------------------------------------------------------------------
#ifndef MAX_NOSHOT_PTS
#define MAX_NOSHOT_PTS 300
#endif
#ifndef MAX_NOSHOT_RINGS
#define MAX_NOSHOT_RINGS 8
#endif
static int32_t  nsX[MAX_NOSHOT_PTS], nsY[MAX_NOSHOT_PTS];
static uint16_t nsRingStart[MAX_NOSHOT_RINGS + 1];
static uint8_t  nsRingCount = 0;
static uint16_t nsPtCount   = 0;
static int32_t  nsMinX, nsMaxX, nsMinY, nsMaxY;
static bool     noShotLoaded = false;

bool loadNoShot(const char* path) {
  noShotLoaded = false; nsPtCount = 0; nsRingCount = 0;
  File f = LittleFS.open(path, "r");
  if (!f) return false;
  nsRingStart[0] = 0;
  bool ringHasPts = false;
  uint16_t skipped = 0;                             // Punkte ueber dem Puffer-Limit
  nsMinX = nsMinY = 0x7FFFFFFF; nsMaxX = nsMaxY = -0x7FFFFFFF;
  while (f.available()) {
    String line = f.readStringUntil('\n');
    line.trim();
    if (line.length() == 0) {                       // Leerzeile -> Ring abschliessen
      if (ringHasPts && nsRingCount < MAX_NOSHOT_RINGS) {
        nsRingCount++; nsRingStart[nsRingCount] = nsPtCount; ringHasPts = false;
      }
      continue;
    }
    if (line[0] == '#') continue;                   // Kommentar
    int comma = line.indexOf(',');
    if (comma < 0) continue;
    int32_t x = line.substring(0, comma).toInt();
    int32_t y = line.substring(comma + 1).toInt();
    if (nsPtCount < MAX_NOSHOT_PTS) {
      nsX[nsPtCount] = x; nsY[nsPtCount] = y; nsPtCount++; ringHasPts = true;
      if (x < nsMinX) nsMinX = x; if (x > nsMaxX) nsMaxX = x;
      if (y < nsMinY) nsMinY = y; if (y > nsMaxY) nsMaxY = y;
    } else {
      skipped++;                                    // NICHT still abschneiden (s.u.)
    }
  }
  f.close();
  if (ringHasPts && nsRingCount < MAX_NOSHOT_RINGS) {  // letzten (nicht leerzeilen-) Ring schliessen
    nsRingCount++; nsRingStart[nsRingCount] = nsPtCount;
  }
  if (skipped) {
    // Ein still abgeschnittenes Polygon waere ein FALSCHES Polygon. Lieber laut
    // scheitern (fail-open: ungefiltert melden) als leise falsch filtern.
    sendUdpTextln("Karte " + String(path) + ": zu viele Punkte (" +
                  String(nsPtCount + skipped) + " > " + String(MAX_NOSHOT_PTS) +
                  ") - Karte IGNORIERT");
    noShotLoaded = false; nsPtCount = 0; nsRingCount = 0;
    return false;
  }
  noShotLoaded = (nsRingCount > 0 && nsPtCount >= 3);
  return noShotLoaded;
}

// true = Welt-Punkt liegt im schiessbaren Bereich. Ohne geladene Karte: true
// (fail-open: Detektion wird gemeldet; der Aktor prueft spaeter zusaetzlich selbst).
bool insideNoShot(int32_t px, int32_t py) {
  if (!noShotLoaded) return true;
  if (px < nsMinX || px > nsMaxX || py < nsMinY || py > nsMaxY) return false;
  bool inside = false;
  for (uint8_t r = 0; r < nsRingCount; r++) {
    uint16_t s = nsRingStart[r], e = nsRingStart[r + 1];
    if (e - s < 3) continue;
    int j = e - 1;
    for (int i = s; i < (int)e; i++) {
      const int32_t yi = nsY[i], yj = nsY[j];
      if ((yi > py) != (yj > py)) {
        const double xint = (double)(nsX[j] - nsX[i]) * (double)(py - yi) /
                            (double)(yj - yi) + (double)nsX[i];
        if ((double)px < xint) inside = !inside;
      }
      j = i;
    }
  }
  return inside;
}

//---------------------------------------------------------------------------------------
// Karte beim Manager beschaffen (generisch fuer jedes welt-faehige Geraet und jeden
// Kartentyp: mapNoShot, mapRasen, ...): lokale Kopie laden, beim Manager die aktuelle
// Version erfragen, bei Abweichung neu herunterladen; sonst / bei Manager-Ausfall die
// alte Karte verwenden. true = Karte nutzbar (dann via insideNoShot testbar; es ist
// immer die ZULETZT geladene Karte aktiv - ein Geraet nutzt genau eine Polygon-Karte).
//---------------------------------------------------------------------------------------
static bool waitForUc(uint8_t codeWanted, xMsg& out, unsigned long budget) {
  unsigned long t0 = millis();
  while (millis() - t0 < budget) {
    ArduinoOTA.handle();
    if (ucDataReceived) {
      out = lastUcMsg; ucDataReceived = false;
      if (out.header.msgCode == codeWanted) return true;
      handleCommonMsg(out);   // generische Nachrichten (settingsRequest/cmdSetSetting/...)
                              // waehrend des Wartens nicht einfach verwerfen
    }
    delay(1);
  }
  return false;
}

// Ergebnis des letzten acquireMap(): true = mit dem Manager ABGEGLICHEN (lokale Karte
// nachweislich aktuell oder frisch heruntergeladen), false = Rueckfall auf die lokale
// Karte, ohne zu wissen ob sie aktuell ist. Der Rueckgabewert von acquireMap sagt nur
// "irgendeine Karte ist geladen" und taugt fuer die Retry-Frage nicht: nach einem
// verlorenen mapInfo galt das Geraet als versorgt und probierte erst nach dem
// stuendlichen Fangnetz wieder - so lange filterte es mit der ALTEN Karte.
bool mapLastSynced = false;

bool acquireMap(uint8_t mapType, const char* path, uint8_t managerOctet, unsigned long waitMs) {
  mapLastSynced = false;
  bool haveLocal = loadNoShot(path);
  uint16_t lv = 0; uint32_t lcrc = 0, llen = 0;
  bool haveLocalInfo = mapFileInfo(path, lv, lcrc, llen);

  // Fortschritt via Text-Multicast melden (der Manager relayed ihn an den VPS-Debug) -
  // das laeuft selten (Boot/Versionswechsel) und macht Kartenprobleme aus der Ferne sichtbar.
  if (managerOctet == 0 || !requestMap(mapType, managerOctet)) {
    sendUdpTextln("Karte " + String(mapType) + ": Manager-Anfrage nicht moeglich -> lokale Karte");
    return haveLocal;
  }
  xMsg uc; mapInfoPayload info;
  if (!waitForUc(mapInfo, uc, waitMs) || !getPayload(uc, info) || info.mapType != mapType) {
    sendUdpTextln("Karte " + String(mapType) + ": kein mapInfo von ." + String(managerOctet) +
                  " -> lokale Karte");
    return haveLocal;
  }
  if (haveLocalInfo && info.version == lv && info.fileCrc == lcrc) {
    sendUdpTextln("Karte " + String(mapType) + ": lokale Karte aktuell (v" + String(lv) + ")");
    mapLastSynced = haveLocal;
    return haveLocal;
  }
  sendUdpTextln("Karte " + String(mapType) + ": lade vom Manager (v" + String(info.version) +
                ", " + String(info.totalLen) + " B, " + String(info.chunkCount) + " Chunks)");
  mapRxState rx;
  if (!mapBeginRx(rx, info, path)) {
    sendUdpTextln("Karte " + String(mapType) + ": LittleFS-Schreiben fehlgeschlagen");
    return haveLocal;
  }
  int result = 0; unsigned long t0 = millis();
  while (rx.active && millis() - t0 < waitMs) {
    ArduinoOTA.handle();
    if (ucDataReceived) {
      xMsg c = lastUcMsg; ucDataReceived = false;
      if (c.header.msgCode == mapChunk) { result = mapFeedChunk(rx, c); t0 = millis(); if (result != 0) break; }
    }
    delay(1);
  }
  sendUdpTextln(result == 1 ? "Karte " + String(mapType) + ": Download OK"
                            : "Karte " + String(mapType) + ": Download unvollstaendig (Chunk " +
                              String(rx.nextIndex) + "/" + String(rx.chunkCount) + ") -> alte Karte");
  bool loaded = loadNoShot(path);
  mapLastSynced = (result == 1) && loaded;
  return loaded;
}

bool acquireNoShot(const char* path, uint8_t managerOctet, unsigned long waitMs) {
  return acquireMap(mapNoShot, path, managerOctet, waitMs);
}

// Unaufgeforderten mapInfo-Announce (Multicast, vom Manager nach jeder angenommenen
// Kartenaenderung gesendet - siehe gwAcceptMap in gatewayProc.ino) auswerten: true =
// die Announce-Karte betrifft mapType UND weicht von der lokal geladenen Version/CRC
// ab. Blockiert NICHT selbst (acquireMap wartet bis zu waitMs) - der Aufrufer soll nur
// ein Flag setzen und den eigentlichen Download aus der naechsten Service-Routine
// anstossen (Fangnetz siehe MapConcept.md Stufe 4: stuendlicher Re-Check zusaetzlich,
// falls ein Announce per UDP verlorengeht - es gibt kein Resend).
bool mapAnnounceOutdated(const xMsg& m, uint8_t mapType, const char* path) {
  if (m.header.msgCode != mapInfo) return false;
  mapInfoPayload info;
  if (!getPayload(m, info) || info.mapType != mapType) return false;
  uint16_t lv = 0; uint32_t lcrc = 0, llen = 0;
  if (mapFileInfo(path, lv, lcrc, llen) && info.version == lv && info.fileCrc == lcrc) return false;
  return true;
}

//---------------------------------------------------------------------------------------
// Welt-Pose per VPS bestimmen. wrap360f/angDiff180 + resolvePose sind generisch; der
// eigentliche HTTP-Aufruf vpsLocalize zieht HTTPClient und wird nur kompiliert, wenn
// das Geraet vor dem Include USE_VPS_LOCALIZE definiert (sonst kein Code-Bloat).
//---------------------------------------------------------------------------------------
#ifndef VPS_LOC_PORT
#define VPS_LOC_PORT 8080
#endif
#ifndef VPS_LOC_PATH
#define VPS_LOC_PATH "/localize"
#endif
#ifndef VPS_LOC_TIMEOUT_MS
#define VPS_LOC_TIMEOUT_MS 20000
#endif

static float wrap360f(float d){ while (d < 0) d += 360.0f; while (d >= 360.0f) d -= 360.0f; return d; }

#if defined(USE_VPS_LOCALIZE) || defined(USE_VPS_CALIBRATE)
#include <HTTPClient.h>

static float jsonNum(const String& s, const char* key) {
  int i = s.indexOf(key); if (i < 0) return NAN;
  i = s.indexOf(':', i);  if (i < 0) return NAN;
  return s.substring(i + 1).toFloat();
}
static String jsonStr(const String& s, const char* key) {
  int i = s.indexOf(key); if (i < 0) return "";
  i = s.indexOf(':', i);  if (i < 0) return "";
  int a = s.indexOf('"', i); if (a < 0) return "";
  int b = s.indexOf('"', a + 1); if (b < 0) return "";
  return s.substring(a + 1, b);
}
#endif  // USE_VPS_LOCALIZE || USE_VPS_CALIBRATE

#ifdef USE_VPS_LOCALIZE
// Scan (n Bins, mm; 0 = ungueltig) an den VPS posten, Pose zurueck. true bei Erfolg.
bool vpsLocalize(const uint16_t* scan, int n, int32_t& xmm, int32_t& ymm,
                 float& headDeg, int& mir, String& conf, float& inlier) {
  inlier = 0.0f;
  if (WiFi.status() != WL_CONNECTED) return false;
  String body; body.reserve(n * 6 + 16);
  body = "{\"scan\":[";
  for (int i = 0; i < n; i++) { body += scan[i]; if (i < n - 1) body += ','; }
  body += "]}";
  HTTPClient http;
  String url = "http://" + ipVPS.toString() + ":" + String(VPS_LOC_PORT) + VPS_LOC_PATH;
  if (!http.begin(url)) return false;
  http.setTimeout(VPS_LOC_TIMEOUT_MS);
  http.addHeader("Content-Type", "application/json");
  int code = http.POST(body);
  bool ok = false;
  if (code == 200) {
    String r = http.getString();
    float fx = jsonNum(r, "\"x_mm\""), fy = jsonNum(r, "\"y_mm\"");
    headDeg = jsonNum(r, "\"heading_deg\""); mir = (int)jsonNum(r, "\"mirror\"");
    conf = jsonStr(r, "\"confidence\""); inlier = jsonNum(r, "\"inlier_ratio\"");
    if (!isnan(fx) && !isnan(fy) && !isnan(headDeg) && (mir == 1 || mir == -1)) {
      xmm = (int32_t)lroundf(fx); ymm = (int32_t)lroundf(fy); ok = true;
    }
  } else Serial << "VPS HTTP " << code << endl;
  http.end();
  return ok;
}
#endif  // USE_VPS_LOCALIZE

// Pose-Entscheidung (generisch) mit Quality-Gate: eine NEUE VPS-Pose wird nur
// uebernommen, wenn sie hochwertig ist (conf=HOCH UND inlier >= minInlier). Eine
// hochwertige Messung ueberschreibt IMMER die NVS-Pose -> man bleibt nie auf einer
// schlechten Pose haengen. Schlechte Messungen werden verworfen: vorhandene
// NVS-Pose behalten, sonst nicht-lokalisiert (Aufrufer -> PH_NOLOC).
// myPose muss vorher mit der NVS-Pose gefuellt sein (loadPose); setzt validWorldPose.
void resolvePose(bool vpsOk, int32_t vx, int32_t vy, float vh, int vmir, const String& conf,
                 float inlier, bool hadNVS, float minInlier) {
  bool goodVps = vpsOk && (conf == "HOCH") && (inlier >= minInlier);
  if (goodVps) {                                    // hochwertig -> uebernehmen + speichern
    myPose.worldX = vx; myPose.worldY = vy;
    myPose.heading = wrap360f(vh) * 4096.0f / 360.0f; myPose.mirror = (int8_t)vmir;
    myPose.validWorldPose = true; savePose(myPose);
  } else if (hadNVS) {
    myPose.validWorldPose = true;                   // schlechte Messung -> gute NVS-Pose behalten
  } else {
    myPose.validWorldPose = false;                  // keine vertrauenswuerdige Pose
  }
}

//---------------------------------------------------------------------------------------
// Welt-Pose per Co-Observation kalibrieren (generisch, nicht radar-spezifisch).
// Ein nicht selbst-lokalisierender Sensor (Radar, Turm-Sensor, ...) sammelt parallel
//   * seine eigenen relativen Detektionen (bis zu CO_RADAR_TRACKS geordnete Spuren) und
//   * die catObserved welt-posierter Sensoren vom Bus (je SENDER getrennt),
// waehrend eine Person eine kurvige Bahn im gemeinsamen Sichtfeld laeuft. Die Bahnen
// gehen an den VPS (/calibrate), der je (Eigen-Spur x Welt-Quelle) eine Trajektorien-
// Registrierung (ICP + Umeyama + RANSAC) rechnet und die beste Pose zurueckliefert.
// Die Korrespondenz kommt aus der BAHNFORM, nicht aus der Zeit (timeStamp ist Sekunden).
//---------------------------------------------------------------------------------------
#ifndef CO_RADAR_TRACKS
#define CO_RADAR_TRACKS 3        // das Radar liefert bis zu 3 Targets -> 3 Spuren
#endif
#ifndef CO_MAX_LOCAL_PTS
#define CO_MAX_LOCAL_PTS 160     // Punkte pro Eigen-Spur
#endif
#ifndef CO_MAX_WORLD_SRC
#define CO_MAX_WORLD_SRC 4       // verschiedene welt-posierte Quellen gleichzeitig
#endif
#ifndef CO_MAX_WORLD_PTS
#define CO_MAX_WORLD_PTS 160     // Punkte pro Welt-Quelle
#endif
#ifndef CO_MIN_STEP_MM
#define CO_MIN_STEP_MM 60        // dichter beieinander -> nicht aufnehmen (kein Stillstand-Spam)
#endif
#ifndef CO_MIN_TRACK_PTS
#define CO_MIN_TRACK_PTS 15      // kuerzere Spuren werden nicht an den VPS gesendet
#endif

struct coCalState {
  bool          active   = false;
  bool          autoTrig = false;            // true = automatisch ausgeloest (sonst Knopf/cmd)
  unsigned long startMs  = 0;
  unsigned long windowMs = 0;
  // Eigen-Spuren (relativ, mm), je Radar-Slot
  int32_t  lx[CO_RADAR_TRACKS][CO_MAX_LOCAL_PTS];
  int32_t  ly[CO_RADAR_TRACKS][CO_MAX_LOCAL_PTS];
  uint16_t ln[CO_RADAR_TRACKS] = {0};
  // Welt-Quellen (Welt-mm), je Sender-ID getrennt
  uint8_t  wSender[CO_MAX_WORLD_SRC] = {0};
  int32_t  wx[CO_MAX_WORLD_SRC][CO_MAX_WORLD_PTS];
  int32_t  wy[CO_MAX_WORLD_SRC][CO_MAX_WORLD_PTS];
  uint16_t wn[CO_MAX_WORLD_SRC] = {0};
  uint8_t  wSrcCount = 0;
};

// Sammelfenster starten/zuruecksetzen.
void coCalibBegin(coCalState& s, unsigned long windowMs, bool autoTrig = false) {
  for (uint8_t t = 0; t < CO_RADAR_TRACKS; t++) s.ln[t] = 0;
  for (uint8_t w = 0; w < CO_MAX_WORLD_SRC; w++) { s.wn[w] = 0; s.wSender[w] = 0; }
  s.wSrcCount = 0;
  s.active = true; s.autoTrig = autoTrig;
  s.windowMs = windowMs; s.startMs = millis();
}

// Eigene relative Detektion in Slot 'slot' aufnehmen (vom Radar pro Frame).
void coCalibFeedLocal(coCalState& s, uint8_t slot, int32_t xl, int32_t yl) {
  if (!s.active || slot >= CO_RADAR_TRACKS) return;
  uint16_t n = s.ln[slot];
  if (n >= CO_MAX_LOCAL_PTS) return;
  if (n > 0) {                                       // zu nah am letzten Punkt -> ueberspringen
    int32_t dx = xl - s.lx[slot][n-1], dy = yl - s.ly[slot][n-1];
    if ((int64_t)dx*dx + (int64_t)dy*dy < (int64_t)CO_MIN_STEP_MM*CO_MIN_STEP_MM) return;
  }
  s.lx[slot][n] = xl; s.ly[slot][n] = yl; s.ln[slot] = n + 1;
}

// Welt-Detektion eines welt-posierten Senders aufnehmen (aus catObserved mit worldValid=1).
void coCalibFeedWorld(coCalState& s, uint8_t sender, int32_t xw, int32_t yw) {
  if (!s.active) return;
  int si = -1;
  for (uint8_t w = 0; w < s.wSrcCount; w++) if (s.wSender[w] == sender) { si = w; break; }
  if (si < 0) {
    if (s.wSrcCount >= CO_MAX_WORLD_SRC) return;
    si = s.wSrcCount++; s.wSender[si] = sender; s.wn[si] = 0;
  }
  uint16_t n = s.wn[si];
  if (n >= CO_MAX_WORLD_PTS) return;
  if (n > 0) {
    int32_t dx = xw - s.wx[si][n-1], dy = yw - s.wy[si][n-1];
    if ((int64_t)dx*dx + (int64_t)dy*dy < (int64_t)CO_MIN_STEP_MM*CO_MIN_STEP_MM) return;
  }
  s.wx[si][n] = xw; s.wy[si][n] = yw; s.wn[si] = n + 1;
}

inline bool coCalibElapsed(const coCalState& s) {
  return s.active && (millis() - s.startMs >= s.windowMs);
}

//---------------------------------------------------------------------------------------
// Welt-Koordinaten einer eigenen Detektion fuellen (relative x/y -> Welt ueber myPose).
// Ohne valide Pose: worldValid=0 und worldX/worldY=0 (wie in posPayload festgelegt).
//---------------------------------------------------------------------------------------
inline void fillWorld(posPayload& p) {
  if (myPose.validWorldPose) {
    int xw, yw; localToWorld(p.x, p.y, myPose, xw, yw);
    p.worldX = xw; p.worldY = yw; p.worldValid = 1;
  } else {
    p.worldX = 0; p.worldY = 0; p.worldValid = 0;
  }
}

//---------------------------------------------------------------------------------------
// Health-Check / laufende Re-Validierung: eine co-beobachtete Lidar-Welt-Detektion gegen
// die eigene (per myPose in die Welt transformierte) Detektion vergleichen. Distanzen
// ueber assocMm gelten als anderes Ziel und werden ignoriert; ab gateMm gilt das Residuum
// als schlecht. true = Pose driftet (badStreak >= maxBad) -> Aufrufer loescht
// validWorldPose und/oder kalibriert neu. Best-effort: setzt eine bereits valide Pose voraus.
//---------------------------------------------------------------------------------------
struct coHealth {
  float    residEma  = -1.0f;   // mm, gleitendes Welt-Residuum (-1 = leer)
  uint16_t badStreak = 0;
};

bool coObserveCheck(coHealth& h, int32_t lxr, int32_t lyr,
                    int32_t wxLidar, int32_t wyLidar,
                    float gateMm, float assocMm, uint16_t maxBad) {
  if (!myPose.validWorldPose) return false;
  int xw, yw; localToWorld(lxr, lyr, myPose, xw, yw);
  float dx = (float)xw - wxLidar, dy = (float)yw - wyLidar;
  float d  = sqrtf(dx*dx + dy*dy);
  if (d > assocMm) return false;                     // anderes Ziel -> nicht bewerten
  h.residEma = (h.residEma < 0) ? d : (0.7f * h.residEma + 0.3f * d);
  if (h.residEma > gateMm) h.badStreak++; else h.badStreak = 0;
  return h.badStreak >= maxBad;
}

//---------------------------------------------------------------------------------------
// VPS-Aufruf /calibrate (nur mit USE_VPS_CALIBRATE, zieht HTTPClient wie vpsLocalize).
// Sendet alle ausreichend langen Eigen-Spuren und Welt-Quellen; der VPS waehlt die beste
// Kombination (RANSAC) und liefert tx/ty/heading/mirror/confidence/inlier_ratio/source.
//---------------------------------------------------------------------------------------
#ifndef VPS_CAL_PORT
#define VPS_CAL_PORT VPS_LOC_PORT
#endif
#ifndef VPS_CAL_PATH
#define VPS_CAL_PATH "/calibrate"
#endif
#ifndef VPS_CAL_TIMEOUT_MS
#define VPS_CAL_TIMEOUT_MS 30000
#endif

#ifdef USE_VPS_CALIBRATE
bool vpsCalibrate(const coCalState& s, int32_t& txmm, int32_t& tymm, float& headDeg,
                  int& mir, String& conf, float& inlier, uint8_t& srcOut) {
  inlier = 0.0f; srcOut = 0;
  if (WiFi.status() != WL_CONNECTED) return false;
  String body; body.reserve(8192);
  body = "{\"radar_tracks\":[";
  bool firstTrack = true;
  for (uint8_t t = 0; t < CO_RADAR_TRACKS; t++) {
    if (s.ln[t] < CO_MIN_TRACK_PTS) continue;
    if (!firstTrack) body += ',';
    firstTrack = false;
    body += '[';
    for (uint16_t i = 0; i < s.ln[t]; i++) {
      if (i) body += ',';
      body += '['; body += s.lx[t][i]; body += ','; body += s.ly[t][i]; body += ']';
    }
    body += ']';
  }
  body += "],\"world_tracks\":[";
  bool firstSrc = true;
  for (uint8_t w = 0; w < s.wSrcCount; w++) {
    if (s.wn[w] < CO_MIN_TRACK_PTS) continue;
    if (!firstSrc) body += ',';
    firstSrc = false;
    body += "{\"id\":"; body += s.wSender[w]; body += ",\"pts\":[";
    for (uint16_t i = 0; i < s.wn[w]; i++) {
      if (i) body += ',';
      body += '['; body += s.wx[w][i]; body += ','; body += s.wy[w][i]; body += ']';
    }
    body += "]}";
  }
  body += "]}";
  if (firstTrack || firstSrc) return false;          // auf einer Seite zu wenig Punkte

  HTTPClient http;
  String url = "http://" + ipVPS.toString() + ":" + String(VPS_CAL_PORT) + VPS_CAL_PATH;
  if (!http.begin(url)) return false;
  http.setTimeout(VPS_CAL_TIMEOUT_MS);
  http.addHeader("Content-Type", "application/json");
  int code = http.POST(body);
  bool ok = false;
  if (code == 200) {
    String r = http.getString();
    float fx = jsonNum(r, "\"tx_mm\""), fy = jsonNum(r, "\"ty_mm\"");
    headDeg = jsonNum(r, "\"heading_deg\""); mir = (int)jsonNum(r, "\"mirror\"");
    conf = jsonStr(r, "\"confidence\""); inlier = jsonNum(r, "\"inlier_ratio\"");
    srcOut = (uint8_t)jsonNum(r, "\"source\"");
    if (!isnan(fx) && !isnan(fy) && !isnan(headDeg) && (mir == 1 || mir == -1)) {
      txmm = (int32_t)lroundf(fx); tymm = (int32_t)lroundf(fy); ok = true;
    }
  } else Serial << "VPS calibrate HTTP " << code << endl;
  http.end();
  return ok;
}

// Sammelfenster abschliessen: Trajektorien an den VPS senden, Pose mit Quality-Gate
// uebernehmen (conf=HOCH UND inlier>=minInlier), in NVS speichern und kurzen Status
// per Text-Multicast melden. true = neue Welt-Pose uebernommen.
bool coCalibFinish(coCalState& s, float minInlier) {
  s.active = false;
  int32_t tx = 0, ty = 0; float hd = 0; int mir = 1;
  String conf; float inlier = 0; uint8_t src = 0;
  bool ok   = vpsCalibrate(s, tx, ty, hd, mir, conf, inlier, src);
  bool good = ok && (conf == "HOCH") && (inlier >= minInlier);
  if (good) {
    myPose.worldX = tx; myPose.worldY = ty;
    myPose.heading = wrap360f(hd) * 4096.0f / 360.0f; myPose.mirror = (int8_t)mir;
    myPose.validWorldPose = true; savePose(myPose);
    sendUdpTextln("calib OK: src=" + String(src) + " conf=" + conf +
                  " inl=" + String(inlier, 2) + " x=" + String(tx) + " y=" + String(ty));
  } else {
    sendUdpTextln(String("calib FAIL: ") +
                  (ok ? ("conf=" + conf + " inl=" + String(inlier, 2)) : "no VPS / zu wenig Punkte"));
  }
  return good;
}
#endif  // USE_VPS_CALIBRATE
