smily77/CatFind/(commit log)

2026-05-08 Add RotaryLine sketch (Tab5 + Encoder Unit)
2026-06-12 Add 6_3 versions: fixed header + variable payload UDP protocol
    - xComDef6_3.h: replace fixed-size union mcDataStruct/ucDataStruct with
    msgHeader (version, sender, msgCode, payloadLen, timeStamp) plus typed
    payload structs (posPayload, hbPayload, pa2HbPayload, radarHbPayload,
    cmdPayload); packed structs for a defined wire format; add Simulator
    to the device dB
    - xComProc6_3.h: common send/receive routines for broadcast (multicast)
    and unicast using the same message format (broadcastMsg/unicastMsg,
    parseXMsg, getPayload, broadcastRawMsg); header is filled automatically
    on send; packets validated via version and payloadLen
    - New 6_3 sketches alongside the existing 6_2 ones: Manage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
2026-06-12 Add wiring schematics (Schema_6_3.md) derived from hwDef pin definitions
    Covers Manager, Button, LD06, PA2i, Radar (all three Dome variants) and
    Simulator; displays omitted due to the many hardware variants.
2026-06-14 Laser Marker
2026-06-14 Integrate LaserMarker into the 6_3 environment
    Shared headers (xComDef6_3.h / xComProc6_3.h):
    - Add device LaserMarker (ID 15, type Marker, static IP .182) to the device dB
    - Add markerHbPayload (hbPayload + mainLaser/subLaser/aux + RGB) reporting the
    full device state in the heartbeat
    - Add command codes cmdMainLaser/cmdSubLaser/cmdAux/cmdPixelColor/cmdMarkerState
    - printSensorData now decodes marker heartbeats
    New program LaserMarker/LaserMarker6_3/:
    - LaserMarker6_3.ino: network-controlled main/sub laser, aux and NeoPixel;
    applies commands and confirms with an immediate heartbeat; periodic HB
    - hwDef.h / hwProc.ino: ESP32-C3 Super Mini pin map and init
    - Schema_6_3.md: wiring derived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
2026-06-14 Fix LaserMarker compile error: rename pin macros to avoid field collision
    The pin macros mainLaser/subLaser in hwDef.h had the same names as the
    markerHbPayload fields, so the preprocessor rewrote state.mainLaser into
    state.3 (expected unqualified-id before numeric constant). Rename the pin
    macros to mainLaserPin/subLaserPin/auxPin (and pinSDA/pinSCL/pinTxD/pinRxD)
    following the existing pixelPin convention. Shared headers unchanged.
2026-06-15 Add standalone LaserMarker I2C slave
2026-06-15 Add LaserMarker pixel safety indicators
2026-06-18 Integrate PowerActor1_1 (stepper turret) into the 6_3 environment
    Shared header (xComDef6_3.h):
    - Add device PA1_1 (ID 16, type PowerActor, static IP .183, PowerActor1_1)
    - Add relay command codes cmdWirelessPower (16) and cmdExtPower (17)
    - PA1_1 reuses pa2HbPayload and all existing PA commands -> drop-in PowerActor
    for Display/Button (no new HB payload, xComProc unchanged)
    New program PowerActor1_1/PA1_1_6_3/:
    - Same function as PA2i: receives catObserved, aims the turret, fires water
    when armed and target within limits; broadcasts pa2HbPayload state
    - Turret via stepper (A4988 over PCF8574 @0x20) instead of bus servo; AS5600
    angle encoder; belt 20:130; reed contacts for homing; rel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
2026-06-18 PA1_1: set turret range to +-180 deg (maxAngle 180)
    Per spec 'wie PA2 aber +-180 Grad': maxAngle 180 -> systemAngle 2048 ->
    default limits 2048+-2048 = full circle [0..4096]. Homing (center between
    the two reeds = straight ahead) unchanged. Verified: compiles, 70% of
    min_spiffs partition.
2026-06-18 Rename PA1_1_6_3 -> PA1_1_6_3_0; add AS5600-rebuild encoder test (turret + CYD28 display)
    - Rename PowerActor1_1/PA1_1_6_3 -> PA1_1_6_3_0 (folder + sketch + internal
    comments + doc reference)
    - xComDef6_3.h: document cmdRichtung as 'drive to absolute PA angle 0..4096'
    (used by the encoder test / jog); position report reuses measurement+posPayload
    - New PowerActor1_1/Tests/encoderTest6_3_1 (turret side, framework PA1_1_6_3_0):
    receives cmdRichtung target angle, drives the stepper turret, reports step
    position AND AS5600 position as measurement-posPayload. #define AS5600_ON_TOWER
    switches the AS5600 mount (stepper shaft factor 6.5 vs. turret factor 1).
    - New Displays/Test/Pa1_1_encod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
2026-06-28 Add world-coordinate Lidar C1 sensor + VPS localizer
    Sensor mit absoluten Koordinaten (GesamtKonzeptCatFinder.md):
    - CF_LidarC1/C1Lidar6_3_0: neuer ESP32-S3 RPLidar-C1-Sensor, welt-faehig.
    20s Hintergrund lernen, Pose per VPS (HTTP), No-Shot vom Manager,
    catObserved mit relativen + Welt-Koordinaten nur im schiessbaren Bereich,
    Status-Pixel + Text-Multicast nach Init, OTA. Keine Wand mehr noetig.
    - VPS/localizer: Docker-Lokalisierungsdienst (HTTP), portiert aus
    lidar_localize.py; laedt Map/RasenKarte.csv aus dem GitHub-Repo.
    Gemeinsame Header (xComDef/xComProc):
    - device-DB: LidarC1 (ID 17, DHCP, Lidar, groupNone)
    - loadNoShot/insideNoShot (Point-in-Polygon, schiessbarer Bereich)
    - s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
2026-06-28 Add hit visualization: VPS dashboard + Manager gateway
    Treffervisualisierung (GesamtKonzeptCatFinder.md):
    - VPS/dashboard: Docker-Webserver (Port 80, extern erreichbar). Single-Page-UI
    mit immer sichtbarem System-Debug-Fenster + HB-Geraeteliste; umschaltbar
    Ereignisliste (pro Minute), Welt-Karte (ueber RasenKarte) und relative
    Gruppen-Karten 1-3; Farbe je Sensor/Ziel; Reset-Button. State im RAM.
    - Manager als Gateway (gatewayProc.ino): puffert catObserved/HB/Debug-Text und
    postet sie gebuendelt an ipVPS:80/ingest (~alle 1.5s), inkl. group aus
    device[sender].group. Lokaler Betrieb laeuft ohne Manager weiter.
    Doku: Dokumentation_6_3.md (Manager-Gateway-Rolle, VPS-Dashboard,
    Verzeich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
2026-06-29 dashboard: no-store cache headers to prevent stale browser view
    Browser cachte /state bzw. die Seite -> veraltete Anzeige trotz frischer
    Daten. after_request setzt Cache-Control: no-store auf allen Antworten.
2026-06-29 Localization quality gate + VPS request logging
    Systematischer Per-Boot-Positionsfehler (~2,5 m bei einem Mess-Batch): der globale
    VPS-Matcher waehlt bei gestoertem/duennem 20-s-Hintergrund gelegentlich eine
    gespiegelte/mehrdeutige Pose. Diagnose ueber neues VPS-Logging bestaetigt: gute
    Boots haben dichten Hintergrund (bins ~340) und inlier ~0.68; schlechte korrelieren
    mit duennem Hintergrund.
    Fix (Quality-Gate, xComProc):
    - vpsLocalize liefert jetzt inlier_ratio.
    - resolvePose uebernimmt eine NEUE Pose nur bei conf=HOCH UND inlier >= LOC_MIN_INLIER
    (0.60). Eine hochwertige Messung ueberschreibt IMMER die NVS-Pose -> kein
    Festfahren auf einer schlechten Pose. Schlechte Messung -> gute N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
2026-06-29 Add concept task: calibrate radar world-pose via co-observation
2026-06-30 Co-Observation-Kalibrierung (Radar) + Dashboard-Trefferzahl
    Welt-Pose eines nicht selbst-lokalisierenden Sensors per gleichzeitiger
    Beobachtung einer Person mit einem welt-posierten Sensor.
    - xComDef: cmdCalibrate(18) (Knopf/commandMsg-Trigger), kein neues Wire-Format
    - xComProc: coCalState (3 Eigen-Spuren + Welt-Quellen je Sender-ID),
    coCalibBegin/FeedLocal/FeedWorld/Elapsed/Finish, vpsCalibrate
    (USE_VPS_CALIBRATE), fillWorld, coHealth/coObserveCheck (Drift-Erkennung).
    Quality-Gate: conf==HOCH UND inlier>=0.6.
    - VPS /calibrate: ICP mit reihenfolge-erhaltender DTW-Korrespondenz + Kabsch
    ueber mirror=+-1, je (Eigen-Spur x Welt-Quelle), beste gewinnt (source).
    Linearitaets-Check spe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
2026-06-30 Dashboard: Gruppe-3-Map-Label (Testgruppe)
    Dome (device-ID 1) ist der Testgruppe (group 3) zugeordnet; das veraltete
    Label "(noch keine Gruppe 3)" auf der relativen Gruppe-3-Karte entfernt.
    Die Gruppe-3-Map zeigt jetzt Domes relative Ziele (Manager neu geflasht,
    damit device[Dome].group=3 in den Events ankommt).
2026-06-30 Touch-Remote fuer Radar-Kalibrierung (CYD35)
    Neues Bediengeraet Displays/radarCalibrationButton/ auf CYD35 (classic ESP32,
    ST7796 + XPT2046-Touch), basiert auf Udisp6_3_0 (gleiches LovyanGFX-Profil),
    UI-reduziert auf einen Vollflaechen-Touch-Button. Tippen sendet dem Radar
    "Dome" per Unicast commandMsg/cmdCalibrate (info=45000ms) und startet dort den
    Co-Observation-Kalibriermodus. Zeigt die Status-Text-Multicasts des Radars an.
    Verifiziert: kompiliert (esp32:esp32:esp32), per COM9 geflasht, bootet + WiFi
    (DHCP .19); das exakt vom Button gesendete Paket triggert den Radar end-to-end
    (Antwort "calib Knopf: Fenster 45s" auf dem Text-Multicast). Touch selbst nur
    am Geraet pruefbar.
    Doku: Dokum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
2026-06-30 Radar vertraut beim Boot der gespeicherten NVS-Pose
    Das Radar kann sich nicht selbst lokalisieren und wird im Normalfall nicht
    bewegt (Aus/Ein). Statt nach jedem Boot validWorldPose=false zu setzen (was eine
    Neukalibrierung erzwingen wuerde), wird einer vorhandenen NVS-Pose direkt
    vertraut (validWorldPose=true). Der laufende Health-Check (coObserveCheck) ist
    der Quickcheck: ein mitbeobachtender welt-posierter Sensor verwirft eine
    inzwischen falsche Pose (Drift zwischen ~0.6 und ~1.5 m), danach greift der
    Auto-Trigger. Groessere Abweichungen gelten als "anderes Ziel" -> Knopf.
    Radar (.37) neu geflasht. Doku: Dokumentation_6_3.md Kap. 4.1 + 5.2,
    GesamtKonzeptCatFinder.md Umsetzungs-Sektion.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
2026-06-30 Zweiter Knopf: gespeicherte Welt-Pose loeschen (cmdClearPose)
    Anwendungslogik: wurde das Radar bewegt (grobe Pose-Fehler erkennt der
    Health-Check nicht selbst), muss die gespeicherte Pose verworfen werden.
    - xComDef: cmdClearPose(19)
    - xComProc: clearPose() - NVS-Namespace "pose" leeren
    - Radar: handleCommand behandelt cmdClearPose (clearPose + validWorldPose=false
    + Health-Check-Reset + Status-Multicast)
    - radarCalibrationButton: zweiter Touch-Button "POSE LOESCHEN" (cmdClearPose)
    neben "KALIBRIEREN" (cmdCalibrate)
    Verifiziert: beide Sketche kompiliert; Radar (.37) per OTA, Remote per COM9
    geflasht und gebootet; Befehlskette end-to-end getestet (Radar antwortet
    "Pose geloescht -> nich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
2026-07-01 Aufgabenbeschreibung Einstellung und Steuerung der CatFinder Elemente
2026-07-01 Einstellung und Steuerung der CatFinder Elemente
    Generisches Einstellungs-/Aktions-Modell fuer Anzeige (LED), Automatik-Aufgaben
    und ausloesbare Funktionen, bedienbar per Touch-Display und VPS-Webinterface.
    Gemeinsame Dateien (xComDef6_3/xComProc6_3):
    - deviceSettings mySettings (supported/values/actions); STG_*-Masken je hwDef
    - msgCodes settingsRequest(11)/settingsReport(12), cmds cmdSetSetting(20)/cmdCopyPose(21)
    - initSettings/saveSettings/settingOn, sendSettingsReport/sendPoseReport,
    handleCommonMsg, copyPoseFromGroup (NVS-Namespace "devcfg")
    Geraete:
    - Radar: HB-/Target-Anzeige schaltbar, Auto-Kalib/Auto-Pose-Kopie schaltbar,
    Aktionen Kalibrieren/Pose-kopieren
    - Lidar C1: catObse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
2026-07-01 Manager: eigene Einstellungen ans VPS relayen
    Der Manager sendet sich selbst kein settingsReport per Multicast; damit er
    auf der VPS-Steuerseite erscheint, fuehrt gwFlush() seine eigenen mySettings
    bei jedem Push mit.
2026-07-01 Lidar-HB-Blitz, Manager-HB, VPS-Steuerung nur aktive Geraete
    - Lidar C1: gruener HB-Blitz (stgHbLed, persistiert) implementiert; updateLeds()
    vereint Detektion (Vorrang) und HB-Blitz, state-diffed, jede loop()-Iteration
    (laeuft auch bei Motor aus). STG_SUPPORTED/DEFAULT/PERSIST um stgHbLed erweitert.
    - Manager: sendet jetzt selbst HB (periodeForHB) + gwAddHb(self) -> erscheint als
    aktives Geraet (HB-Liste + Steuerseite), unabhaengig von Multicast-Loopback.
    - VPS-Dashboard: /state liefert Geraete-Einstellungen nur noch fuer AKTIVE Geraete
    (HB in den letzten HB_WINDOW_S=180s gesehen); abgeschaltete Geraete fallen raus.
2026-07-01 Bedienung_Einstellungen: Sunton5/Disp5 als Zielboard
    - #define auf Sunton5 gestellt (ESP32-S3, 800x480, kapazitiver Touch)
    - 8-Encoder-Abhaengigkeit (M5_8EN / UNIT_8ENCODER) in der Kopie entfernt:
    das Touch-Bediengeraet braucht den Encoder des Prototyps nicht.
    Build: esp32:esp32:esp32s3, PSRAM=opi, QIO, 16MB, Default-Partition; USB COM7.
2026-07-01 Aktion "Pose loeschen" (cmdClearPose) im Display + VPS bedienbar
    Der Radar konnte cmdClearPose(19) schon verarbeiten, es war aber nicht als
    ausloesbare Aktion ausgewiesen. Neu: actClearPose(2), ACT_COUNT=3.
    - xComDef: actClearPose(2)
    - Radar hwDef: STG_ACTIONS += actClearPose -> Radar meldet act=7
    - Display Bedienung_Einstellungen: dritter Aktions-Button "Pose loeschen"
    - VPS-Dashboard: dritte Aktion im Steuerungs-Tab
    - Doku (Dokumentation_6_3.md, GesamtKonzeptCatFinder.md) nachgefuehrt
    Geflasht: Radar (OTA .37), Display (USB COM7); VPS neu deployt.
2026-07-01 Doku 6_3: VPS in Prinzipskizze, Lidar-C1 Motor=Idle, kleine Korrekturen
    - Prinzipskizze (Kap. 1) neu: VPS (Localizer/Dashboard), Manager-Gateway,
    welt-faehiger LidarC1, zweiter Aktor PA1_1, Bedien-/Steuer-Display,
    LaserMarker; "Kette im Normalbetrieb" um Welt-Koordinaten/Mehr-Aktor/
    VPS-Lokalisierung/Steuerung erweitert
    - Kap. 5.10: "Motor aus" = echtes Sensor-Idle beim RPLidar C1
    (STOP dreht Motor herunter + stoppt Sampling), inkl. Fallstricke
    - Stand-Datum auf 2026-07-01; testGroup(3)/Dome in Kap. 2 ergaenzt
2026-07-01 Aufgabe: Katze oder Stoerung - Ereignis-Validierung (Konzept)
    Strategie gegen Fehlmeldungen (Sonne ins Lidar, Einzel-Events, Insekten,
    Vegetation, Regen): Sturm-Modus als Selbstdiagnose im Sensor, Track-
    Bestaetigung statt Treffer-Zaehlen (~0,5 s), Fusion als Beschleuniger statt
    UND-Pflicht; Ground Truth ueber Simulator-Langzeitaufnahmen und
    Kalibrier-Personenlaeufe. Noch nicht umgesetzt.
2026-07-02 VPS-Modellierung Katzenerkennung: Analyse-Tab, SQLite-Aufnahme, Modell, ms-Zeitstempel
    - GesamtKonzept: neue Aufgabe "VPS-Modellierung der Katzenerkennung (CatDetected)"
    - Dashboard: persistente catObserved-Aufnahme (SQLite im Docker-Volume,
    Pause/Append), Endpunkte /rec /density /adata /amodel /aparams /alabels
    - catmodel.py: Track-Bildung (NN+Gate), Sturm-Erkennung je Sensor,
    Ebene-2-Bestaetigung, Sensor-Gewichte (Lidar bestaetigt nie allein), Fusion;
    Parameter-JSON im Volume, ohne Rebuild aenderbar
    - UI: Tab "Analyse" mit Zeitleiste (Dichte, scrollen/strecken/stauchen),
    Zoom-Karte, Sensor-Ein/Aus, Labeling, CatDetected-Overlay
    - Manager-Gateway: pro Event ms-Empfangszeit + targetS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
2026-07-02 __pycache__ entfernen und ignorieren
2026-07-02 Erkennungsmodell v2: Score-System, Typ-Gewichte aus xComDef, empirische Abdeckung
    - catmodel.py v2: Score 0..100 mit Aufschluesselung statt starrer Regeln;
    Pflicht bleibt eine kohaerente Bewegungsphase (gegen Vegetation)
    - Sensor-Gewichte je GERAETETYP (HLK/Lidar/...); Geraetetabelle wird dynamisch
    aus xComDef6_3.h geparst (GitHub raw) - neue Sensoren ohne VPS-Eingriff
    - Erfassungsgrenzen empirisch aus den Langzeitdaten (Belegungsraster):
    Eintritt/Austritt am Rand der GESAMT-Abdeckung gibt Bonus (Ueberlappung/
    Uebergabe zaehlt nicht als Austritt), mitten im Feld nur weicher Malus;
    /acoverage + Karten-Overlay "Abdeckung"
    - Sitzende Katze (koten!): Track-Stitching ueberbrueckt Radar-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
2026-07-03 Analyse-Tab: Aufnahme-Band im Zeitstrahl, klarer REC-Zustand, Fenster=ganze Aufnahme
    - Ursache "0 Events": Aufnahme war (per REC-Knopf) pausiert und der Zustand
    kaum erkennbar -> Knopf zeigt jetzt klar "Aufnahme laeuft"/"AUFNAHME AUS",
    Pausieren nur mit Rueckfrage, roter Warnbalken solange pausiert
    - recspans: aufgezeichnete Abschnitte werden mitgeschrieben (auch ohne
    Events, solange der Manager pusht); /density liefert sie mit; Zeitstrahl
    zeigt gruenes Band = aufgezeichnet, dunkel = Luecke
    - Analyse oeffnet mit der GANZEN Aufnahme statt letzter Stunde; neuer
    "Alles"-Knopf; Label-Sender-Auswahl wird laufend aktualisiert
    - (RAM-Events des Containers wurden vor dem Neustart in die DB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
2026-07-04 Erfassungssektoren aus xComDef + Posen, manuelle Track-Bewertung, Zeitleiste v2
    - xComDef: covLeftDeg/covRightDeg/covRangeMm je Geraet (HLK -60..+60 7m,
    Lidar 360 12m); catDetected (msgCode 13) + catDetectedPayload definiert
    (Sender = Folgeaufgabe ESP32-DetectionActor)
    - Manager-Gateway: sammelt poseReport aller Geraete (poseRequest-Broadcast
    alle 5 min + nach Boot, target 254 via VPS), pusht "poses" im Ingest
    - VPS: Posen persistent (SQLite), build_coverage_geo rasterisiert Sektoren
    (Fallback empirisch), /acoverage mit Sektoren, /devreload + "Geraete"-Knopf
    - Manuelle Track-Bewertung (/amark, track_marks, stabiler Track-Key) +
    Uebereinstimmungs-Statistik Modell vs. Mensch im Track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
2026-07-04 Radar: RasenKarte-Gating + Health-Check nur bei AutoCalib; Kalibrier-Knopf mit Zielauswahl
    - xComDef: Kartentyp mapRasen (Rasen-Umriss Welt-mm aus Map/RasenKarte.csv)
    - Manager: seeded/served /rasen.csv wie die No-Shot-Karte (ensureMaps)
    - xComProc: generisches acquireMap (acquireNoShot = Wrapper); Karten-Empfang
    sammelt Chunks jetzt im RAM und schreibt die Datei EINMAL am Ende -
    LittleFS-Schreiben mitten im Transfer verlor mit dem Single-Paketpuffer
    reproduzierbar Chunks (Abbruch bei Chunk 3/19); Manager-Chunk-Abstand
    4->10 ms; Karten-Fortschritt via Text-Multicast (VPS-Debug) statt Serial
    - Radar: Pose-Drift-Health-Check laeuft nur noch bei stgAutoCalib=an (sonst
    bliebe eine Verw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
2026-07-04 Manager-Selbst-Kommandos + Kalibrier-Countdown auf dem Knopf
    - Manager gwInjectCommand: Kommandos mit target=Manager werden lokal via
    handleCommonMsg ausgefuehrt - ein UDP-Unicast an die eigene IP loopt
    nicht in den eigenen Socket zurueck, darum reagierten die HB-/Cat-
    Anzeige-Schalter des Managers in der VPS-Steuerung nicht
    - radarCalibrationButton: nach KALIBRIEREN zaehlt der Button das
    45-s-Fenster sichtbar herunter ("laeuft ... 37s", ocker); sekuendlich
    wird nur der Button neu gezeichnet (kein Flackern)
    Verifiziert: VPS-Steuerung toggelt Manager-HB-Anzeige (val 3->2->3);
    geflasht OTA: Manager .180, Kalibrier-Knopf .19.
2026-07-04 Analyse: Flag-Chips, Bewertungs-Kategorien, Maeher-Ausschluss + Weglaengen-Grenze
    - Track-Zeilen zeigen die Modell-Flags immer als Chips (sitzt/offen/
    rein/raus/2+ Sensoren) - das FUSION-Flag war vorher kaum auffindbar
    - Manuelle Bewertung mit Kategorien: Katze/Person/Vogel/Maeher/Stoerung
    (/amark erweitert; alles ausser Katze zaehlt in der Uebereinstimmung
    als "keine Katze"; Kategorien = gelabelte Ground-Truth)
    - RoboMaeher: neues Label "Maeher" = Analyse-Ausschlussfenster (/amodel
    filtert die Events vor dem Tracking; aufgezeichnet + dargestellt bleibt
    alles, die Laeufe leuchten die Erfassungsbereiche aus); zusaetzlich
    verwirft das Modell Tracks mit Weg > max_path_mm (40 m) auto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
2026-07-04 Doku auf Tagesstand: Karten-Verteilung, Countdown, Steuer-Gateway
    - Kap. 4.2: mapRasen-Typ, RAM-Sammelpuffer-Empfang (Begruendung Chunk-
    Verlust), 10-ms-Chunk-Abstand, acquireMap/acquireNoShot/insideNoShot
    in der Prozedur-Tabelle, ensureMaps + Anleitung zum Regenerieren des
    RasenKarten-Seeds bei Kartenaenderung
    - Kap. 5.11: KALIBRIEREN-Button zaehlt das 45-s-Fenster herunter
    - Steuerungs-Tab: target 254 (poseRequest), Manager-Selbst-Kommandos
    werden lokal ausgefuehrt (kein UDP-Loopback an die eigene IP)
    - Stand-Datum 2026-07-04
2026-07-05 VPS: kontinuierliche Trackerkennung entkoppelt von der Betrachtung
    - Hintergrund-Analysierer arbeitet die Aufnahme in Haeppchen ab
    (catmodel.analyze_stream), persistiert fertige Tracks mit fortlaufender
    Nummer in SQLite; /amodel liest nur noch (Zoom hat keinen Einfluss mehr)
    - Parameter-/Maeher-Label-Aenderung -> automatischer Neuaufbau (Signatur);
    Bewertungen+Klebungen ueberleben ueber den stabilen Track-key
    - angeklickter Track gelb hervorgehoben in Karte UND Zeitleiste
    - Tracks zusammenkleben/loesen (/amerge /aunmerge, 🔗-Auswahl im Track-Panel)
    - neue Bewertungen: Insekt, Sturm, sicher keine Katze
    - Trackliste separat nutzbar: /atracks(.csv) Export + /avalidate
    (Modell-Check ge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
2026-07-05 Cat Identifier (Geraet 18): Echtzeit-Katzenerkennung auf dem ESP32
    - neuer Sketch CatIdentifier/CatId6_3_0: Streaming-Port von catmodel.py
    (Gate+Stitch-Tracking, Bewegungsphase, Score, Sturm je Sensor, Maeher-K.o.,
    Erfassungsrand geometrisch aus device[]-Sektoren + mitgehoerten poseReports)
    - catDetected wird bei Bestaetigung DOPPELT gebroadcastet (UDP-Verlustschutz),
    Empfaenger dedupen ueber identische Payload; Status via Text-Multicast
    - Modell-Parameter vom VPS (neuer Endpunkt /aparams.csv, key=value flach),
    LittleFS-Cache; Aktion "Parameter laden" (actReloadParams/cmdReloadParams)
    - xComDef: CatIdent(18, IP .184, Typ Detector), deviceCount, stgCatDetLed,
    actReloadParams, cmdRel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
2026-07-05 CatIdent: XIAO-ESP32-S3-Anpassungen + DNS/NTP-Fix (live verifiziert)
    - Hardware ist ein Seeed XIAO ESP32-S3: User-LED GPIO21 ACTIVE-LOW,
    WLAN nur ueber IPEX-Antenne (ohne Antenne taub - war die Boot-Blockade)
    - WiFi.config MIT DNS (4. Argument): ohne DNS haengt NTP (pool.ntp.org)
    endlos; Zeit-Sync jetzt mit 15-s-Budget statt Endlosschleife
    - live verifiziert: .184 aktiv, Parameter vom VPS, catDetected beim
    Manager empfangen (rotes Blinken), Aktion "Parameter laden" via
    VPS-Steuerung end-to-end
2026-07-05 Cat Cam (Geraet 19): XIAO Vision AI Camera - Fotos + KI-Katzenerkennung
    - neuer Sketch CatCam/CatCam6_3_0 (XIAO ESP32-C3 + Grove Vision AI V2 per
    I2C/SSCMA): Foto bei catDetected vom Bus (Dedupe der Doppelsendung),
    eigene KI-Erkennung (stgCamAi) -> catObserved (worldValid=0, Score in res)
    + Foto bei neuer Sichtung, Aktion "Foto jetzt" (cmdTakePhoto)
    - Bild-Abruf umgeht zwei Lib-Grenzen von Seeed_Arduino_SSCMA 1.0.3:
    invoke() kann "Event MIT Bild ohne DIFFERED" nicht ausdruecken und das
    interne wait()-Timeout (1 s) ist fuer ~30 kB Base64 via I2C zu knapp ->
    AT+INVOKE=1,0,0 direkt + eigenes Einsammeln ueber available()/read()
    - VPS: POST /photo (Base64-JPEG -> /data/photos + SQLite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
2026-07-05 CatCam: Vision-Modul-Auto-Reconnect + Katzen-Klasse automatisch aus dem Modell
    - aiEnsure(): schlug AI.begin beim Boot fehl (Modul haengt/steckt neu), blieb
    vorher dauerhaft "Vision-Modul fehlt" - jetzt alle 5 s Reconnect-Versuch
    (live verifiziert: Modul kam nach Reset selbstaendig wieder)
    - Katzen-Klassen-ID wird beim Init aus der Modell-Info bestimmt (Base64-JSON
    dekodieren, "classes"-Eintrag mit "cat" suchen) - funktioniert damit fuer
    Cat Detection, Pet Detection (cat/dog) UND COCO-Modelle ohne Neuflash;
    Fallback bleibt 15 (COCO), Meldung "Katzen-Klasse=N" im VPS-Debug
2026-07-05 Doku 6_3 auf Stand: Cat Identifier + Cat Cam, catDetected, VPS-Analysierer/Bilder
    - Ueberblick + ASCII-Diagramm: Erkennungs-Ebene 2 (CatIdent/CatCam),
    HTTP-Wege zum VPS (/aparams.csv, /photo)
    - device dB: 18 CatIdent (.184), 19 CatCam (.185), deviceCount,
    WiFi.config-DNS-Hinweis bei statischer IP
    - Nachrichtenformat: catDetected(13) + catDetectedPayload-Tabelle,
    settingsPayload-Bits (stgCatDetLed/stgCamAi) + Aktionen
    (actReloadParams/actPhoto), cmdReloadParams(22)/cmdTakePhoto(23)
    - Manager: rotes Blinken bei catDetected (Dedupe der Doppelsendung)
    - neue Kapitel 5.13 (Cat Identifier) + 5.14 (Cat Cam)
    - Analyse-Tab-Block aktualisiert: kontinuierlicher Analysierer,
    Track-Nummern, Kle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
2026-07-07 Analyse-Tab: zuletzt gewaehltes Zeitfenster merken (localStorage)
    Beim Oeffnen des Analyse-Screens wurde bisher immer die ganze Aufnahme
    eingepasst (anaAll) -> mit wachsender Datenmenge immer langsamer. Jetzt
    wird das aktuell gewaehlte Fenster in anaScheduleFetch persistiert und
    beim Start wiederhergestellt; Fallback auf anaAll nur wenn nichts/kaputtes
    gespeichert ist.
2026-07-07 Kalibrier-Knopf: Radar-Chip GELB bei gueltiger Welt-Pose
    Nach einer Kalibrierung sah man am Knopf nicht, ob sie erfolgreich war.
    Der Knopf fragt die Radare jetzt zyklisch per poseRequest (unicast) ab,
    faengt die poseReport-Antworten (validWorldPose) auf und faerbt den
    Ziel-Chip gelb ("Pose OK") bzw. dunkel ("keine Pose"). Nach dem Ausloesen
    wird das gewaehlte Radar ~30 s gezielt beobachtet, damit das Ergebnis
    schnell erscheint. Live verifiziert: Dome meldet valid=1, Mini_Dome=0.
2026-07-08 Add manual sensor pose calibration UI and API to VPS dashboard
    ### Motivation
    - Provide an in-dashboard way to preview and mark manual world-poses for sensors (especially radars) where firmware cannot be changed, so operators can validate/capture poses without new bus protocol support.
    - Surface a compact snapshot of devices, valid poses and recent hits for interactive manual calibration.
    - Document how to update/redeploy the dashboard and optionally rebuild the Localizer container on the VPS.
    ### Description
    - Implemented two new HTTP endpoints in `VPS/dashboard/dashboard.py`: `GET /manual_data` returns a compact snapshot (`devices`, `poses`, `events`, `calibratable`) and `POST /manual_p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
2026-07-08 Manuelle Pose: calibratable-Filter auf Geraetetyp HLK korrigiert
    Die HLK-Radare tragen in der Geraetetabelle den Typ "HLK", nicht "Radar".
    Der Filter "Radar" in type traf daher nie zu -> calibratable blieb leer
    (JS fiel auf alle Geraete zurueck). Jetzt korrekt auf HLK gefiltert.
2026-07-09 Manuelle Pose: calibratable filtert HLK-Radare statt nicht-existentem Typ "Radar"
    Kein Geraet in xComDef traegt den Typ "Radar" - die Radarmodule (Dome,
    Mini_Dome, Compact_Dome) sind Typ "HLK". Der bisherige Filter lieferte
    daher eine leere calibratable-Liste, worauf das Dashboard auf ALLE Geraete
    (inkl. Displays/Manager) zurueckfiel. Jetzt werden korrekt nur die HLK-Radare
    als manuell kalibrierbar angeboten.
2026-07-09 Coverage/Pose: sichtbare System-Meldungen im Debug-Fenster
    Bisher gab es beim Coverage-Lernen keine dauerhafte Rueckmeldung, ob es
    tatsaechlich griff. Neu: VPS stellt ueber _sysmsg() Meldungen ins scrollende
    Debug-Fenster (wie Bus-Debug):
    - Coverage GELERNT + aktiv (Ecken/Punkte/Flaeche/Zeitfenster)
    - Coverage-Vorschau (noch nicht gespeichert)
    - Coverage lernen FEHLGESCHLAGEN inkl. Grund (zu wenige Punkte, keine Pose, ...)
    - Coverage GELOESCHT bzw. kein aktives Polygon
    - Manuelle Pose gesendet (x/y/head/mir)
    coverage_delete meldet jetzt zusaetzlich, ob wirklich ein aktives Polygon
    deaktiviert wurde (rowcount).
    CatIdentifier meldet die Anzahl geladener Polygone beim Boot und beim
    "Parameter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
2026-07-09 Analyse-Tab: Knoepfe "Coverage lernen/loeschen" verdrahten
    Die Buttons anaBCovLearn/anaBCovDel und ihre Handler existierten, waren aber
    nie per .onclick gebunden -> Klick tat gar nichts. onclick-Zuweisung ergaenzt.
2026-07-09 Steuerung: kein DOM-Rebuild pro Tick + optimistische Umschaltung
    Der Steuerungs-Tab baute bei jedem 1,5-s-Tick das ganze DOM neu auf
    (renderCtrl in tick) -> Flackern und verlorene Klicks, wirkte "extrem langsam".
    - renderCtrl zeichnet nur noch bei inhaltlicher Aenderung neu (Signatur ueber
    id/name/sup/val/act/ip; age bewusst ausgeklammert), beim Tab-Oeffnen erzwungen.
    - Toggle reagiert jetzt optimistisch sofort: Wunschwert als "pending" ueber die
    frisch geladenen Server-Settings gelegt, bis der echte settingsReport ihn
    bestaetigt (Override faellt weg) oder nach 6 s verfaellt (Kommando kam nicht an
    -> Anzeige springt zurueck). Kein Flackern, selbstheilend (Node-Logiktest ok).
    Co-Aut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
2026-07-10 Bilder-Tab: taegliche Sperrzeiten + Bild/Label loeschen
    - Taegliche Bilder-Sperrzeiten (z. B. Maeher 15-16 Uhr): in diesen
    Ortszeit-Fenstern verwirft /photo hochgeladene Bilder (Kamera laeuft
    weiter). Verwaltung im Bilder-Tab; DST-korrekt via zoneinfo/tzdata
    (LOCAL_TZ, Default Europe/Zurich). Endpunkte /photo_block GET/POST,
    gespeichert in meta.
    - Bild loeschen: /photo_del entfernt DB-Eintrag UND Datei; Loesch-Knopf
    auf jeder Kachel + in der Grossansicht.
    - Labels ueberall loeschbar: /alabels?all=1 liefert alle Labels
    zeitfensterunabhaengig; "alle"-Umschalter im Labels-Panel des
    Analyse-Tabs zum Finden/Loeschen jedes Labels.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
2026-07-10 Bilder-Tab: Sperrzeiten-Overlay-Fix + Mehrfach-Loeschen
    - Schwarzer Schirm beim "Sperrzeiten..."-Knopf behoben: die generische
    .tab-Verdrahtung (setView) ueberschrieb den Handler, weil der Button
    class="tab" ohne data-v hat -> Klick rief setView(undefined) und blendete
    alle Tabs aus. Jetzt schalten nur .tab[data-v] die Ansicht um.
    - Mehrfach-Loeschen: Auswahl-Kaestchen je Foto + "Auswahl loeschen (N)"/
    "Auswahl leeren" in der Leiste; /photo_del akzeptiert jetzt auch
    {"ids":[...]} und loescht DB-Eintraege + Dateien gebuendelt.
2026-07-10 Review-Fixes Nr. 1-9, 11-24 (F_corr)
    VPS/Frontend:
    - #1 /events-Protokoll auf absolute Indizes (Live-Karten froren ein,
    sobald der RAM-Puffer 20k Events trimmte)
    - #2 sector_polygon max. 16 Ecken + CSV-Export vereinfacht statt
    abgeschnitten (Lidar-360-Sektor wurde zum Halbkreis)
    - #4 learn_mower_polygon: Sensor-Standort als Faecher-Scheitel bei
    Teilkreis-Abdeckung (Nahfeld fehlte im gelernten Polygon)
    - #6 /photo/<id> vom no-cache-Header ausgenommen (Bilder-Tab lud alle
    Thumbnails alle 15 s neu)
    - #9 geklebte Tracks werden wieder mit Sturm-Fenstern bewertet
    - #15 Manuelle Pose: Richtungslinie zeigt Blickrichtung (+y) statt x-Achse
    - #16 anaAddLabel mit Fehlermeld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
2026-07-12 Sperrzeiten-Dialog: Zeilen auf schmalen Bildschirmen (iPhone) umbrechen lassen
    Die Zeit-/Notiz-Felder in einer Sperrzeiten-Zeile liefen ohne Umbruch und
    ohne min-width:0 auf dem Notiz-Feld nebeneinander weiter, als der
    Container breit war. Auf iPhone-Breite ragte die Zeile weit über den
    Dialog hinaus, sodass Notiz-Feld und Löschen-Knopf jeder weiteren
    Sperrzeit unerreichbar wurden.
2026-07-12 Sperrzeiten: Hintergrund-Poll ueberschreibt keine laufende Bearbeitung mehr
    setInterval fuer den Bilder-Tab rief alle 15s loadBlock() auf, das die
    globale blkWins-Liste bedingungslos vom Server neu setzte - auch waehrend
    der Sperrzeiten-Dialog offen war. Dauerte das Ausfuellen einer neuen Zeile
    laenger als 15s (z. B. am iPhone mit dem nativen Zeit-Wahlrad), wurde die
    gerade eingegebene Sperrzeit im Hintergrund unsichtbar verworfen, bevor
    "Speichern" sie ueberhaupt verschicken konnte.
2026-07-13 Bilder-Grossansicht: altes Foto nicht mehr kurz stehen lassen
    Das Grossbild-<img> wird pro Klick wiederverwendet (nur src wird
    geaendert); der Browser zeigt bis zum fertigen Laden/Dekodieren des
    neuen Fotos weiter das vorige an, waehrend die Beschriftung sofort
    synchron aktualisiert wird. Bei langsamer Verbindung (z. B. iPhone
    mobil) sieht man dadurch kurz Bild und Beschriftung aus zwei
    verschiedenen Fotos gleichzeitig - per Direktabgleich mit den auf dem
    VPS gespeicherten Originaldateien bestaetigt (Foto einer bestimmten ID
    war immer schon so, wie es aktuell abgelegt ist).
2026-07-16 CatCam: Wegwerf-Invoke vor Foto - Modul lieferte gepufferten alten Frame
    Das Vision-Modul gibt beim INVOKE den Frame der vorherigen Aufnahme
    zurueck. Bei ausgeschalteter Kamera-KI (stgCamAi) war das erste Foto
    nach laengerer Pause dadurch beliebig alt (beobachtet: 6h altes
    Nachtbild als erstes Morgenfoto). Jetzt schiebt ein schneller
    RESULT_ONLY-Invoke vorab einen frischen Frame in den Puffer.
2026-07-16 Abdeckungs-Overlay: eingestellte Radar-Totzone sichtbar machen
    Manager reicht deadZoneDist aus dem radarHbPayload (einzige 9-Byte-
    HB-Variante) als dz im hb-Relay an den VPS weiter. /acoverage liefert
    die Totzonen als Welt-Sektoren (dead_zones), die Analyse-Karte dunkelt
    den Bereich ab und umrandet ihn gestrichelt in der Sensorfarbe.
    Nur Darstellung: Coverage-Polygone fuer Modell/CatIdent unveraendert.
2026-07-16 Totzone per Geraetetyp erkennen + No-Shot-Karte in der Analyse-Karte
    1. Manager: radarHbPayload wird jetzt ueber den Geraetetyp aus der
    device-DB (type == HLK) erkannt statt ueber die Payload-Laenge -
    robust gegen kuenftige HB-Varianten gleicher Groesse. getPayload
    prueft nur noch die Groesse als Validierung.
    2. /noshot-Endpunkt: No-Shot-Karte (NOSHOT_DEFAULT-Seed im Manager-
    Quellcode, GitHub main wie xComDef, TTL 10 min, mehrere Ringe) als
    Welt-mm-Ringe; Analyse-Karte zeichnet Eckpunkte rot plus feine rote
    Kontur.
2026-07-16 MapConcept.md: F_corr-Merge-Hinweis korrigieren (bereits gemergt)
    F_corr (PR #12) wurde am 2026-07-12 in main gemergt (2ed384e) - der
    Hinweis im Abschnitt "Sicherheit / offene Punkte" war veraltet.
2026-07-16 MapConcept.md: Kartenänderung nur noch über VPS-Editor, Repo als Live-Abbild
    - Manuellen Upload-Weg (Weg A, HTTP-Endpunkt am Manager) entfernt: kein
    WebServer am Manager nötig, kein Upload-Skript
    - VPS-Editor wird einziger regulärer Weg; nach Annahme committet der VPS
    die Karte automatisch nach Map/<typ>.csv im Repo
    - Notweg ohne VPS: Repo-CSV von Hand anpassen + Firmware neu bauen/flashen
    statt eines zusätzlichen Netzwerk-Endpunkts
    - Leitplanken, Zielbild, Sicherheits-Abschnitt und Stufenplan entsprechend
    angepasst
2026-07-16 Karten-Konzept umsetzen: Manager-Firmware, VPS-Backend, Analyse-Editor, Sensoren, Repo-Aufräumung
    Setzt MapConcept.md (Stufen 1-5) vollständig um:
    - Manager: NOSHOT_DEFAULT/RASEN_DEFAULT-Seeds entfernt; neuer Annahme-Code
    (gwAcceptMap) validiert/versioniert/schreibt Karten atomar; gwFetchMap holt
    pending Karten vom VPS (cmdMapFetch über /commands), gwPushMap meldet den
    aktiven Kartenstand zurück (/mapsync); Announce per Multicast nach jeder
    Annahme; kein WebServer/Upload-Endpunkt am Manager nötig.
    - VPS (dashboard.py): GitHub-Regex-Fetch (NOSHOT_URL/MAP_URL) entfernt,
    Manager-Spiegel + /mapsync, /maps/<typ> (GET/POST), pending-Mechanik über
    die bestehende /commands-Queue,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
2026-07-17 Single Source of Truth für Karten: Controller/Manager6_3_0/data/ statt Map/
    Korrigiert eine Lücke aus dem vorigen Commit: die LittleFS-Partition des
    ESP32 ist von der Sketch-Partition komplett getrennt und wird ausschliesslich
    aus einem Manager-lokalen data/-Ordner gebaut (USB *und* OTA) - der war beim
    Aufräumen faelschlich mitgelöscht worden.
    - Controller/Manager6_3_0/data/noshot.csv + data/rasen.csv sind jetzt die
    Source of Truth im Repo: der VPS committet den vom Manager bestätigten
    Kartenstand automatisch hierhin (/mapsync in dashboard.py), der Notweg
    editiert exakt dieselbe Datei.
    - Map/noshot.csv + Map/rasen.csv nach Map/backup/ verschoben (reine
    Sicherheitskopie, wird zu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
2026-07-19 Ad-hoc-Analyse: Wirkung von Maeher-Ausschluss + NoShot-Filter auf Tracks
    analyze_noshot_filter.py (VPS/dashboard/): vergleicht rohe catObserved-
    Events gegen eine gefilterte Variante (Maeher-Zeitfenster ausgeschlossen,
    nur Punkte innerhalb der NoShot-Karte) und wertet beide mit dem
    bestehenden Erkennungsmodell (catmodel.py) aus - Anteil Punkte in
    kohaerent bewegten bzw. bestaetigten Tracks.
    Kein produktiver Code-Pfad, nicht in dashboard.py verdrahtet - eigenstaendig
    per Kommandozeile gegen die echte SQLite-DB oder mit --demo (synthetischer
    Selbsttest) laufen lassen.
2026-07-19 analyze_noshot_filter.py: Europe/Zurich statt naiver UTC-Interpretation
    --t0/--t1/--mower-t0/--mower-t1 wurden bisher mit datetime.strptime(...).
    timestamp() geparst - ohne Zeitzoneninfo nimmt Python die lokale Zeit der
    ausfuehrenden Maschine an. In einer UTC-Sandbox fuehrte das zu einem
    2h-Versatz (Sommerzeit) gegenueber der tatsaechlichen Schweizer Maeherzeit.
    Jetzt: neuer --tz-Parameter (Default Europe/Zurich, wie LOCAL_TZ in
    dashboard.py), parse_dt() lokalisiert explizit ueber zoneinfo; neues
    --day-Kuerzel fuer einen ganzen Kalendertag in der gewaehlten Zeitzone.
2026-07-19 NoShot-Filterstrategie: CatIdentifier intern filtern, Radar umschaltbar
    CatIdentifier verwirft catObserved ausserhalb der NoShot-Karte, bevor sie
    ins Erkennungsmodell gefuettert werden (serviceNoShotMap wie bei LidarC1).
    Radar meldet standardmaessig NoShot-gefiltert statt voller RasenKarte
    (stgRadarFullRasen, Bit 7, nicht persistiert - Default nach Reboot bleibt
    der ruhige Modus); haelt dafuer zwei unabhaengige Karten-Slots und erzwingt
    nach jedem Refresh erneut die laut Einstellung aktive Karte im gemeinsamen
    RAM-Puffer. VPS-Steuerung-Tab und Touch-Display zeigen den neuen Umschalter
    generisch mit. Hintergrund: Analyse echter Daten
    (VPS/dashboard/analyze_noshot_filter.py) zeigte, dass NoSho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
2026-07-19 CatIdentifier: NoShot-Zeit (Maeher-Ruhefenster) als Modell-Parameter
    Im lokalen Tagesfenster quiet_t0_min..quiet_t1_min (Default 15:00-16:30,
    gleiche Werte = aus, t0>t1 laeuft ueber Mitternacht) wird das Modell nicht
    gefuettert und announceCat zusaetzlich hart gesperrt - Maeher- und
    Katzen-Tracks sind sich zu aehnlich, und ein Fehlschuss auf den Maeher
    waere teuer (Regensensor -> Arbeitsstopp), eine im Fenster verpasste
    Katze nicht. Konfiguration ohne Neuflash ueber die bestehenden
    VPS-Modellparameter (/aparams.csv, Analyse-Tab "Parameter..." + Aktion
    "Parameter laden"). Uhr nie gestellt (NTP-Ausfall seit Boot) -> fail-open,
    sonst waere das Geraet dauerhaft blind. Die retrospektive VPS-Analy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
2026-07-19 Abschluss-Review des Branches: zwei Funde behoben, Doku ergaenzt
    (1) struct MapSlot aus Radar6_3_0.ino nach hwDef.h verschoben: der
    Arduino-Builder setzt Auto-Prototypen (serviceMapSlot nimmt MapSlot&)
    VOR den Sketch-Code - ein im .ino definierter Struct waere dort unbekannt
    gewesen (Compile-Fehler, gleiche Falle wie einst beim Cat Identifier /
    catTrackDef.h). (2) POST /mapsync validiert den Body jetzt mit
    _map_plausible(), exakt der Annahmeregel des Managers (loadNoShot)
    nachgebildet - vorher wanderten beliebige unplausible Bodies ungeprueft
    in den Karten-Spiegel und den Repo-Commit. Bewusst nicht strenger als
    der Manager, sonst koennte der /ingest-Abgleich endlos cmdMapPush
    anstossen. Kart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
2026-07-20 Analyse-Zeitleiste: Sensor-Spuren mit HB-Empfangsquote (WLAN-Diagnose)
    Der Manager reicht jeden empfangenen Heartbeat schon heute per /ingest
    weiter - der VPS zaehlt sie jetzt je Minute+Sender in der neuen Tabelle
    hb_minute (rein additiv: bestehende Tabellen und Daten bleiben
    unberuehrt, Minuten vor der Einfuehrung zeigen "keine Daten"). Der neue
    Endpunkt /hbstats liefert daraus die Empfangsquote 0..1 je Zeit-Bin und
    Sensor (erwartete HBs je Typ: HLK 5s, Lidar/Kamera 10s); die Erwartung
    bezieht sich je Bin nur auf tatsaechlich abgedeckte Minuten, damit grobe
    Zoomstufen die Quote an Aufzeichnungsraendern nicht verwaessern. Die
    Zeitleiste im Analyse-Tab zeigt unter der Dichte je Sensor ein Far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
2026-07-20 Analyse-Tab: Tracks direkt auf der Karte anklickbar
    Ein Klick auf die Karte waehlt die naechstgelegene Track-Linie im
    Klickradius (9 px) aus - gleiche Wirkung wie der Klick in der Trackliste,
    nur ohne Recentern; die Liste scrollt zum gewaehlten Track, dort laesst
    sich die Bewertung wie gewohnt setzen. Nochmal klicken oder Klick ins
    Leere waehlt ab. Pan/Zoom und der NoShot-Editor bleiben unberuehrt (der
    Hit-Test laeuft nur bei einem echten Klick ohne Bewegung und nur
    ausserhalb des Edit-Modus). Per Playwright durchgeklickt: Auswahl,
    Toggle, Klick ins Leere, Pan-ohne-Auswahl.
    Claude-Session: https://claude.ai/code/session_01MzBjeMY17c3v5M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
2026-07-22 VPS erkennt Katze identisch zum CatIdentifier (kausales Modell)
    score_track bewertet den Track nicht mehr retrospektiv als Ganzes, sondern
    spielt ihn Punkt fuer Punkt kausal durch und bestaetigt in genau dem Moment,
    in dem der laufende Score confirm_score erreicht (t_confirm) - 1:1 wie
    ctEvaluate/ctFeed auf dem Geraet (catTrack.ino). Damit entfallen die
    Merkmale, die den fertigen Track voraussetzen und die es auf dem ESP32 nie
    gab: score_exit, penalty_mid_death und penalty_jumpy sind aus dem Modell
    entfernt. Der Analyse-Tab zeigt jetzt exakt, was der CatIdentifier im Feld
    entscheiden wuerde - Grundlage zum gemeinsamen Justieren des Modells.
    Die Ruhefenster-Sperre (quiet_t0/t1) bleibt bewuss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
2026-07-22 Karten-Rueckcommit: 409-Conflict abfangen und erneut versuchen
    Beim VPS-Neustart schickt der Manager beide Karten quasi gleichzeitig, worauf
    mehrere _github_commit_map-Threads dieselbe (neue) Datei anlegen wollen - der
    erste gewinnt, die uebrigen bekamen von der GitHub Contents API HTTP 409 und
    brachen ohne Wiederholung ab, sodass die Source of Truth stehenblieb. Jetzt bis
    zu 3 Versuche mit frisch geholtem sha; damit bleibt "Repo ist immer Abbild"
    auch unter Nebenlaeufigkeit erfuellt.
2026-07-22 Karten-Rueckcommit: Same-Path-Commits serialisieren (Lock je Pfad)
    Der 409-Retry allein reichte bei >=3 gleichzeitigen Threads auf denselben Pfad
    nicht (rasen blieb beim Neustart-Flush stehen). Ein Lock je Repo-Pfad laesst
    gleiche-Pfad-Commits nacheinander laufen (jeder mit frischem sha) -> keine
    Same-Path-Races mehr; der Retry bleibt als Netz fuer Rest-Races.
2026-07-22 Karten-Rueckcommit: ALLE Commits global serialisieren (Branch-HEAD-Race)
    Der 409 war kein Same-Path-, sondern ein Branch-Race: die Contents API baut
    jeden Commit auf den aktuellen HEAD, also kollidieren auch gleichzeitige
    Commits auf VERSCHIEDENE Dateien (zweiter forkt vom selben Parent -> 409).
    Ein einziges globales Lock statt Lock-je-Pfad committet nacheinander; der
    Retry bleibt als Netz. Behebt den 409-Sturm beim Neustart-Flush.
2026-07-23 Karten-Editor: Rueckweg in den Normalmodus
    "Speichern" liess den Editor offen; der einzige Ausgang hiess "Verwerfen" und
    sah so aus, als wuerfe er die eben gespeicherte Karte weg - man blieb im
    Edit-Modus haengen (Tracks nicht anklickbar, Doppelklick ohne Einpassen).
    - Speichern schliesst den Editor jetzt und laesst nur die Statuszeile
    ("wartet auf Manager" -> "uebernommen als vN") weiterlaufen.
    - Bis der Manager die Karte uebernommen hat, werden die gespeicherten Ringe
    angezeigt; /noshot|/rasenmap liefert waehrend pending noch die alte Version.
    - "Verwerfen" heisst jetzt "Bearbeiten beenden", Esc tut dasselbe; bei
    ungespeicherten Aenderungen kommt eine Rueckfrage (ANA.editDirty).
    - L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
2026-07-23 Karten-Verteilung: Announce-Sturm ueberlebt, Fehlversuch faellt auf
    Nach jeder angenommenen Kartenaenderung annonciert der Manager die neue Version
    und ALLE Sensoren fragen im selben Moment an. Im Feld ("Karte 1: kein mapInfo
    von .180 -> lokale Karte", 3 von 4 Geraeten) hatte das zwei Ursachen:
    1) Manager: eingehende mapRequests landeten im EINEN lastUcMsg-Puffer und
    ueberschrieben sich, bevor loop() sie las -> nur eines wurde bedient.
    Jetzt eigene Ringqueue (MAP_REQ_QUEUE_LEN, nur der Manager definiert sie -
    Sensoren brauchen lastUcMsg unveraendert fuer waitForUc/acquireMap), die
    loop() der Reihe nach abarbeitet; Ueberlauf meldet sich im VPS-Debug.
    2) Geraete: acquireMap liefe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
2026-07-26 Fernwartung: Remote-Reset (cmdReboot) + Aktiv/Ruhemodus (stgActive) fuer alle Geraete
    Neues Setting-Bit stgActive (8): Sensor-Ruhemodus. AUS = das Geraet meldet nur
    noch seinen HB, unterdrueckt ALLE Detektions-/Foto-/catDetected-Meldungen und
    schaltet die Sensor-Hardware ab, wo moeglich (Lidar-Motor stop, Kamera-KI aus,
    Radar wertet keine Ziele mehr aus). Default AN, NICHT persistiert -> nach Reboot
    wieder aktiv. Nur Sensoren (Radar/LidarC1/LD06/CatIdent/CatCam); generischer
    Helfer deviceActive() in xComProc (Aktoren/Manager gelten immer als aktiv).
    Neues Kommando cmdReboot (30): sofortiger ESP.restart(). Generisch in
    handleCommonMsg (Radar/Lidar/CatIdent/CatCam/Manager) sowie im Command-Sw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
2026-07-26 CatCam: Remote-Reset sperren (Vision-Modul haengt nach Soft-Reset) + I2C-Recovery
    Ein Soft-Reset (ESP.restart / cmdReboot) kappt die Stromversorgung des per I2C
    angebundenen Grove/Vision-Moduls NICHT. Wird der C3 mitten in einer I2C-
    Transaktion zurueckgesetzt, bleibt das Modul haengen und AI.begin() schlaegt bis
    zum physischen Power-Cycle dauerhaft fehl (Symptom: "Vision-Modul nicht
    erreichbar", Fotos gehen nicht). Software kann das Modul nicht power-cyceln.
    - CatCam ignoriert cmdReboot (in handleCommand vor handleCommonMsg abgefangen)
    -> Remote-Reset kann die Kamera nicht mehr lahmlegen. Meldung im Debug.
    - VPS-Steuertab + Display blenden den Neustart-Knopf fuer die CatCam (#19) aus.
    -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
2026-07-26 CatCam: I2C-Bus-Recovery wieder entfernt (half nicht)
    Die in ea9595b eingefuehrte I2C-Bus-Recovery loeste das nach Soft-Reset haengende
    Vision-Modul nicht (auch nach vollem Power-Cycle blieb es unerreichbar) und war als
    moeglicher Stoerer nicht auszuschliessen -> zurueck auf die bewaehrte aiInit
    (reines AI.begin(&Wire) + periodischer Retry). Die Remote-Reset-Sperre fuer die
    CatCam bleibt bestehen. Der I2C-/Vision-Init-Code ist damit wieder identisch zum
    funktionierenden Vorstand (26c659f) - verbleibende Ursache: Hardware/Verbindung.
2026-07-26 Konzept: KI-Vision-Katzenlokalisierung auf Raspberry Pi (KIVisionCatLocator)
    Neue Aufgabe im GesamtKonzept: kamerabasiertes Busgerät auf Pi 4 (OV5647 +
    schaltbarer IR-CUT + 850nm-IR + Coral Edge TPU), das den Rasen dauerhaft
    ueberwacht, Katzen per KI erkennt, sie ueber eine Boden-Homographie im
    Rasen-Weltkoordinatensystem lokalisiert und als vollwertiges Mitglied des
    CatFinder-Busses (Python-xCom, ID 20, Typ VisionLocator) catObserved
    (worldValid) meldet. Festlegungen: Pi OS Bullseye-Legacy 64-bit (glatter
    Coral-Stack), Variante A (Pi sendet catObserved, CatIdent bleibt einziger
    catDetected-Bestaetiger), assistierte Homographie-Kalibrierung ueber
    RasenKarten-Punkte, COCO-Startmodell mit spa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
2026-07-27 VPS: Weboberflaeche hinter URL-Praefix /Tristan, Wurzelpfad 404
    Die Oberflaeche und alle 39 Browser-Endpunkte liegen jetzt unter UI_PREFIX
    (Default /Tristan, per docker-compose.yml aenderbar). Alles andere am
    Wurzelpfad wird mit 404 beantwortet - insbesondere /command, das bisher
    ungeprueft beliebige Kommandos an PowerActor/LaserMarker weitergab.
    Bewusst nur Verschleierung gegen Scanner, KEINE Authentifizierung: wer den
    Pfad kennt, hat weiterhin vollen Zugriff, und ueber reines HTTP steht er im
    Klartext in jedem Request. "Review-Punkt 10" aus MapConcept.md bleibt offen.
    Die sieben Endpunkte der Firmware bleiben zwingend am Wurzelpfad, weil die
    Geraete ihre Pfade fest einkompiliert haben (D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
2026-07-27 VPS: URL-Praefix nicht mehr in der Doku ausschreiben
    Die README nannte den Pfad an fuenf Stellen im Klartext - in einem
    oeffentlichen Repo faellt das schon beim Ueberfliegen ins Auge und macht die
    Verschleierung wertlos. Doku schreibt jetzt durchgaengig /*****/, ebenso der
    Kommentar in analysis.py und dashboard.py.
    Der tatsaechliche Wert steht nur noch an EINER Stelle, als Default von
    UI_PREFIX in der docker-compose.yml. Bewusst dort und nicht ausschliesslich
    in einer .env: sonst liefe ein frischer Deploy bei einem anderen Anbieter
    (git clone + docker compose up) still OHNE Praefix, also mit offener
    Oberflaeche - das widerspraeche dem Zweck der Docker-Portabilitaet. Wer den
    Pfad privat halt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
2026-08-18 KIVisionCatLocator Phase 1: Pi eingerichtet, OS-Festlegung auf Bookworm korrigiert
    Bullseye ist im Imager nicht mehr verfuegbar (Legacy = Bookworm seit der
    Trixie-Umstellung). Der Coral laeuft auf Python 3.11, wenn libedgetpu,
    tflite_runtime und pycoral gegen dieselbe TF-Version gebaut sind
    (16.0tf2.17.1 / 2.17.1 / 2.0.3, Community-Builds) und numpy<2 gepinnt ist.
    Googles libedgetpu 16.0 + tflite-runtime 2.14 segfaultet - verifiziert.
2026-08-27 KIVisionCatLocator Phase 2: Kamera-Webserver auf dem Pi
    Weboberflaeche unter http://192.168.0.186:8080/, damit der Montageort der
    Kamera gesucht werden kann: MJPEG-Livebild, Anzeige-Drehung (der ISP kann kein
    90-Grad, fuer die Ortssuche reicht CSS), Spiegeln, Raster, Aufloesung/Bildrate/
    Qualitaet, Belichtungs- und Farbregler, Schnappschuss in Stream-Aufloesung oder
    voll 5 MP mit Galerie.
    Dazu ein zuschaltbarer Coral-Test mit den Kachel-Ausschnitten aus dem Konzept
    (1 bis 3x2, 15% Ueberlappung): so zeigt sich schon beim Suchen des Standorts,
    ob die KI von dort ueberhaupt erkennt. Gemessen 110 ms je Durchlauf ueber das
    ganze Bild, 143 ms mit zwei Kacheln, 10 fps bei 1280x960, CPU 40 Grad.
    A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
2026-08-27 KIVisionCatLocator: Livebild-Verzoegerung behoben (WLAN-Rueckstau)
    Gemessen: das 2,4-GHz-WLAN des Pi traegt real nur 2-3 Mbit/s, waehrend
    1280x960/85/10fps 14,9 Mbit/s erzeugt. Die Bilder stauten sich im
    TCP-Sendepuffer (Autotuning bis ~2,5 MB = ueber ein Dutzend Bilder), das
    Livebild lief rund 2 s nach und war nach einem Neustart nur kurz besser.
    - Sendepuffer auf 96 kB begrenzt (SO_SNDBUF auf dem Listener, wird vererbt):
    das Schreiben blockiert frueh, der Stream ueberspringt Bilder statt sie zu
    stapeln - der Rueckstand ist damit gedeckelt.
    - StreamingOutput.wait bekommt die zuletzt gesendete Bildnummer: liegt schon
    ein neueres Bild bereit, geht es sofort raus.
    - Encoder laeuft nur n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
2026-08-29 KIVisionCatLocator: Rahmen, Farbstich und Verzoegerung nachgemessen
    Rahmen sass neben dem Objekt: get_objects rechnet intern
    sx = Eingangsbreite / image_scale_x, der uebergebene Massstab
    (Kachel/Tensor) war also gerade verkehrt herum und quetschte jeden
    Rahmen in eine Bildecke. Jetzt image_scale (1,1) und selbst auf die
    Kachel hochgerechnet; Rahmen aufs Bild geklemmt, Beschriftung als
    Schild, das am Bildrand nach innen klappt statt aus dem Bild zu laufen.
    Am laufenden Aufbau geprueft: "bed" liegt auf der Matratze.
    Farbstich als fehlender IR-Sperrfilter nachgewiesen (Kanalmittel
    derselben Szene): Standard-Tuning R/G 1,94 -- NoIR-Tuning R/G 1,01.
    Entscheidend ist die rote Verstaerkung unter 1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
2026-08-29 KIVisionCatLocator: Livebild fuer schwache Clients (Handy) entstaut
    Sendepuffer von 96 auf 24 kB Wunsch verkleinert (Kernel verdoppelt auf
    48 kB) und Nagle abgeschaltet. Was im Sendepuffer liegt, ist beim
    Ankommen schon alt; er muss nur Bandbreite x Laufzeit fuellen (hier
    rund 15 kB), nicht ganze Bilder stapeln. Bleibt er unter einer
    Bildgroesse, blockiert das Schreiben frueh und der Client bekommt das
    neueste Bild statt eines alten aus der Schlange. Nagle hielt zusaetzlich
    das letzte Teilstueck jedes Bildes zurueck, bis die vorige Sendung
    bestaetigt war -- mit verzoegerter Bestaetigung bis zu 40 ms je Bild.
    Gemessen mit klein gesetztem Empfangsfenster (SO_RCVBUF 8 kB), das den
    Server per T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
2026-09-28 KIVisionCatLocator: Kamera haelt ihre Treffer selbst fest
    Zum Justieren am Montageort laesst sich keine Katze ins Bild halten. Die
    Kamera legt deshalb bei jeder Erkennung selbst ein Bild in ~/kivision/hits/
    ab - mit eingezeichnetem Rahmen, Klasse und Sicherheit, dazu eine Fusszeile
    aus Uhrzeit, Lux, Belichtungszeit und Gain, an der man hinterher die Tag-
    von der Infrarot-Lage unterscheidet (das montierte Modul schaltet seinen
    IR-Sperrfilter selbst).
    Zwei Bremsen gegen das Ueberlaufen: Mindestabstand (10-300 s, voreingestellt
    60 s), gezaehlt ab der letzten Aufnahme statt ab dem letzten Treffer, und
    ein Deckel von 60 Bildern - bei einer Minute Abstand eine Stunde Rueckschau.
    Das Festhalten h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
2026-09-29 KIVisionCatLocator Phase 3: Pi als Busgeraet #20 (Python-xCom)
    - xComDef6_3.h: KIVision (ID 20, Typ VisionLocator, .186), deviceCount 21
    - xcom.py: Protokoll direkt aus xComDef6_3.h geparst (Konstanten + packed Structs)
    - kivision_bus.py: HB 10 s, settingsReport (stgCamAi/stgActive), poseReport
    (noch ungueltig), cmdSetSetting, cmdReboot (Prozess-Neustart), Debug-Text
    - Weboberflaeche zeigt Busstatus, KI/Ruhemodus vom VPS schaltbar
    - VPS: Fallback-Tabelle + HB-Spur fuer VisionLocator
2026-09-29 KIVision-Weboberflaeche: JS-Syntaxfehler in der Bus-Anzeige behoben (Seite blieb ohne Bild/Daten)
2026-09-30 KIVision: Katzenerkennung nachgeschaerft (4x3-Kacheln, bildfuellende Rahmen verwerfen, Treffer-Filter Tiere)
    Mit Ausschnitt 1 war eine Katze auf dem 300x300-Tensor nur 10-15 px gross -
    keine echte Katze erkannt, dafuer zwei bildfuellende cat-Fehlalarme.
2026-10-02 KIVision: Radar-Bilder - Kamera fotografiert auf Zuruf vom Bus (catObserved/catDetected)
    Die Treffer-Bilder zeigen nur, was das Modell gefunden hat. Am 2026-10-02
    ergaben die Radar-Tracks 353280 und 353283 (Katze) kein Bild - ob die Katze
    ueberhaupt im Bild war, liess sich nicht klaeren. Jetzt legt jede Radar-
    Episode bis zu 4 Bilder mit allen Modell-Rahmen ab 20 % ab.
2026-10-02 VPS: Analyse-Abfragen blockieren /ingest nicht mehr (Lese-Verbindung, /rec-Cache, /photos-Index)
    Am 2026-10-02 lief der Dashboard ans waitress-Verbindungslimit: alle DB-
    Zugriffe liefen unter einem Schloss, die Analyse ueber die ganze Aufnahme
    hielt es ~35 s (amodel 17 s, density 8,6 s, adata 5 s, hbstats 3,5 s) - so
    lange stand auch /ingest. Dazu stapelte der Analyse-Tab im Folgen-Modus alle
    5 s einen neuen Ladevorgang auf den noch laufenden.
    - Schwere SELECTs ueber eine eigene Lese-Verbindung je Thread (WAL)
    - /rec: COUNT(*) gecacht (60 s), MIN/MAX getrennt -> 1 s auf 3 ms
    - /photos: Track-Suche auf t0 >= t-2-maxdur begrenzt -> 3 s auf 0,03 s
    - Browser: Analyse-Laden und 1,5-s-Takt laufen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
2026-10-04 KIVision: Bewegungserkennung + gezielte KI-Ausschnitte statt nur Kachelraster
    Modelltest an den Radar-Bildern vom 2026-10-04: kein COCO-/ImageNet-Modell
    erkennt die ferne Katze (~25x45 px), Gegenproben bekommen dieselben Werte.
    Darum MOG2-Bewegungserkennung auf dem lores-Strom (820x616), Spurverfolger,
    Coral-Ausschnitte um bewegte Spuren, Bewegungs-Bilder-Galerie und
    pairs.jsonl (Radar-Welt <-> Kamera-Fusspunkt) als Rohstoff fuer Phase 4.
2026-10-04 KIVision: Katze und Fuchs - ImageNet-Zweitmeinung fuer grosse bewegte Ziele
    COCO kennt keinen Fuchs. Inception-v4 (4 Fuchs-, 5 Katzenklassen) laeuft
    nur fuer bewegte Spuren ab 100 px, max. 1 je Runde, je Spur alle 1,5 s
    (~180 ms); Filter/Treffer/gruene Rahmen gelten fuer cat und fox.
2026-10-08 KIVision: Galerien zeigen Vorschaubilder statt voller Bilder
    Treffer-, Radar-, Bewegungs- und Schnappschuss-Galerie luden jedes Bild in
    voller Groesse (1640 px, 250-480 kB) - bei 150 Bildern ueber 50 MB im WLAN.
    Jetzt je Ordner .thumbs/ mit 360-px-Vorschau (~8-20 kB), beim Speichern
    miterzeugt bzw. beim ersten Abruf nachgeliefert (JPEG-draft); Loeschen und
    Ausduennen nehmen die Vorschau mit. Bilder duerfen im Browser-Cache bleiben
    (Namen sind eindeutig), statt no-store bei jedem Galerie-Neuaufbau.
2026-10-11 KIVision: Webseite haengt nicht mehr an vergessenen Tabs und gestauten Abfragen
    - Abfragen (/api/state, /api/detections) nie doppelt unterwegs, sonst stapeln
    sie sich bei langsamer Funkstrecke im Browser (6-Verbindungen-Grenze)
    - unsichtbarer Tab / gesperrtes Handy: Livebild abhaengen, nicht abfragen
    - abgerissenes Livebild holt sich nach 3 s selbst wieder
    - Server: Socket-Zeitlimit 20 s, verschwundene Clients haengen nicht ~15 min
    - Livebild laesst nach jedem Bild kurz Luft fuer andere Anfragen
2026-10-11 Dome-C1: neues Radar #21 mit BMP180 (envReport) und IR-Scheinwerfer-Schalter
    - xComDef6_3.h: DomeC1 (ID 21, HLK, DHCP, OTA-Name Dome-C1), deviceCount 22,
    msgCodes envRequest(14)/envReport(15) + envPayload, Settings stgIrLight(9)/
    stgIrAuto(10) = Schalter AUS/EIN/AUTO, STG_COUNT 11
    - Radar6_3_0: Variante DomeC1Device (wie CompactDome, Radar GPIO19, Pixel 27),
    nicht blockierender BMP180-Treiber (bmp180.h, SDA21/SCL22), envReport jede
    Minute + auf Anfrage; GPIO18 Open-Drain parallel zum LDR: AUTO gibt den
    Scheinwerfer 60 s nach jeder catObserved frei; Announce-Slot je Variante
    (MAP_SLOT) statt ID%10 (21 kollidierte mit Dome)
    - Manager: envReport -> VPS (Feld env), target 253 = Broad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
2026-10-17 Situations-Dokumentation: erste Katze beim Koten erwischt (Track 384530)
    Bilder vom 2026-10-16 21:18-21:19 plus Screenshot der Track-Ansicht;
    ausserdem Fuchs- und normale Katzenbewegungs-Screenshots als Referenz.
2026-10-17 KIVision Phase 4: Boden-Homographie automatisch aus Radar-Kamera-Paaren
    RANSAC-Homographie aus pairs.jsonl (nur Radare + CatIdent, Lidar raus),
    Median-Fehler ~200 mm, Gegenprobe ueber die Zeit gleich gut. Knopf
    "Homographie berechnen" in der Kamera-Weboberflaeche, Rasenrand,
    Schussverbot-Zone und 1-m-Gitter als Einblendung ins Livebild, bewegte
    Spuren mit Rasenposition. Linsenverzeichnung und gueltiger poseReport
    bewusst noch offen.
2026-10-17 KIVision Phase 4: Kamera-Modell per Klick-Kalibrierung
    Die Radar-Homographie trifft das Radar-Koordinatensystem, nicht die
    vermessene Rasenkarte (~0,5-1 m daneben). Neues Lochkamera-Modell mit
    gemessenem Standort (8,05/-0,6 m, 2,25 m) und Brennweite aus dem 2,1-mm-
    Objektiv; Blickrichtung und Verzeichnung aus geklickten Referenzen
    (Lidar/Radare) und Nulllinie-Punkten. Hat Vorrang vor der Homographie,
    zeigt zusaetzlich den Versatz jedes Sensors gegenueber der Kamera.
2026-10-17 KIVision Kamera-Modell: Standort mitrechnen, Verzeichnung erst bei vielen Punkten
    Mit den ersten echten Klicks verbog die freie Verzeichnung (k1 = +0,93) die
    Karte; mit fest gemessenem Standort passten die Klicks nicht zusammen.
    Standort x/y jetzt ab 7 Gleichungen frei (leicht zur Messung gezogen),
    Verzeichnung erst ab 12/16 Gleichungen. Ergebnis: alle Klicks auf ~5 cm,
    Kamera bei 6,87/-0,18 m. Oberflaeche zeigt den gerechneten Standort.
2026-10-17 KIVision Kamera-Modell: Standort fest (nachgemessen), Brennweite und k1 frei
    Mit dem nachgemessenen Standort 8,05/-0,6/2,25 m verlangen die Klicks eine
    wirksame Brennweite von ~3,1 mm (1410 px) mit Tonnenverzeichnung k1 -0,31
    statt der aufgedruckten 2,1 mm. Klickfehler 10-14 cm, Nulllinie 1-5 cm;
    Rasenrand an der Hecke und Maeherspuren liegen im Bild richtig.
    Der alte Weg (Standort statt Brennweite) bleibt per "free_cam" erreichbar.
2026-10-18 KIVision Kamera-Modell: Rasenkante als Referenz, Schlusslinie vorne weg
    Der Fit kannte nur drei Fusspunkte (hinten/rechts) und die Nulllinie; die
    linke Bildhaelfte war kaum bestimmt, die Rasenkarte lag links ~0,5 m im Beet.
    Neu: Klicks auf die sichtbare Rasenkante (Beet/Hecke) muessen auf dem Rand der
    Rasenkarte landen. Die unvermessene Schlusslinie vorne (y 0,6..1,2 m) wird
    nicht mehr gezeichnet, die echte Kante ist die Nulllinie. Startsuche grob,
    nur die besten drei Starts voll (Pi: 5 min -> Sekunden).
2026-10-18 Konzept: Tag/Nacht-Automatik aus Phase 5 gestrichen (macht die Kamera selbst)
2026-10-18 Konzept Phase 5: Kamera als Beweismittel und Zusatzsensor (A-D)
2026-10-18 Phase 5A: KIVision-Radarbilder auf den VPS, Fotos beim Track im Analyse-Tab
    Pi: jedes Radar-Bild geht zusaetzlich per POST /photo an den VPS (sender 20):
    Uebersicht 1024 px und, wenn die Rasenposition bekannt ist, ein Ausschnitt
    um das Ziel aus dem vollen 5-MP-Bild (Kamera-Modell world->image). Eigener
    Upload-Thread mit begrenzter Warteschlange, Aufnahmezeit wird mitgeschickt.
    VPS: /photo nimmt optional t (Aufnahmezeit). Analyse-Tab: Tracks mit Bildern
    tragen 📷n, der aufgeklappte Track zeigt sie ueber den Bewertungs-Kaestchen
    (Zeitfenster +-3 s, mit Rasenposition nur wenn der Track in 3 m Naehe war).
2026-10-18 Phase 5B: Kamera-Spuren als visionObserved, Modell-Schalter cam_feed
    KIVision sendet bewegte Spuren auf dem Rasen (Fusspunkt ueber das Kamera-
    Modell in Welt-mm, je Spur max. 1/s, Breite am Boden in res) als neuen
    Nachrichtentyp visionObserved (16) - bewusst nicht catObserved, weil die
    PowerActors auf jedes catObserved ohne Absender-Filter feuern.
    Manager reicht visionObserved an den VPS weiter (ohne Blinken). CatIdent und
    VPS-Modell nehmen Kamera-Spuren nur mit dem neuen Parameter cam_feed=1;
    Standard 0 = erst aufzeichnen und pruefen, dann zuschalten.
2026-10-18 Phase 5C: leuchtende Augen nachts (kivision_eyes.py)
    Nachts auf dem vollen Bild im Rasen: Top-Hat + Kontrastverhaeltnis, Maeher-
    Scheinwerfer ausgeblendet, ortsfeste Lichter ueber eine vergessende
    Waermekarte, Auge ab 3 Treffern, Partnerpunkt als Paar. Ausgabe: Galerie
    'Leuchtende Augen' (+ Rohbilder zum Nachjustieren), Kreise im Livebild,
    visionObserved sensor=1 (Rasenposition auf Augenhoehe 25 cm, Kamera-Modell
    kann jetzt z), Bild an den VPS (kiveye/kiveyecrop). Schalter eyes/eyes_force.
2026-10-18 KIVision: Bewegung/Augen nur innerhalb Rasen- oder Noshot-Karte (umschaltbar)
    Zone wird ins Bild projiziert; Flecken mit Fusspunkt ausserhalb werden
    nicht zu Spuren (keine Bewegungs-Bilder, Coral-Ausschnitte, visionObserved).
    Augensuche maskiert mit derselben Zone. Auswahl in der Weboberflaeche.
2026-10-18 VPS: eigener Coverage-Tab - lernen, Ecken von Hand verschieben, loeschen
    Neuer Endpunkt /coverage_set speichert von Hand verschobene Eckpunkte
    (posegebunden wie das Lernen). /coverage_profiles liefert zusaetzlich die
    aktuell wirksamen Polygone. Lernen/Loeschen wandern aus der Analyse-Leiste
    in den neuen Tab; nach jeder Aenderung laedt der CatIdentifier neu (cmd 22).
2026-10-19 Phase 5C: Augensuche als Paarsuche (zwei Flecken waagrecht nebeneinander)
    Erste Fassung verwarf nachts 98 % der Bilder als verrauscht (>40 Einzelpunkte
    bei Regen/IR-Licht) und brauchte 2,2 s je Bild - 0 von 5 Katzen erkannt.
    Neu: Gauss gegen Pixelrauschen, Flecken als oertliche Helligkeitsspitzen,
    Groesse auf halber Hoehe, Auge = Paar waagrecht (Abstand passend zur
    Fleckgroesse, aehnlich hell/gross, dunkle Luecke); Einzelauge haelt nur eine
    bestehende Spur. Offline an den Tracks 81603/81605/81607/81624/81628
    geprueft: alle gefunden, keine Fehlpaare in Nachtbildern ohne Katze.
    Dazu: Hintergrund-Threads erst am Dateiende starten (_vision_run starb
    beim Start mit NameError _geo). Statuszeile z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
2026-10-20 Augensuche nur bei IR-Nacht; Track-Kaestchen Insekt heisst jetzt Fuchs
    Augen liefen bei Tag/Daemmerung (Lux/Gain meldeten Nacht, z.B. 07:56 im
    Nebel, 18:26-18:43). Zusaetzlich muss jetzt der ferne Rasen oben im Bild
    deutlich dunkler sein als die Mitte (nur IR-Licht der Kamera), Schwelle
    0,45 (gemessen Tag 1,5, Daemmerung 0,6-1,0, Nacht 0,23-0,35).
    Kaestchen-Wert insect bleibt in der DB, Anzeige 🦊 Fuchs.
2026-10-20 MapDiscovery: Programme zur Gartenvermessung (PanTiltHead_WM, PanTiltKarte_WM) ins Repo
    Aus Arduino/Tab5 uebernommen (nur WM-Fassung mit LaserMarker), dazu
    TurnBaseConfig.h, Schema.pdf und README aus PROJECT.md.
2026-10-20 PowerActor2 Umbau Schritt 1: Step1_ServoSweep (ST3020 ueber 1k-Widerstand, OTA, Telnet)
    Servobus-Adapter durch Widerstand ersetzt: TX GPIO19 ueber 1 kOhm, RX GPIO18
    direkt. Lib FeetechBusServos wie PanTiltHead_WM. Sucht Servo, pendelt
    1200<->2900, Diagnose (Echo-Test, Baudraten, IDs), Ausgabe Serial + Telnet 23,
    feste IP .181 + ArduinoOTA. Verifiziert: Servo ID 1 faehrt, Ist folgt Soll.
2026-10-20 PowerActor2 Step1: Hostname PowerActor2 statt PowerActor1
2026-10-20 PowerActor2 Umbau Schritt 2: Servo-Position + 4 Relais per CYD28-Drehknopf
    Step2_RelayServo (PA2, OTA .181): UDP 4310, Servo 760..3400, Relais
    GPIO27/25/26/23 (alte valve/laserPwr/LD06Pwr/hlkPwr), Start alle aus,
    Zustand an Absender Port 4311. Step2_Display (CYD28, Vorbild
    Pa1_1_encoderTest6_3_1): Drehen = Auswahl/Servo, Taste = schalten.
    Eigenes Testprotokoll, kein xCom (kommt beim Bus-Deploy).
2026-10-21 Situations-Dokumentation: Kot-Fall Track 384530 ausfuehrlich beschrieben
2026-10-21 Situations-Dokumentation: frischer Kot 21.10. vermutlich vom Fuchs (Track 81680)
    Neuer Ordner mit Track-Auswertung, Alternativen seit 16.10. und KIVision-Bild;
    Kot-Fall der Katze um neue Track-Nummer 81320 ergaenzt.
2026-10-22 KIVision: Stabilitaets-Fixes aus der Ultrareview (10 Befunde) + Lebenszeichen
    - Erkennungs-Thread: eigenes Stopp-Ereignis je Lauf + Schloss, Coral-
    Durchlauf unter infer_lock -> nie zwei Threads auf dem Interpreter
    - Radar-Bild "KI aus" auch, wenn die KI zwar laeuft, aber seit 10 s
    nichts liefert (Modell/Coral weg)
    - Hintergrund-Schleifen (_vps/_vision/_eyes/_zone) per _forever
    ueberwacht: Ausnahme -> Traceback ins Journal, Neustart nach 5 s;
    HB-/Rejoin-Schleife des Busknotens faengt Fehler ab; unplausible
    Weltpunkte werden nicht mehr gepackt (struct.error)
    - Augensuche ohne Zone durchsucht das ganze Bild statt gar nichts
    - Kamera-Modell: Spiegel-Vorzeichen lokal statt am Objekt (T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
2026-10-22 Dome: Front-Licht AUS/EIN/AUTO (beide Pixel weiss, volle Helligkeit)
    - xComDef6_3.h: stgLight (11) + stgLightAuto (12), STG_COUNT 13
    - Radar6_3_0 (nur DomeDevice, hasFrontLight): serviceLight() schaltet
    beide Pixel weiss mit Helligkeit 255; AUTO = 60 s nach EIGENER
    catObserved. Statusanzeigen haben Vorrang: erst nach dem Boot, nur
    wenn HB- UND Cat-Anzeige aus sind, nicht im Kalibrierfenster und 6 s
    nach Kalibrier-/Pose-Farben (lightYield). Beim Ausschalten zurueck
    auf BRIGHTNESS. Schalterstellung persistiert (NVS), Default AUS.
    - VPS-Steuerung: Dreifach-Schalter generisch (IR-Scheinwerfer + Front-Licht)
    - Bedienungs-Display: Beschriftungen fuer die neuen Bits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
2026-10-23 KIVision: WLAN-Waechter + Multicast-Neuanmeldung (Bus-Empfang schlief ein)
    - xcom.rejoin tritt jetzt aus und wieder bei, damit der Kernel einen frischen
    IGMP-Report schickt; vorher tat das ADD auf die bestehende Mitgliedschaft
    nichts und das WLAN vergass den Pi (rx ab 22.10. 22:40 fast null, keine
    Radar-Bilder mehr)
    - kivision-netwatch: pingt den Router, stoesst nach 3 min NM neu an (NM gab
    nach ASSOC-REJECT mit no-secrets fuer immer auf), nach 15 min Neustart
    - auf dem Pi zusaetzlich force_igmp_version=2 (sysctl.d), wie die ESP32
2026-10-23 gitattributes: Shell-Skripte und systemd-Units immer mit LF (gehen per scp auf den Pi)
2026-10-23 Manager: catObserved/catDetected zusaetzlich per Unicast an KIVision (Notbehelf)
    Der Pi empfaengt im WLAN kaum Multicast (Onboard-WLAN erreicht den AP nur
    knapp, Gruppen-Pakete ohne Wiederholung). Der Manager reicht die Ziel-Meldungen
    unveraendert (Original-Absender/-Zeitstempel) an device[KIVision].IP weiter.
    Rein additiv - ohne Manager bleibt der Multicast-Weg. Der Pi verwirft doppelte
    Kopien jetzt auch bei catObserved (Schluessel Absender+Code).
2026-10-24 KIVision netwatch: ARP-Anfrage an Manager + Ankuendigung alle 30 s
    Der Pi hoert im WLAN keine Broadcasts/Multicasts (auch keine ARP-Anfragen).
    Lief der ARP-Eintrag im Manager nach ruhigen 5 min ab, ging die
    Unicast-Weiterleitung von catObserved ins Leere (24.10. 8:59 kein Radar-Bild).
    Jetzt fragt der Pi selbst beim Manager an und kuendigt sich allen an.
    Braucht iputils-arping (auf dem Pi installiert).
2026-10-24 KIVision: visionObserved fuer Bewegung abgeschaltet (Schalter vision_motion)
    Auf dem VPS fast nur Wind-Punkte, dazu ~2 Meldungen/s auf dem Bus.
    Bewegungserkennung, Bewegungs-Bilder und KI-Ausschnitte laufen weiter,
    Augen-Meldungen (sensor=1) bleiben. Wieder an: web_config.json
    "vision_motion": true.
2026-10-24 PowerActor2 Umbau Schritt 3: Servo voller Bereich +/-180 Grad + Schnellfahrt links/rechts
    - Step3_ServoFull: Positionen 0..4095 statt 760..3400, Servo-EEPROM-
    Winkelgrenzen bei Bedarf auf 0..4095, Beschleunigung 0; neues Kommando
    S2_FAST faehrt mit Geschwindigkeit 0 (= Maximum); Relais nur sicher AUS
    - Step3_Display: Relais-Zeilen ersetzt durch Knoepfe << LINKS / RECHTS >>
    - eigenes Magic 0x53, damit ein altes Step2-Display nichts ausloest
2026-10-24 PowerActor2 Schritt 3: Touch-Knoepfe LINKS / MITTE / RECHTS am Display
    - Schnellfahrt jetzt per Touch (XPT2046 via LGFX_AUTODETECT), neu Knopf
    MITTE (2048); Drehknopf faehrt den Servo direkt, Auswahl/Taste entfallen
    - PA2 meldet Schnellfahrt in die Mitte als 'Mitte' statt 'links'
2026-10-24 PowerActor2 Umbau Schritt 4: LP40B-Lidar + Laser unter 0,5 m, Display ohne Flackern
    - Step4_LidarLaser: LP40B/LPB40B an Serial2 (RX16/TX17, 115200) ohne
    Bibliothek nach SEN0586-Protokoll (8-Byte-Rahmen, CRC8 0x31), Dauermessung
    auf Startbefehl, Neueinrichtung wenn 1 s stumm; Laser GPIO25 EIN bei
    gueltiger Messung < 500 mm; Servo wie Schritt 3; Magic 0x54
    - Step4_Display: Lidar-Distanz gross, Fehlertext, Laser-Anzeige; fester Teil
    einmal gezeichnet, Werte nur bei Aenderung ueberschrieben (kein fillScreen
    mehr -> kein Flackern)
2026-10-25 Personen-Feuersperre: KIVision sendet fireInhibit + VPS markiert Tracks als Person
    - xComDef: neuer msgCode fireInhibit=17 + fireInhibitPayload (ablaufende Sperre
    fuer alle Aktoren, readyToFire/Button bleibt unberuehrt)
    - KIVision: PersonGuard - person >= 70 % in 2 der letzten 3 KI-Runden ->
    alle 2 s fireInhibit (60 s), Sichtungen gebuendelt per POST /person zum VPS;
    Schalter unter web_config "person"; Anzeige im Bus-Status
    - VPS: /person (nur im Speicher), Analysierer setzt "person" direkt in
    track_marks fuer passende unbewertete Tracks (Zeit +-5 s, Ort 2,5 m),
    jeden nur einmal; Knopf "loeschen" fuer gesetzte Bewertungen
    - PA1_1: feuert nicht, solange die Sperre laeuft (nur kompil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
2026-10-25 KIVision: Personen-Sichtungen und Feuersperren ins Journal (Nacht-Verhalten beobachten)
2026-10-25 PowerActor2 Umbau Schritt 5: Relais (Ventil/26/23/Spot 32) schaltbar + IR-Positionskamera SEN0158 mit 4 Punkten am Display
2026-10-25 PowerActor2 Schema: Umbau-Stand (Servo ueber 1k, Spot GPIO32, IR-Kamera SEN0158 an I2C 21/22, Relais 1-4)
2026-10-25 PowerActor2 Schema: Relais aktiv HIGH bestaetigt, Belegung 26=LD06-Speisung 23=Radar-Speisung, LP40B im Betrieb Einzelmessung
2026-10-25 PowerActor2 Step5: Relais-Knoepfe LD06 / Radar statt R26 / R23
2026-10-26 GesamtKonzept: Integration PowerActor2/LD06/Compact Dome als mobiler Aufbau, KIVision-Stand Phase 5
2026-10-26 GesamtKonzept PA2: Sensoren liegen in 0-Grad-Richtung vor der Drehachse
2026-10-26 PowerActor2 Step6: Winkel-Kalibrierung LD06/Compact Dome gegen Servo+LP40B
    Step6_Calib (PA2): Servo-Sweep auf dem Geraet, LP40B-Messungen mit Servo-Position
    an den PC, Relais LD06/Radar per PC, Ventil+Laser gesperrt.
    Step6_CalibTool (PC, Python+Web): Hintergrund, automatische Standpunkte mit
    Feinschwenk in beide Richtungen, Fit Drehung/Spiegelung je Sensor, Rohdaten-Log,
    Feuersperre waehrend des Laufs.
    LD06_6_3_0: Rohdaten-Stream auf Anfrage (UDP 4320/4321), dabei keine catObserved.
2026-10-27 KIVision Augen: farbige Lichter verwerfen (gruene Maeher-LED im Dock)
    Die blinkende gruene Lade-LED des Maehers (Welt 8,0/2,1 m) kam an der
    Waermekarte vorbei und erzeugte am 27.10. ueber 200 Augen-Meldungen.
    IR-Augen leuchten farblos (Kanalspreizung ueber Grund 1,00..1,07),
    die LED klar gruen (1,4..2,0). Offline: 5/5 echte Augen bleiben,
    0 Meldungen aus 40 Dock-Rohbildern.
2026-10-27 SpinOff/BurglerProtect: Konzept besucherabhaengiges Wohnzimmerlicht (Hue)
    Anforderung des Users uebernommen und kommentiert: Veranda liefert heute
    0 Ereignisse (Radar-Filterkarte), Besucher brauchen eigenen msgCode statt
    catObserved (PA1_1 feuert ohne Absenderfilter), neues Busgeraet Nr. 22,
    Plausibilisierung aus gemessener Ereignisrate, Hue lokal, Vorgehen.
2026-10-27 BurglerProtect-Konzept: Sensor prueft nur Quadrant, Polygon im Steuergeraet (Lidar-C1 Flash 94 %)
2026-10-27 BurglerProtect-Konzept: Vorfilter gilt fuer Radar und Lidar
2026-10-27 BurglerProtect-Konzept: Quelle ist Dome-C1 (nicht Lidar-C1), Radar-Flash 96 %
2026-10-27 BurglerProtect Schritt 1: visitorObserved (Dome-C1) + VPS-Tab Besucher
    - xComDef: msgCode visitorObserved=18 (bewusst kein catObserved)
    - Radar6_3_0: Ziele ausserhalb der Filterkarte im Quadranten X>0/Y<0 als
    visitorObserved melden; Polygon prueft der Empfaenger (Flash 98 %)
    - Manager: visitorObserved mit "vis":1 an den VPS
    - VPS: Tabelle visitor_events (getrennt von events, 30 Tage), Regel in
    visitor.py (retriggerbar), Tab Besucher mit Karte, Spurenliste,
    Polygon-Editor, Parametern und eigenem Loeschknopf
    Geflasht: Dome-C1 .60, Manager .180; VPS deployt.
2026-10-29 BurglerProtect Schritt 2: Steuergeraet Besucherlicht (M5 AtomS3, Geraet 22)
    - xComDef: Geraet 22 Besucherlicht (LightControl, .188), deviceCount 23,
    stgArmed (13) = scharf, persistiert, VPS setzt absolut
    - Firmware SpinOff/BurglerProtect/Firmware/Besucherlicht6_3_0: Regel wie
    visitor.py, Hue lokal (Zuhause-Gruppen -> kein Licht, Licht gehoert mir
    nur solange unveraendert), aktive Zeit Sonnenuntergang..end_min,
    Konfiguration per GET /visitor_device.cfg mit LittleFS-Cache, Display
    - VPS: Hue-Gruppen, aktive Zeit, Helligkeit/Farbtemperatur im Tab Besucher,
    Scharf/Aus-Knoepfe + Geraetemeldungen, Auswertung markiert Tagesbesuche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
2026-10-29 VPS: Geraeteliste aus xComDef wieder parsen (device[deviceCount]) + Besucherlicht im Ersatz
    Der Regex erwartete eine Zahl in device[...], seit deviceCount griff immer
    die eingebaute Ersatzliste.
2026-10-29 Besucherlicht: USB-Serial ohne Sendewartezeit - OTA hing am PC ohne Monitor
    ESP32-S3 HW-CDC blockiert jede Ausgabe bei vollem Puffer, wenn am PC
    niemand mitliest; die OTA-Fortschrittsausgabe je Paket liess den Upload
    nach ~60 kB stehen. Serial.setTxTimeoutMs(0) verwirft stattdessen.
2026-10-29 Besucherlicht: Hue nur ein/aus (Helligkeit/Farbe bleiben), Scharf volle Helligkeit, WLAN-Suche blau blinkend
    Helligkeit/Farbtemperatur auch aus VPS-Parametern und Tab entfernt.
2026-10-29 Compact Dome: Totzone 500 mm wie die anderen Radare (war 1000)
2026-10-29 LD06 neu wie LidarC1: Hintergrund, VPS-Pose, No-Shot, Pixelring zeigt Zielrichtung
    - Winkelfenster/fireDuration raus, HB neu, CRC-8 der LD06-Pakete geprueft
    - Drehturm (< 40 cm) und schwache Echos ausgeblendet
    - nach dem Boot nur Pose, dann Ruhe; Zielerkennung per stgActive, Kalibrieren = neu
    - keine alte NVS-Pose (Traeger wird umgestellt), ohne Pose alle 5 min neu
    - Ring: Pixel 0 vom Turm weg, rot = gemeldet, orange = ausserhalb No-Shot
    - Rohdaten-Stream fuer Step6_CalibTool bleibt
2026-10-29 PowerActor2 integriert: Zielen in Welt-Koordinaten, Reichweite 6,5 m, Veranda-Regel
    - PA2i6_3_0 neu auf Basis Step5 (FeetechBus-Servo, LP40B ohne Lib, IR-Kamera)
    - Ausloeser catDetected, danach 5 s Verfolgung mit catObserved, fireInhibit
    - Schuss nur mit Pose, in No-Shot-Karte, 0,5..6,5 m und Veranda-Regel
    (auf der Veranda nur durch die Oeffnung 3..8 m, sonst nie darueber, Rand 30 cm)
    - Laser und Ventil gleich, Einstellung Wasser (AUS = Trockentest)
    - Speisung LD06 (stgLidarMotor) und Compact Dome (stgRadarPower) per Einstellung
    - LP40B misst beim Schuss mit (catHit.res), noch keine Bedingung
    - xComDef: .181 heisst jetzt PowerActor2, stgRadarPower 14, stgWater 15 (16 Bit voll)
    Co-Authored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
2026-10-29 PowerActor2 folgt dem Track des Cat Identifiers (catTracked), Laser-Folgemodus
    - neuer msgCode catTracked (19): CatIdent fuehrt bestaetigte Tracks ~5/s nach
    - PA2: Verfolgung solange der Track lebt (2,5 s ohne Update = verloren), wartet
    bis in Reichweite, weitere Schuesse nach 3 s; Laser und Ventil immer gleich
    - stgWater -> stgLaserFollow (15): Laser allein folgt jedem catObserved (Test)
    - cmdArmFire info 1/2 = scharf/sichern absolut (0 = umschalten wie bisher)
    - Neustart-Grund in der Startmeldung; Diagnose-Build -DNO_VALVE_TEST
    (Ventil schaltet nicht): mit Ventil Panic 1-3 s nach dem Schuss, ohne nicht
2026-10-30 Katzenmodell: Randlogik nur aus Sensoren, die allein bestaetigen koennen (Radare)
    Die 12-m-Kreise von LidarC1 und LD6 (LD6-Pose aus dem Buero) reichten weit
    ueber den Garten - jede Katze galt als 'mitten in der Abdeckung aufgetaucht'
    (-12) und wurde nur bei 'sitzt stabil' bestaetigt. An den markierten Tracks
    (Katze+Fuchs) Oktober 51/122 -> 97/122 erkannt, Fehlalarme 4 -> 6 von 64.
    VPS (cov_senders, Coverage-Export) und CatIdentifier (ctCovSensor) gleich;
    MODEL_VERSION in der Analyse-Signatur -> Tracks werden neu bewertet.
2026-10-30 Katzenmodell: Randlogik nur aus vertrauenswuerdigen Sensoren + 1-m-Nahzone
    Rand bei der Track-Geburt nur noch aus Radaren, die online (HB, VPS: hb_minute,
    Geraet: letzte Busmeldung < 60 s) UND eingemessen (gelerntes/gesetztes Polygon)
    sind. Online, aber nicht eingemessene Sensoren (z.B. mobiler Compact Dome) =
    neutrale Zone, Offline-Sensoren zaehlen nicht. Geburt <= near_sensor_mm (1000)
    vor einem Sensor = Nahfeld -> 'mitten drin' statt Eintritt. Kein Sektor-
    Fallback mehr im CatIdentifier (Datenblatt-Sektoren sind nicht eingemessen).
    An den markierten Tracks: Okt Katzen 97->102/122, Fehlalarme 7->6/64;
    Juli 46->52/58, Fehlalarme 17->7.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
2026-10-30 PowerActor2 bestimmt die Traegerpose beim Start selbst (LP40B-Rundumschwenk + LD06)
    PA2i6_3_0/poseProc.ino: nach dem Boot (und auf Kommando Kalibrieren) Turm
    einmal ganz herum, LP40B misst dauernd mit Servo-Position; dazu 5 s LD06-
    Rohscan (LD06SCAN), per Kalibrierung (177,52 Grad, 135 mm) ins Traeger-System.
    Beides an den VPS-Localizer /localize_carrier (eigene Task, HB laeuft weiter).
    Pose global aus dem LP40B (sieht den Rasenrand bis ~16 m wie der Pan-Tilt-Kopf
    der Rasenkarte); LD06 prueft den Schwenk (beide muessen im Nahbereich dieselben
    Konturen sehen). Annahme nur: Eindeutigkeit <= 0,80, LP40B >= 0,45, LD06 >= 0,60.
    Keine gespeicherte Pose mehr nach dem Boot; ohne Pose kein Schuss, ne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
2026-10-30 PowerActor2 Traegerpose: auf LD06-Rohdaten warten (Kaltstart)
    Beim Einschalten startet der LD06 mit dem Traeger und steckt gerade in seiner
    eigenen Lokalisierung (HTTP blockiert), wenn der Traeger seinen Scan will ->
    0 Punkte, Pose abgelehnt. Jetzt bis 30 s nachfragen und 5 s ab dem ersten
    Paket sammeln.
2026-10-30 Manuelle Pose nur vollstaendig uebernehmen; PA2 wiederholt LD06-Uebergabe laenger
    xComProc: cmdManualPoseMirrorCommit uebernimmt nur, wenn X, Y und Heading seit
    der letzten Uebernahme angekommen sind. Mit nur einem Unicast-Puffer gingen
    beim blockierten LD06 (eigene VPS-Lokalisierung) X/Y/Heading verloren und er
    uebernahm 0/0/0 als gueltige Pose (Kaltstart 2026-10-30 13:36).
    PA2: Uebergabe an den LD06 bis 10x im Abstand von 5 s statt 3x 3 s.
    Geflasht: PA2 (.181), LD06 (.29). Andere Geraete bekommen den Schutz beim
    naechsten Flashen.
2026-10-30 PowerActor2: automatische Traegerpose abschaltbar (stgAutoCalib)
    Ohne Pose sucht der PA2 alle 5 min neu und dreht dabei den Turm - drinnen
    stoert das. Einstellung 'Auto-Kalibrierung' (Bit 3, wie beim Radar) schaltet
    die automatische Suche ab, 'Kalibrieren' startet sie weiterhin von Hand.
    Persistiert; nach diesem Update zunaechst AUS (gespeicherter Stand ohne Bit).
2026-10-30 PowerActor2: Traegerpose auch an den Compact Dome (und nach manueller Pose)
    - Uebergabe generisch fuer LD06 + Compact Dome (18,5 cm vor der Achse, 0 Grad,
    Platzhalter aus calibration.json), gleiche Kontrolle/Wiederholung wie beim LD06
    - ohne Traegerpose (Suche, Start) wird die NVS-Pose des Compact Dome geloescht
    - Geraet neu gestartet/wieder gespeist (30 s ohne HB) -> Pose neu uebergeben/loeschen
    - manuelle VPS-Pose am Traeger wird ebenfalls weitergegeben
    Compact Dome selbst unveraendert (versteht cmdManualPose*/cmdClearPose schon).
2026-10-30 LD06-Ring zeigt in der Startphase den Zustand des PowerActor2-Traegers
    Neues Kommando cmdCarrierState (31) PA2 -> LD06 (Unicast): startet, Turm-Schwenk
    (Punkt in LP40B-Richtung), LD06-Scan, VPS, Pose+Uebergabe (vorderes Pixel bis der
    Compact Dome bestaetigt), Uebergabe gescheitert, roter Countdown bis zum naechsten
    Versuch, wartet auf Kalibrieren; danach csDone -> Ring wieder LD06. 30 s ohne
    Meldung = LD06-eigene Anzeige. Helligkeit unveraendert, kein Fehlergrund am Ring.
2026-10-30 Katzenmodell: Augen-Bestaetigung durch die KIVision-Augensuche
    Leuchtende Augen (visionObserved sensor=1) hoechstens 1,5 m und 5 s nach dem
    letzten Punkt einer laufenden Spur bestaetigen sie sofort als Katze (score_eyes
    100, auch ohne kohaerente Bewegung). Augen allein bewirken nichts, die
    Kamera-Bewegungsspuren bleiben ueber cam_feed=0 aus. Gleich im VPS-Modell
    (Referenz, auch fuer geklebte Tracks) und im Cat Identifier (ctEyes).
    Nachgerechnet 19.-30.10.: keine Aenderung an den 210 Bewertungen, eine
    zusaetzliche Bestaetigung (25.10. 17:56, Fortsetzung einer bestaetigten Katze).
2026-10-30 Button: Scharf-Schalter fuer alle Aktoren (cmdArmFire absolut)
    Ein Druck sichert alle Aktoren, wenn irgendeiner scharf ist, sonst schaltet
    er alle scharf; Wiederholung bis die HBs bestaetigen. Anzeige rot/gruen/
    orange/gelb (Personensperre)/weiss (kein Aktor)/magenta (Fehler).
    Eigener HB + OTA. PA1_1 versteht cmdArmFire jetzt ebenfalls absolut.
2026-10-30 Button: WLAN-Suche blinkt blau statt rot (rot = scharf)
    xComProc: Blinkfarbe der WLAN-Suche per WIFI_BLINK_COLOR einstellbar,
    Standard bleibt rot (andere Geraete unveraendert).
2026-10-30 Button: Hinweis Partitionsschema min_spiffs (OTA)
2026-10-30 Katzenmodell: Fortsetzung erbt die Bestaetigung (Luecke Dome <-> Dome-C1)
    Beginnt kurz nach dem Ende eines bestaetigten Tracks ein neuer Track
    (<= 15 s, <= 5 m, Luecken-Tempo 150..3000 mm/s, Richtung <= 60 Grad,
    >= 2 Punkte), gilt er ebenfalls als Katze. CatIdent sendet dafuer nur
    catTracked (dieselbe Katze, kein neues catDetected), merkt sich dazu die
    Austritte bestaetigter Katzen ueber die Track-Freigabe hinaus. VPS-
    Analysierer gibt bestaetigte Tracks vor dem Haeppchen als Vorgaenger mit.
    Replay 19.-30.10.: Katzen 111 -> 133 von 148, Nicht-Katzen unveraendert.
2026-10-31 Radar: Compact Dome verwirft Ziele ausserhalb +/-45 Grad (seitliche Geister)
    HLK-2450 meldete Personen an der Verandakante (92..105 Grad, richtige
    Entfernung) bei ~55 Grad im Rasen -> Fehlschuss 31.10. 09:23.
2026-10-31 xComDef zentral: Radar-Winkelgrenze aus covLeft/RightDeg, Aktor-Reichweite actRangeMm
    Radar6_3_0 verwirft Ziele ausserhalb device[ID].covLeftDeg..covRightDeg (statt
    hwDef-Define nur beim Compact Dome). Neues Feld actRangeMm (PA2 6500), PA2
    WATER_RANGE_MM liest es; VPS parst es als actRange.
2026-10-31 xComDef: Aktor-Mindestentfernung actMinMm (PA2 500 mm -> NEAR_MM)
2026-10-31 Aktor-Kette in der DB: catDetected, fireInhibit, catHit (actor_log)
    Manager reicht die drei Meldungen als 'acts' an /ingest weiter; VPS legt sie
    in der neuen Tabelle actor_log ab (Feuersperren-Verlaengerungen zu einer
    Zeile zusammengefasst), GET /actlog. Analyse-Tab: Raute/Dreieck/Band in der
    Zeitleiste, Chips + Zeilen am Track. Bestehende Tabellen unveraendert.
2026-11-02 Aktor-Auswertung: eingefrorene Radarziele, Bedenkzeit, Schussfotos
    - Radar6_3_0: Ziel, das laenger als 500 ms bitgenau gleich bleibt, wird nicht
    mehr gemeldet (HLK liefert bis ~36 s den letzten Punkt weiter; PA2 hat
    01./02.11. 16x darauf geschossen)
    - PA2: gleicher Zielpunkt > 1 s zaehlt nicht als Nachfuehrung (Track laeuft ab);
    2,5 s Bedenkzeit vor dem 1. Schuss, solange KIVision lebt (Person 02.11. 09:18
    wurde 1 s vor der Sperre beschossen); catHit schon beim Feuerbeginn mit dem
    gezielten Punkt, zusaetzlich Unicast an KIVision
    - KIVision: Personensperre schon nach einer Runde ab 90 % (person.fast);
    catHit -> 2 Schussfotos (kivshot) an den VPS
    - VPS: Schussfotos beschriftet und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
2026-11-02 KIVision lernt die VPS-Adresse vom Manager (vpsRequest/vpsReport)
    - xComDef6_3.h: msgCode 20 vpsRequest, 21 vpsReport + vpsPayload
    - Manager: beantwortet vpsRequest mit ipVPS aus Credentials.h (Unicast)
    - KIVision: fragt beim Start und dann alle 60 s (bekannt: alle 6 h) nach,
    speichert die Adresse in ~/kivision/vps.json; Uebersteuern per KIVISION_VPS.
    Die VPS-IP steht damit nicht mehr im Repo.
2026-11-04 Konzept Next-Gen-Aktor: Tank mit Sprueh-Kit, Pose per Turm-Lidar
2026-11-04 Konzept Next-Gen-Aktor: Betriebsarten Initialisierung und Normalbetrieb
2026-11-05 Konzept Next-Gen-Aktor: Basis und Actor, RFM95 FSK statt CC1101
2026-11-05 Konzept Next-Gen-Aktor: Basis als Radar mit RFM95 auf XIAO ESP32-S3
2026-11-05 Konzept Next-Gen-Aktor: Bestueckung Actor, Lidar C1 als moegliche Variante
2026-11-05 Konzept Next-Gen-Aktor: Option Neigungsausgleich mit zweitem Servo
2026-11-05 Konzept Next-Gen-Aktor: Lastschalter mit 2SJ175 auf der Plusleitung
2026-11-05 Konzept Next-Gen-Aktor: ESP32-S3 als Modul auf eigener Traegerplatine
2026-11-05 Konzept Next-Gen-Aktor: Fuellstand mit Schwimmerschalter und Schusszaehler
2026-11-08 VPS: Incident-Tracer Stufe 1 - Kot-Verdacht mit Handy-Nachricht
    Prueft die fertigen Tracks fortlaufend auf das Sitz-Profil der beiden
    Kotfaelle (81320, 83472): Ankunft >= 0,5 m, Sitzen >= 20 s im 0,6-m-Kreis
    mit wenig Streuung, Abgang >= 1 m. Tracks am selben Ort mit kurzer Pause
    werden zusammengenommen. Maeherzeit, Maeher-Labels, Person/Maeher/Sturm/
    Vogel-Bewertungen und die Radar-Haltestelle hinten sind ausgeblendet.
    - incidents.py: Profil, Ketten, haeppchenweiser Scan (kein Laden aller Tracks)
    - Tabelle incidents mit Rueckmeldung (gefunden/nichts/nicht pruefbar, Fundort)
    - GET /incidents, POST /incident_fb, /incident_cfg, /incident_push_test
    - PushingBox-Szenario CatAssumed (PUSHINGBOX_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
2026-11-08 Zielmodell Sitzende Katze: Stufe 1-3 (VPS-Nachbau, Tab, CatIdent im Schattenbetrieb)
    Zweites, unabhaengiges Modell neben dem Normalmodell: meldet nur Tiere, die
    sich hinsetzen - ausserhalb des Katzenkorridors nach 20 s, im Korridor nach
    90 s. Sitzplaetze statt Tracks (Luecken bis 25 s), Schwerpunkt/Streuung
    gleitend, Ankunft gegen den aktuellen Schwerpunkt, Mindeststreuung gegen
    eingefrorene Radarziele, Hoechstrate 7/s, nur HLK-Radare.
    - VPS/dashboard/sitmodel.py: Modell + Korridor-Lernen aus Katzen-Tracks
    - dashboard: fortlaufender Nachbau (sit_events), /sit, /sit_cfg,
    /corridor_learn, /corridor_set, Geraete-Routen /sitparams.csv und
    /sit_corridor.csv, actor_log kind 'tgt'
    - Tab "Zielm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
2026-11-08 Zielmodell Stufe 4: PA2-Schalter Zielquelle Normal/Beide/Ziel
    - PA2: targetDetected/targetTracked auswerten, Schalter aus den Bits 6/7
    (beim PA2 sonst ungenutzt, persistiert, Default Normal). Laufende
    Verfolgung wechselt die Quelle nicht; Eingefroren-Pruefung nur fuer das
    Normalmodell. Statuszeile nennt die Zielquelle.
    - CatIdent: sitTick fuehrt ausgeloeste Sitzplaetze bis 6 s nach der letzten
    Radarmeldung nach (PA2 verliert einen Track nach 2,5 s).
    - Steuerungs-Tab: Dreifach-Schalter "Zielquelle" nur fuer PA2 (#4).
2026-11-08 Tab Zielmodell: bewertete Tracks statt aller catDetected, Abgleich Geraet/VPS
    - Karte zeigt die von Hand als Katze (und zuschaltbar Fuchs) bewerteten
    Tracks des Zeitraums; catDetected nur, wenn es zu einem Katzen-Track gehoert
    (ungefiltert waren es ueberall Personen/Maeher, kein Korridor erkennbar)
    - Abgleich echtes targetDetected (CatIdent) <-> VPS-Nachbau (+-15 s, 1,5 m):
    Liste "Geraet ok/fehlt", Info "beide / nur VPS / nur Geraet", Tagesspalte "beide"
2026-11-08 PowerActor2: Pose-Uebergabe erst nach 90 s ohne HB, vorher leise pruefen
    Bisher wertete der PA2 30 s ohne HB von LD06/Compact Dome als Neustart und
    uebergab die Pose neu - im WLAN gingen dafuer genug HBs verloren, der LD06-Ring
    blinkte ab und zu gruen ("LD06-Pose uebergeben" 7x in 40 min). Jetzt 90 s, und
    dann zuerst per poseRequest nachsehen: hat er die Pose noch, bleibt es still
    (keine Meldung, keine Anzeige), sonst normale Uebergabe mit Anzeige.
2026-11-14 Maeher-Erkennung: Dock per Kamera, Katzenerkennung pausiert nur beim Maehen
    - KIVision (kivision_mower.py): Coral erkennt den Maeher als "car" im Dock-Kasten
    -> im Dock (stabil 60 s) / Dock leer (20 s) / keine Aussage (Nacht, Daemmerung);
    neue Busmeldung mowerState=24 alle 5 s + POST /mower an den VPS
    - CatIdent (mowGuard.ino): "maeht" nur mit positivem Grund - Abfahrt aus dem Dock
    (3 min) oder >= 25 m Weg aus langen Spuren in 2 min / Kamera sieht ihn fahren
    (haelt 10 min); nie im Dock, nachts oder ausserhalb 07-21 Uhr. Dann keine
    catDetected/catTracked/targetDetected (Modell-Parameter mow_pause=1), Modell
    wird weiter gefuettert
    - VPS: mow_*-Parameter (nicht in der Modell-Signatu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
2026-11-14 EPF1: Drehturm-Geraet vorbereitet (Pinbelegung, Config mit TILT_SERVO_ST/SC, Hardware-Test, Schema)
    ESP32-C3 Super Mini in LaserMarker-Bauart, Servo-Bus TX20 ueber 1k + RX4,
    Pan ST3020 ID 2, Tilt ST (EPF1) bzw. SC15 (EPF1b) ID 4. Noch nicht
    angeschlossen; Bus-ID/IP/Aufgabe offen (README).
